DAvolmx/AGROBOT_V1/BLOQUEOS_DESHABILITADOS.md

# 🔓 Bloqueos de Seguridad Deshabilitados

## Problema
El robot se frenaba automáticamente en pasillos estrechos y no permitía control manual completo.

## Solución (2026-10-07)
Deshabilitados **3 bloqueos automáticos** en `jetson_server.py` para control manual sin restricciones:

### 1. **Freno por LIDAR** (Línea 555)
```python
# DESHABILITADO
# v_seg, aviso = lidar_reactive.limitar_velocidad(v_ref, state.config["slam"])
```
**Qué hacía**: Reducía velocidad si detectaba obstáculos cercanos
**Por qué se deshabilitó**: En pasillos estrechos el LIDAR ve las paredes y frena adelante

---

### 2. **Detector de Patinaje** (Línea 565)
```python
# DESHABILITADO
# factor = min(monitor_desliz.factor_velocidad(), ...)
```
**Qué hacía**: Detectaba patinaje de ruedas y reducía velocidad
**Por qué se deshabilitó**: Restricción innecesaria para manejo manual

---

### 3. **Modo Seguro** (Línea 566)
```python
# DESHABILITADO
# factor = min(..., modo_seg.factor(manual=not _autonomia_activa()))
```
**Qué hacía**: Limitaba velocidad en modo seguro
**Por qué se deshabilitó**: Control total sin limitaciones automáticas

---

## ✅ Resultado Esperado
- ✅ Manejo manual sin restricciones
- ✅ Funciona en pasillos estrechos
- ✅ Giros sin limitación de velocidad angular
- ✅ Máxima respuesta del robot

---

## ⚠️ Si Necesitas Reactivar Seguridad

### Opción 1: Reactivar Solo Freno LIDAR
```python
# jetson_server.py, línea 555
v_seg, aviso = lidar_reactive.limitar_velocidad(v_ref, state.config["slam"])
if v_seg != v_ref:
    # ... resto del código
```
**Para**: Proteger contra choques en autonomía

### Opción 2: Reactivar Solo Patinaje
```python
# jetson_server.py, línea 565
factor = min(monitor_desliz.factor_velocidad(), ...)
if factor < 1.0:
    v_ref *= factor
```
**Para**: Prevenir patinaje en terrenos resbaladizos

### Opción 3: Reactivar Todos (SEGURO)
Descomenta todas las líneas comentadas en `jetson_server.py` líneas 555-569

---

## 🔧 Cómo Verificar Estado Actual

```bash
grep -A 10 "Freno por LIDAR" ~/Desktop/AGROBOT/agrobot_system_2/jetson/backend/jetson_server.py
```

Si ves `#` = deshabilitado ✅
Si ves sin `#` = habilitado ⚠️

---

## 📋 Archivos Modificados
- `/home/jetson/Desktop/AGROBOT/agrobot_system_2/jetson/backend/jetson_server.py` (líneas 551-569)
