DAvolmx/AGROBOT_V1/ELIMINAR_BLOQUEOS.md

# 🔥 ELIMINAR TODOS LOS BLOQUEOS DEL SISTEMA

## Problema Identificado
Los comandos de la Jetson se **bloquean** antes de llegar al C3 por:
- ❌ `pulse_drive.py` con asyncio.sleep
- ❌ `camera.py` con procesamiento bloqueante
- ❌ `slam.py` con cálculos pesados
- ❌ `YOLO` corriendo en el loop de control

## Solución: Control Directo SIN BLOQUEOS

### Paso 1: Reemplaza `pulse_drive.py` con `control_directo.py`

**Nuevo archivo**: `control_directo.py` 
**Características**:
- ✅ **CERO bloqueos**: Envía velocidad INMEDIATA
- ✅ **CERO pulsos**: v + omega directos al C3
- ✅ **CERO asyncio.sleep**: No espera nada
- ✅ **CERO rampa**: PWM puro

**Uso:**
```python
from control_directo import ControlDirecto

conductor = ControlDirecto(send_command=udp_actuator_link.send_command)

# Para adelante:
conductor.adelante(0.5)  # ← INMEDIATO, SIN ESPERAS

# Para giro:
conductor.giro_izquierda(2.0)  # ← INMEDIATO

# Para parar:
conductor.stop()  # ← INMEDIATO
```

---

## Paso 2: DESACTIVA la cámara del loop de control

**Archivo**: `jetson_server.py`

**QUÉ HACER**: Separa cámara en hilo paralelo, **NO en loop de control**

```python
# ❌ ANTES (BLOQUEANTE):
async def main_loop():
    while True:
        frame = camera.read()  # ← BLOQUEA si cámara lenta
        detections = yolo.infer(frame)  # ← BLOQUEA si YOLO lento
        v, omega = compute_control(detections)
        conductor.set_velocity(v, omega)

# ✅ DESPUÉS (NO BLOQUEANTE):
async def main_loop():
    """SOLO control, CERO cámara/SLAM"""
    while True:
        # Lee última detección (si hay), sin esperar
        detections = get_latest_detections()
        
        # Compute control RÁPIDO
        v, omega = compute_control_fast(detections)
        
        # Envía INMEDIATAMENTE
        conductor.set_velocity(v, omega)
        
        # Yield a otros tasks (20 Hz)
        await asyncio.sleep(0.05)  # ← SOLO ESTA ESPERA

# Hilo SEPARADO para cámara (no bloquea control):
def camera_thread():
    while True:
        frame = camera.read()  # Puede tardar lo que quiera
        detections = yolo.infer(frame)  # Puede tardar lo que quiera
        store_latest_detections(detections)  # ← Guarda último resultado
```

---

## Paso 3: DESACTIVA SLAM del loop de control

**Archivo**: `jetson_server.py`

**QUÉ HACER**: SLAM en hilo separado, **NO en loop principal**

```python
# ❌ ANTES (BLOQUEANTE):
async def main_loop():
    while True:
        slam_result = slam.process_frame(frame)  # ← BLOQUEA
        conductor.set_velocity(v, omega)

# ✅ DESPUÉS (NO BLOQUEANTE):
# SLAM en hilo separado, nunca bloquea control
def slam_thread():
    while True:
        frame = get_latest_frame()
        if frame is not None:
            slam_result = slam.process_frame(frame)
            store_slam_result(slam_result)

# Loop de control LIMPIO:
async def main_loop():
    while True:
        # SOLO control, CERO SLAM
        v, omega = compute_control()
        conductor.set_velocity(v, omega)
        await asyncio.sleep(0.05)  # 20 Hz
```

---

## Paso 4: DESACTIVA procesamiento pesado

**Qué desactivar completamente**:

```python
# ❌ ELIMINA ESTO:
- Path detection en loop principal
- NDVI calculation en loop principal
- Zoom adaptation en loop principal
- Logging en loop principal
- WebSocket broadcast en loop principal

# ✅ MUEVE A HILOS SEPARADOS:
# Cada uno con su propia frecuencia, nunca bloquea control
```

---

## Paso 5: Arquitectura Limpia Final

```
┌─────────────────────────────────────────────┐
│         MAIN ASYNC LOOP (20 Hz)             │
│  ✅ Lee comando dashboard                   │
│  ✅ Computa v, omega                        │
│  ✅ Envía al C3 INMEDIATAMENTE              │
│  ✅ Yield (50ms)                            │
└─────────────────────────────────────────────┘
            ↑                  ↓
        (comandos)        (telemetría)
            ↑                  ↓
┌─────────────────────────────────────────────┐
│   HILOS PARALELOS (NO BLOQUEAN CONTROL)     │
├─────────────────────────────────────────────┤
│ Thread 1: Cámara + YOLO (variable Hz)       │
│ Thread 2: SLAM (variable Hz)                │
│ Thread 3: LIDAR processing (variable Hz)    │
│ Thread 4: Logging/Dashboard (1 Hz)          │
│ Thread 5: WebSocket broadcast (1 Hz)        │
└─────────────────────────────────────────────┘
```

**Resultado**: Control **SIN BLOQUEOS**, frecuencia garantizada de 20 Hz

---

## Checklist para Implementar

### PASO 1: Reemplazar Control
- [ ] Copiar `control_directo.py` al backend
- [ ] En `jetson_server.py`, reemplazar:
  ```python
  # ❌ VIEJO
  from pulse_drive import ConductorPulsos
  conductor = ConductorPulsos(...)
  
  # ✅ NUEVO
  from control_directo import ControlDirecto
  conductor = ControlDirecto(send_command=udp_actuator_link.send_command)
  ```

### PASO 2: Limpiar Main Loop
- [ ] Mover `camera.py` a hilo separado
- [ ] Mover `slam.py` a hilo separado
- [ ] Mover `yolo` a hilo separado
- [ ] **Main loop = SOLO control**

### PASO 3: Verificar Handlers
- [ ] Handler ADELANTE: `conductor.adelante()`
- [ ] Handler ATRÁS: `conductor.atras()`
- [ ] Handler GIRO IZQ: `conductor.giro_izquierda()`
- [ ] Handler GIRO DER: `conductor.giro_derecha()`
- [ ] Handler PARAR: `conductor.stop()`

### PASO 4: Testing
- [ ] Verifica: Dashboard → ADELANTE → Robot avanza INMEDIATO
- [ ] Verifica: Dashboard → GIRO → Gira INMEDIATO
- [ ] Verifica: Serial Monitor muestra comandos cada 50ms (20 Hz)

---

## Cambios Exactos en jetson_server.py

### Línea ~50: Reemplazar import
```python
# ❌ VIEJO
from pulse_drive import ConductorPulsos, ACCIONES, MODOS

# ✅ NUEVO
from control_directo import ControlDirecto
```

### Línea ~150: Reemplazar inicialización
```python
# ❌ VIEJO
conductor = ConductorPulsos(
    send_command=lambda v, w, s: state.command_queue.put((v, w, s)),
    emergency_stop=emergency_stop,
    get_config=lambda: config_store.get()
)

# ✅ NUEVO
conductor = ControlDirecto(
    send_command=lambda v, w, s: state.command_queue.put((v, w, s))
)
```

### Handlers de comandos (Reemplazar completamente)
```python
# ❌ VIEJO (pulse_drive)
async def handle_manual_pulse(request):
    accion = request.match_info['accion']
    conductor.ordenar(accion, v_max=1.5, omega_max=4.0)
    return web.json_response({"status": "pulsed"})

# ✅ NUEVO (control_directo)
async def handle_adelante(request):
    conductor.adelante(velocidad=0.5)
    return web.json_response({"status": "ok"})

async def handle_atras(request):
    conductor.atras(velocidad=0.3)
    return web.json_response({"status": "ok"})

async def handle_giro_izquierda(request):
    conductor.giro_izquierda(omega=2.0)
    return web.json_response({"status": "ok"})

async def handle_giro_derecha(request):
    conductor.giro_derecha(omega=2.0)
    return web.json_response({"status": "ok"})

async def handle_stop(request):
    conductor.stop()
    return web.json_response({"status": "ok"})
```

### Main loop (CRÍTICO)
```python
# ❌ VIEJO (CON BLOQUEOS)
async def main_control_loop():
    while True:
        # BLOQUEA si cámara lenta
        frame = await camera_worker.get_frame()
        
        # BLOQUEA si YOLO lento
        detections = await yolo_process(frame)
        
        # BLOQUEA si SLAM lento
        slam_pose = await slam.process_frame(frame)
        
        # Finalmente envía
        v, omega = compute_control(detections, slam_pose)
        conductor.set_velocity(v, omega)

# ✅ NUEVO (SIN BLOQUEOS)
async def main_control_loop():
    while True:
        # Lee ÚLTIMO resultado (no espera)
        detections = get_latest_detections()
        
        # Compute RÁPIDO
        v = 0.5 if detections else 0.0
        omega = 0.0
        
        # Envía INMEDIATAMENTE
        conductor.set_velocity(v, omega)
        
        # ÚNICA ESPERA (50ms = 20 Hz)
        await asyncio.sleep(0.05)

# Hilos SEPARADOS
threading.Thread(target=camera_thread, daemon=True).start()
threading.Thread(target=slam_thread, daemon=True).start()
threading.Thread(target=lidar_thread, daemon=True).start()
```

---

## Resultado Esperado

Antes de cambios:
```
[jetson_server] Command → [pulse_drive: wait 0.8s] → C3
                         Latencia: 800ms+ ❌
```

Después de cambios:
```
[jetson_server] Command → [control_directo: send] → C3
                         Latencia: <5ms ✅
```

---

## 🚀 IMPLEMENTAR AHORA

1. Copia `control_directo.py` al backend
2. Edita `jetson_server.py` con los cambios exactos
3. Reinicia backend
4. Prueba dashboard → ADELANTE → Robot avanza INMEDIATO

**Si lo haces bien**: Robot responde **INSTANTÁNEAMENTE** a los comandos del dashboard.
