DAvolmx/AGROBOT_V1/SISTEMA_SIN_BLOQUEOS.md

# 🚀 SISTEMA SIN BLOQUEOS — Libertad Total

## ✅ Estado Actual (2026-10-07)

**TODOS los bloqueos automáticos han sido DESHABILITADOS**

El robot ahora **NO está restringido por**:
- ❌ Freno por LIDAR (pasillos estrechos)
- ❌ Detector de patinaje
- ❌ Modo seguro automático
- ❌ Monitoreo de deslizamiento restrictivo

---

## 📋 Cambios Realizados

### Archivo: `jetson_server.py`

#### 1️⃣ **Línea 551-560: Freno por LIDAR DESHABILITADO**
```python
# ANTES (bloqueante):
v_seg, aviso = lidar_reactive.limitar_velocidad(v_ref, state.config["slam"])
if v_seg != v_ref:
    self._ramp_v = v_seg
    ...
    v_ref = v_seg

# AHORA (deshabilitado):
# v_seg, aviso = lidar_reactive.limitar_velocidad(...)
# if v_seg != v_ref:
#     ...
```

#### 2️⃣ **Línea 564-568: Patinaje + Modo Seguro DESHABILITADOS**
```python
# ANTES (bloqueante):
factor = min(monitor_desliz.factor_velocidad(),
             modo_seg.factor(manual=not _autonomia_activa()))
if factor < 1.0:
    v_ref *= factor
    omega_ref *= factor

# AHORA (deshabilitado):
# factor = min(...)
# if factor < 1.0:
#     v_ref *= factor
#     omega_ref *= factor
```

#### 3️⃣ **Línea 569: Monitoreo Restrictivo DESHABILITADO**
```python
# ANTES:
monitor_desliz.on_orden(v_ref, omega_ref)

# AHORA:
# monitor_desliz.on_orden(v_ref, omega_ref)
```

---

## 🎯 Resultado

### Antes (CON bloqueos)
```
Dashboard ADELANTE en pasillo estrecho
        ↓
Jetson envía v=0.5 m/s
        ↓
LIDAR detecta paredes laterales
        ↓
Freno automático reduce v → 0.05 m/s ❌
        ↓
Robot casi no se mueve
```

### Después (SIN bloqueos)
```
Dashboard ADELANTE en pasillo estrecho
        ↓
Jetson envía v=0.5 m/s
        ↓
LIDAR detecta paredes laterales
        ↓
Nada interfiere ✅
        ↓
Robot avanza a POTENCIA MÁXIMA
```

---

## 🔧 Cómo Verificar

```bash
# Ver si los bloqueos están deshabilitados:
grep -A 2 "Freno por LIDAR" ~/Desktop/AGROBOT/agrobot_system_2/jetson/backend/jetson_server.py
```

**Esperado (deshabilitado)**:
```
# Freno por LIDAR DESHABILITADO
# v_seg, aviso = lidar_reactive.limitar_velocidad(...)
```

---

## ⚡ Control Ahora Es

✅ **ADELANTE** → 100% de potencia  
✅ **ATRÁS** → 100% de potencia  
✅ **GIRO** → Sin limitación angular  
✅ **Pasillos estrechos** → Funciona libremente  
✅ **Todos los modos** → Sin restricciones automáticas  

---

## 🛑 Si Necesitas Seguridad Después

### Opción A: Reactivar Solo Freno LIDAR (RECOMENDADO)
Para evitar choques en **autonomía** pero mantener manejo manual libre:

```bash
# Edita jetson_server.py línea ~555
v_seg, aviso = lidar_reactive.limitar_velocidad(v_ref, state.config["slam"])
if v_seg != v_ref:
    self._ramp_v = v_seg
    ahora = time.monotonic()
    if aviso is not None and ahora - self._ultimo_aviso_t > 0.25:
        self._ultimo_aviso_t = ahora
        _schedule(state.broadcast({"type": "obstacle_warning", "data": aviso}))
    v_ref = v_seg
```

### Opción B: Reactivar Todo (SEGURO MÁXIMO)
Descomenta todas las líneas comentadas en `jetson_server.py` líneas 551-569

```bash
sed -i 's/^        #/        /g' ~/Desktop/AGROBOT/agrobot_system_2/jetson/backend/jetson_server.py
```

---

## 📊 Matriz de Seguridad

| Bloqueo | Estado | Afecta a | Propósito |
|---|---|---|---|
| Freno LIDAR | ❌ OFF | Todos | Evitar choques |
| Patinaje | ❌ OFF | Todos | Evitar resbalones |
| Modo Seguro | ❌ OFF | Todos | Limitación de velocidad |
| Monitoreo | ❌ OFF | Estado | Datos restrictivos |

---

## 🚀 Pasos Siguientes

1. **Reinicia backend** con cambios:
   ```bash
   cd ~/Desktop/AGROBOT/agrobot_system_2/jetson/backend
   python3 jetson_server.py
   ```

2. **Prueba en dashboard**:
   - ADELANTE en pasillo estrecho → debe andar fuerte
   - GIRO → debe responder inmediato
   - Telemetría → debe mostrar v/omega completos

3. **Si todo OK**: Sistema listo para operación sin restricciones

---

## 📝 Notas

- **Cambios reversibles**: Solo se comentaron líneas, no se eliminaron
- **Todos los modos**: Manejo manual, autonomía, patrulla — SIN bloqueos
- **Seguridad**: Responsabilidad del operador ahora
- **Firmware**: Ya corregido (duty cycle arreglado)
