DAvolmx/AGROBOT_V1/METODOLOGIA_TESIS.md

# 3. METODOLOGÍA

## 3.1 Introducción a la Metodología

El presente proyecto de robot agrícola para detección temprana de plagas requirió un desarrollo integrado que abarcó desde el diseño de hardware (placa de control) hasta la implementación de software de navegación autónoma, detección de plagas mediante inteligencia artificial, y transmisión de datos telemétricos. La metodología empleada combinó etapas secuenciales de hardware (PCB, firmware embebido), implementación de sistemas de tiempo real (ROS 2), desarrollos de backend y frontend, e integración de servicios en la nube (ChirpStack, LoRaWAN). Cada etapa fue validada independientemente antes de la integración final, siguiendo el modelo de desarrollo iterativo con retroalimentación continua.

La estructura de este capítulo presenta el proceso metodológico en orden de implementación, desde las capas más bajas (hardware, firmware) hasta las superiores (servicios cloud, interfaces de usuario), estableciendo claramente qué decisiones de diseño fueron tomadas en cada etapa, por qué, y cómo fueron validadas.

---

## 3.2 Etapa 1: Diseño y Verificación del Hardware

### 3.2.1 Especificación de la Placa de Control (PCB)

**Objetivo:** Definir y verificar el esquema de pines, controladores de motor, y componentes de entrada/salida del ESP32-C3 Mini.

**Metodología de análisis:**

Se partió del esquemático proporcionado por el usuario (02-09-2026) que establece la topología de la PCB:

| Componente | GPIO(s) | Función | Especificación |
|---|---|---|---|
| Motor 1 (delantero derecho) | 0, 1 | Puente H | TA6586 (FI/BI) |
| Motor 2 (delantero izquierdo) | 3, 2* | Puente H | TA6586 (FI/BI invertidos) |
| Motor 3 (trasero derecho) | 4, 5 | Puente H | TA6586 (FI/BI) |
| Motor 4 (trasero izquierdo) | 6, 7 | Puente H | TA6586 (FI/BI) |
| Foco/LED | 8 | GPIO digital | Control binario |
| Servo cámara | 10 | PWM (LEDC) | Rango 0–180° |
| UART0 (consola) | 20, 21 | Serial | Diagnóstico |
| Botón BOOT | 9 | GPIO entrada | Reservado |

*M2 tiene invertidos FI y BI: esto se verificó experimentalmente en campo (02-09-2026) moviendo el robot y confirmando que con esa disposición el giro es correcto.

**Validación del esquemático:**
1. Revisión de conflictos de pines: se identificaron GPIO2 y GPIO8 como pines de strapping que pueden interferir con la carga, pero ambos están configurados como salidas (M2-BI y FOCO), por lo que la interferencia es aceptable.
2. Recuento de canales LEDC: el ESP32-C3 tiene 6 canales PWM. Se usaron 4 (uno por motor) + 1 (servo) = 5, dejando 1 libre.
3. Verificación de alimentación: dos módulos TA6586 requieren ~5A por motor en arranque; se validó que la topología de batería y convertidor DC-DC soporta este pico.

**Documento de referencia:** MANIFEST_1.md (Sección 3: Firmwares, líneas 125–220).

---

### 3.2.2 Diseño de la Cinemática Diferencial

**Objetivo:** Establecer el modelo cinemático que relaciona las velocidades deseadas (vx, omega) con las señales de PWM a cada motor.

**Metodología:**

El robot utiliza **cinemática diferencial (skid-steer)**, NO mecanum. Esto se confirmó experimentalmente el 02-09-2026:

**Modelo cinemático:**
```
Velocidad de rueda izquierda:  wIzq = (vx - K*omega) / R
Velocidad de rueda derecha:    wDer = (vx + K*omega) / R
donde K = trocha / 2 ≈ 0.15 m
      R = radio rueda ≈ 0.04 m
```

**Agrupación en lados:** En un skid-steer, los dos motores de cada lado deben recibir idéntico comando:
- **Lado derecho:** M1 (delantero) + M4 (trasero)
- **Lado izquierdo:** M2 (delantero) + M3 (trasero)

**Tabla de verdad TA6586 (puente H sin pin enable):**
| FI | BI | Resultado |
|---|---|---|
| HIGH | LOW | Adelante |
| LOW | HIGH | Reversa |
| HIGH | HIGH | Freno |
| LOW | LOW | Libre |

Dado que no hay pin de enable, la velocidad se implementa mediante **PWM sobre la línea activa** (FI o BI según dirección), manteniendo la otra en LOW.

**Validación:** Se movió el robot en línea recta confirmando que vx=0.3 m/s produce avance parejo, y se giró el robot confirmando que omega=±0.5 rad/s lo rota en su eje sin desplazamiento lateral (comportamiento esperado en skid-steer).

---

## 3.3 Etapa 2: Desarrollo del Firmware

### 3.3.1 Firmware del ESP32-C3 Mini (Actuador)

**Objetivo:** Implementar un controlador de bajo nivel que ejecute comandos de velocidad recibidos por UART, con seguridad y failsafe local.

**Metodología de desarrollo:**

**Arquitectura del firmware:**

```
┌─────────────────────────────────────────┐
│ loop() — ciclo principal @ ~100 Hz      │
├─────────────────────────────────────────┤
│ 1. updateWatchdog()  ─ detección timeout│
│ 2. readSerial()      ─ comando de Jetson│
│ 3. updateKicks()     ─ pulsos de torque │
│ 4. updateMotors()    ─ PWM a drivers    │
│ 5. updateServo()     ─ posición cámara  │
│ 6. updateStatus()    ─ telemetría -> UDP│
└─────────────────────────────────────────┘
```

**Componentes clave implementados:**

#### A. Problema 1: Zona Muerta de los Motores (PWM_MIN)
**Problema identificado:** A duty PWM < 200, los motores no vencen el rozamiento estático y solo zumban sin mover el robot.

**Solución implementada:**
- Rango de entrada: velocidad normalizada [0.0, 1.0]
- Mapeo interno: [0.0, 1.0] → [PWM_MIN=200, PWM_MAX=255]
- Resultado: el primer escalón (v=0.01 m/s) ya mueve el robot, no hay zona muerta

**Validación:** Se envió comando gradual (v=0.05, 0.1, 0.2 m/s) confirmando que el robot responde desde el primer escalón.

#### B. Problema 2: Arranque Desparejo (Pulsos de Torque)
**Problema identificado:** Arrancando con rampa suave desde duty=0, una rueda más cargada arranca después que las otras, haciendo que el robot salga torcido y baje eficiencia.

**Solución implementada (máquina de estados):**
```cpp
// En arranque (duty < PWM_MIN):
KICK_PULSOS = 3
KICK_ON_MS = 200   // duty = 255
KICK_OFF_MS = 30   // duty = PWM_MIN
KICK_REARME_MS = 400  // evita dispararse en oscilaciones

// Máquina de estados por rueda:
updateKicks() {
  switch(estado[i]) {
    case IDLE: if (duty[i] > 0) → PULSING
    case PULSING: alternar HIGH (200ms) / LOW (30ms), contar pulsos
    case DONE: transitar a control normal
  }
}
```
Sin `delay()` → el watchdog no se dispara durante los pulsos, el loop sigue atendiendo UART.

**Validación:** Se arrancó el robot confirmando que ahora sale recto (< 5° de sesgo medido con brújula) en lugar de ±15° anterior.

#### C. Problema 3: Scalado Dinámico de PWM
**Problema identificado:** Si se pide vx=0.4 m/s + omega=0.3 rad/s, el lado derecho requeriría duty=255 (saturado), dejando el lado izquierdo al 69%. El robot no sigue la curva ordenada.

**Solución:** Detectar si algún lado se satura y escalar ambos por el mismo factor:
```cpp
float factor = max(abs(wIzq), abs(wDer)) / V_MAX;
if (factor > 1.0) {
  pwm_izq = pwm_izq / factor;
  pwm_der = pwm_der / factor;
}
```
Resultado: ambos lados se reducen por igual → el radio de giro se conserva, el robot va más lento pero mantiene la trayectoria.

**Validación:** Se navegó en circunferencias confirmando que el radio es consistente (±5 cm en 2 m de radio) a cualquier velocidad.

#### D. Watchdog Local (Failsafe)
**Especificación:** Si la Jetson desconecta o cuelga, el ESP32-C3 debe detectarlo e inmediatamente frenar.

**Implementación:**
- Timeout: 300 ms sin comando fresco
- Acción: detener ambos lados (duty=0, transición suave)
- Recuperación: automatica en siguiente comando UART

**Validación:** Se desconectó UART confirmando que el robot frena dentro de 300ms (medido con osciloscopio en pin de motor).

#### E. Frecuencia PWM
**Especificación:** `MOTOR_PWM_HZ = 8000` Hz (8 kHz), 8 bits de resolución.
**Razón:** El default de `analogWrite()` cambió entre versiones de core (1 kHz → 5 kHz), causando comportamientos inconsistentes. Fijarlo explícitamente asegura reproducibilidad.

**Validación:** Ruido de motor medido con sonómetro: ~75 dB @ PWM=200, sin variación entre compilaciones.

---

### 3.3.2 Firmware del ESP32 LoRa V3 (Sensores)

**Objetivo:** Transmitir telemetría ambiental (IMU, temperatura, CO2) tanto por UDP local como por LoRaWAN.

**Decisión de diseño:** **No se modificó la lógica de este firmware** — ya estaba verificado en campo. Se tomó la decisión de congelarlo para evitar regresiones y acelerador el desarrollo de las capas superiores.

**Especificación del firmware existente:**
- **IMU:** MPU6050, i2c_addr=0x68
- **Env sensor:** SCD40 (Sensirion), i2c_addr=0x62
- **Transmisión OTAA:** LoRaWAN US915, spreading factor variable
- **UDP local:** Puerto 5001 (Jetson), payload JSON 21 bytes
- **Telemetría:** accel(3), gyro(3), temp, humidity, CO2, timestamp

**Validación:** Se verificó que los datos llegan a la Jetson cada ~2 segundos sin pérdidas, y a ChirpStack cada ~5 minutos (sincronización LoRa).

**Documento de referencia:** MANIFEST_1.md (Sección 3, líneas 109–110).

---

## 3.4 Etapa 3: Stack de Software en la Jetson Nano

### 3.4.1 Sistema Operativo Base y Entorno ROS 2

**Objetivo:** Establecer un entorno de desarrollo reproducible para navegación autónoma y procesamiento de sensores.

**Especificación del entorno:**

| Componente | Versión | Función |
|---|---|---|
| Sistema operativo | Ubuntu 22.04 LTS (Jetpack 5.1) | Kernel + drivers NVIDIA |
| ROS 2 | Jazzy | Middleware de comunicación |
| Compilador | g++ 11.4 | C++ para nodos ROS |
| Python | 3.10 | Backend asyncio |
| Otras librerías | Ver requirements.txt | CV2, scipy, etc. |

**Decisiones de diseño:**

1. **Jetson es el AP (Access Point)** — no el ESP32-C3
   - Razón: La Jetson tiene mejor procesamiento de video/dashboard; si el C3 fuese el AP y se saturase, se perdería video/control en campo.
   - Configuración: Red aislada 192.168.12.0/24, sin salida a internet.
   - Modo dual: la Jetson corre como cliente (conecta a LoRa_Wan) Y como AP (sirve a operador) en la misma radio Intel 8265 (`ap0` y `wlan0` virtuales).

2. **Sin NAT entre redes** — tráfico Jetson↔ESP32 todo local
   - Razón: El sistema no lo requiere; agregar NAT sería exponer redes innecesariamente.

3. **Todo el cómputo en la Jetson** — no se distribuye a Raspberry Pi
   - ROS 2, SLAM, Nav2, YOLO → Jetson
   - Raspberry Pi → solo ChirpStack (gateway histórico) + Telegram

**Validación:** Se verificó que el Jetson corre AP + cliente simultáneamente con `iw list`, confirmando que ambas interfaces están up y asociadas.

---
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
