DAvolmx/AGROBOT_V1/agrobot_system_2/docs/analisis_20261026/fotos_planta_1.jpg

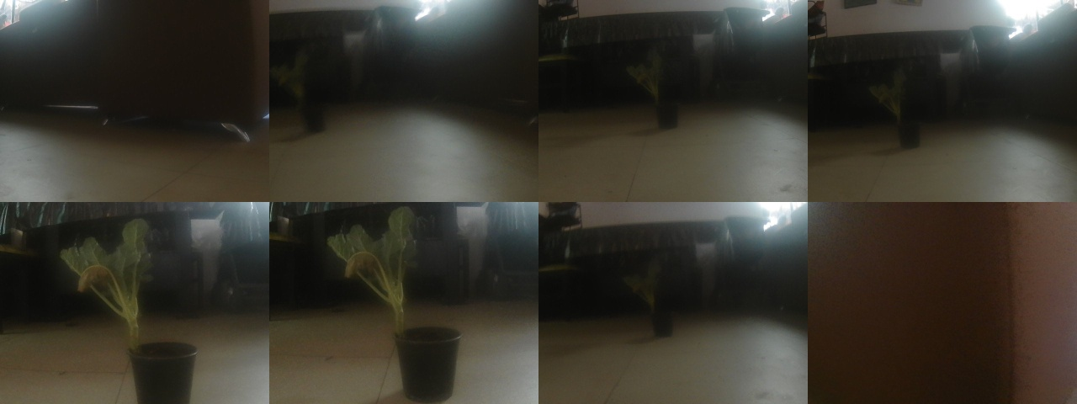
agrobot_system_2/docs/analisis_20261026/fotos_planta_1.jpg
