DAvolmx/AGROBOT_V1/agrobot_system_2/docs/ANEXOS_TESIS_20261108/figuras/anot_propias_automaticas.jpg

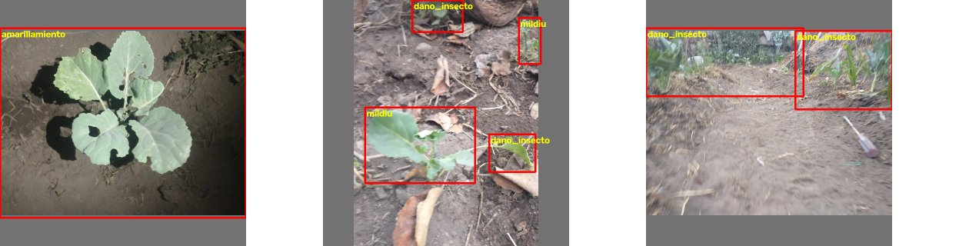
agrobot_system_2/docs/ANEXOS_TESIS_20261108/figuras/anot_propias_automaticas.jpg
