DAvolmx/AGROBOT_V1/agrobot_system_2/docs/ANEXOS_TESIS_20261108/figuras/chasis_cad_1.png

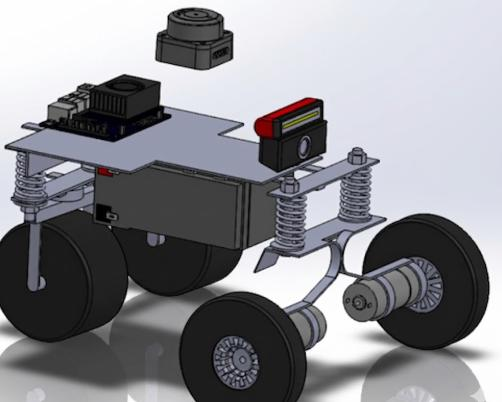
agrobot_system_2/docs/ANEXOS_TESIS_20261108/figuras/chasis_cad_1.png
