DAvolmx/AGROBOT_V1/agrobot_system_2/docs/ANEXOS_TESIS_20261112/fig/col_mosca.jpg

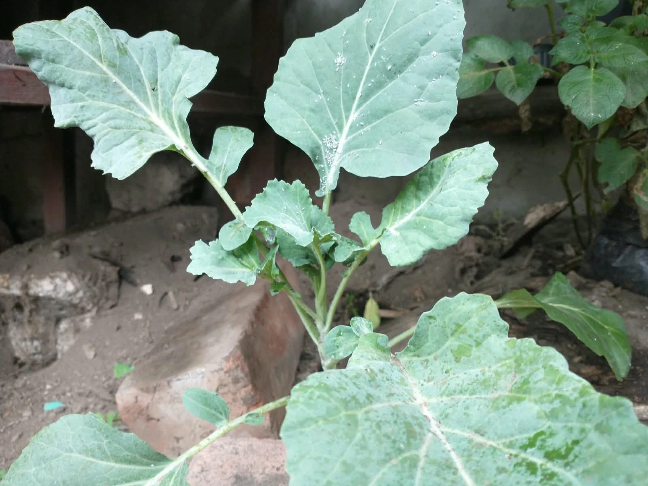
agrobot_system_2/docs/ANEXOS_TESIS_20261112/fig/col_mosca.jpg
