DAvolmx/AGROBOT_V1/agrobot_system_2/docs/calib_caja16.png

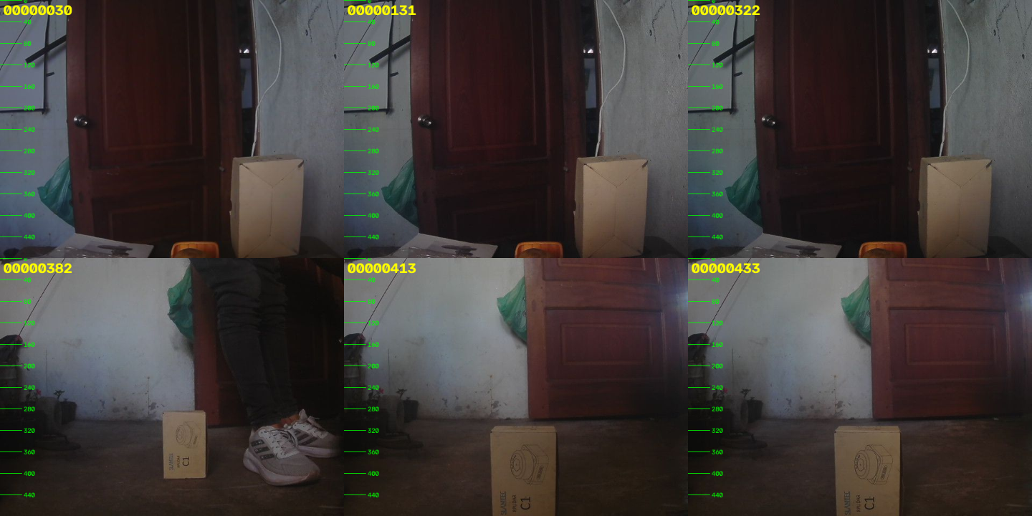
agrobot_system_2/docs/calib_caja16.png
