DAvolmx/AGROBOT_V1/agrobot_system_2/docs/calib_caja16_zoom.png

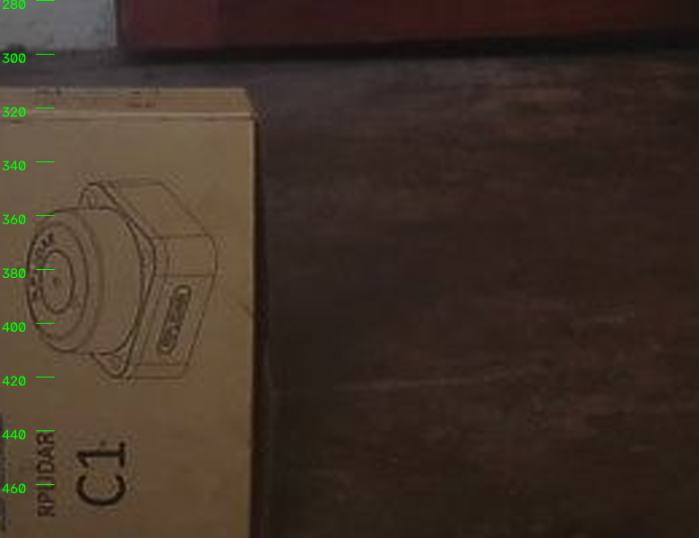
agrobot_system_2/docs/calib_caja16_zoom.png
