DAvolmx/AGROBOT_V1/agrobot_system_2/docs/calib_caja80_tope.png

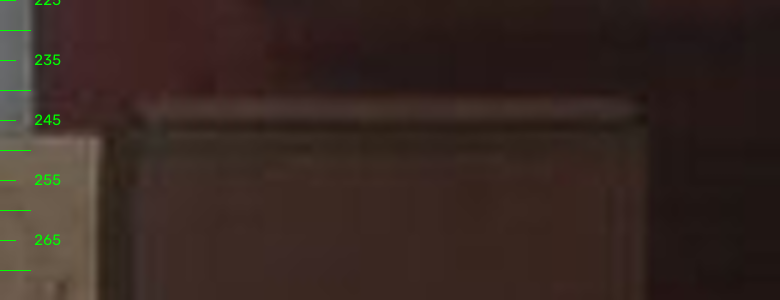
agrobot_system_2/docs/calib_caja80_tope.png
