DAvolmx/AGROBOT_V1/agrobot_system_2/docs/calib_sesion_1.png

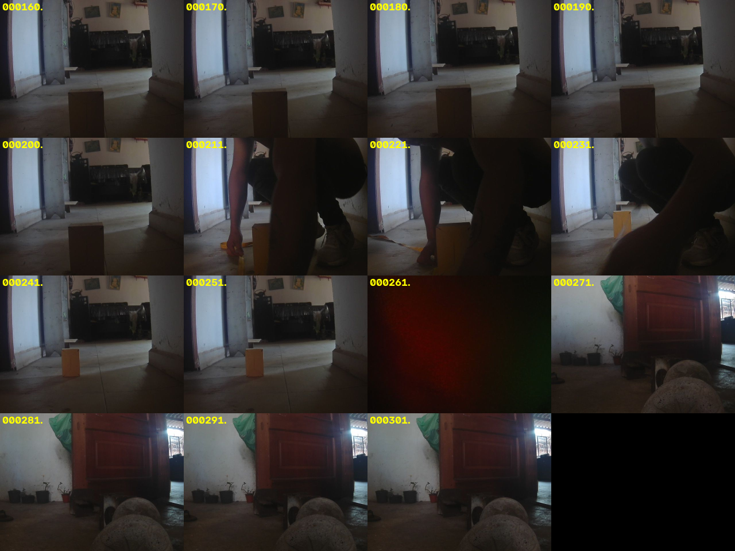
agrobot_system_2/docs/calib_sesion_1.png
