DAvolmx/AGROBOT_V1/agrobot_system_2/docs/capturas_interior_20261015/01_rampa_firmware.png

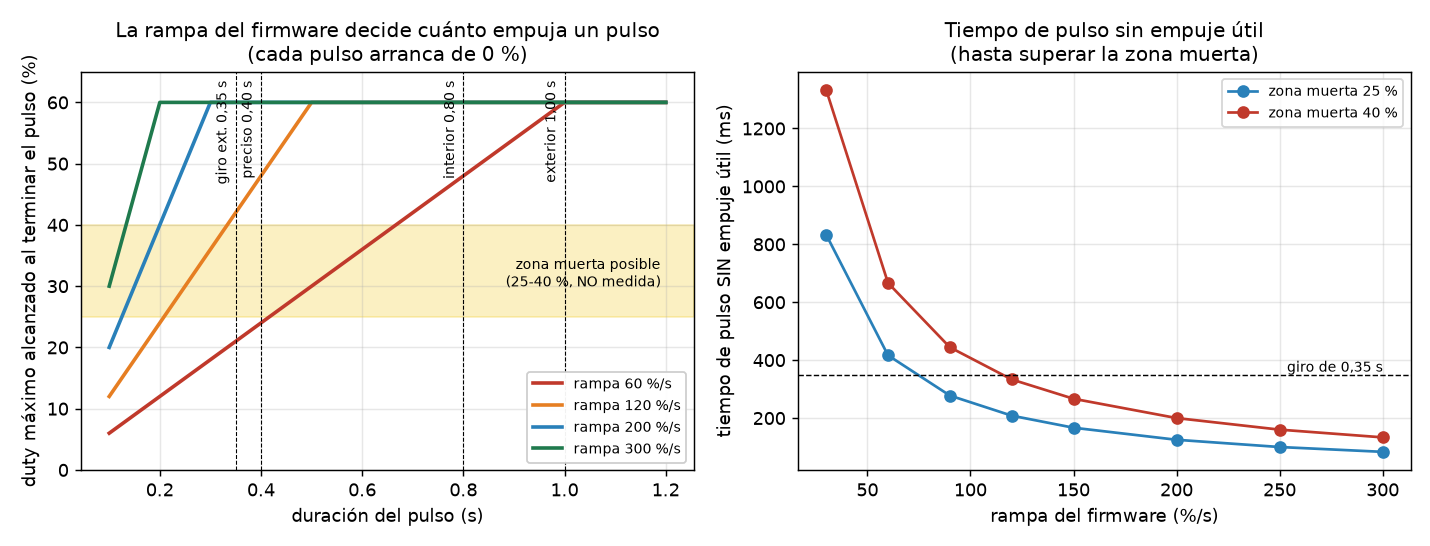
agrobot_system_2/docs/capturas_interior_20261015/01_rampa_firmware.png
