DAvolmx/AGROBOT_V1/agrobot_system_2/docs/capturas_percepcion_20261015/09_fotos_reales_pared.png

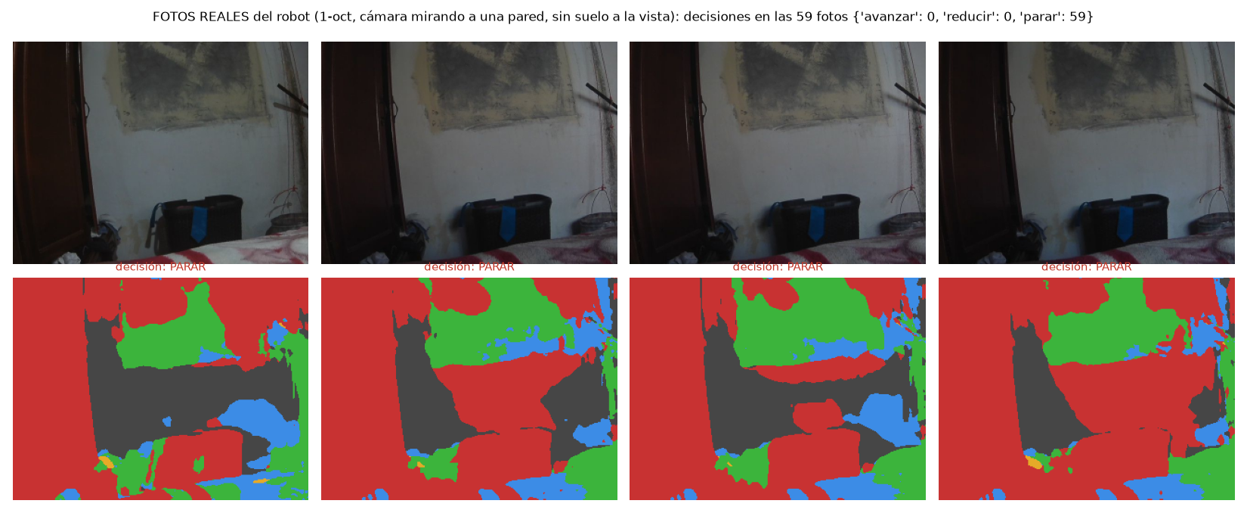
agrobot_system_2/docs/capturas_percepcion_20261015/09_fotos_reales_pared.png
