DAvolmx/AGROBOT_V1/agrobot_system_2/docs/capturas_plagas_20261015/col_2.jpg

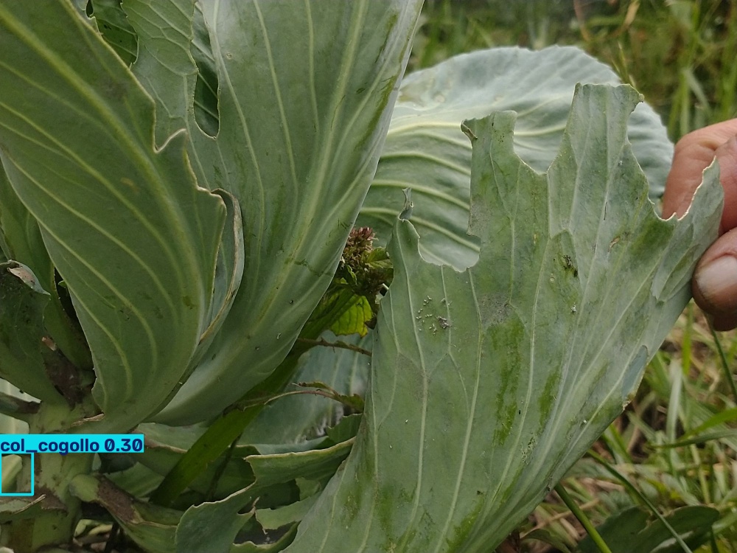
agrobot_system_2/docs/capturas_plagas_20261015/col_2.jpg
