DAvolmx/AGROBOT_V1/agrobot_system_2/docs/comparacion_real_sim/real_robot_2.jpg

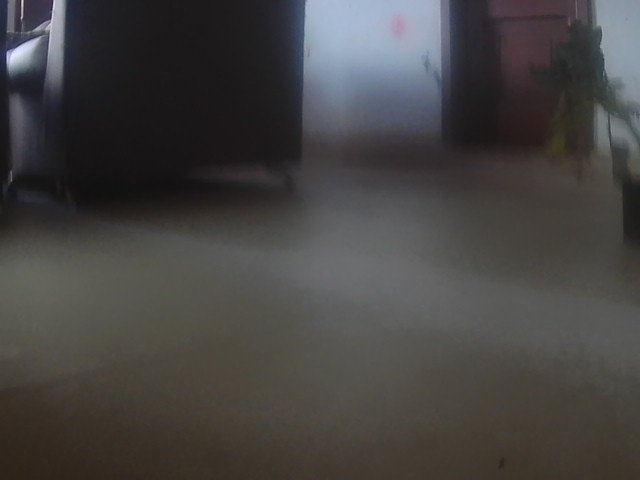
agrobot_system_2/docs/comparacion_real_sim/real_robot_2.jpg
