DAvolmx/AGROBOT_V1/agrobot_system_2/docs/comparacion_real_sim/real_video_0_45_Pro.jpg

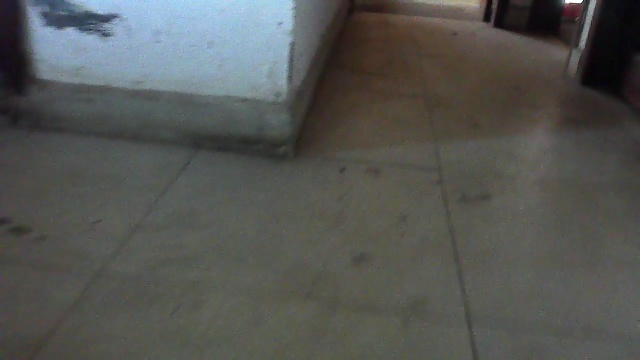
agrobot_system_2/docs/comparacion_real_sim/real_video_0_45_Pro.jpg
