DAvolmx/AGROBOT_V1/agrobot_system_2/docs/comparacion_real_sim/real_video_8_09_Pro.jpg

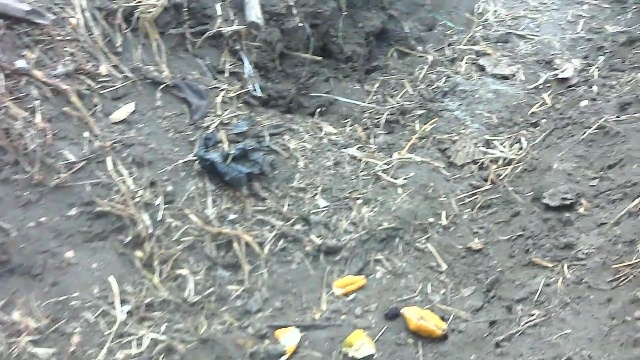
agrobot_system_2/docs/comparacion_real_sim/real_video_8_09_Pro.jpg
