DAvolmx/AGROBOT_V1/agrobot_system_2/docs/comparacion_real_sim/sim_interior_laberinto_serpiente.png

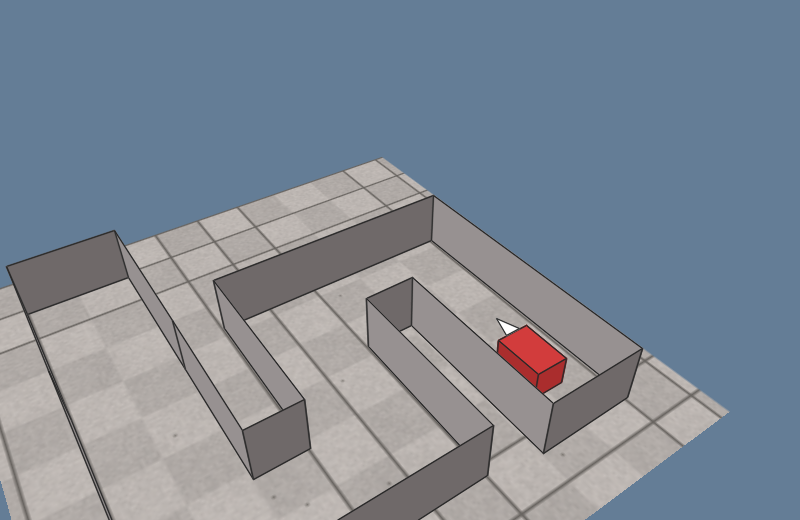
agrobot_system_2/docs/comparacion_real_sim/sim_interior_laberinto_serpiente.png
