DAvolmx/AGROBOT_V1/agrobot_system_2/docs/digitalizacion/deriva_1pct/pasillo_S_s0/plano.png

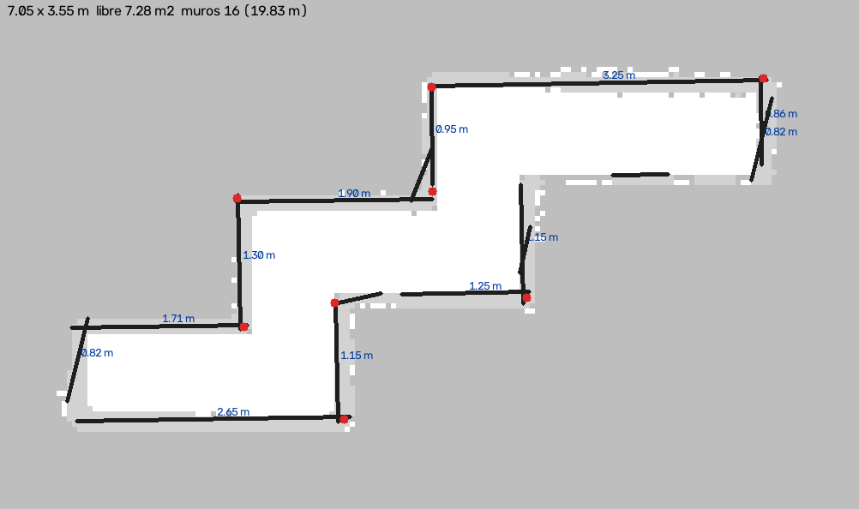
agrobot_system_2/docs/digitalizacion/deriva_1pct/pasillo_S_s0/plano.png
