DAvolmx/AGROBOT_V1/agrobot_system_2/docs/digitalizacion/deriva_1pct/sala_con_puerta_s0/limpio.png

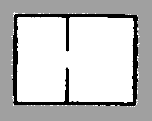
agrobot_system_2/docs/digitalizacion/deriva_1pct/sala_con_puerta_s0/limpio.png
