DAvolmx/AGROBOT_V1/agrobot_system_2/docs/digitalizacion/deriva_3pct/laberinto_serpiente_s0/plano.png

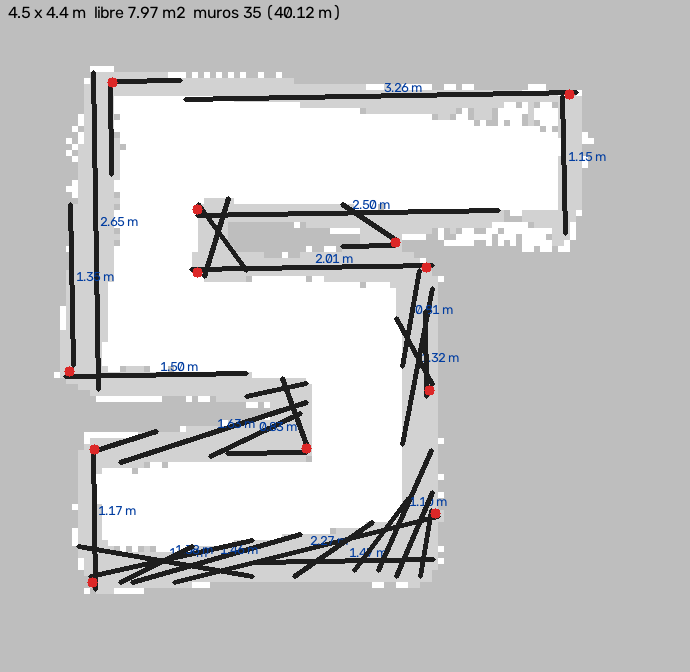
agrobot_system_2/docs/digitalizacion/deriva_3pct/laberinto_serpiente_s0/plano.png
