DAvolmx/AGROBOT_V1/agrobot_system_2/docs/digitalizacion/deriva_3pct/laboratorio_bancos_s0/limpio.png

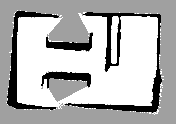
agrobot_system_2/docs/digitalizacion/deriva_3pct/laboratorio_bancos_s0/limpio.png
