DAvolmx/AGROBOT_V1/agrobot_system_2/docs/digitalizacion/deriva_3pct/laboratorio_mesas_sillas_s0/plano.png

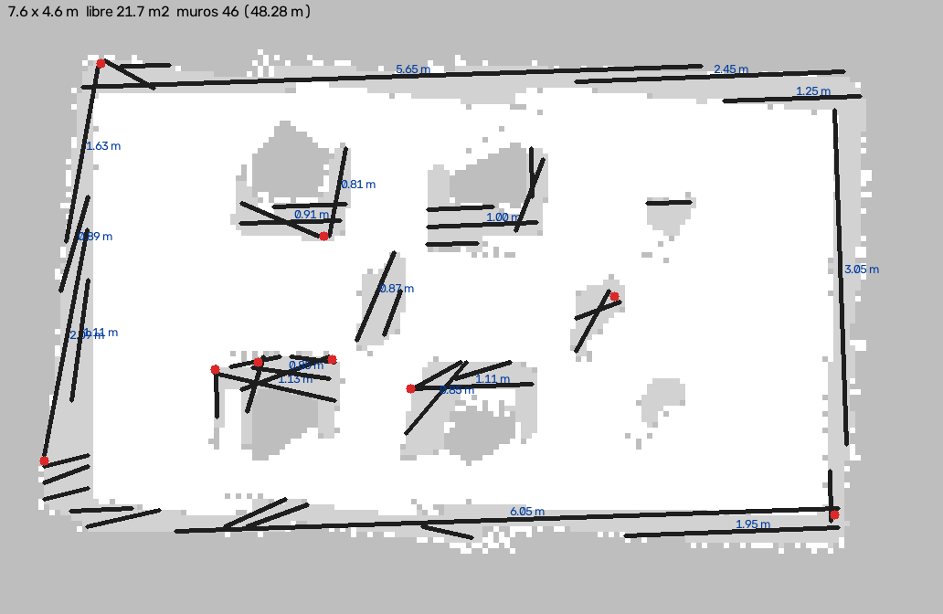
agrobot_system_2/docs/digitalizacion/deriva_3pct/laboratorio_mesas_sillas_s0/plano.png
