DAvolmx/AGROBOT_V1/agrobot_system_2/docs/digitalizacion/plano_sim_laboratorio.png

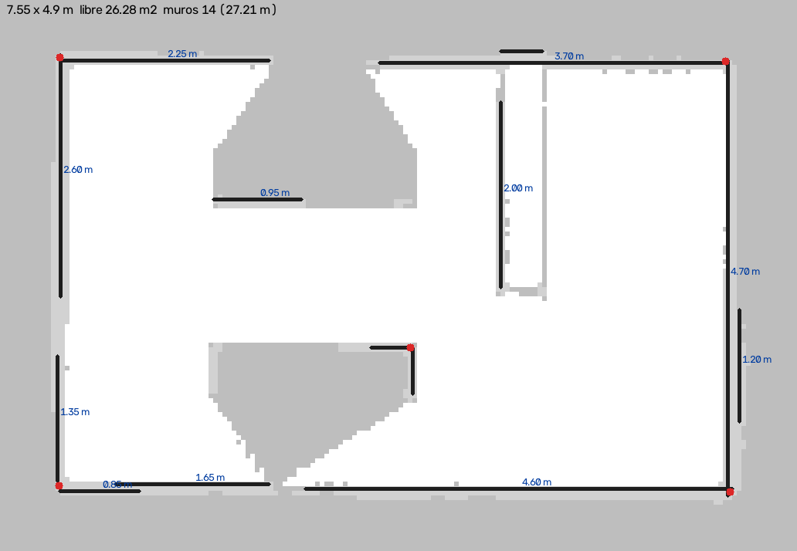
agrobot_system_2/docs/digitalizacion/plano_sim_laboratorio.png
