DAvolmx/AGROBOT_V1/agrobot_system_2/docs/digitalizacion/sin_deriva/laberinto_estrecho_s0/plano.png

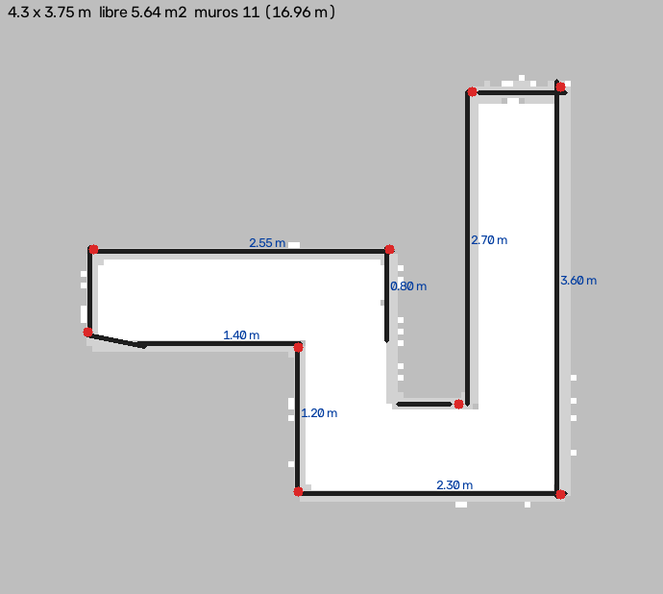
agrobot_system_2/docs/digitalizacion/sin_deriva/laberinto_estrecho_s0/plano.png
