DAvolmx/AGROBOT_V1/agrobot_system_2/docs/digitalizacion/sin_deriva/pasillo_L_s0/plano.png

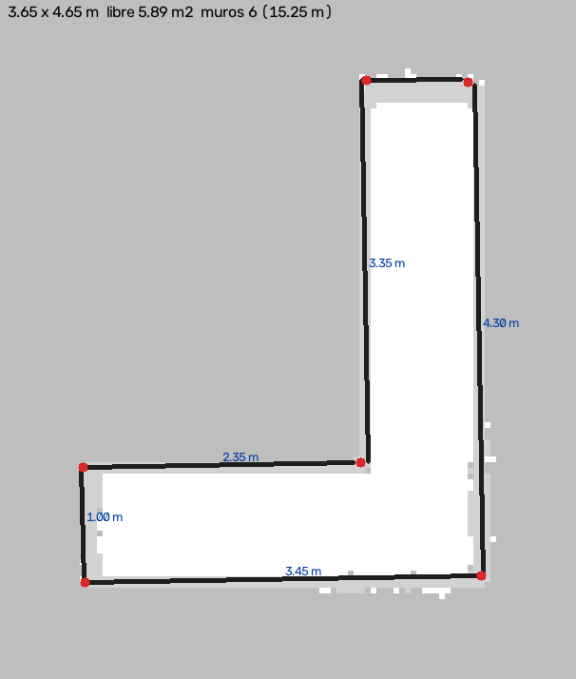
agrobot_system_2/docs/digitalizacion/sin_deriva/pasillo_L_s0/plano.png
