DAvolmx/AGROBOT_V1/agrobot_system_2/docs/digitalizacion/sin_deriva/puerta_descentrada_s0/limpio.png

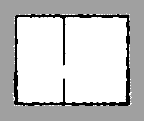
agrobot_system_2/docs/digitalizacion/sin_deriva/puerta_descentrada_s0/limpio.png
