DAvolmx/AGROBOT_V1/agrobot_system_2/docs/estrategias/camara_lidar2/estrategias.png

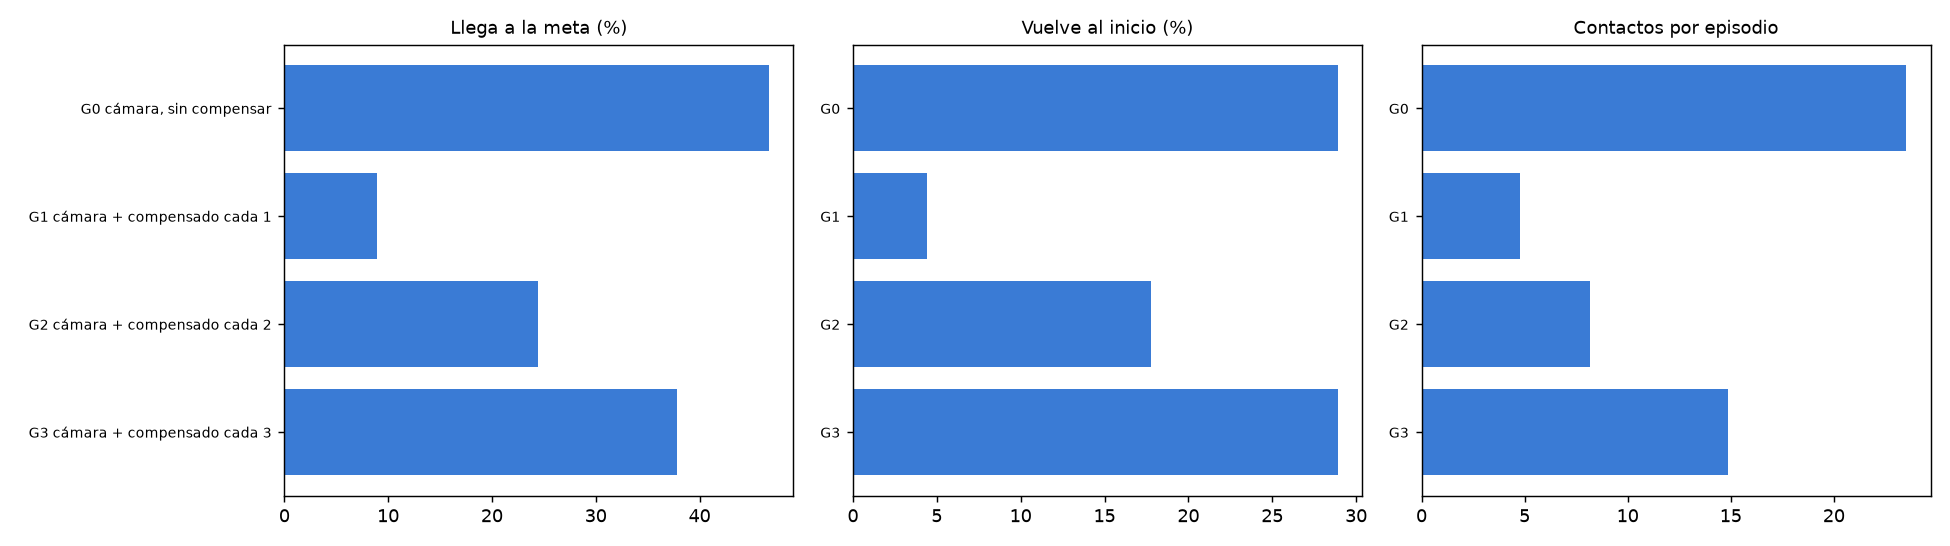
agrobot_system_2/docs/estrategias/camara_lidar2/estrategias.png
