DAvolmx/AGROBOT_V1/agrobot_system_2/docs/estrategias/camara_lidar3/estrategias.png

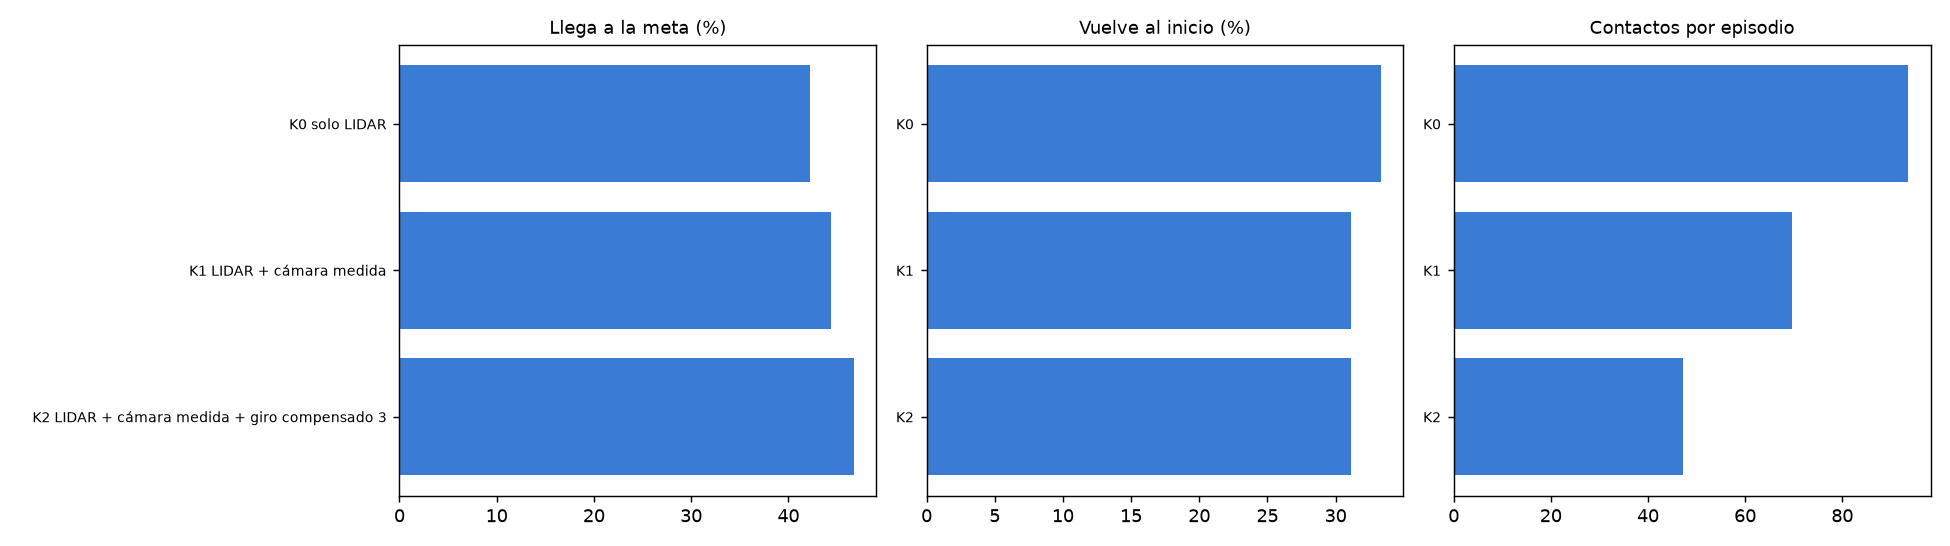
agrobot_system_2/docs/estrategias/camara_lidar3/estrategias.png
