DAvolmx/AGROBOT_V1/agrobot_system_2/docs/estrategias/media_vuelta/estrategias.png

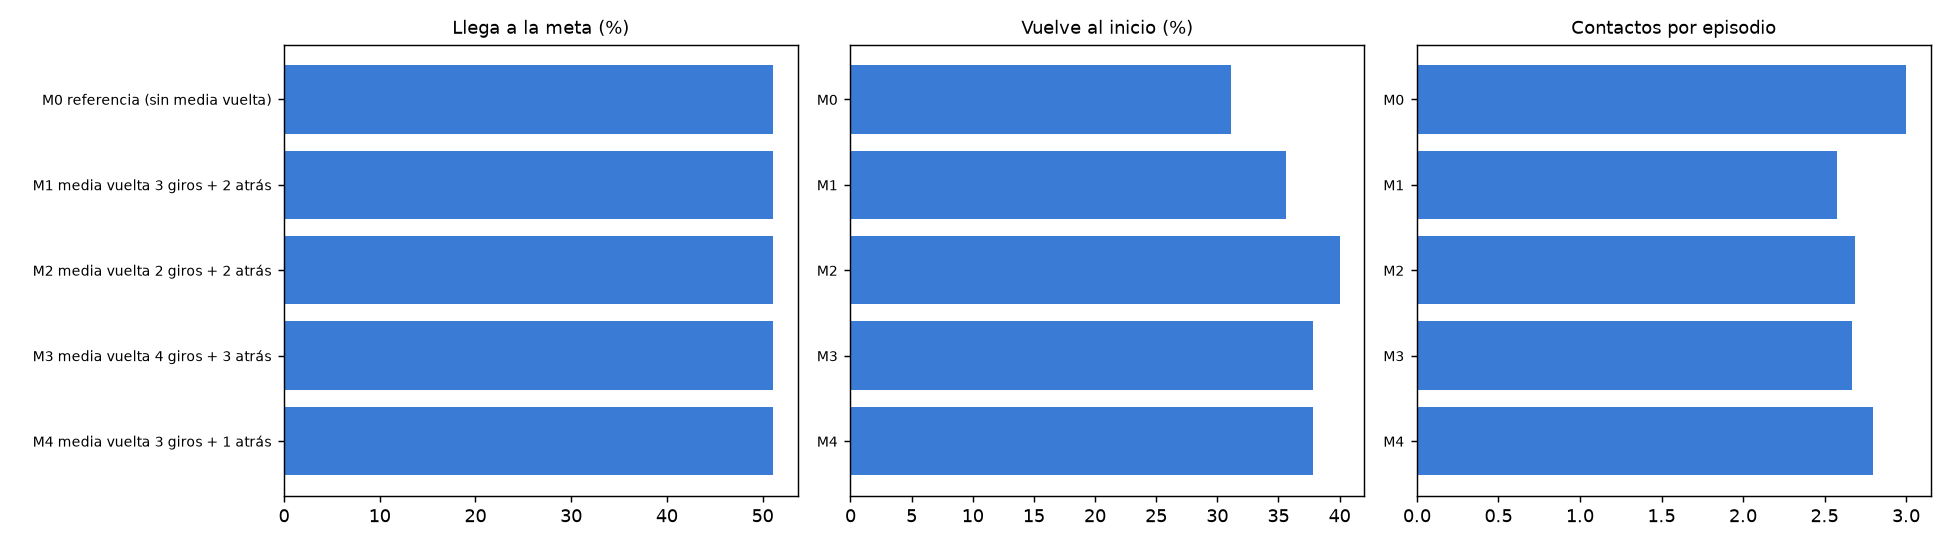
agrobot_system_2/docs/estrategias/media_vuelta/estrategias.png
