DAvolmx/AGROBOT_V1/agrobot_system_2/docs/FOTOS_PLAGAS_20261112/filtro/1_puntos.jpg

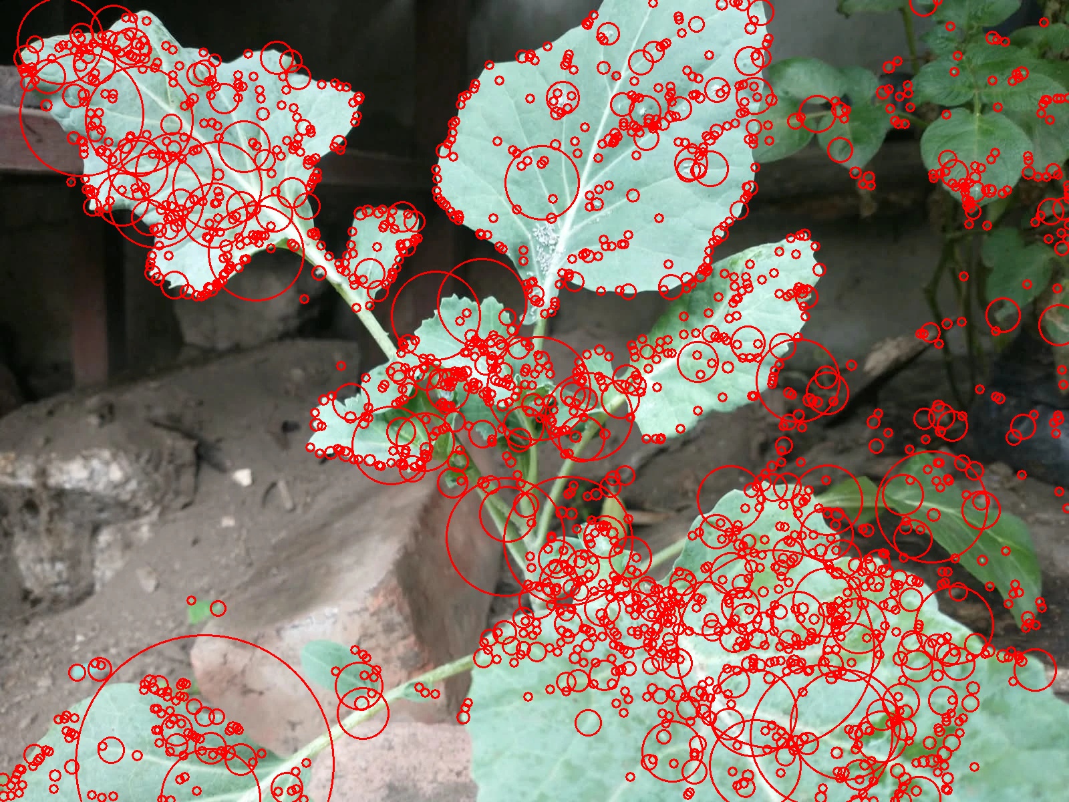
agrobot_system_2/docs/FOTOS_PLAGAS_20261112/filtro/1_puntos.jpg
