DAvolmx/AGROBOT_V1/agrobot_system_2/docs/FOTOS_PLAGAS_20261112/inferencias/3.jpg

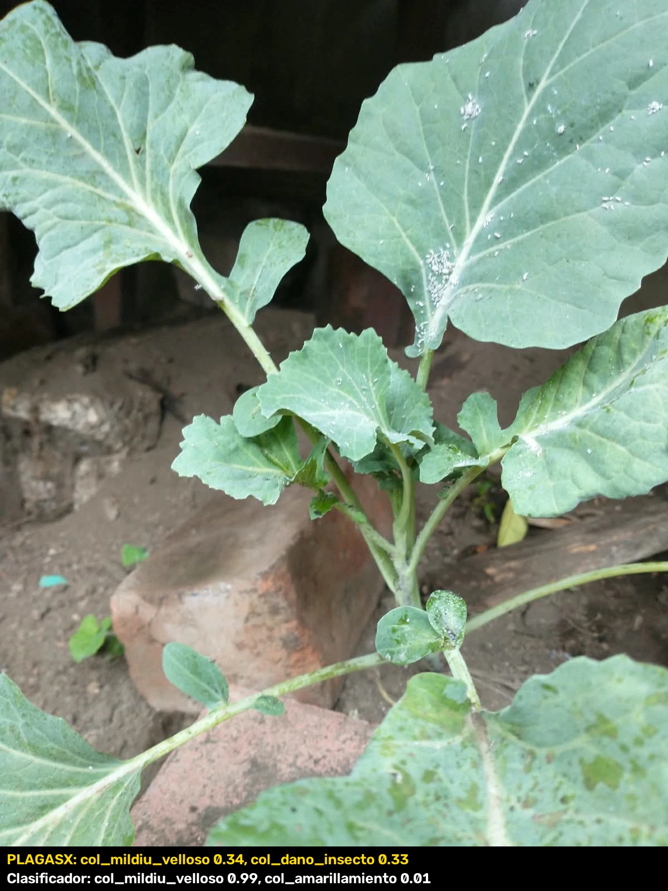
agrobot_system_2/docs/FOTOS_PLAGAS_20261112/inferencias/3.jpg
