DAvolmx/AGROBOT_V1/agrobot_system_2/docs/FOTOS_PLAGAS_20261112/orig/4.webp

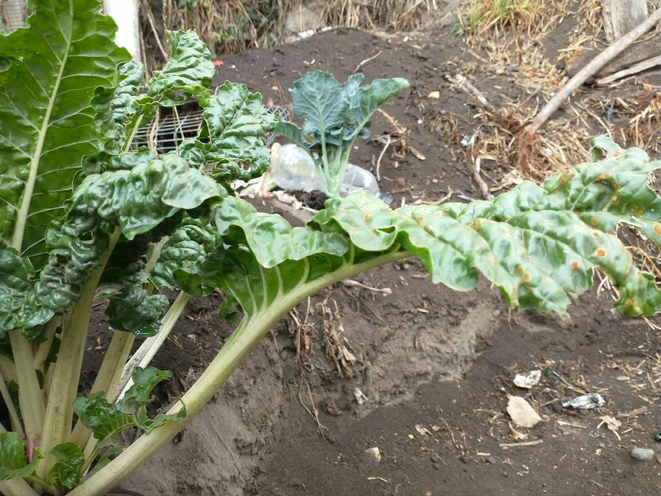
agrobot_system_2/docs/FOTOS_PLAGAS_20261112/orig/4.webp
