DAvolmx/AGROBOT_V1/agrobot_system_2/docs/graficas/04_rumbo.png

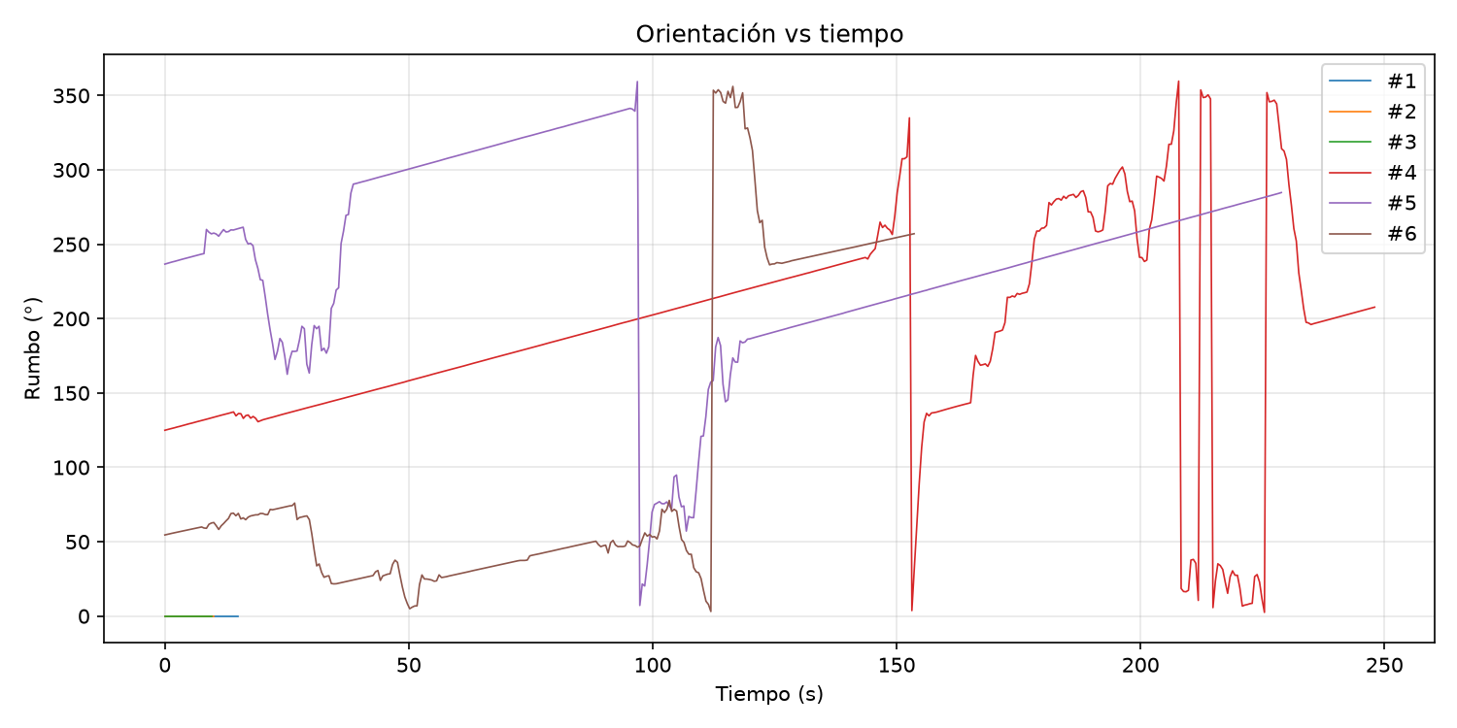
agrobot_system_2/docs/graficas/04_rumbo.png
