DAvolmx/AGROBOT_V1/agrobot_system_2/docs/graficas/05_lidar_frontal.png

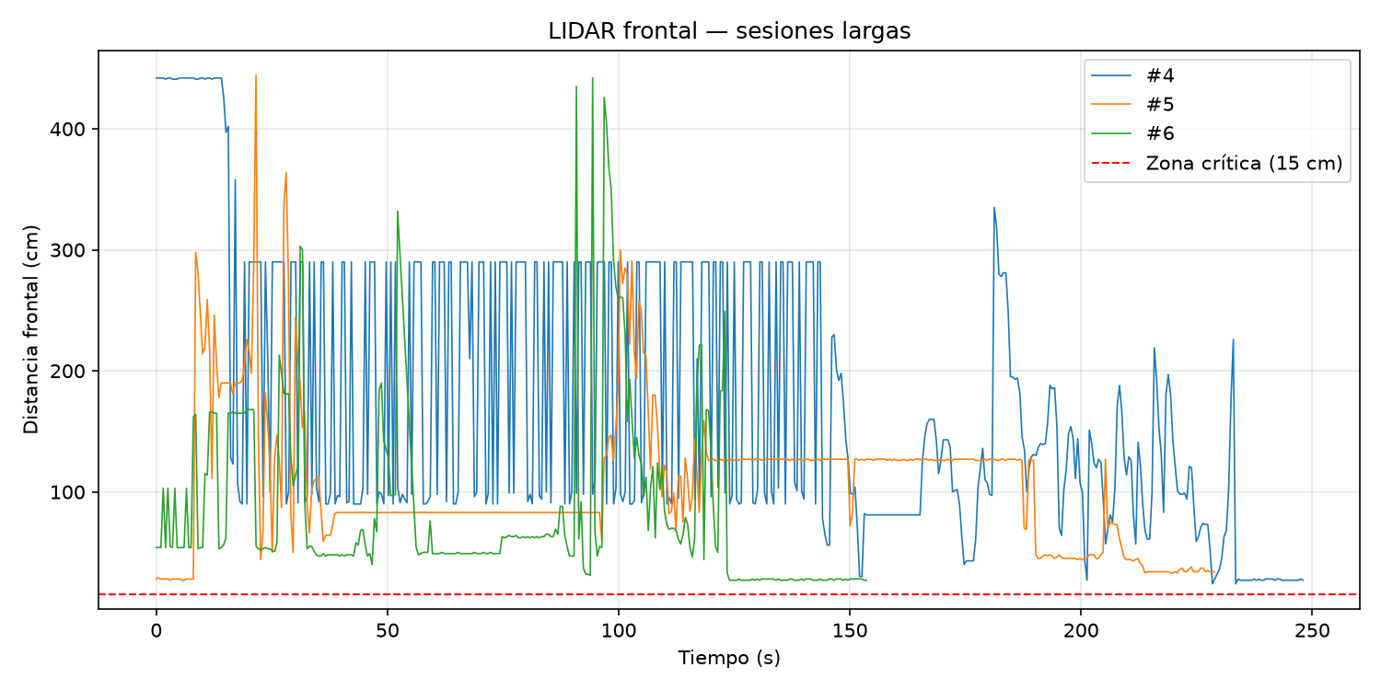
agrobot_system_2/docs/graficas/05_lidar_frontal.png
