DAvolmx/AGROBOT_V1/agrobot_system_2/docs/graficas/06_resumen.png

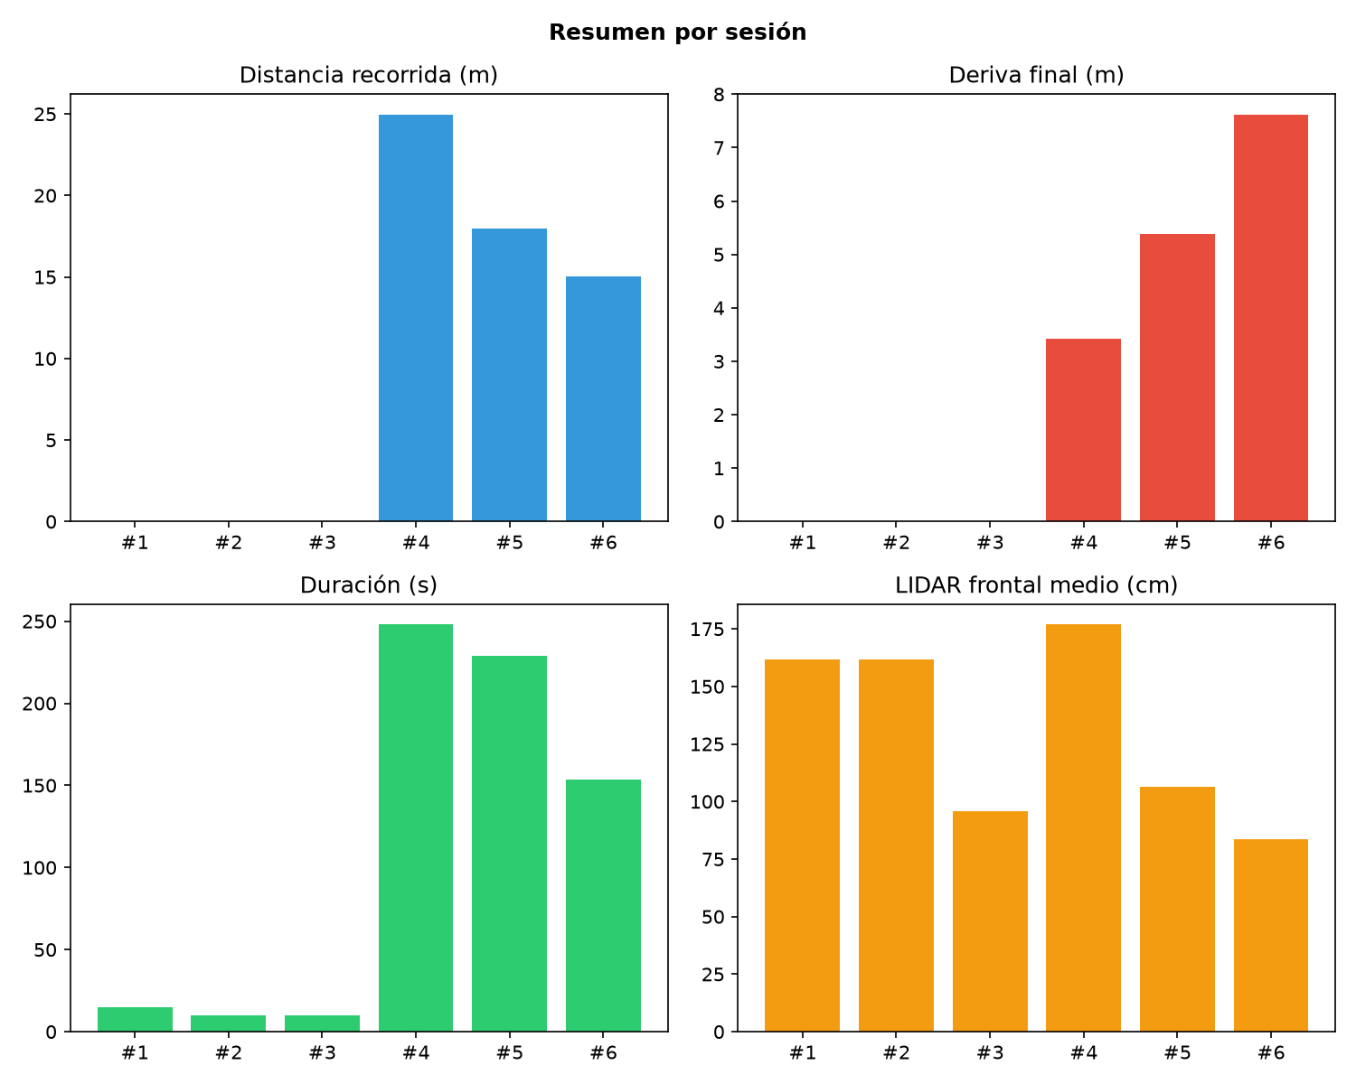
agrobot_system_2/docs/graficas/06_resumen.png
