DAvolmx/AGROBOT_V1/agrobot_system_2/docs/graficas/07_antes_despues.png

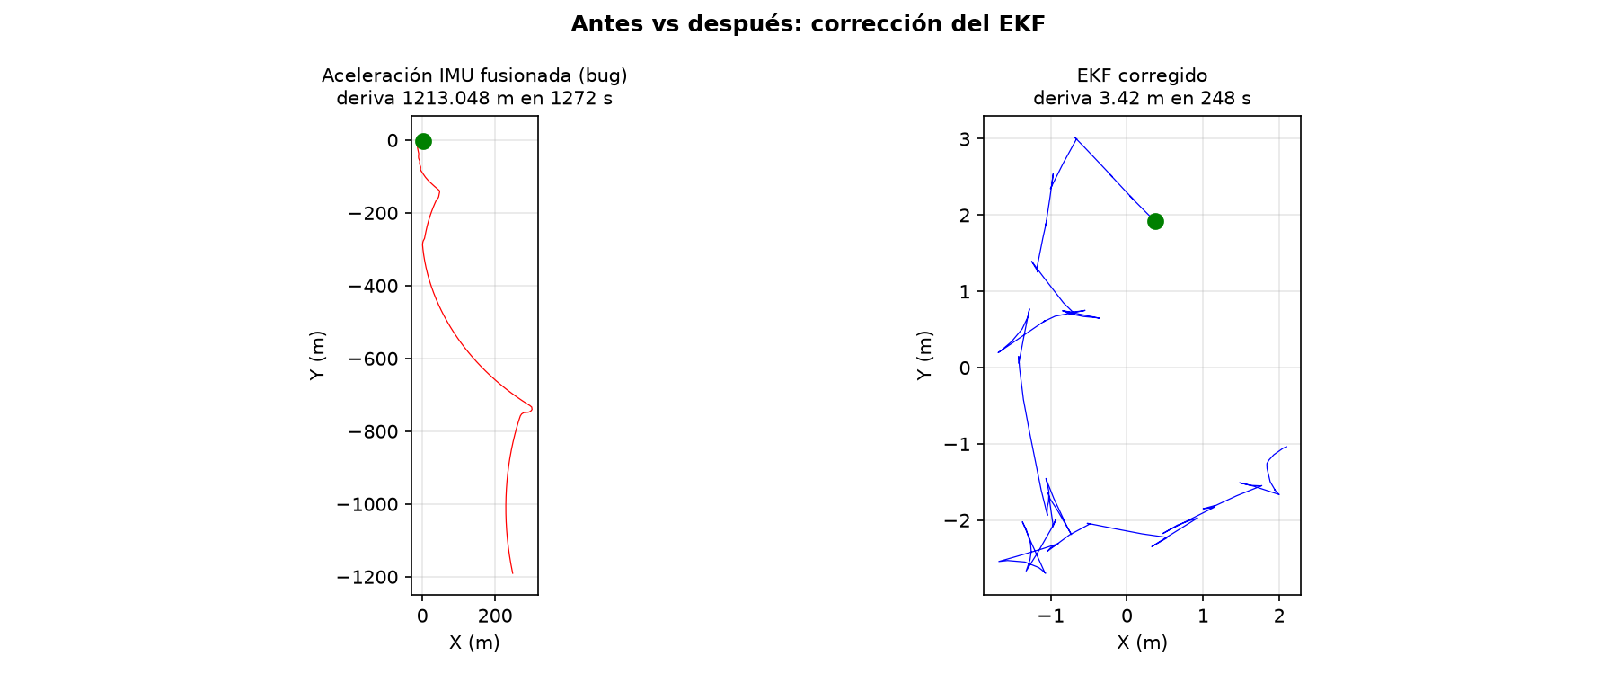
agrobot_system_2/docs/graficas/07_antes_despues.png
