DAvolmx/AGROBOT_V1/agrobot_system_2/docs/INFORME_DASHBOARD/anotadas/01_dashboard.png

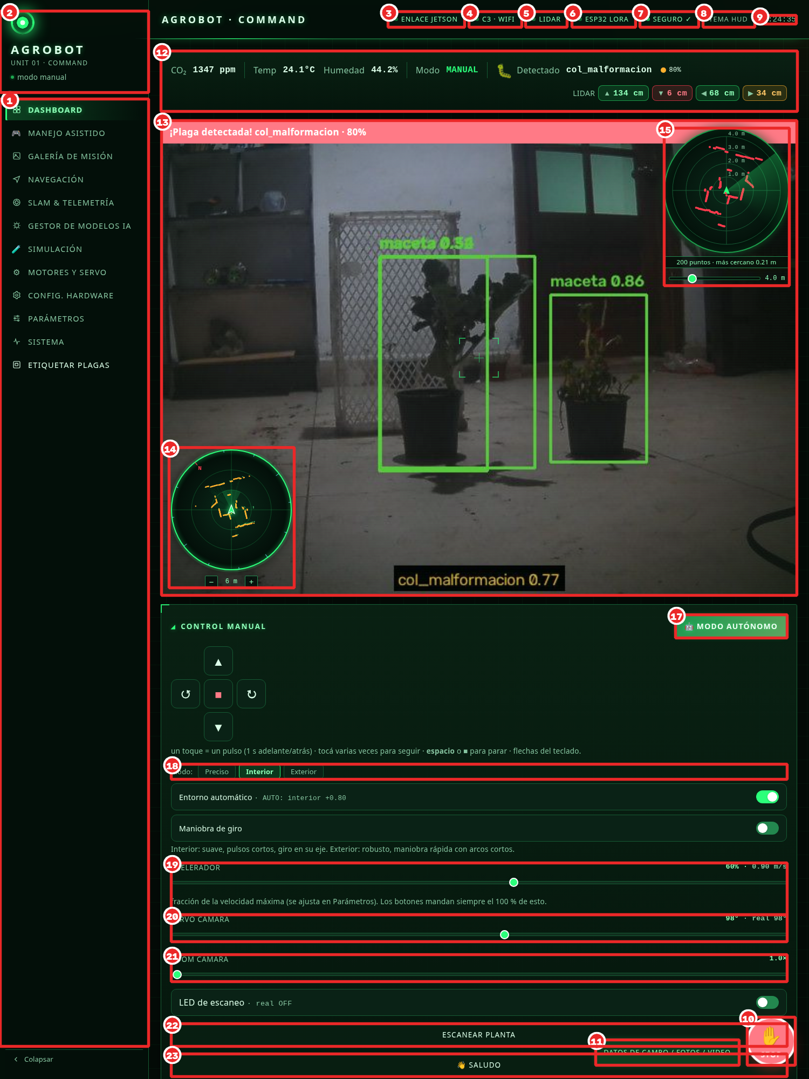
agrobot_system_2/docs/INFORME_DASHBOARD/anotadas/01_dashboard.png
