DAvolmx/AGROBOT_V1/agrobot_system_2/docs/INFORME_DASHBOARD/anotadas/02_manejo_asistido.png

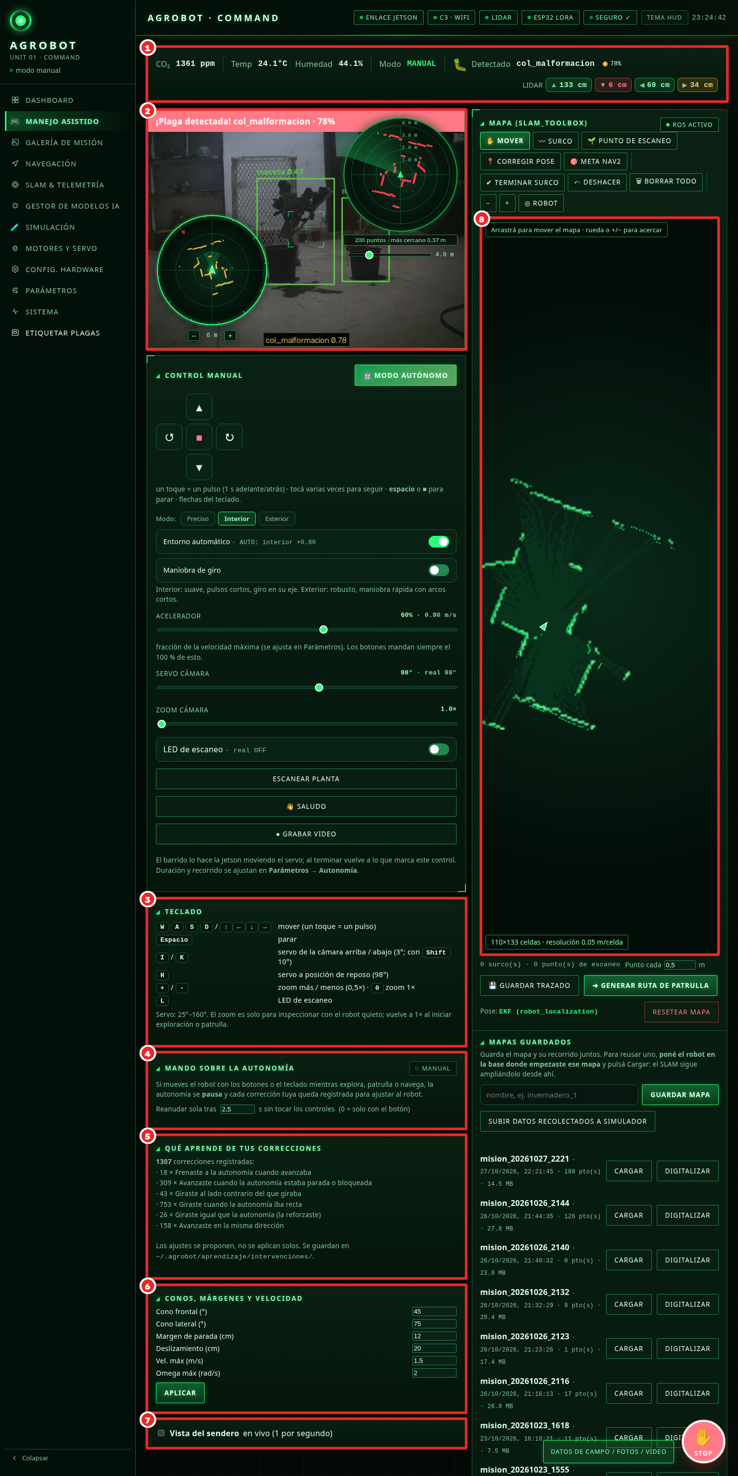
agrobot_system_2/docs/INFORME_DASHBOARD/anotadas/02_manejo_asistido.png
