DAvolmx/AGROBOT_V1/agrobot_system_2/docs/INFORME_DASHBOARD/anotadas/02_manejo_asistido_limpia.png

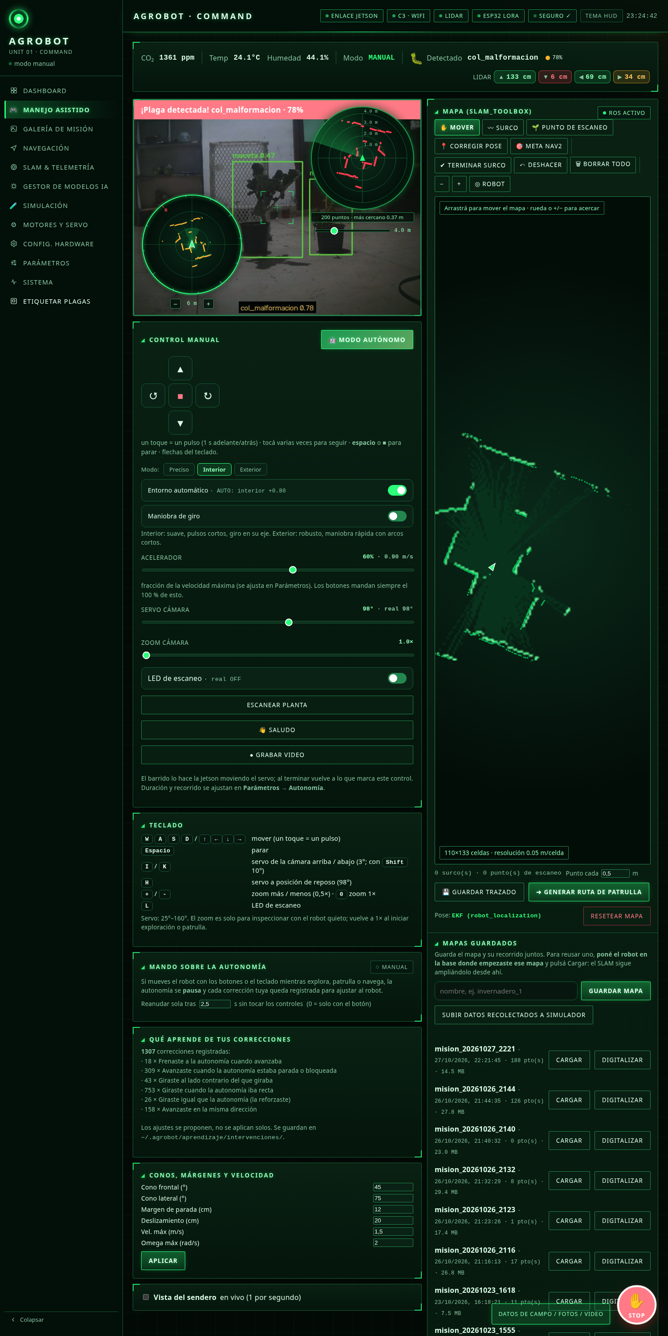
agrobot_system_2/docs/INFORME_DASHBOARD/anotadas/02_manejo_asistido_limpia.png
