DAvolmx/AGROBOT_V1/agrobot_system_2/docs/INFORME_DASHBOARD/anotadas/03_galeria.png

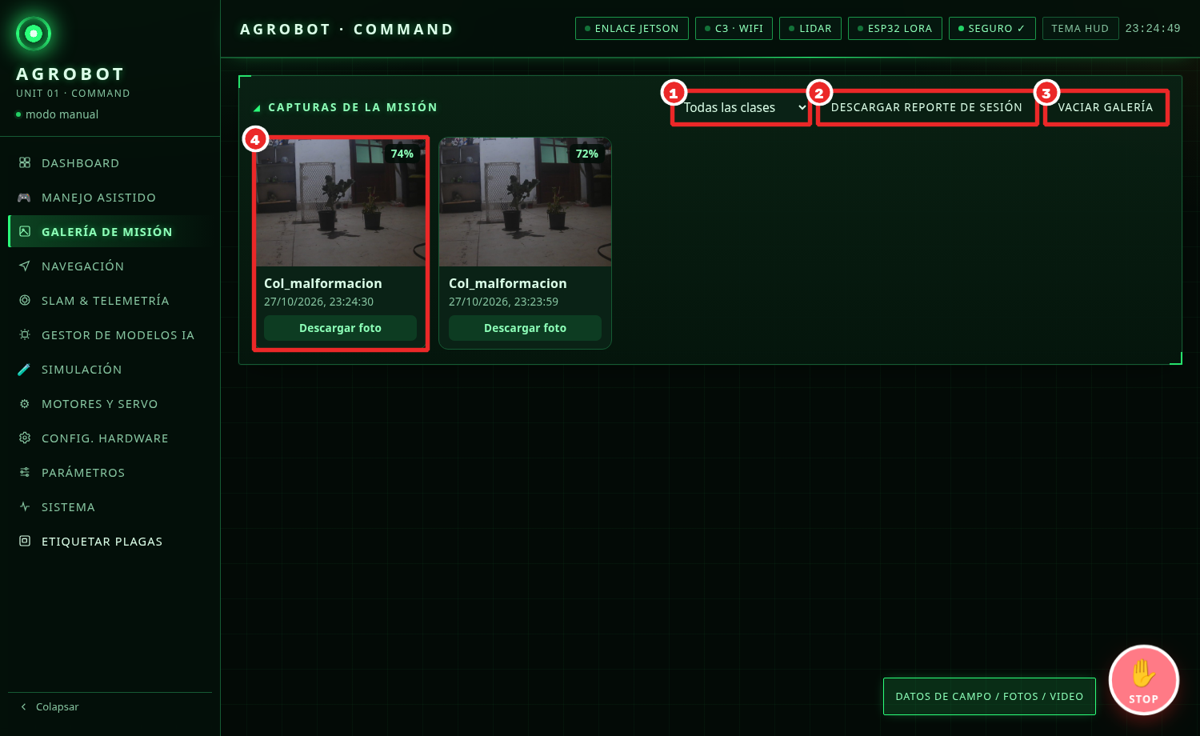
agrobot_system_2/docs/INFORME_DASHBOARD/anotadas/03_galeria.png
