DAvolmx/AGROBOT_V1/agrobot_system_2/docs/INFORME_DASHBOARD/anotadas/03_galeria_limpia.png

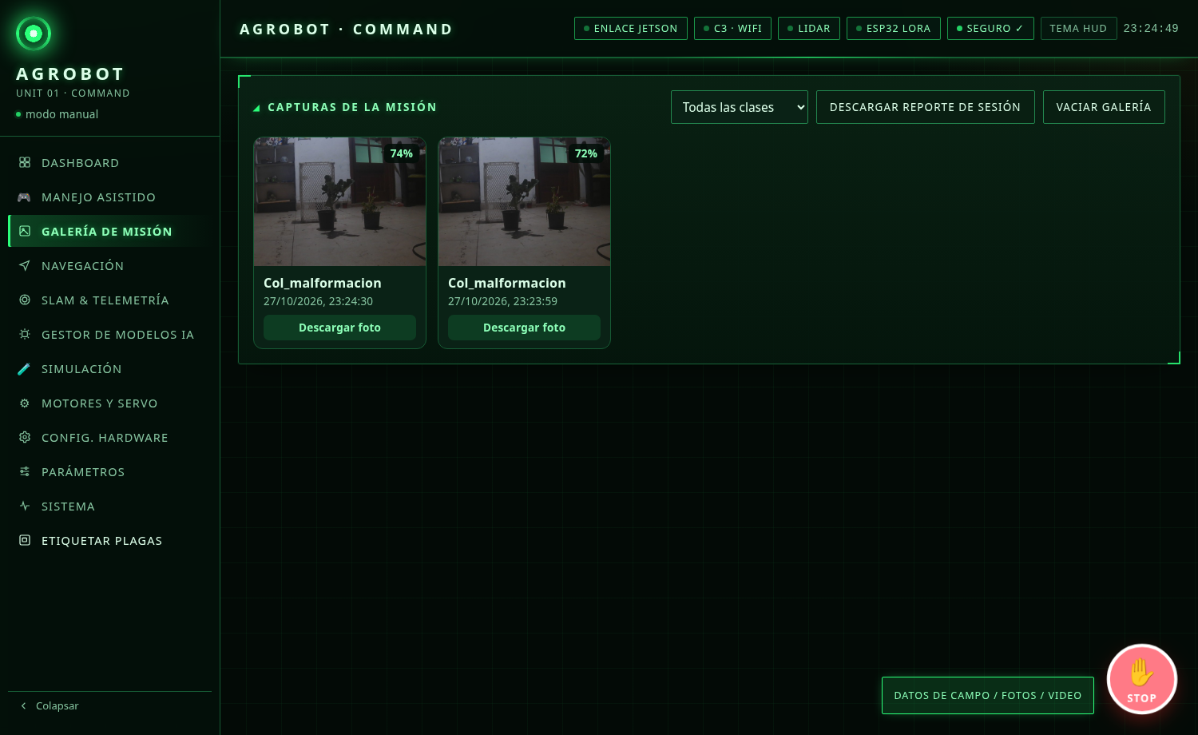
agrobot_system_2/docs/INFORME_DASHBOARD/anotadas/03_galeria_limpia.png
