DAvolmx/AGROBOT_V1/agrobot_system_2/docs/INFORME_DASHBOARD/anotadas/04b_navegacion_autonomo.png

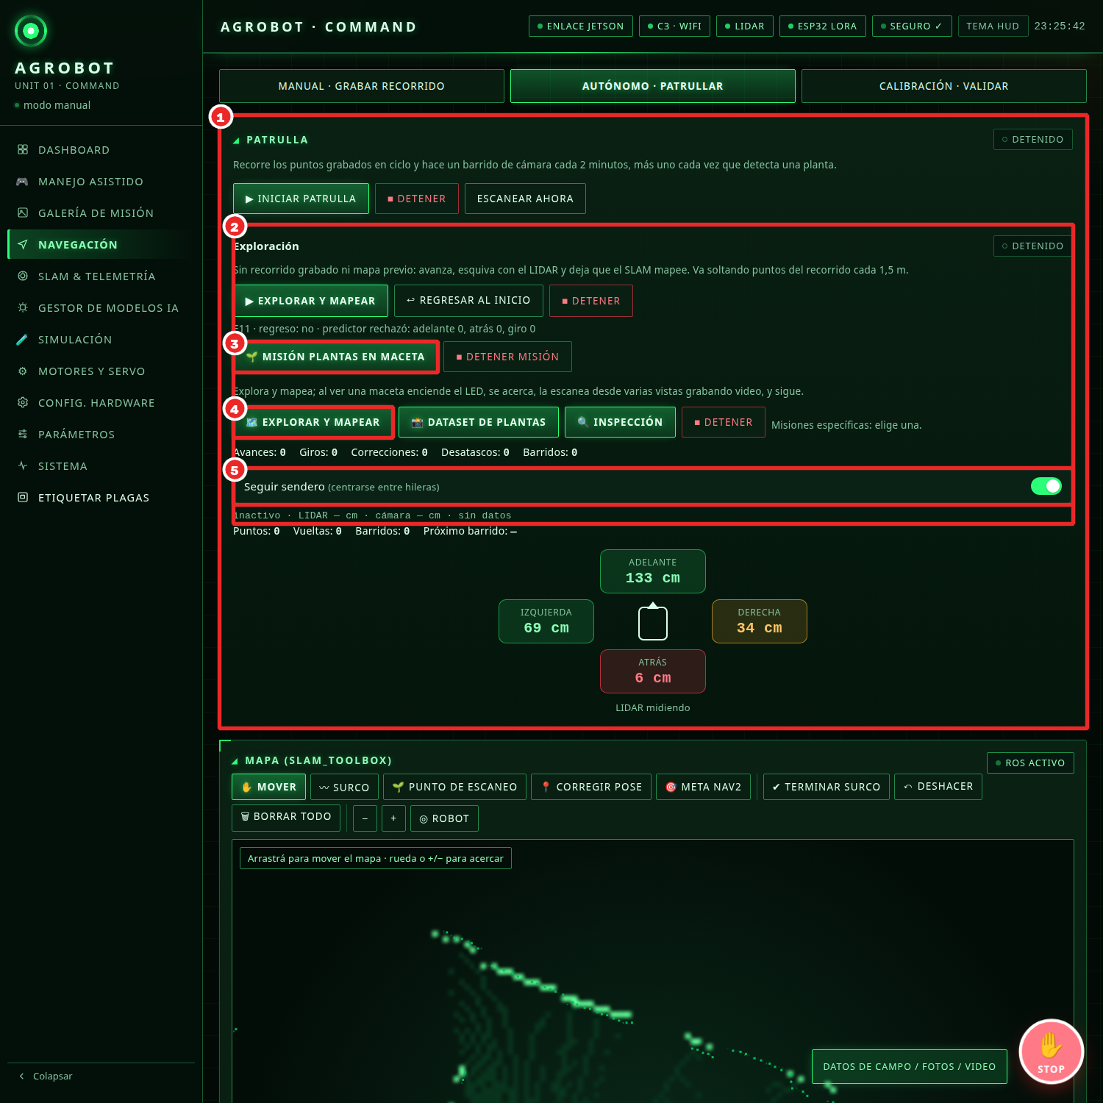
agrobot_system_2/docs/INFORME_DASHBOARD/anotadas/04b_navegacion_autonomo.png
