DAvolmx/AGROBOT_V1/agrobot_system_2/docs/INFORME_DASHBOARD/anotadas/05_slam_telemetria_limpia.png

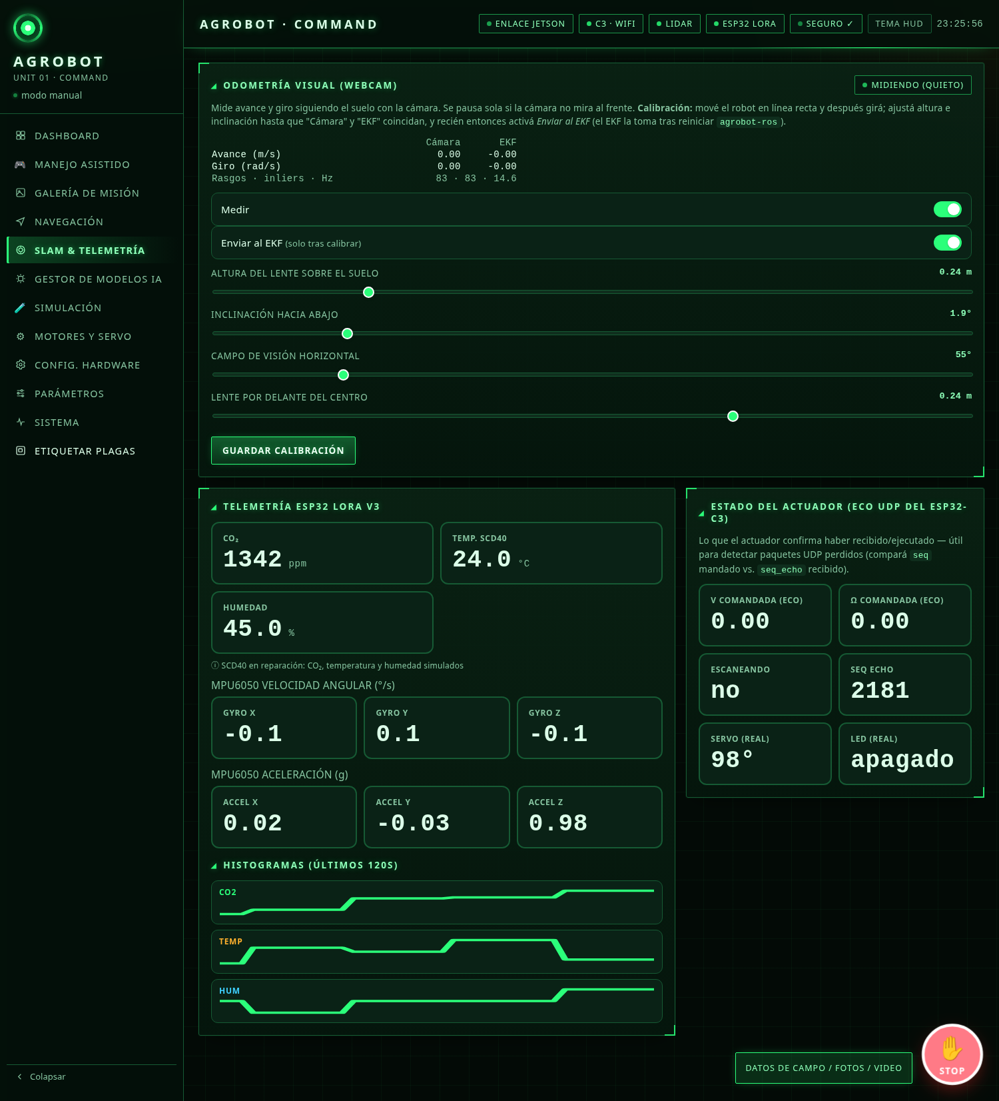
agrobot_system_2/docs/INFORME_DASHBOARD/anotadas/05_slam_telemetria_limpia.png
