DAvolmx/AGROBOT_V1/agrobot_system_2/docs/INFORME_DASHBOARD/anotadas/06_modelos_ia.png

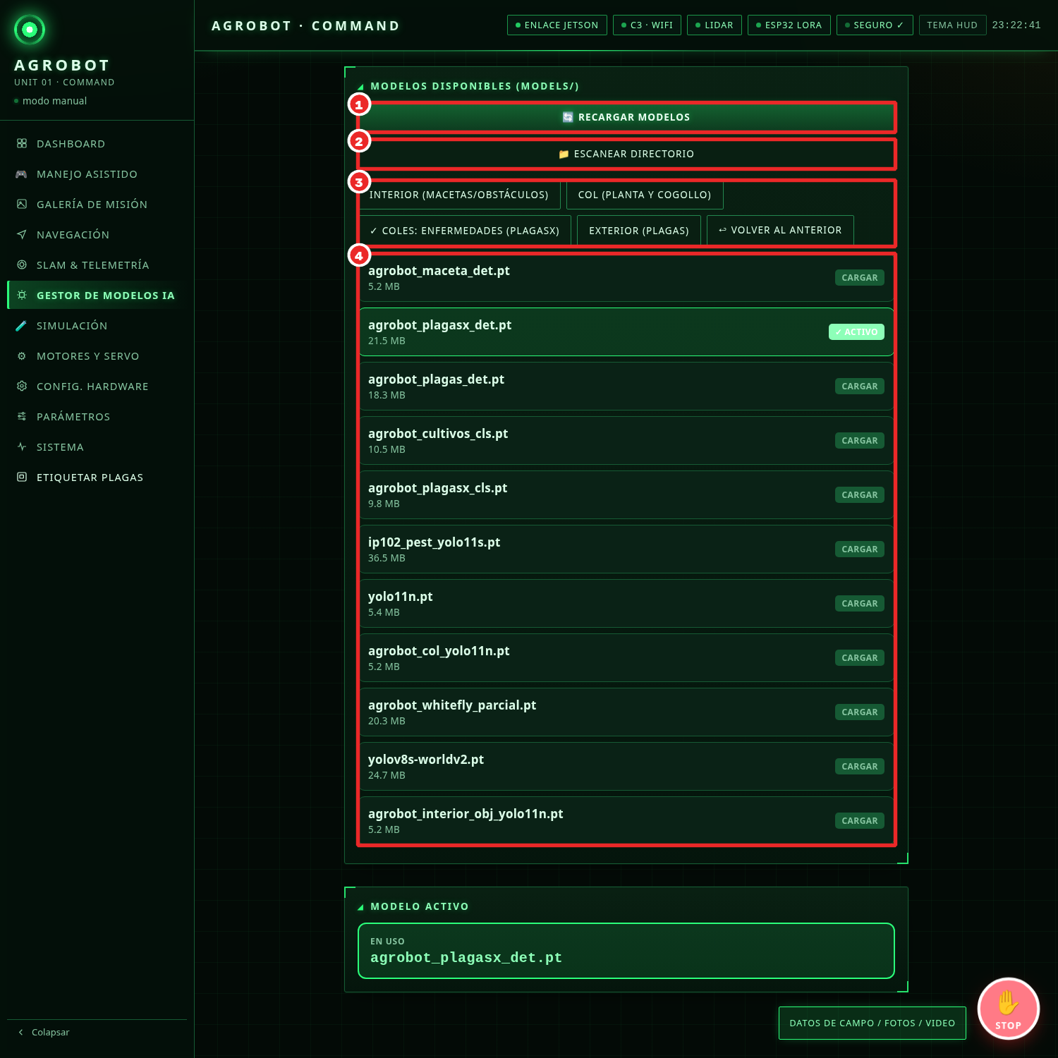
agrobot_system_2/docs/INFORME_DASHBOARD/anotadas/06_modelos_ia.png
