DAvolmx/AGROBOT_V1/agrobot_system_2/docs/INFORME_DASHBOARD/anotadas/07_simulacion_limpia.png

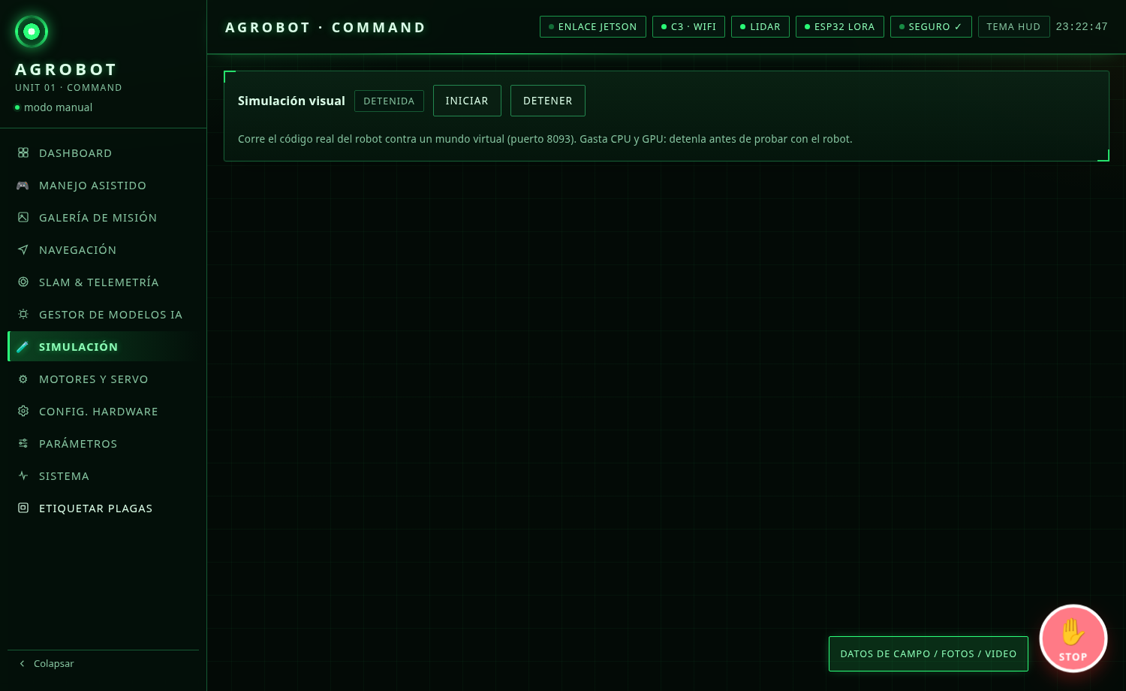
agrobot_system_2/docs/INFORME_DASHBOARD/anotadas/07_simulacion_limpia.png
