DAvolmx/AGROBOT_V1/agrobot_system_2/docs/INFORME_DASHBOARD/anotadas/08_motores_servo.png

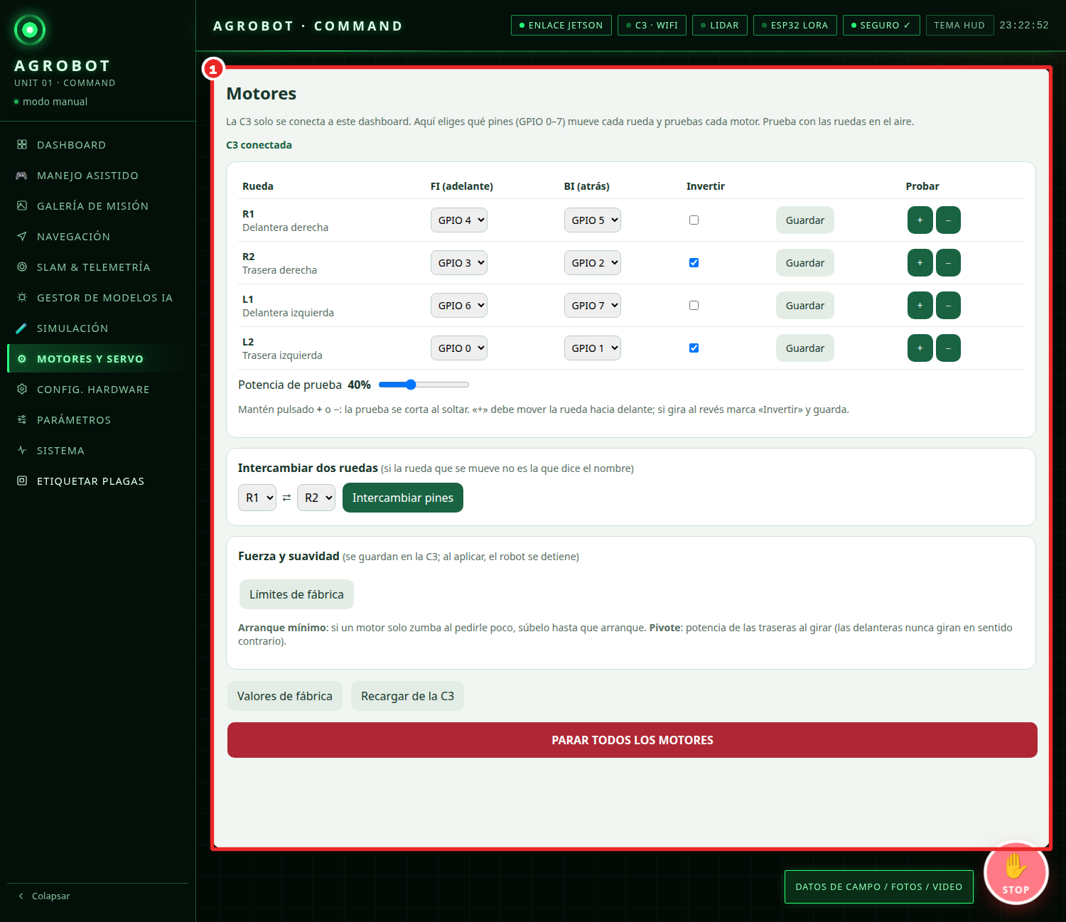
agrobot_system_2/docs/INFORME_DASHBOARD/anotadas/08_motores_servo.png
