DAvolmx/AGROBOT_V1/agrobot_system_2/docs/INFORME_DASHBOARD/anotadas/09_config_hardware.png

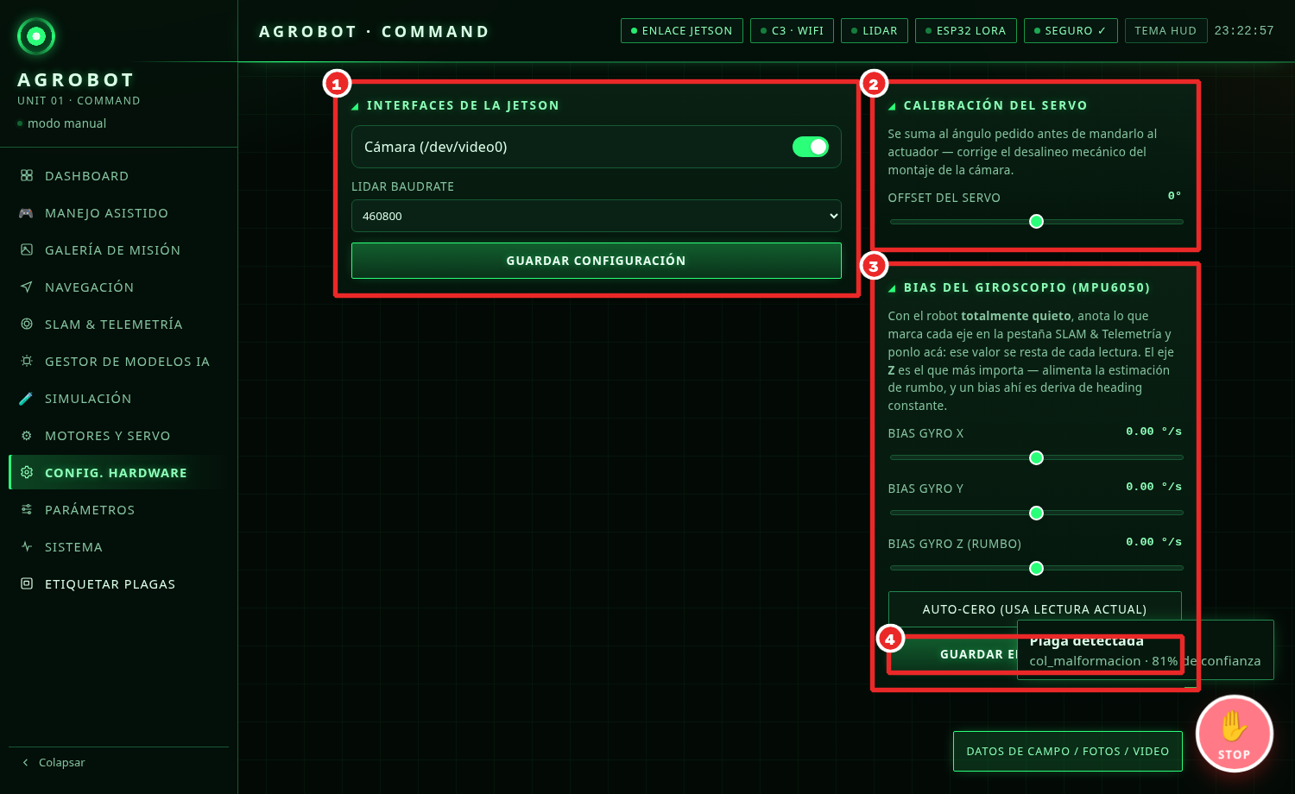
agrobot_system_2/docs/INFORME_DASHBOARD/anotadas/09_config_hardware.png
