DAvolmx/AGROBOT_V1/agrobot_system_2/docs/INFORME_DASHBOARD/anotadas/11_sistema.png

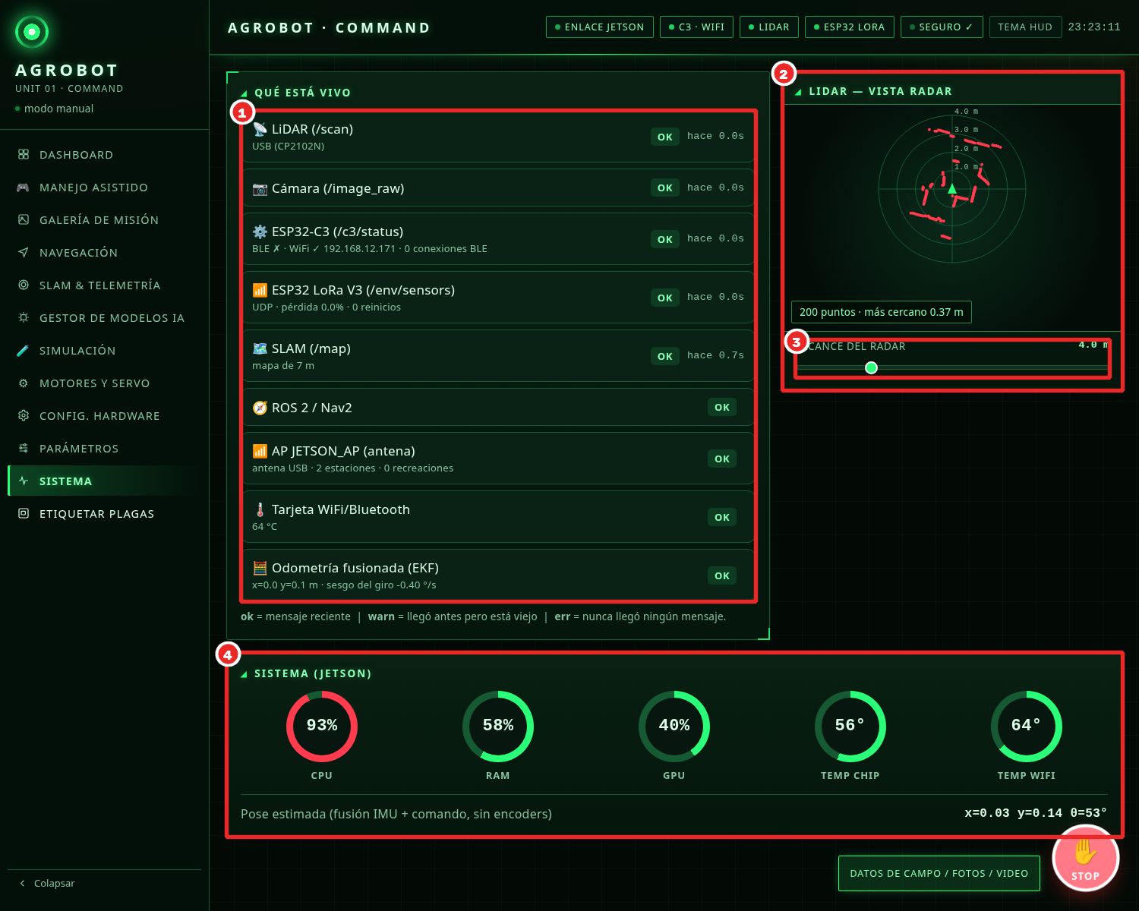
agrobot_system_2/docs/INFORME_DASHBOARD/anotadas/11_sistema.png
