DAvolmx/AGROBOT_V1/agrobot_system_2/docs/INFORME_DASHBOARD/anotadas/aux_etiquetar.png

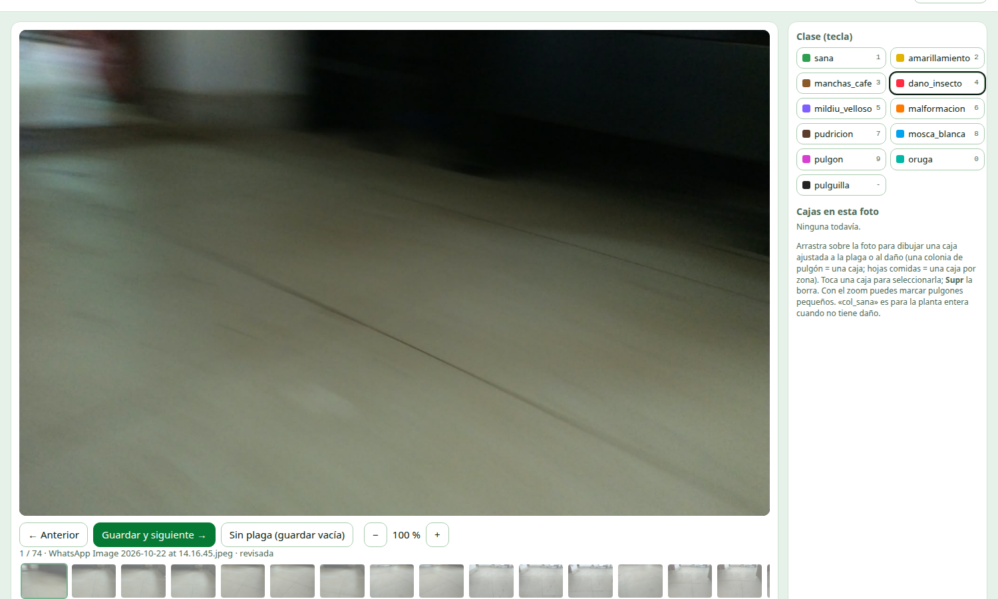
agrobot_system_2/docs/INFORME_DASHBOARD/anotadas/aux_etiquetar.png
