DAvolmx/AGROBOT_V1/agrobot_system_2/docs/INFORME_DASHBOARD/anotadas/aux_manejo_movil.png

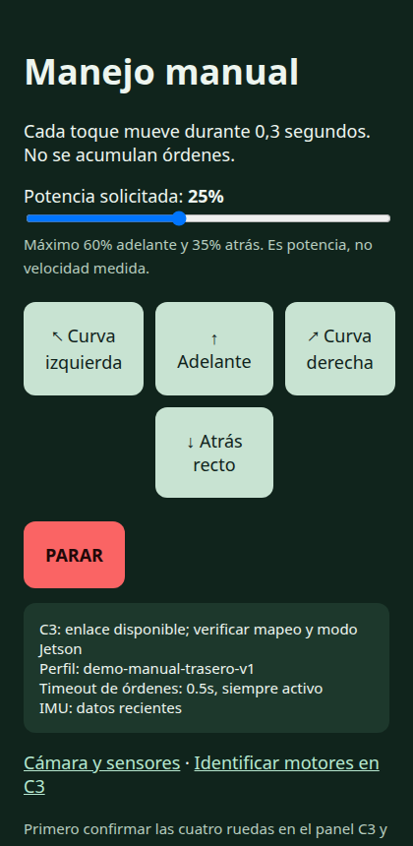
agrobot_system_2/docs/INFORME_DASHBOARD/anotadas/aux_manejo_movil.png
