DAvolmx/AGROBOT_V1/agrobot_system_2/docs/INFORME_DASHBOARD/anotadas/aux_motores.png

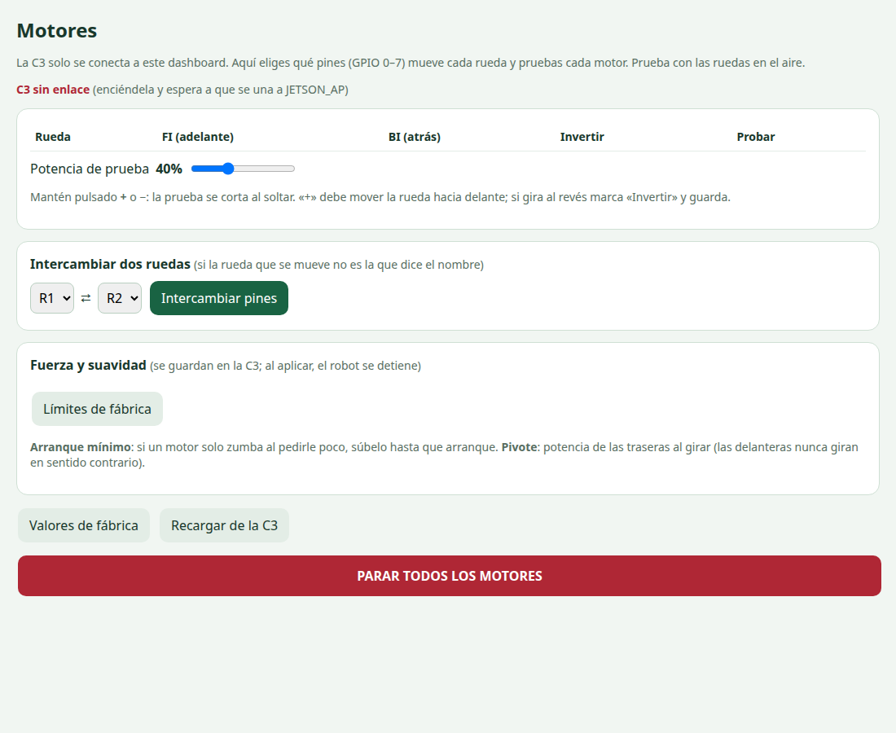
agrobot_system_2/docs/INFORME_DASHBOARD/anotadas/aux_motores.png
