DAvolmx/AGROBOT_V1/agrobot_system_2/docs/INFORME_DASHBOARD/figs/tema_sol.png

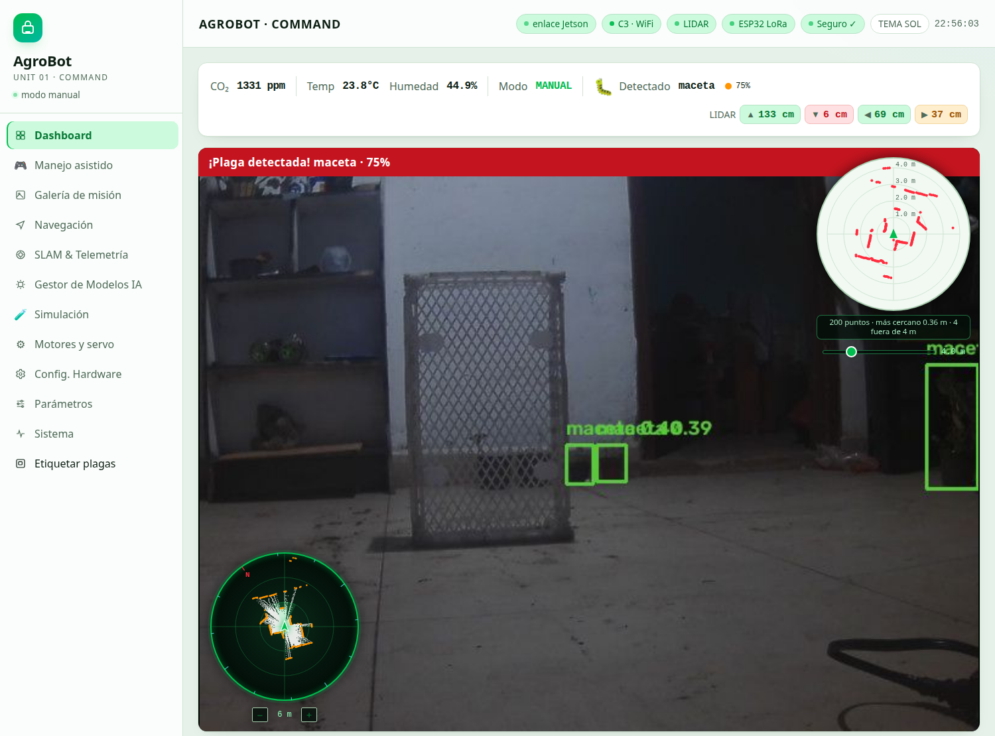
agrobot_system_2/docs/INFORME_DASHBOARD/figs/tema_sol.png
