DAvolmx/AGROBOT_V1/agrobot_system_2/docs/INFORME_DASHBOARD_PI/anotadas/02_variables_limpia.png

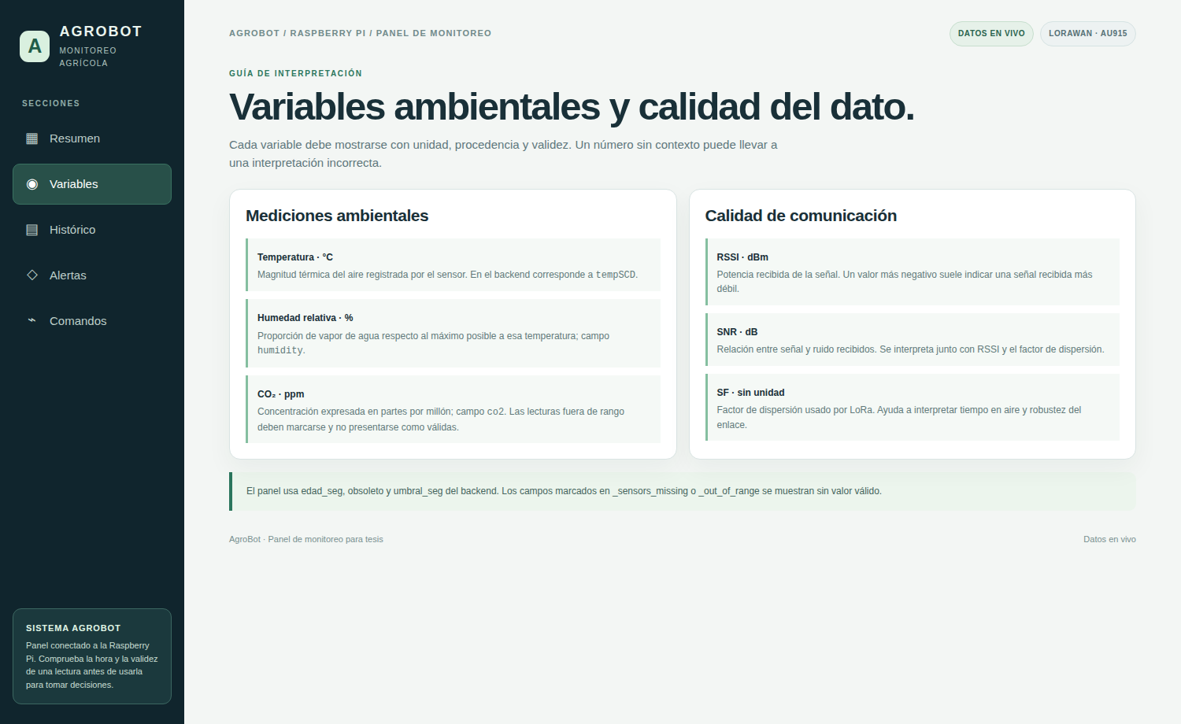
agrobot_system_2/docs/INFORME_DASHBOARD_PI/anotadas/02_variables_limpia.png
