DAvolmx/AGROBOT_V1/agrobot_system_2/docs/mapa_bonito/20261026_210806_5afbd3_comparacion.png

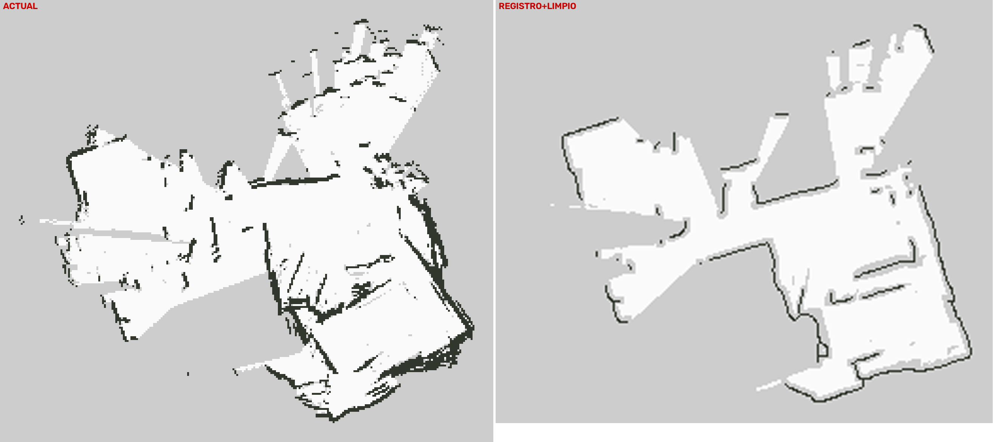
agrobot_system_2/docs/mapa_bonito/20261026_210806_5afbd3_comparacion.png
