DAvolmx/AGROBOT_V1/agrobot_system_2/docs/mapa_bonito/20261026_211854_a14049_actual.png

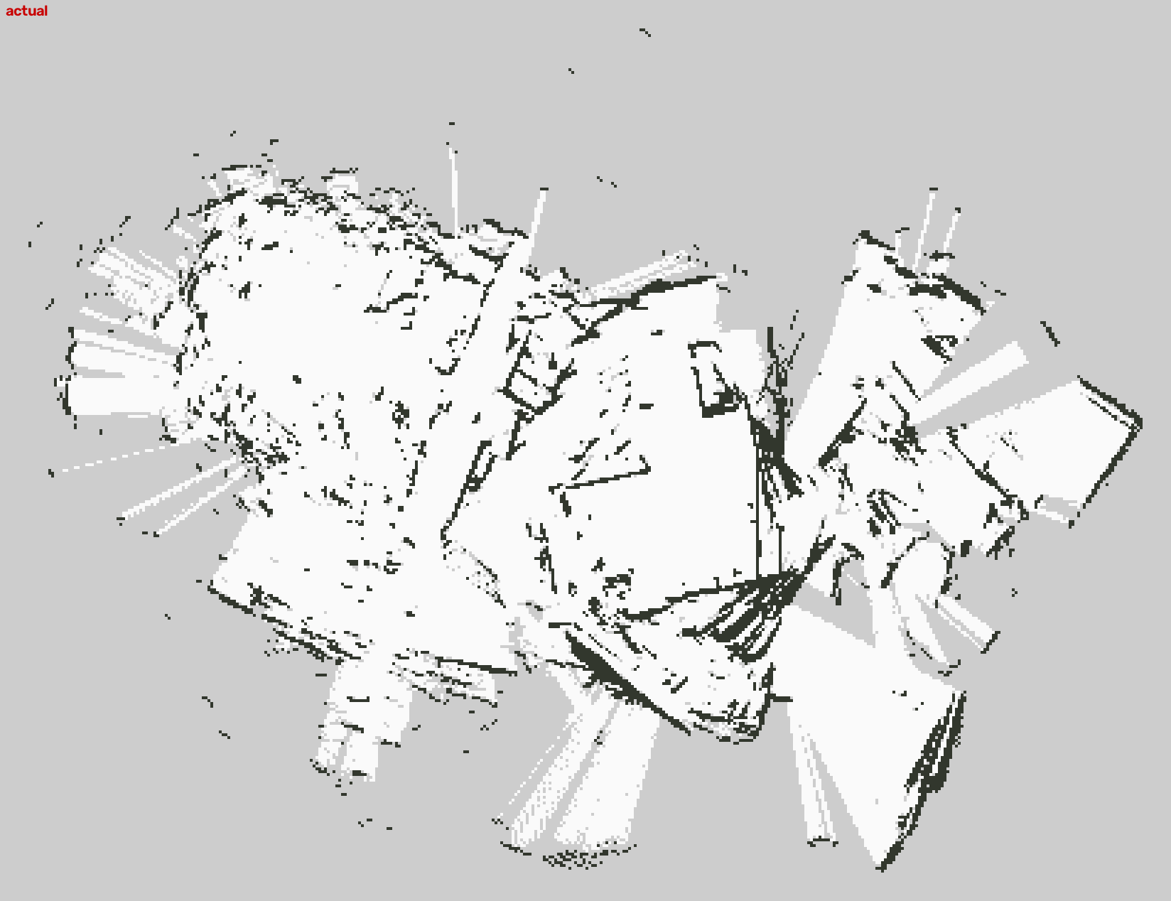
agrobot_system_2/docs/mapa_bonito/20261026_211854_a14049_actual.png
