DAvolmx/AGROBOT_V1/agrobot_system_2/docs/mapa_bonito/20261026_213624_41e2b1_comparacion.png

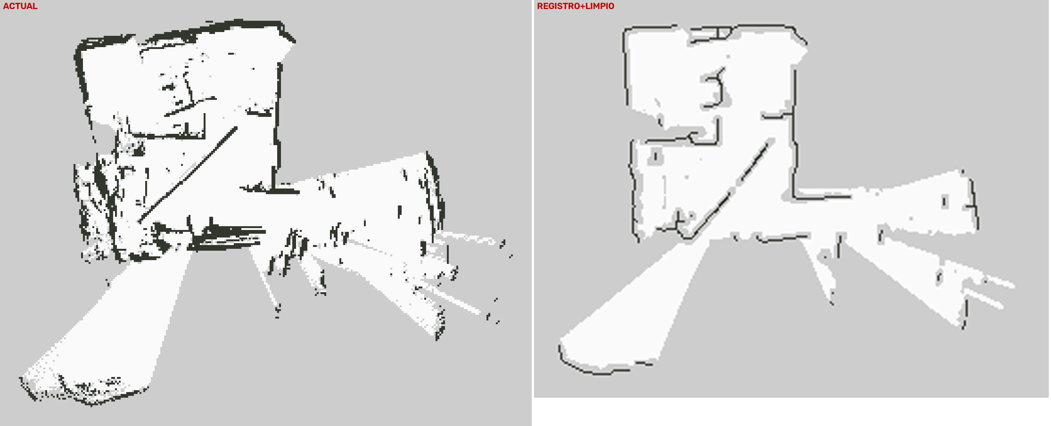
agrobot_system_2/docs/mapa_bonito/20261026_213624_41e2b1_comparacion.png
