DAvolmx/AGROBOT_V1/agrobot_system_2/docs/mapa_bonito/registro_limpio.png

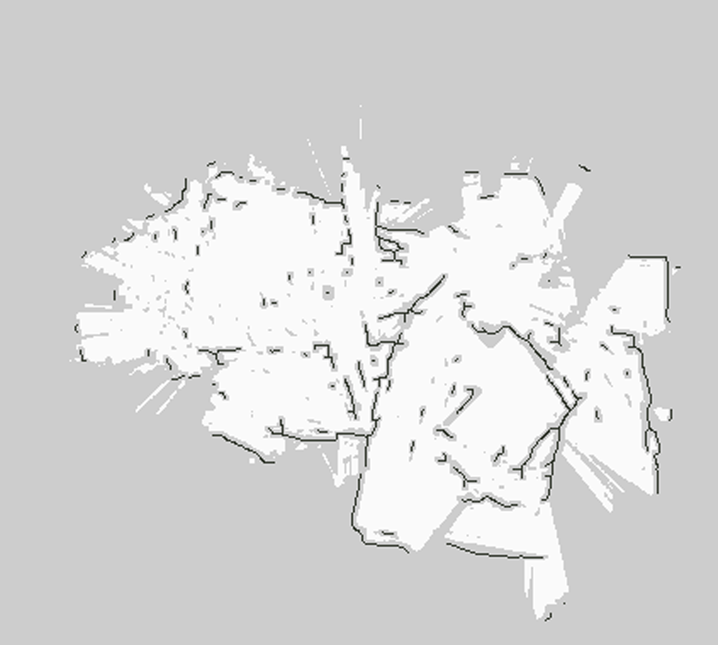
agrobot_system_2/docs/mapa_bonito/registro_limpio.png
