DAvolmx/AGROBOT_V1/agrobot_system_2/docs/mapas_interiores.png

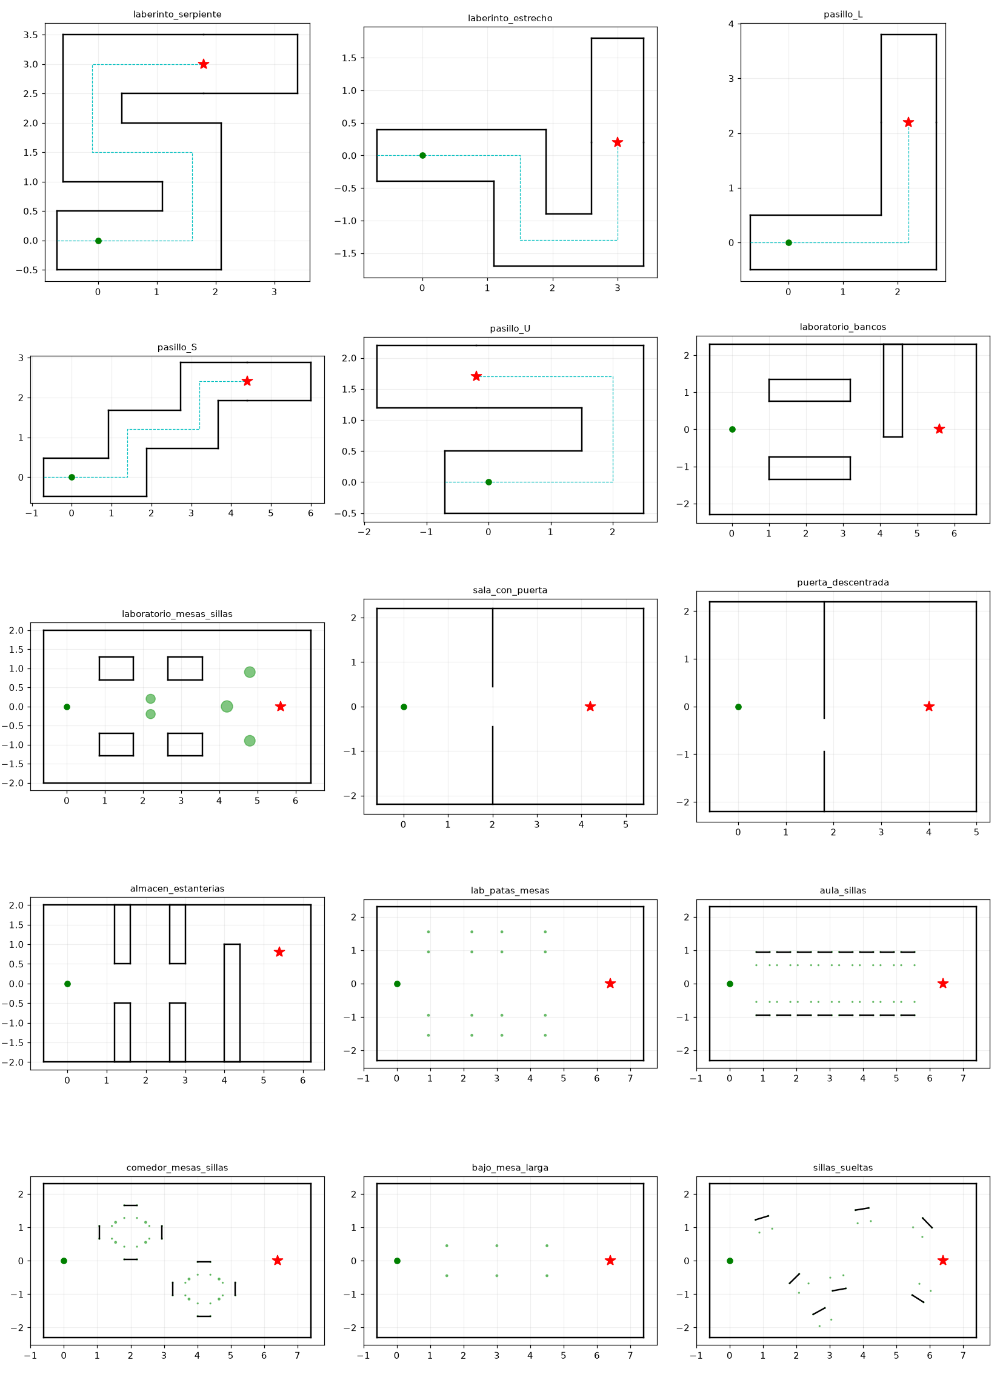
agrobot_system_2/docs/mapas_interiores.png
