DAvolmx/AGROBOT_V1/agrobot_system_2/docs/misiones_duras.png

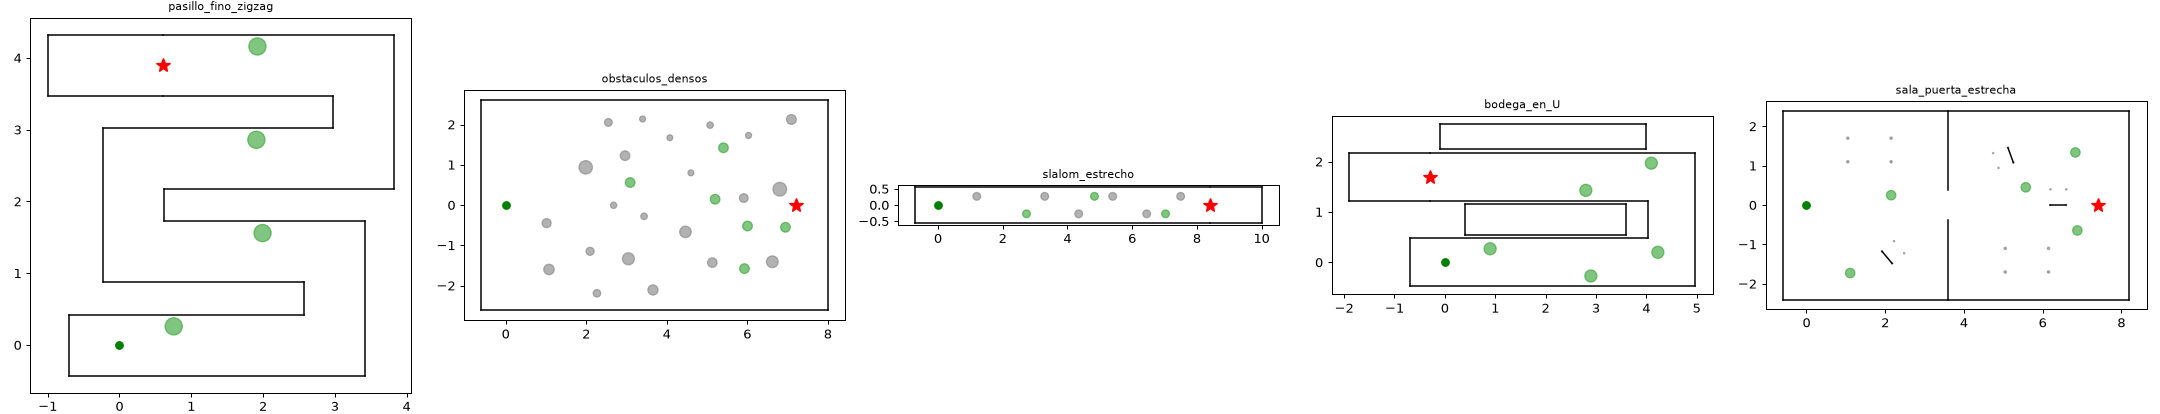
agrobot_system_2/docs/misiones_duras.png
