DAvolmx/AGROBOT_V1/agrobot_system_2/docs/REPORTE_MEJORAS_20261024/figs/guardian_rmse.png

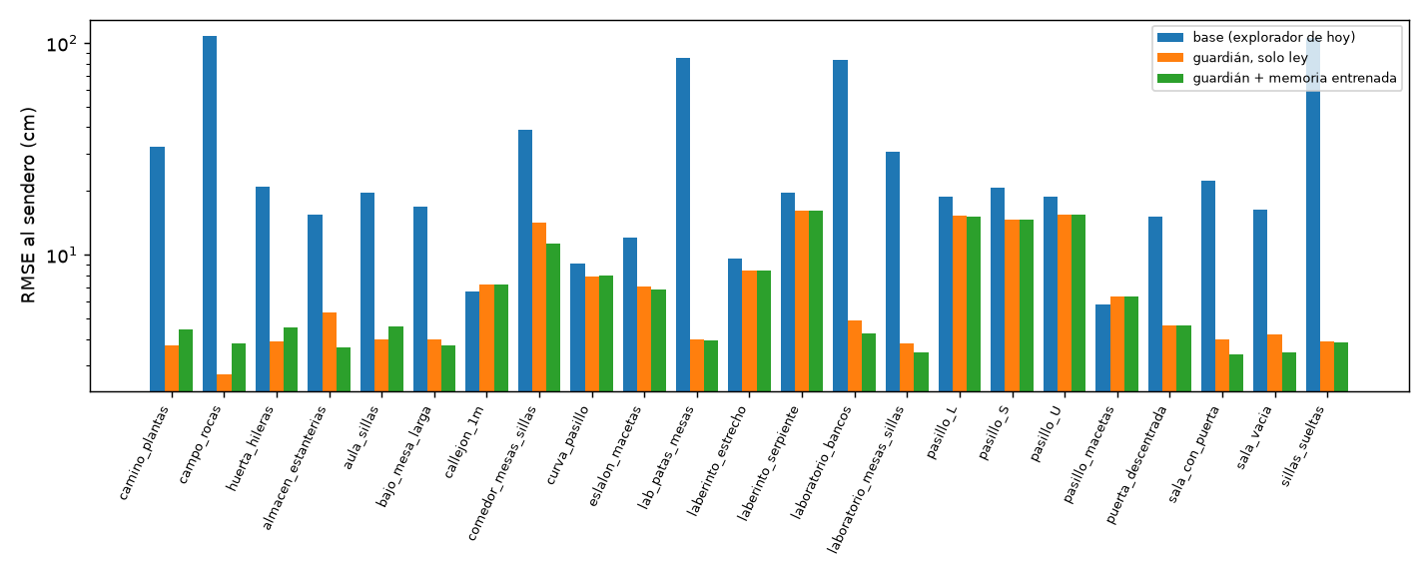
agrobot_system_2/docs/REPORTE_MEJORAS_20261024/figs/guardian_rmse.png
