DAvolmx/AGROBOT_V1/agrobot_system_2/docs/REPORTE_SIMULACION_20261023/figs/20261023_054140_db26bf_trayectoria.png

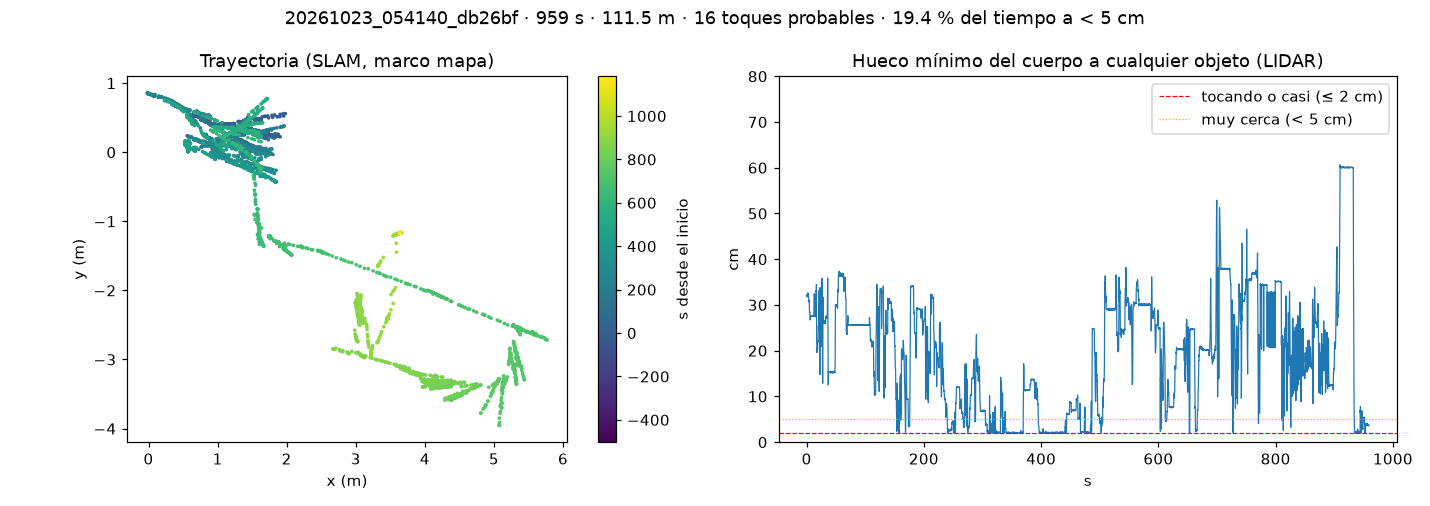
agrobot_system_2/docs/REPORTE_SIMULACION_20261023/figs/20261023_054140_db26bf_trayectoria.png
