DAvolmx/AGROBOT_V1/agrobot_system_2/docs/REPORTE_SIMULACION_20261023/figs/exactitud_vs_distancia.png

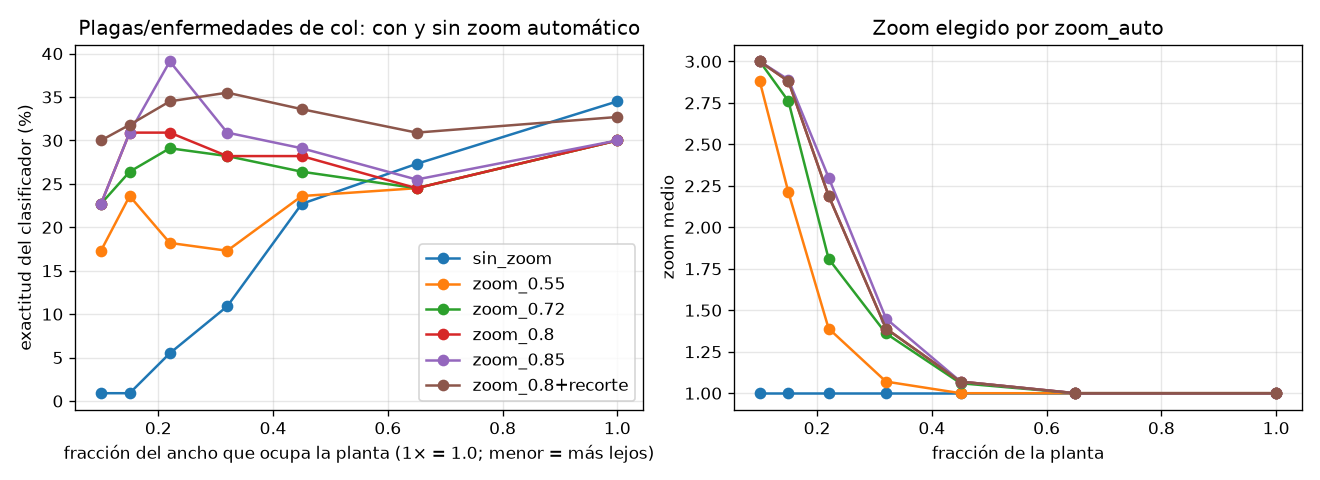
agrobot_system_2/docs/REPORTE_SIMULACION_20261023/figs/exactitud_vs_distancia.png
