DAvolmx/AGROBOT_V1/agrobot_system_2/docs/REPORTE_SIMULACION_20261023/figs/exterior_campo_rocas.png

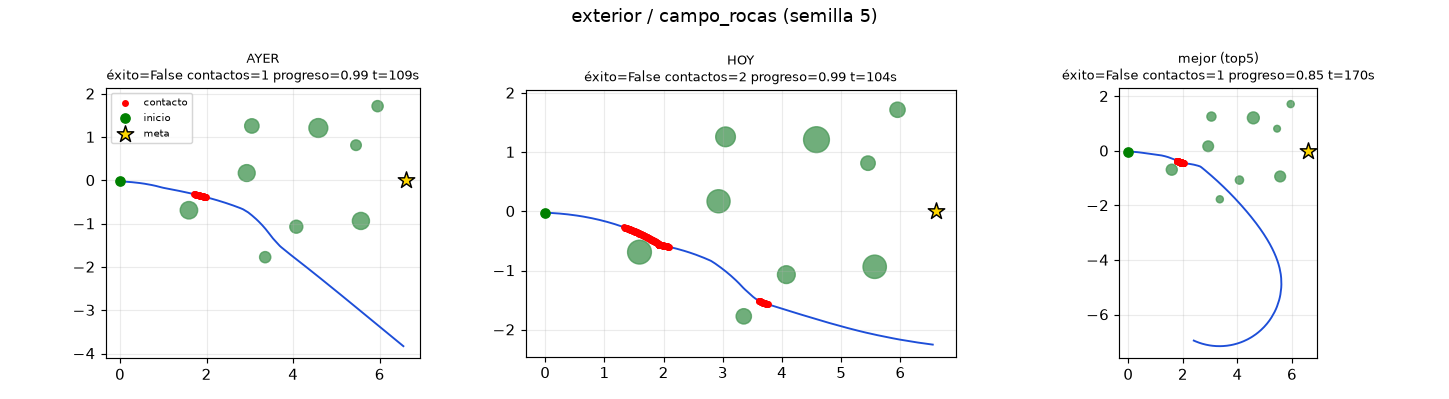
agrobot_system_2/docs/REPORTE_SIMULACION_20261023/figs/exterior_campo_rocas.png
