DAvolmx/AGROBOT_V1/agrobot_system_2/docs/REPORTE_SIMULACION_20261023/figs/interior_sala_vacia.png

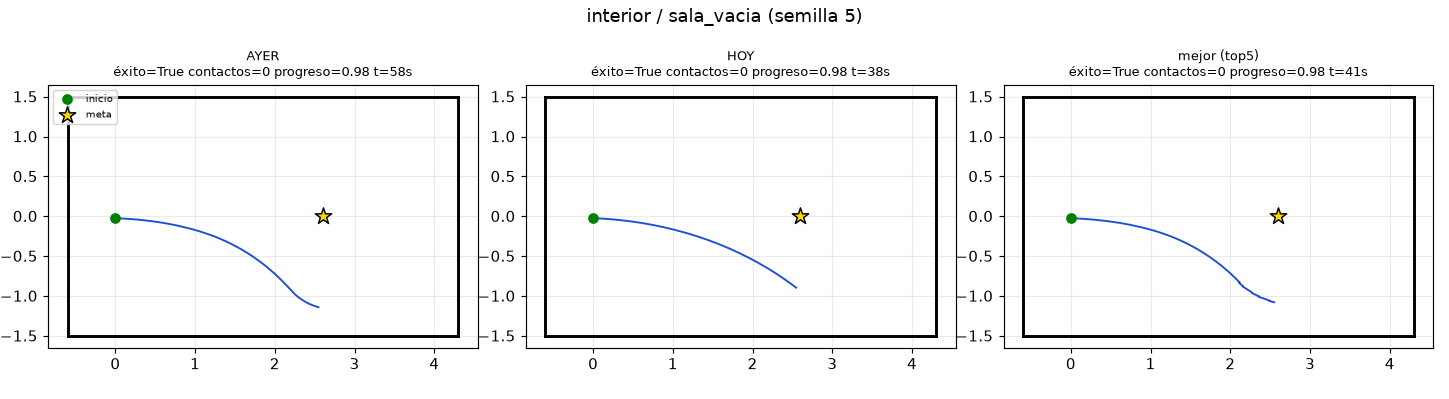
agrobot_system_2/docs/REPORTE_SIMULACION_20261023/figs/interior_sala_vacia.png
