DAvolmx/AGROBOT_V1/agrobot_system_2/docs/REPORTE_SIMULACION_20261023/figs/macetas_bajas.jpg

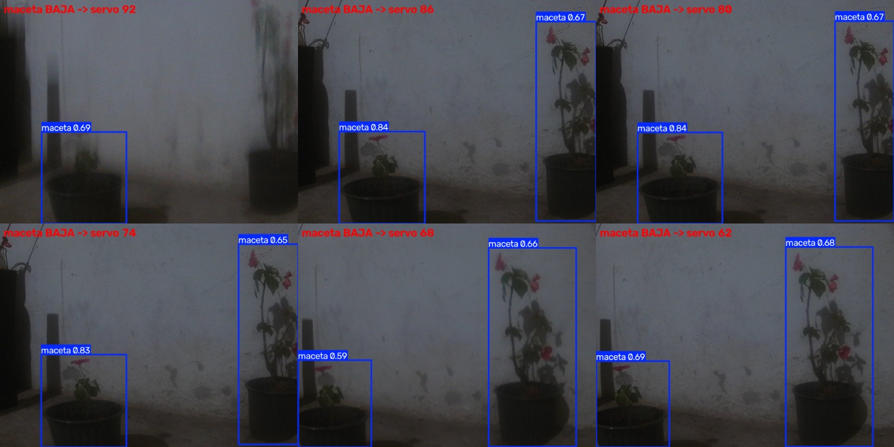
agrobot_system_2/docs/REPORTE_SIMULACION_20261023/figs/macetas_bajas.jpg
