DAvolmx/AGROBOT_V1/agrobot_system_2/docs/sendero/deteccion_hileras_verdes.jpg

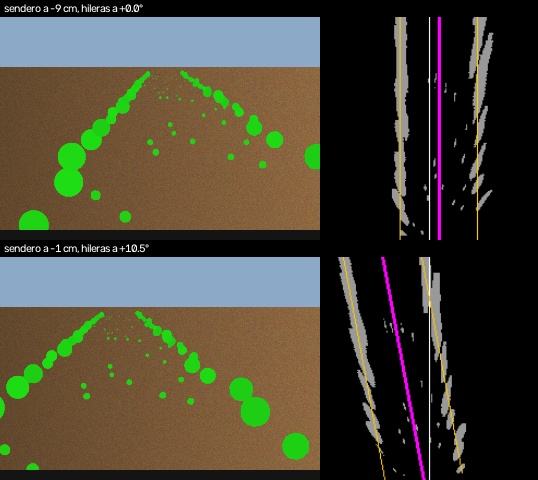
agrobot_system_2/docs/sendero/deteccion_hileras_verdes.jpg
