DAvolmx/AGROBOT_V1/agrobot_system_2/docs/sendero/deteccion_sintetica.jpg

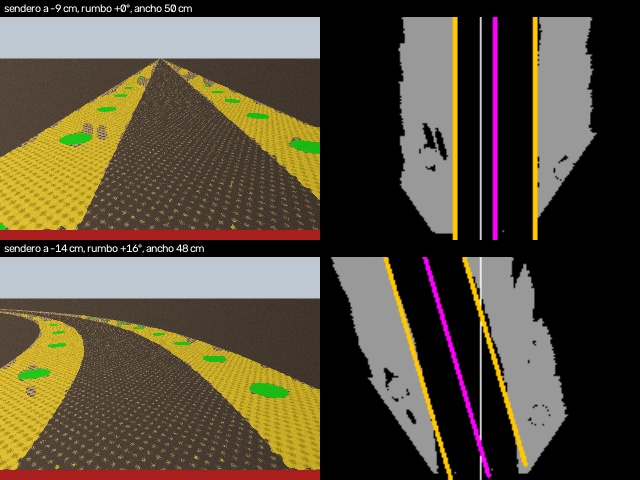
agrobot_system_2/docs/sendero/deteccion_sintetica.jpg
