DAvolmx/AGROBOT_V1/agrobot_system_2/docs/sendero/escena_y_mascara_paja.jpg

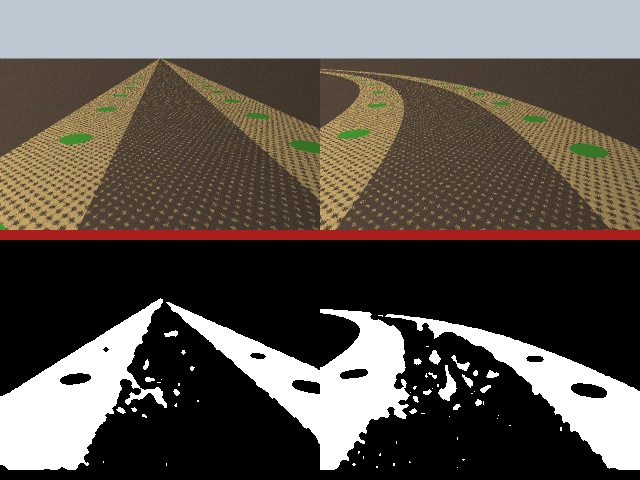
agrobot_system_2/docs/sendero/escena_y_mascara_paja.jpg
