DAvolmx/AGROBOT_V1/agrobot_system_2/docs/SESION_CAMPO_20261029/mosaico_video.jpg

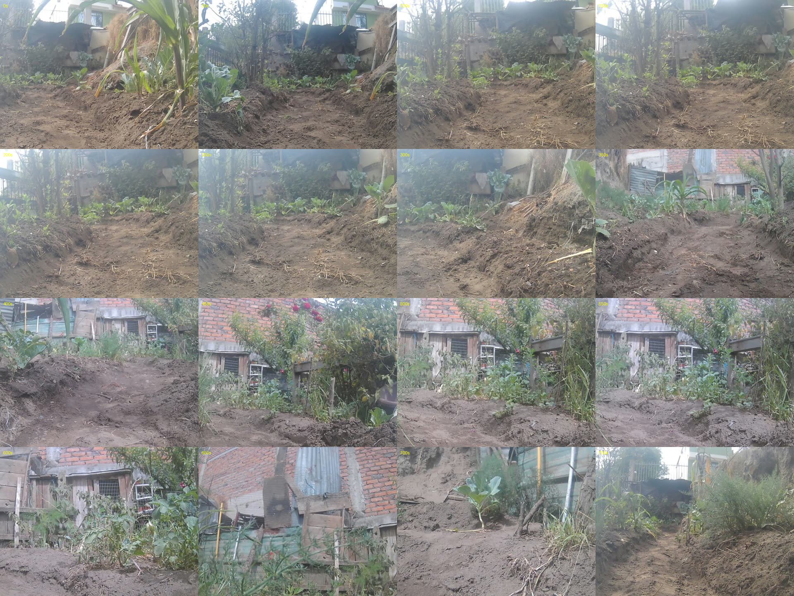
agrobot_system_2/docs/SESION_CAMPO_20261029/mosaico_video.jpg
