DAvolmx/AGROBOT_V1/agrobot_system_2/docs/suelo_foto_vs_real.png

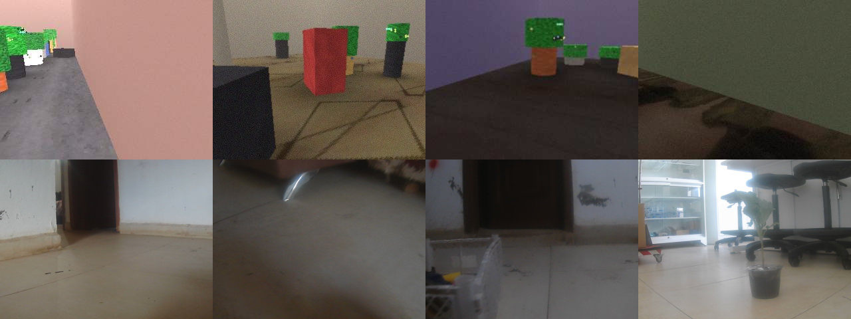
agrobot_system_2/docs/suelo_foto_vs_real.png
