DAvolmx/AGROBOT_V1/agrobot_system_2/docs/TESIS_COMPLEMENTO_20261102/figuras/evolucion.png

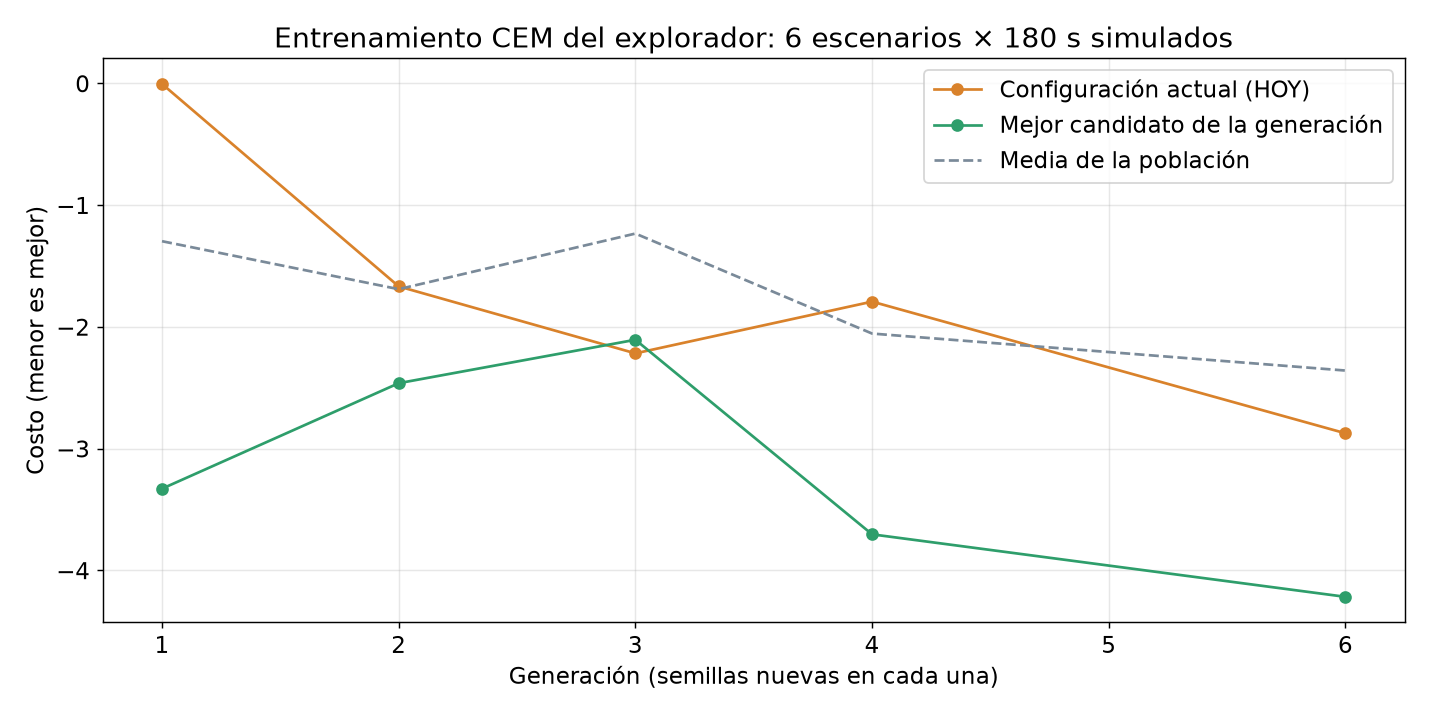
agrobot_system_2/docs/TESIS_COMPLEMENTO_20261102/figuras/evolucion.png
