DAvolmx/AGROBOT_V1/agrobot_system_2/docs/video_youtube/miniatura_parte3.png

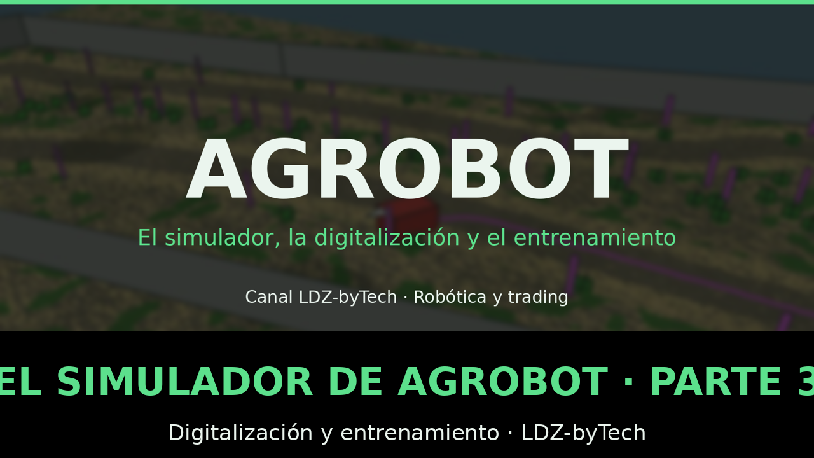
agrobot_system_2/docs/video_youtube/miniatura_parte3.png
