DAvolmx/AGROBOT_V1/agrobot_system_2/rpi/dashboard/vivo_20261102/assets/agrobot_invernadero.png

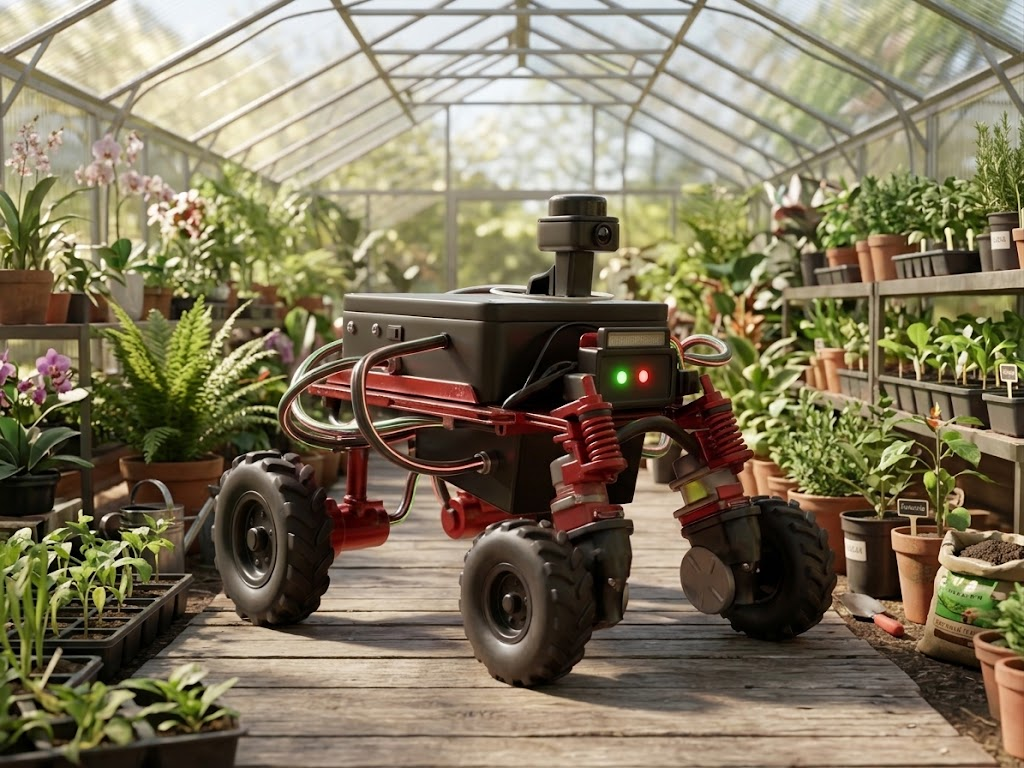
agrobot_system_2/rpi/dashboard/vivo_20261102/assets/agrobot_invernadero.png
