DAvolmx/AGROBOT_V1/agrobot_system_2/simulador_pasivo/gazebo/reportes/gazebo_camera_movimiento_3hz.png

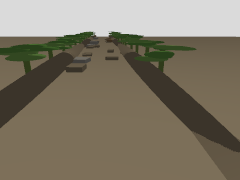
agrobot_system_2/simulador_pasivo/gazebo/reportes/gazebo_camera_movimiento_3hz.png
