DAvolmx/AGROBOT_V1/agrobot_system_2/tools/kaggle/campo_20261112/datos/arandano_negativos/images/vitro_2_11.jpg

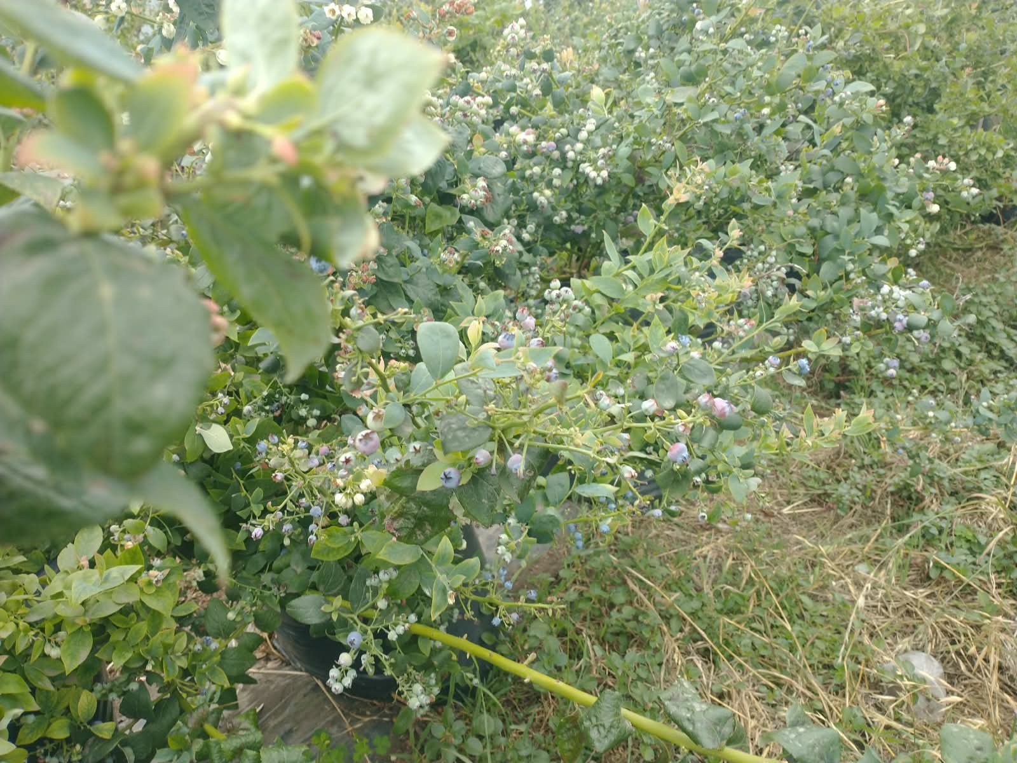
agrobot_system_2/tools/kaggle/campo_20261112/datos/arandano_negativos/images/vitro_2_11.jpg
