DAvolmx/AGROBOT_V1/agrobot_system_2/tools/kaggle/campo_20261112/datos/plagasx/images/train/campo20261112_1_aug01.jpg

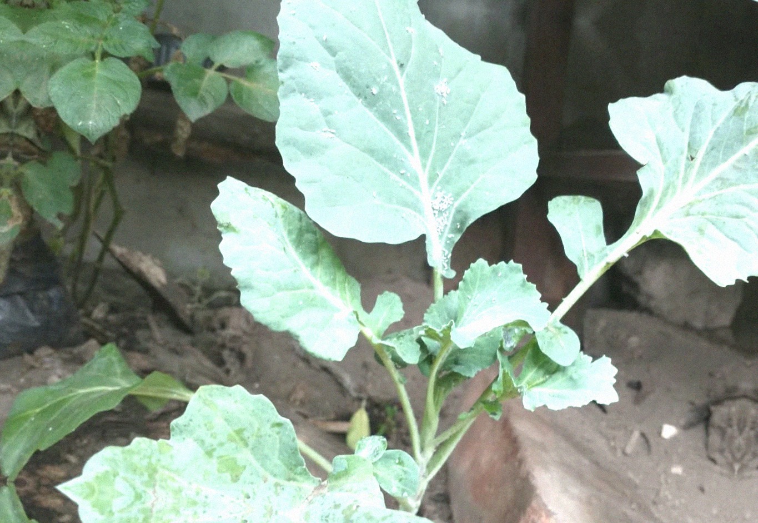
agrobot_system_2/tools/kaggle/campo_20261112/datos/plagasx/images/train/campo20261112_1_aug01.jpg
