DAvolmx/AGROBOT_V1/agrobot_system_2/tools/video_tesis/assets/fusion.png

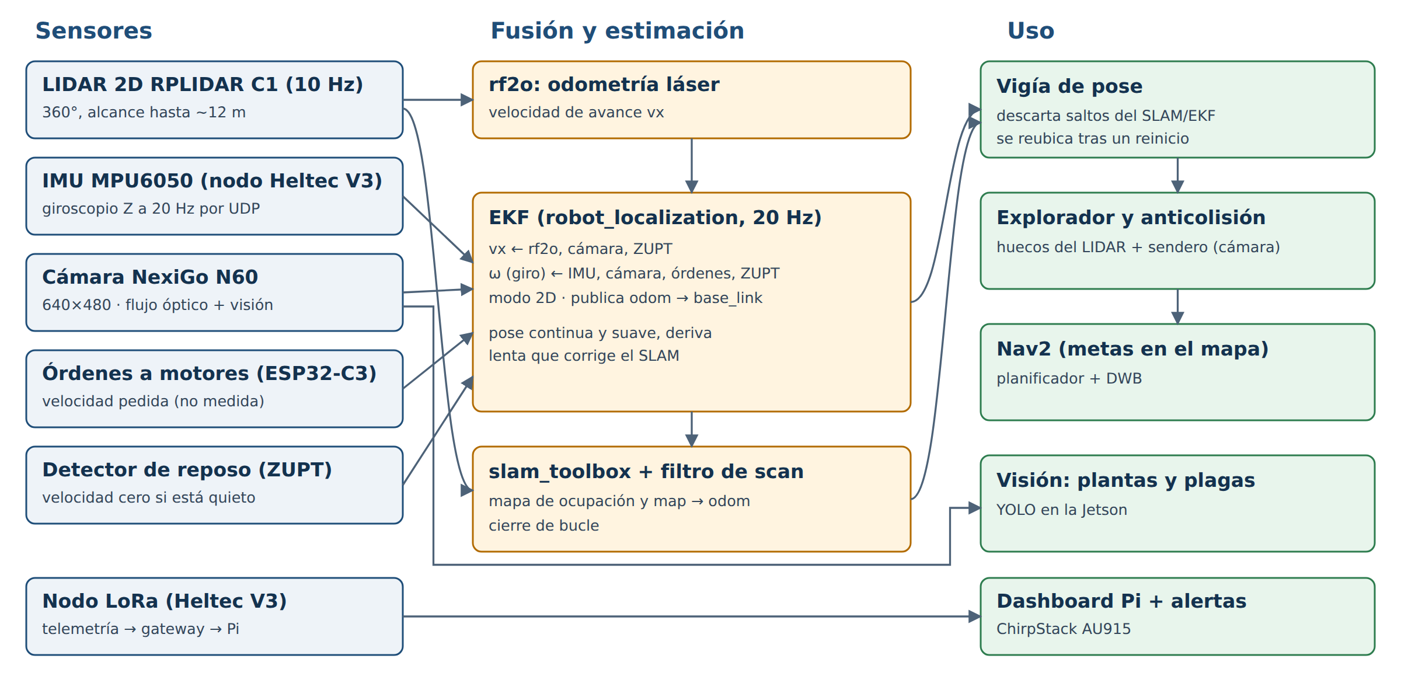
agrobot_system_2/tools/video_tesis/assets/fusion.png
