DAvolmx/AGROBOT_V1/agrobot_system_2/tools/video_tesis/assets/mapa_coles.png

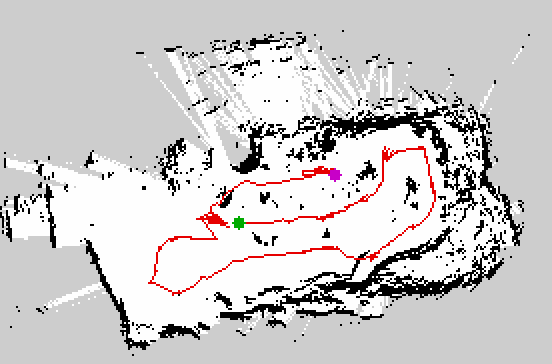
agrobot_system_2/tools/video_tesis/assets/mapa_coles.png
