DAvolmx/AGROBOT_V1/agrobot_system_2/tools/video_tesis/assets/precision_tam.png

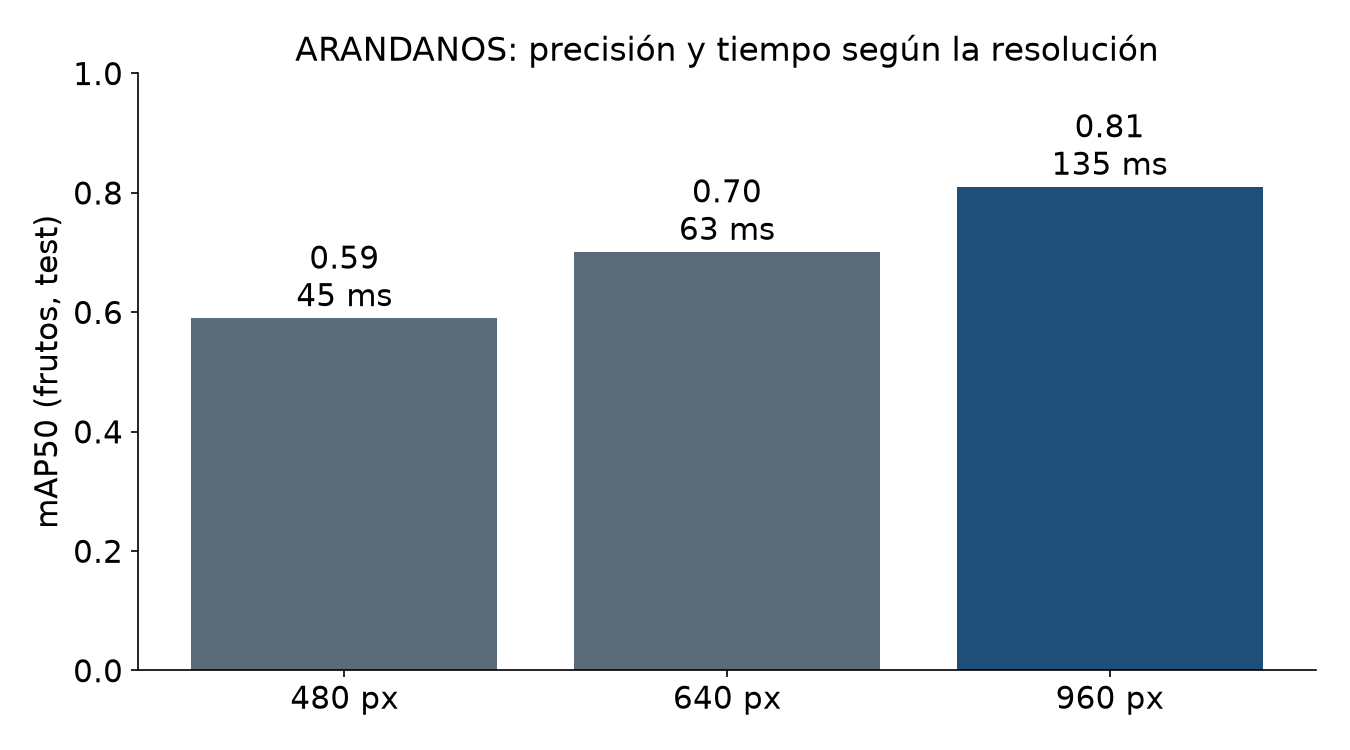
agrobot_system_2/tools/video_tesis/assets/precision_tam.png
