DAvolmx/AGROBOT_V1/agrobot_system_2/tools/video_tesis/assets/red_yolo11s.png

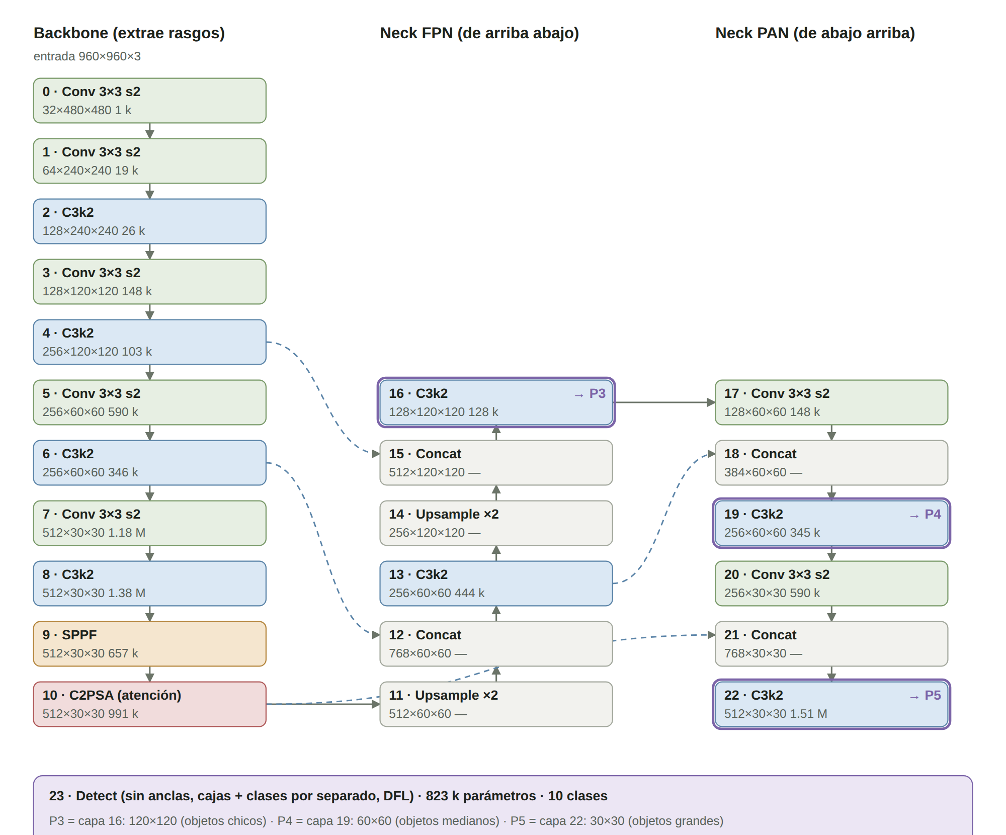
agrobot_system_2/tools/video_tesis/assets/red_yolo11s.png
