DAvolmx/AGROBOT_V1/agrobot_system_2/docs/digitalizacion/deriva_1pct/almacen_estanterias_s0/plano.dxf

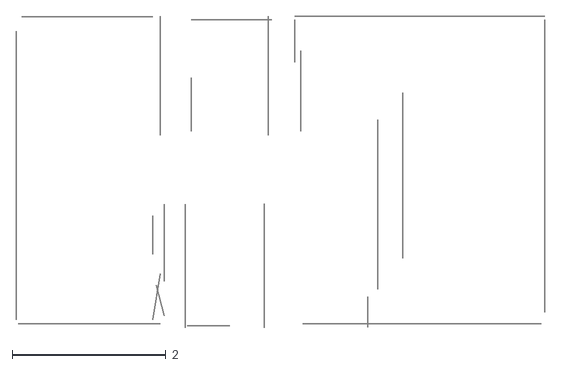
[picture p209: CAD file, 2026-10-24]
agrobot_system_2/docs/digitalizacion/deriva_1pct/almacen_estanterias_s0/plano.dxf
6.88 x 4.06
