DAvolmx/AGROBOT_V1/agrobot_system_2/docs/digitalizacion/deriva_1pct/laberinto_estrecho_s0/plano.dxf

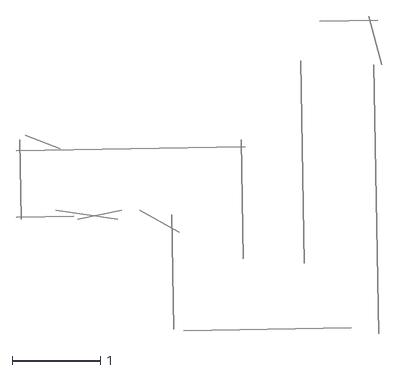
[picture p210: CAD file, 2026-10-24]
agrobot_system_2/docs/digitalizacion/deriva_1pct/laberinto_estrecho_s0/plano.dxf
4.15 x 3.60
