DAvolmx/AGROBOT_V1/agrobot_system_2/docs/digitalizacion/deriva_1pct/laberinto_serpiente_s0/plano.dxf

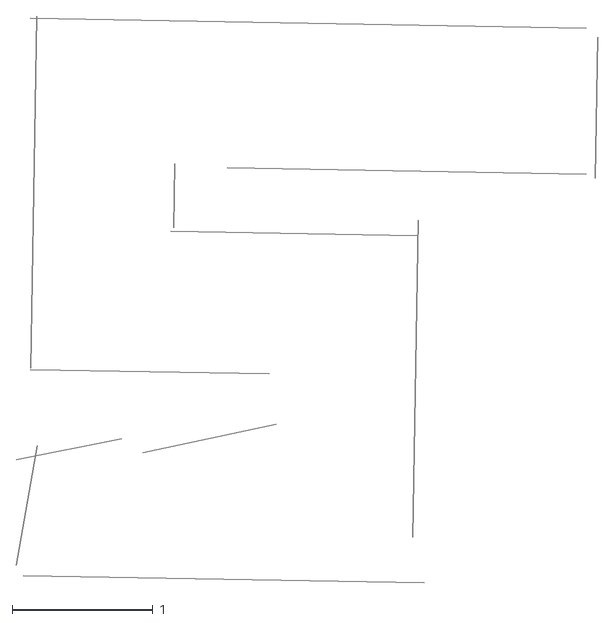
[picture p211: CAD file, 2026-10-24]
agrobot_system_2/docs/digitalizacion/deriva_1pct/laberinto_serpiente_s0/plano.dxf
4.13 x 4.03
