DAvolmx/AGROBOT_V1/agrobot_system_2/docs/digitalizacion/deriva_1pct/laboratorio_mesas_sillas_s0/plano.dxf

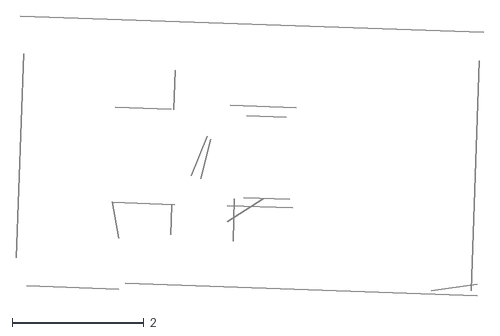
[picture p213: CAD file, 2026-10-24]
agrobot_system_2/docs/digitalizacion/deriva_1pct/laboratorio_mesas_sillas_s0/plano.dxf
7.10 x 4.25
