DAvolmx/AGROBOT_V1/agrobot_system_2/docs/digitalizacion/deriva_1pct/pasillo_L_s0/plano.dxf

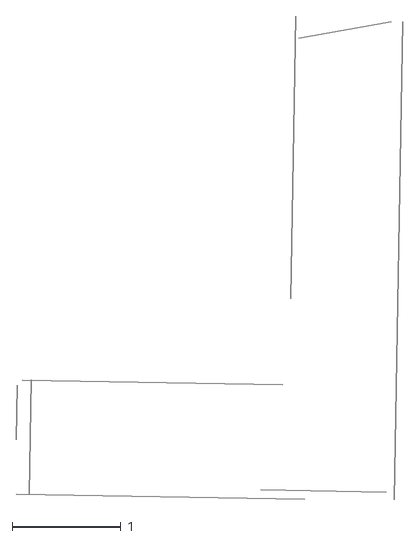
[picture p214: CAD file, 2026-10-24]
agrobot_system_2/docs/digitalizacion/deriva_1pct/pasillo_L_s0/plano.dxf
3.56 x 4.45
