DAvolmx/AGROBOT_V1/agrobot_system_2/docs/digitalizacion/deriva_1pct/pasillo_U_s0/plano.dxf

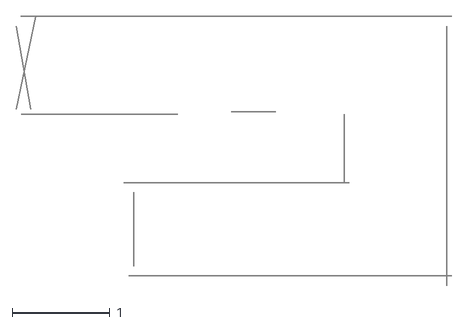
[picture p216: CAD file, 2026-10-24]
agrobot_system_2/docs/digitalizacion/deriva_1pct/pasillo_U_s0/plano.dxf
4.45 x 2.75
