DAvolmx/AGROBOT_V1/agrobot_system_2/docs/digitalizacion/deriva_3pct/almacen_estanterias_s0/plano.dxf

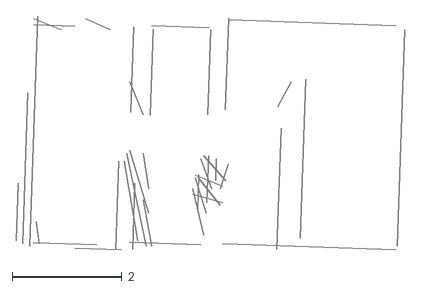
[picture p219: CAD file, 2026-10-24]
agrobot_system_2/docs/digitalizacion/deriva_3pct/almacen_estanterias_s0/plano.dxf
7.09 x 4.26
