DAvolmx/AGROBOT_V1/agrobot_system_2/docs/digitalizacion/deriva_3pct/laberinto_estrecho_s0/plano.dxf

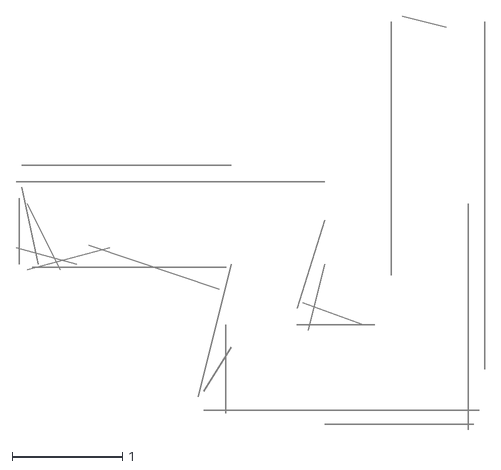
[picture p220: CAD file, 2026-10-24]
agrobot_system_2/docs/digitalizacion/deriva_3pct/laberinto_estrecho_s0/plano.dxf
4.25 x 3.75
