DAvolmx/AGROBOT_V1/agrobot_system_2/docs/digitalizacion/deriva_3pct/laberinto_serpiente_s0/plano.dxf

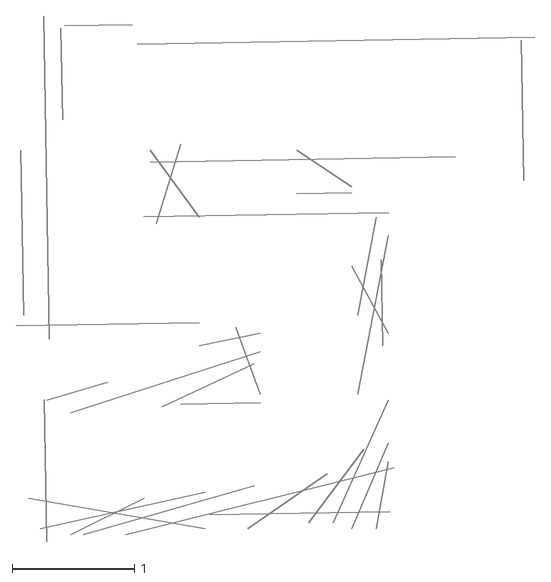
[picture p221: CAD file, 2026-10-24]
agrobot_system_2/docs/digitalizacion/deriva_3pct/laberinto_serpiente_s0/plano.dxf
4.25 x 4.31
