DAvolmx/AGROBOT_V1/agrobot_system_2/docs/digitalizacion/deriva_3pct/laboratorio_bancos_s0/plano.dxf

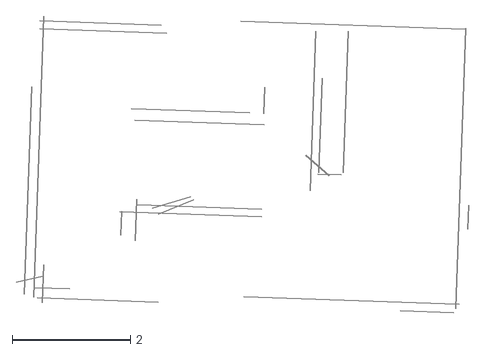
[picture p222: CAD file, 2026-10-24]
agrobot_system_2/docs/digitalizacion/deriva_3pct/laboratorio_bancos_s0/plano.dxf
7.66 x 5.02
