DAvolmx/AGROBOT_V1/agrobot_system_2/docs/digitalizacion/deriva_3pct/laboratorio_mesas_sillas_s0/plano.dxf

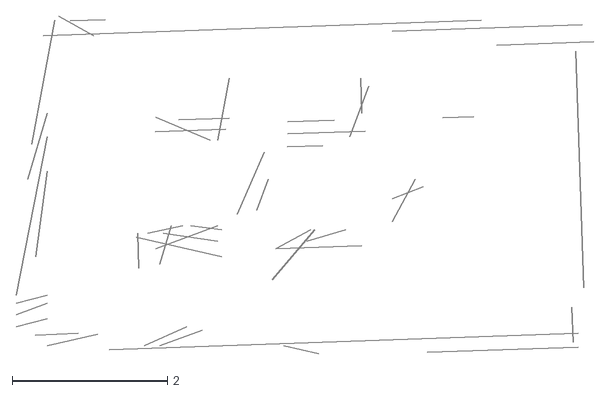
[picture p223: CAD file, 2026-10-24]
agrobot_system_2/docs/digitalizacion/deriva_3pct/laboratorio_mesas_sillas_s0/plano.dxf
7.45 x 4.35
