DAvolmx/AGROBOT_V1/agrobot_system_2/docs/digitalizacion/deriva_3pct/pasillo_L_s0/plano.dxf

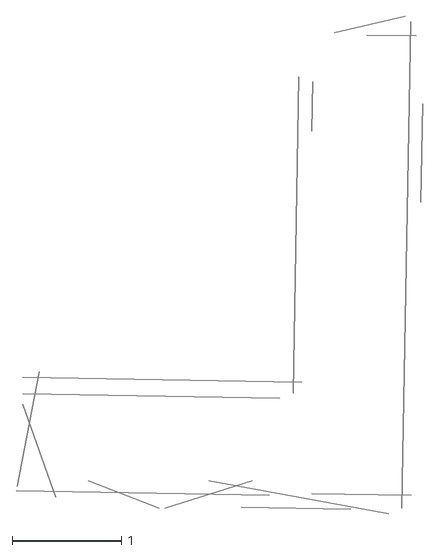
[picture p224: CAD file, 2026-10-24]
agrobot_system_2/docs/digitalizacion/deriva_3pct/pasillo_L_s0/plano.dxf
3.72 x 4.55
