DAvolmx/AGROBOT_V1/agrobot_system_2/docs/digitalizacion/deriva_3pct/pasillo_S_s0/plano.dxf

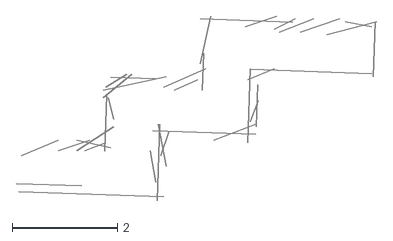
[picture p225: CAD file, 2026-10-24]
agrobot_system_2/docs/digitalizacion/deriva_3pct/pasillo_S_s0/plano.dxf
6.85 x 3.50
