DAvolmx/AGROBOT_V1/agrobot_system_2/docs/digitalizacion/deriva_3pct/pasillo_U_s0/plano.dxf

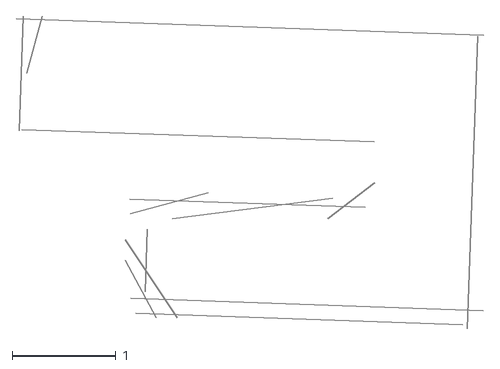
[picture p226: CAD file, 2026-10-24]
agrobot_system_2/docs/digitalizacion/deriva_3pct/pasillo_U_s0/plano.dxf
4.50 x 3.01
