DAvolmx/AGROBOT_V1/agrobot_system_2/docs/digitalizacion/deriva_3pct/puerta_descentrada_s0/plano.dxf

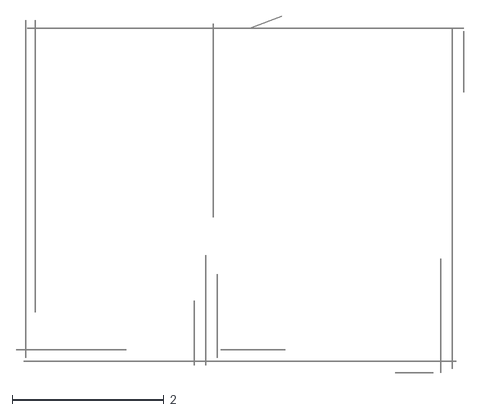
[picture p227: CAD file, 2026-10-24]
agrobot_system_2/docs/digitalizacion/deriva_3pct/puerta_descentrada_s0/plano.dxf
5.90 x 4.70
