DAvolmx/AGROBOT_V1/agrobot_system_2/docs/digitalizacion/deriva_3pct/sala_con_puerta_s0/plano.dxf

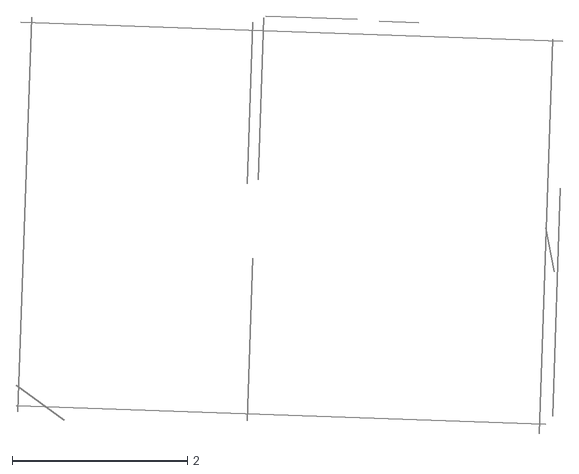
[picture p228: CAD file, 2026-10-24]
agrobot_system_2/docs/digitalizacion/deriva_3pct/sala_con_puerta_s0/plano.dxf
6.25 x 4.77
