DAvolmx/AGROBOT_V1/agrobot_system_2/docs/digitalizacion/sin_deriva/almacen_estanterias_s0/plano.dxf

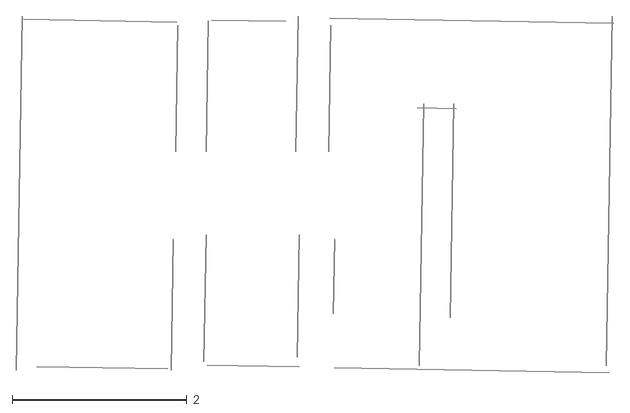
[picture p229: CAD file, 2026-10-24]
agrobot_system_2/docs/digitalizacion/sin_deriva/almacen_estanterias_s0/plano.dxf
6.83 x 4.08
