DAvolmx/AGROBOT_V1/agrobot_system_2/docs/digitalizacion/sin_deriva/laberinto_serpiente_s0/plano.dxf

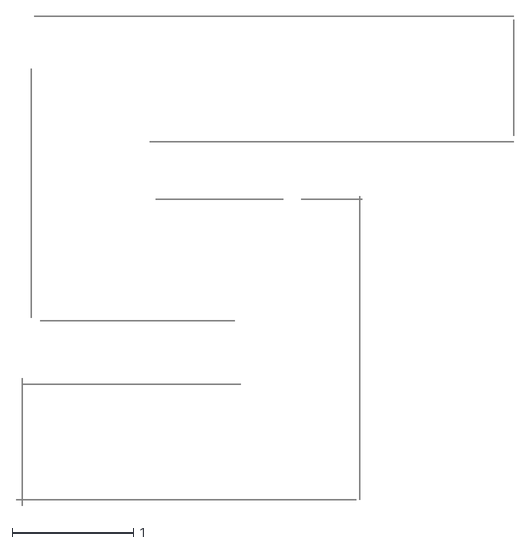
[picture p231: CAD file, 2026-10-24]
agrobot_system_2/docs/digitalizacion/sin_deriva/laberinto_serpiente_s0/plano.dxf
4.10 x 4.03
