DAvolmx/AGROBOT_V1/agrobot_system_2/docs/digitalizacion/sin_deriva/laboratorio_bancos_s0/plano.dxf

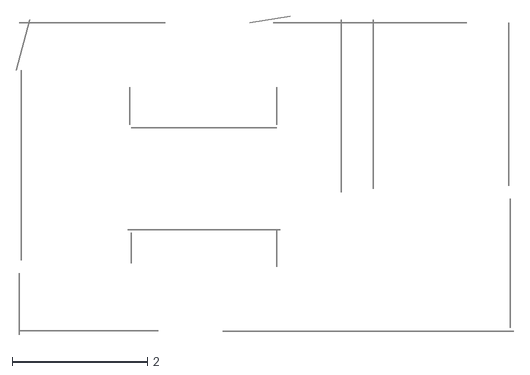
[picture p232: CAD file, 2026-10-24]
agrobot_system_2/docs/digitalizacion/sin_deriva/laboratorio_bancos_s0/plano.dxf
7.35 x 4.70
