DAvolmx/AGROBOT_V1/agrobot_system_2/docs/digitalizacion/sin_deriva/laboratorio_mesas_sillas_s0/plano.dxf

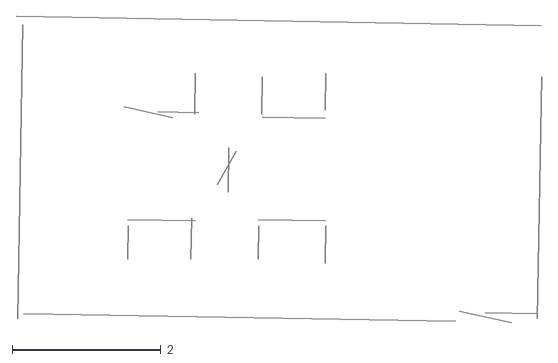
[picture p233: CAD file, 2026-10-24]
agrobot_system_2/docs/digitalizacion/sin_deriva/laboratorio_mesas_sillas_s0/plano.dxf
7.05 x 4.11
