DAvolmx/AGROBOT_V1/agrobot_system_2/docs/digitalizacion/sin_deriva/pasillo_L_s0/plano.dxf

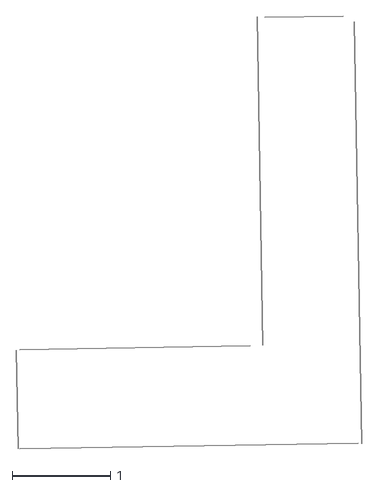
[picture p234: CAD file, 2026-10-24]
agrobot_system_2/docs/digitalizacion/sin_deriva/pasillo_L_s0/plano.dxf
3.52 x 4.41
