DAvolmx/AGROBOT_V1/agrobot_system_2/docs/digitalizacion/sin_deriva/pasillo_S_s0/plano.dxf

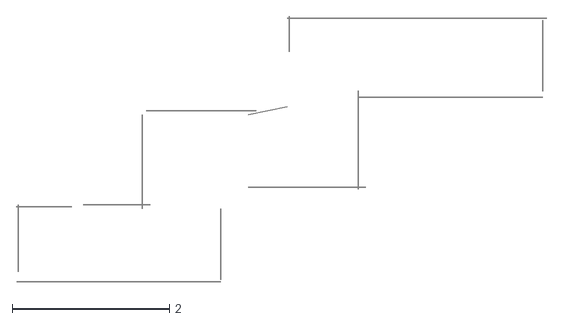
[picture p235: CAD file, 2026-10-24]
agrobot_system_2/docs/digitalizacion/sin_deriva/pasillo_S_s0/plano.dxf
6.75 x 3.38
