DAvolmx/AGROBOT_V1/agrobot_system_2/docs/digitalizacion/sin_deriva/pasillo_U_s0/plano.dxf

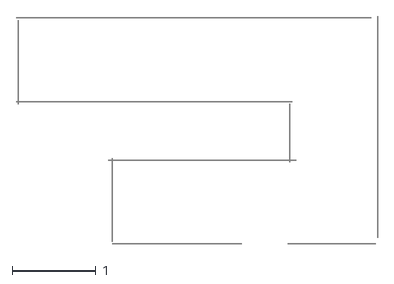
[picture p236: CAD file, 2026-10-24]
agrobot_system_2/docs/digitalizacion/sin_deriva/pasillo_U_s0/plano.dxf
4.33 x 2.73
