DAvolmx/AGROBOT_V1/agrobot_system_2/docs/digitalizacion/sin_deriva/puerta_descentrada_s0/plano.dxf

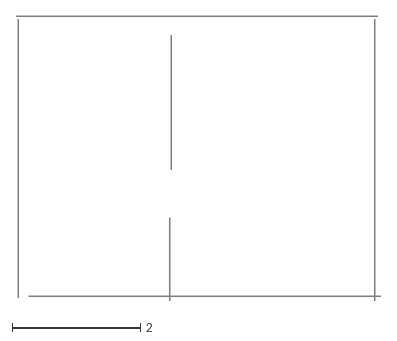
[picture p237: CAD file, 2026-10-24]
agrobot_system_2/docs/digitalizacion/sin_deriva/puerta_descentrada_s0/plano.dxf
5.70 x 4.45
