DAvolmx/AGROBOT_V1/agrobot_system_2/docs/digitalizacion/sin_deriva/sala_con_puerta_s0/plano.dxf

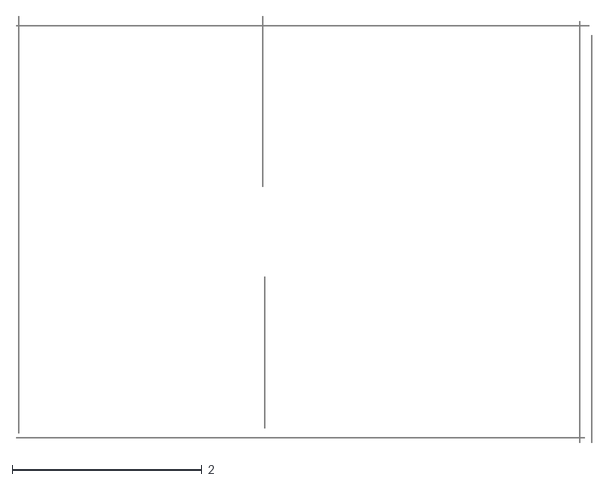
[picture p238: CAD file, 2026-10-24]
agrobot_system_2/docs/digitalizacion/sin_deriva/sala_con_puerta_s0/plano.dxf
6.08 x 4.50
