DAvolmx/AGROBOT_V1/agrobot_system_2/docs/INFORME_DASHBOARD/anotadas/04_navegacion_manual_limpia.png

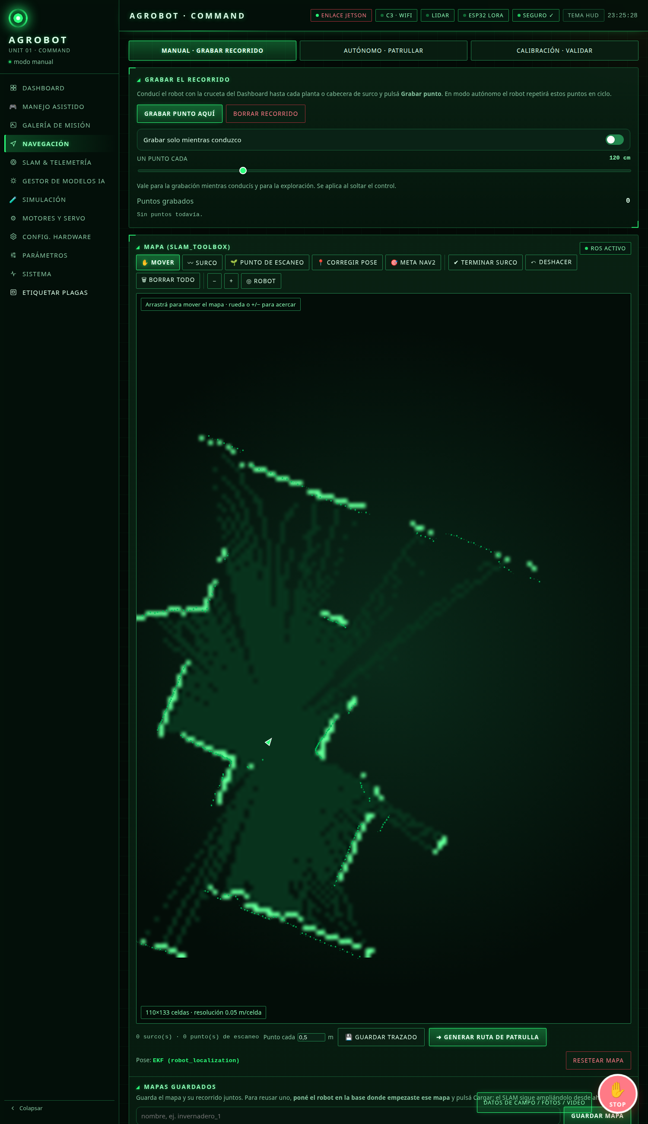
agrobot_system_2/docs/INFORME_DASHBOARD/anotadas/04_navegacion_manual_limpia.png
