DAvolmx/AGROBOT_V1/agrobot_system_2/simulador_pasivo/validacion_percepcion/salidas/montaje.png

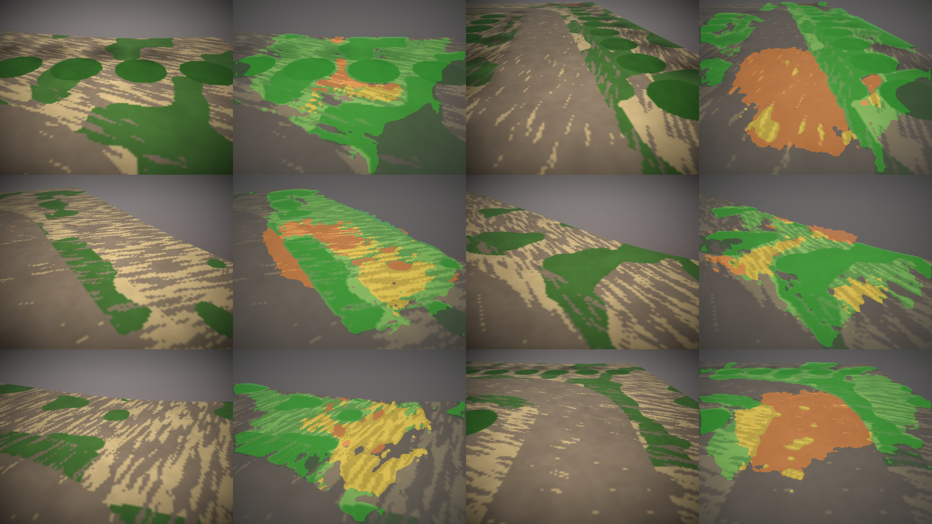
agrobot_system_2/simulador_pasivo/validacion_percepcion/salidas/montaje.png
