DAvolmx/AGROBOT_V1/agrobot_system_2/simulador_pasivo/resultados_pasivo_codex_20261011_rerun/baseline_seed1003.csv

time_s | x | y | yaw_rad | delta_rad | cross_track_m | slam_x | slam_y | slam_error_m | slip_mps | command_v | command_w
0.0 | -1.0454448200917392 | 1.2286284724315397 | 3.141592653589793 | 0.0 | 0.02137152756846028 | -1.0454448200917392 | 1.2286284724315397 | 0.0 | 0.0 | 0.0 | 0.0
0.05 | -1.0454448200917392 | 1.2286284724315397 | 3.141592653589793 | 0.0 | 0.02137152756846028 | -1.0454448200917392 | 1.2286284724315397 | 0.0 | 0.0 | 0.0 | 0.0
0.1 | -1.0466356754758501 | 1.228626118691968 | 3.141444296845051 | -0.0004148760990565271 | 0.021373881308031972 | -1.0465809189113677 | 1.2286285589075854 | 5.481091137879186e-05 | 0.0571814377009478 | 0.18044556395928923 | -0.07224500512934941
0.15000000000000002 | -1.0499566945315708 | 1.2286247731300877 | 3.141137450178448 | -0.0012760398327169064 | 0.021375226869912334 | -1.0497492345361241 | 1.228629540026011 | 0.00020751475371039198 | 0.04154551907079942 | 0.180445563959289 | -0.07224500512935024
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
