DAvolmx/AGROBOT_V1/agrobot_system_2/simulador_pasivo/resultados_pasivo_codex_20261011_rerun/trained_candidate_seed1003.csv

time_s | x | y | yaw_rad | delta_rad | cross_track_m | slam_x | slam_y | slam_error_m | slip_mps | command_v | command_w
0.0 | -1.0454448200917392 | 1.2286284724315397 | 3.141592653589793 | 0.0 | 0.02137152756846028 | -1.0454448200917392 | 1.2286284724315397 | 0.0 | 0.0 | 0.0 | 0.0
0.05 | -1.0454448200917392 | 1.2286284724315397 | 3.141592653589793 | 0.0 | 0.02137152756846028 | -1.0454448200917392 | 1.2286284724315397 | 0.0 | 0.0 | 0.0 | 0.0
0.1 | -1.0463615445875745 | 1.2286230812977437 | 3.1412547931664347 | -0.0011227291568414268 | 0.02137691870225633 | -1.046319391267193 | 1.2286286240335298 | 4.2516165621676385e-05 | 0.044067459151724636 | 0.1389072915204197 | -0.16871931270536678
0.15000000000000002 | -1.048918108322872 | 1.2286198466557758 | 3.1405719863371924 | -0.0038982680511295666 | 0.021380153344224162 | -1.0487583977187944 | 1.2286303240531218 | 0.00016005390626278677 | 0.03209158620640959 | 0.13890729152041964 | -0.16871931270536727
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
