DAvolmx/AGROBOT_V1/agrobot_system_2/simulador_pasivo/resultados_pasivo_prev_20261011/baseline_seed1003.csv

time_s | x | y | yaw_rad | delta_rad | cross_track_m | slam_x | slam_y | slam_error_m | slip_mps | command_v | command_w
0.0 | -1.0454448200917392 | 1.2286284724315397 | 3.141592653589793 | 0.0 | 0.02137152756846028 | -1.0454448200917392 | 1.2286284724315397 | 0.0 | 0.0 | 0.0 | 0.0
0.05 | -1.0454448200917392 | 1.2286284724315397 | 3.141592653589793 | 0.0 | 0.02137152756846028 | -1.0454448200917392 | 1.2286284724315397 | 0.0 | 0.0 | 0.0 | 0.0
0.1 | -1.0471334503434435 | 1.22862603903932 | 3.1414034170512872 | -0.0005222851899382226 | 0.021373960960680005 | -1.0470558056774044 | 1.2286286288431791 | 7.768784492024665e-05 | 0.04904948802849432 | 0.18044556395928923 | -0.07224500512934941
0.15000000000000002 | -1.0515729962990135 | 1.2286268586700073 | 3.1410631926063655 | -0.0015310413960119495 | 0.021373141329992684 | -1.0512912182886864 | 1.2286301906032289 | 0.0002817977091511767 | 0.030554080664293326 | 0.180445563959289 | -0.07224500512935024
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
