DAvolmx/AGROBOT_V1/agrobot_system_2/simulador_pasivo/resultados_pasivo_prev_20261011/trained_seed1001.csv

time_s | x | y | yaw_rad | delta_rad | cross_track_m | slam_x | slam_y | slam_error_m | slip_mps | command_v | command_w
0.0 | 2.0479773638723966 | -0.4164665666306729 | 1.5707963267948966 | 0.0 | 0.002022636127603228 | 2.0479773638723966 | -0.4164665666306729 | 0.0 | 0.0 | 0.0 | 0.0
0.05 | 2.0479773638723966 | -0.4164665666306729 | 1.5707963267948966 | 0.0 | 0.002022636127603228 | 2.0479773638723966 | -0.4164665666306729 | 0.0 | 0.0 | 0.0 | 0.0
0.1 | 2.0479773638723966 | -0.4164665666306729 | 1.5707963267948966 | 0.0 | 0.002022636127603228 | 2.0479773638723966 | -0.4164665666306729 | 0.0 | 0.0 | 0.0 | 0.0
0.15000000000000002 | 2.0479771372494135 | -0.41461335570947355 | 1.5707786839121805 | -4.234582010596424e-05 | 0.002022862750586274 | 2.0479773783975794 | -0.41456324425993507 | 5.0112029766171614e-05 | 0.053815738162608345 | 0.198032620102077 | -0.006623083600768798
0.2 | 2.0479772039839057 | -0.40974112551661246 | 1.5707464657430878 | -0.00010672079085150404 | 0.0020227960160941194 | 2.047977524508976 | -0.40955926730947084 | 0.00018185848960409811 | 0.0335022793196463 | 0.198032620102077 | -0.006623083600768798
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
