DAvolmx/AGROBOT_V1/agrobot_system_2/simulador_pasivo/resultados_pasivo_prev_20261011/trained_seed1002.csv

time_s | x | y | yaw_rad | delta_rad | cross_track_m | slam_x | slam_y | slam_error_m | slip_mps | command_v | command_w
0.0 | -0.9662937807141978 | -1.2301730605402454 | 0.0 | 0.0 | 0.019826939459754556 | -0.9662937807141978 | -1.2301730605402454 | 0.0 | 0.0 | 0.0 | 0.0
0.05 | -0.9645823882269065 | -1.2301709529781024 | -0.00016391015128321723 | -0.00044356866642504534 | 0.019829047021897583 | -0.9645679550175226 | -1.230173201260802 | 1.4607269019775245e-05 | 0.04970709415470283 | 0.1828779435329922 | -0.06241706403090243
0.1 | -0.9600830015095538 | -1.2301716442159352 | -0.0004595721785352827 | -0.0012695045773147872 | 0.019828355784064833 | -0.9600306216319702 | -1.2301746085378833 | 5.246369011317974e-05 | 0.030958629231624717 | 0.1828779435329922 | -0.06241706403090244
0.15000000000000002 | -0.9538440504283454 | -1.2301781833950471 | -0.0007858199584291992 | -0.0022095648098250163 | 0.019821816604952858 | -0.9537390502901502 | -1.2301785063424593 | 0.00010500063483643141 | 0.019287815676632694 | 0.18285600137235034 | -0.06250455184765594
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
