DAvolmx/AGROBOT_V1/agrobot_system_2/models/runs/cls_ccmt/results.csv

epoch | time | train/loss | metrics/accuracy_top1 | metrics/accuracy_top5 | val/loss | lr/pg0 | lr/pg1 | lr/pg2
1 | 39.3656 | 0.45042 | 0.98474 | 1 | 0.04367 | 0.000302305 | 0.000302305 | 0.000302305
2 | 75.4541 | 0.15438 | 0.98038 | 1 | 0.03779 | 0.000581335 | 0.000581335 | 0.000581335
3 | 111.477 | 0.17158 | 0.99273 | 1 | 0.03006 | 0.000836367 | 0.000836367 | 0.000836367
4 | 148.212 | 0.11644 | 0.98765 | 1 | 0.0311 | 0.000801011 | 0.000801011 | 0.000801011
5 | 183.389 | 0.08688 | 0.99564 | 1 | 0.01361 | 0.000765014 | 0.000765014 | 0.000765014
6 | 218.96 | 0.0831 | 0.98837 | 1 | 0.03478 | 0.000729018 | 0.000729018 | 0.000729018
7 | 254.887 | 0.07052 | 0.99055 | 1 | 0.02514 | 0.000693022 | 0.000693022 | 0.000693022
8 | 290.315 | 0.053 | 0.99637 | 1 | 0.01252 | 0.000657025 | 0.000657025 | 0.000657025
9 | 325.923 | 0.04022 | 0.99491 | 1 | 0.01669 | 0.000621029 | 0.000621029 | 0.000621029
10 | 361.821 | 0.04019 | 0.99419 | 1 | 0.01976 | 0.000585032 | 0.000585032 | 0.000585032
11 | 397.157 | 0.04674 | 0.99564 | 1 | 0.01144 | 0.000549036 | 0.000549036 | 0.000549036
12 | 432.087 | 0.04051 | 0.99419 | 1 | 0.01474 | 0.00051304 | 0.00051304 | 0.00051304
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
