DAvolmx/AGROBOT_V1/agrobot_system_2/models/runs/det_plagas/results.csv

epoch | time | train/box_loss | train/cls_loss | train/dfl_loss | metrics/precision(B) | metrics/recall(B) | metrics/mAP50(B) | metrics/mAP50-95(B) | val/box_loss | val/cls_loss | val/dfl_loss | lr/pg0 | lr/pg1 | lr/pg2
1 | 104.13 | 1.54852 | 2.47729 | 1.75114 | 0.41055 | 0.53048 | 0.45495 | 0.21046 | 1.75041 | 6.74666 | 2.24602 | 0.000331667 | 0.000331667 | 0.000331667
2 | 153.596 | 1.65525 | 1.85734 | 1.80073 | 0.44317 | 0.29096 | 0.25337 | 0.0875 | 2.1209 | 5.1205 | 2.50154 | 0.000648541 | 0.000648541 | 0.000648541
3 | 203.509 | 1.66105 | 1.84974 | 1.81196 | 0.38705 | 0.44747 | 0.3621 | 0.1556 | 1.8804 | 3.35899 | 2.2637 | 0.000948916 | 0.000948916 | 0.000948916
4 | 253.59 | 1.63662 | 1.85455 | 1.78362 | 0.36396 | 0.3533 | 0.29227 | 0.12928 | 1.76866 | 3.97305 | 2.20551 | 0.00092575 | 0.00092575 | 0.00092575
5 | 303.867 | 1.6072 | 1.75324 | 1.75701 | 0.60069 | 0.59297 | 0.63062 | 0.30564 | 1.59666 | 3.66153 | 1.97399 | 0.000901 | 0.000901 | 0.000901
6 | 354.235 | 1.55155 | 1.6245 | 1.71221 | 0.65971 | 0.49444 | 0.5801 | 0.27675 | 1.60369 | 2.82599 | 1.9706 | 0.00087625 | 0.00087625 | 0.00087625
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
