DAvolmx/AGROBOT_V1/agrobot_system_2/simulador_pasivo/percepcion_sintetica/modelos/yolo_respaldo_20261028/col/results.csv

epoch | time | train/box_loss | train/cls_loss | train/dfl_loss | metrics/precision(B) | metrics/recall(B) | metrics/mAP50(B) | metrics/mAP50-95(B) | val/box_loss | val/cls_loss | val/dfl_loss | lr/pg0 | lr/pg1 | lr/pg2
1 | 66.8137 | 2.30236 | 2.71611 | 1.80976 | 0.33734 | 0.31435 | 0.26725 | 0.08186 | 2.33943 | 2.19473 | 1.85349 | 0.000472805 | 0.000472805 | 0.000472805
2 | 118.999 | 2.14717 | 1.91577 | 1.66022 | 0.29033 | 0.39992 | 0.28141 | 0.09977 | 2.21783 | 2.03101 | 1.74943 | 0.000911552 | 0.000911552 | 0.000911552
3 | 171.235 | 2.09766 | 1.82106 | 1.65143 | 0.37695 | 0.39887 | 0.33888 | 0.11746 | 2.20536 | 1.89635 | 1.75106 | 0.00131257 | 0.00131257 | 0.00131257
4 | 222.73 | 2.07452 | 1.77912 | 1.62843 | 0.25905 | 0.37486 | 0.23452 | 0.07681 | 2.23391 | 2.09237 | 1.87402 | 0.00125923 | 0.00125923 | 0.00125923
5 | 274.647 | 2.04542 | 1.73544 | 1.60714 | 0.39783 | 0.40671 | 0.3612 | 0.12629 | 2.18476 | 1.85501 | 1.71973 | 0.00120265 | 0.00120265 | 0.00120265
6 | 326.153 | 2.04801 | 1.73077 | 1.60908 | 0.40946 | 0.41114 | 0.35301 | 0.12322 | 2.15767 | 1.82482 | 1.70955 | 0.00114606 | 0.00114606 | 0.00114606
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
