DAvolmx/AGROBOT_V1/agrobot_system_2/simulador_pasivo/percepcion_sintetica/modelos/yolo_respaldo_20261028/col_10h/results.csv

epoch | time | train/box_loss | train/cls_loss | train/dfl_loss | metrics/precision(B) | metrics/recall(B) | metrics/mAP50(B) | metrics/mAP50-95(B) | val/box_loss | val/cls_loss | val/dfl_loss | lr/pg0 | lr/pg1 | lr/pg2
1 | 86.5379 | 2.20524 | 2.15537 | 1.9362 | 0.38764 | 0.39179 | 0.34314 | 0.11348 | 2.21183 | 1.99523 | 1.88167 | 0.000472805 | 0.000472805 | 0.000472805
2 | 159.201 | 2.06895 | 1.83799 | 1.7563 | 0.41162 | 0.44011 | 0.36452 | 0.12486 | 2.14121 | 2.15238 | 1.81556 | 0.000925647 | 0.000925647 | 0.000925647
3 | 230.987 | 2.06695 | 1.78089 | 1.73891 | 0.56647 | 0.41553 | 0.34651 | 0.11779 | 2.16831 | 1.82319 | 1.81782 | 0.00135491 | 0.00135491 | 0.00135491
4 | 302.552 | 2.03569 | 1.7461 | 1.6934 | 0.66128 | 0.39221 | 0.3683 | 0.13283 | 2.15433 | 1.80304 | 1.80761 | 0.0013229 | 0.0013229 | 0.0013229
5 | 374.373 | 2.02582 | 1.70417 | 1.67819 | 0.72012 | 0.43298 | 0.4 | 0.13879 | 2.14722 | 1.83676 | 1.79078 | 0.00128753 | 0.00128753 | 0.00128753
6 | 446.121 | 2.03048 | 1.69457 | 1.68679 | 0.51071 | 0.42604 | 0.37154 | 0.13242 | 2.13885 | 1.78844 | 1.79069 | 0.00125216 | 0.00125216 | 0.00125216
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
