DAvolmx/AGROBOT_V1/agrobot_system_2/simulador_pasivo/percepcion_sintetica/modelos/yolo_respaldo_20261028/col_plagas_v2/results.csv

epoch | time | train/box_loss | train/cls_loss | train/dfl_loss | metrics/precision(B) | metrics/recall(B) | metrics/mAP50(B) | metrics/mAP50-95(B) | val/box_loss | val/cls_loss | val/dfl_loss | lr/pg0 | lr/pg1 | lr/pg2
1 | 122.378 | 2.32486 | 2.76626 | 1.77163 | 0.30087 | 0.40633 | 0.28031 | 0.09699 | 1.90455 | 25.0245 | 1.60592 | 0.000413411 | 0.000413411 | 0.000413411
2 | 216.655 | 2.18041 | 1.96172 | 1.65369 | 0.37266 | 0.33544 | 0.30446 | 0.10401 | 1.89693 | 21.6099 | 1.56349 | 0.000809534 | 0.000809534 | 0.000809534
3 | 309.843 | 2.16012 | 1.89985 | 1.65415 | 0.29201 | 0.30452 | 0.22602 | 0.07131 | 1.9657 | 18.1643 | 1.57133 | 0.00118503 | 0.00118503 | 0.00118503
4 | 397.648 | 2.14063 | 1.86785 | 1.64249 | 0.43392 | 0.39292 | 0.34454 | 0.12805 | 1.85702 | 11.3425 | 1.5549 | 0.00115719 | 0.00115719 | 0.00115719
5 | 484.021 | 2.1163 | 1.81503 | 1.61922 | 0.28915 | 0.32706 | 0.22839 | 0.07527 | 1.93506 | 13.1486 | 1.55069 | 0.00112625 | 0.00112625 | 0.00112625
6 | 570.294 | 2.11664 | 1.78571 | 1.62601 | 0.44589 | 0.37718 | 0.38183 | 0.14458 | 1.81336 | 7.95241 | 1.54461 | 0.00109531 | 0.00109531 | 0.00109531
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
