DAvolmx/AGROBOT_V1/agrobot_system_2/simulador_pasivo/percepcion_sintetica/modelos/yolo_respaldo_20261028/col_s/results.csv

epoch | time | train/box_loss | train/cls_loss | train/dfl_loss | metrics/precision(B) | metrics/recall(B) | metrics/mAP50(B) | metrics/mAP50-95(B) | val/box_loss | val/cls_loss | val/dfl_loss | lr/pg0 | lr/pg1 | lr/pg2
1 | 87.577 | 2.20524 | 2.15537 | 1.9362 | 0.38764 | 0.39179 | 0.34314 | 0.11348 | 2.21183 | 1.99523 | 1.88167 | 0.000472805 | 0.000472805 | 0.000472805
2 | 160.541 | 2.07181 | 1.84103 | 1.75947 | 0.31782 | 0.43912 | 0.34604 | 0.11677 | 2.17056 | 2.20741 | 1.84261 | 0.000933477 | 0.000933477 | 0.000933477
3 | 233.038 | 2.05889 | 1.77165 | 1.73151 | 0.45253 | 0.39692 | 0.34729 | 0.11996 | 2.1858 | 1.88341 | 1.83078 | 0.00137843 | 0.00137843 | 0.00137843
4 | 305.751 | 2.04183 | 1.7732 | 1.71028 | 0.50769 | 0.4071 | 0.3764 | 0.13216 | 2.15341 | 1.80439 | 1.821 | 0.00135826 | 0.00135826 | 0.00135826
5 | 378.015 | 2.02432 | 1.70639 | 1.68572 | 0.65815 | 0.39406 | 0.3225 | 0.10853 | 2.1743 | 1.96985 | 1.82099 | 0.00133469 | 0.00133469 | 0.00133469
6 | 450.647 | 2.03585 | 1.69937 | 1.68803 | 0.66052 | 0.39984 | 0.34671 | 0.11994 | 2.1746 | 1.80802 | 1.84404 | 0.00131111 | 0.00131111 | 0.00131111
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
