DAvolmx/AGROBOT_V1/agrobot_system_2/simulador_pasivo/percepcion_sintetica/modelos/yolo_respaldo_20261028/medicinales/results.csv

epoch | time | train/loss | metrics/accuracy_top1 | metrics/accuracy_top5 | val/loss | lr/pg0 | lr/pg1 | lr/pg2
1 | 56.8349 | 4.60597 | 0.079 | 0.275 | 4.16684 | 2.90074e-05 | 2.90074e-05 | 2.90074e-05
2 | 112.604 | 3.56795 | 0.501 | 0.734 | 2.73262 | 5.64155e-05 | 5.64155e-05 | 5.64155e-05
3 | 161.424 | 2.19482 | 0.728 | 0.842 | 1.42293 | 8.18876e-05 | 8.18876e-05 | 8.18876e-05
4 | 208.9 | 1.32295 | 0.788 | 0.869 | 1.03069 | 7.9288e-05 | 7.9288e-05 | 7.9288e-05
5 | 254.132 | 1.00304 | 0.819 | 0.89 | 0.87209 | 7.6384e-05 | 7.6384e-05 | 7.6384e-05
6 | 299.771 | 0.8145 | 0.836 | 0.908 | 0.74621 | 7.348e-05 | 7.348e-05 | 7.348e-05
7 | 347.295 | 0.71273 | 0.843 | 0.925 | 0.66302 | 7.0576e-05 | 7.0576e-05 | 7.0576e-05
8 | 394.175 | 0.61683 | 0.872 | 0.941 | 0.56858 | 6.7672e-05 | 6.7672e-05 | 6.7672e-05
9 | 441.056 | 0.52802 | 0.875 | 0.949 | 0.52345 | 6.4768e-05 | 6.4768e-05 | 6.4768e-05
10 | 489.892 | 0.46258 | 0.888 | 0.962 | 0.47027 | 6.1864e-05 | 6.1864e-05 | 6.1864e-05
11 | 537.694 | 0.41055 | 0.896 | 0.965 | 0.43369 | 5.896e-05 | 5.896e-05 | 5.896e-05
12 | 585.143 | 0.36074 | 0.901 | 0.968 | 0.40159 | 5.6056e-05 | 5.6056e-05 | 5.6056e-05
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
