DAvolmx/AGROBOT_V1/agrobot_system_2/simulador_pasivo/percepcion_sintetica/modelos/yolo_respaldo_20261028/obj/results.csv

epoch | time | train/box_loss | train/cls_loss | train/dfl_loss | metrics/precision(B) | metrics/recall(B) | metrics/mAP50(B) | metrics/mAP50-95(B) | val/box_loss | val/cls_loss | val/dfl_loss | lr/pg0 | lr/pg1 | lr/pg2
1 | 61.051 | 0.98294 | 1.77955 | 1.00723 | 0.71596 | 0.53962 | 0.60575 | 0.44948 | 0.84353 | 1.30667 | 0.90521 | 0.000472364 | 0.000472364 | 0.000472364
2 | 108.489 | 0.90083 | 0.94518 | 0.98956 | 0.76816 | 0.62297 | 0.71845 | 0.52819 | 0.77773 | 0.87293 | 0.89811 | 0.000933044 | 0.000933044 | 0.000933044
3 | 155.077 | 0.86544 | 0.85055 | 0.97949 | 0.63122 | 0.60023 | 0.61675 | 0.4468 | 0.81649 | 1.19141 | 0.91601 | 0.001378 | 0.001378 | 0.001378
4 | 201.762 | 0.87742 | 0.81711 | 0.98727 | 0.62814 | 0.51205 | 0.5669 | 0.3916 | 0.83575 | 1.28312 | 0.94074 | 0.00135826 | 0.00135826 | 0.00135826
5 | 247.159 | 0.84081 | 0.75942 | 0.97537 | 0.72183 | 0.60389 | 0.69189 | 0.51973 | 0.75141 | 0.78382 | 0.90026 | 0.00133469 | 0.00133469 | 0.00133469
6 | 292.625 | 0.82057 | 0.71556 | 0.96448 | 0.76341 | 0.69391 | 0.75238 | 0.58088 | 0.71086 | 0.69119 | 0.88964 | 0.00131111 | 0.00131111 | 0.00131111
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
