DAvolmx/AGROBOT_V1/agrobot_system_2/simulador_pasivo/percepcion_sintetica/modelos/yolo_respaldo_20261028/plagas/results.csv

epoch | time | train/box_loss | train/cls_loss | train/dfl_loss | metrics/precision(B) | metrics/recall(B) | metrics/mAP50(B) | metrics/mAP50-95(B) | val/box_loss | val/cls_loss | val/dfl_loss | lr/pg0 | lr/pg1 | lr/pg2
1 | 93.536 | 1.59277 | 2.44611 | 1.06413 | 0.85589 | 0.38057 | 0.73432 | 0.44448 | 1.28751 | 2.52085 | 1.00025 | 0.000472118 | 0.000472118 | 0.000472118
2 | 162.468 | 1.34331 | 1.36258 | 1.00552 | 0.85151 | 0.76783 | 0.8219 | 0.52033 | 1.11494 | 1.07204 | 0.98899 | 0.000927585 | 0.000927585 | 0.000927585
3 | 230.807 | 1.27185 | 1.13292 | 0.98517 | 0.86646 | 0.80449 | 0.84914 | 0.54833 | 1.05838 | 0.9226 | 0.97818 | 0.00136209 | 0.00136209 | 0.00136209
4 | 298.305 | 1.2473 | 0.98022 | 0.99287 | 0.88431 | 0.79899 | 0.84987 | 0.54446 | 1.0338 | 0.89012 | 0.96321 | 0.00133469 | 0.00133469 | 0.00133469
5 | 365.611 | 1.20784 | 0.89951 | 0.9947 | 0.84084 | 0.82327 | 0.83608 | 0.56582 | 0.98198 | 0.74116 | 0.95697 | 0.00130325 | 0.00130325 | 0.00130325
6 | 436.687 | 1.19211 | 0.82635 | 0.98383 | 0.86032 | 0.80997 | 0.86196 | 0.57305 | 0.97914 | 0.71264 | 0.94718 | 0.00127181 | 0.00127181 | 0.00127181
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
