DAvolmx/AGROBOT_V1/agrobot_system_2/simulador_pasivo/percepcion_sintetica/modelos/yolo_respaldo_20261028/whitefly/results.csv

epoch | time | train/box_loss | train/cls_loss | train/dfl_loss | metrics/precision(B) | metrics/recall(B) | metrics/mAP50(B) | metrics/mAP50-95(B) | val/box_loss | val/cls_loss | val/dfl_loss | lr/pg0 | lr/pg1 | lr/pg2
1 | 113.397 | 2.34395 | 4.85442 | 1.42509 | 0.47604 | 0.48305 | 0.40676 | 0.14415 | 2.2466 | 3.34681 | 1.46445 | 0.000663978 | 0.000663978 | 0.000663978
2 | 202.566 | 2.26759 | 3.03536 | 1.47441 | 0.36888 | 0.49492 | 0.33925 | 0.13002 | 2.15101 | 2.3553 | 1.56027 | 0.00127795 | 0.00127795 | 0.00127795
3 | 291.214 | 2.27294 | 2.3324 | 1.48309 | 0.46601 | 0.48136 | 0.4315 | 0.16418 | 2.16875 | 1.96523 | 1.47013 | 0.00183912 | 0.00183912 | 0.00183912
4 | 379.972 | 2.2259 | 2.01146 | 1.4596 | 0.45696 | 0.48305 | 0.37218 | 0.14556 | 2.11462 | 2.09158 | 1.47974 | 0.0017624 | 0.0017624 | 0.0017624
5 | 468.055 | 2.25438 | 2.00347 | 1.4603 | 0.44041 | 0.5149 | 0.38548 | 0.1551 | 2.05665 | 1.77509 | 1.46233 | 0.0016832 | 0.0016832 | 0.0016832
6 | 556.073 | 2.20489 | 1.95022 | 1.47608 | 0.54016 | 0.54915 | 0.4636 | 0.17283 | 2.12291 | 1.73933 | 1.476 | 0.001604 | 0.001604 | 0.001604
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
