DAvolmx/AGROBOT_V1/agrobot_system_2/simulador_pasivo/percepcion_sintetica/modelos/yolo_respaldo_20261028/whitefly_s/results.csv

epoch | time | train/box_loss | train/cls_loss | train/dfl_loss | metrics/precision(B) | metrics/recall(B) | metrics/mAP50(B) | metrics/mAP50-95(B) | val/box_loss | val/cls_loss | val/dfl_loss | lr/pg0 | lr/pg1 | lr/pg2
1 | 162.58 | 2.37218 | 5.23496 | 1.62091 | 0.446 | 0.45254 | 0.33821 | 0.11684 | 2.2837 | 2.14641 | 1.68245 | 0.000663978 | 0.000663978 | 0.000663978
2 | 310.217 | 2.36672 | 2.06545 | 1.64332 | 0.4039 | 0.44576 | 0.3704 | 0.12439 | 2.30407 | 1.88107 | 1.65709 | 0.00130869 | 0.00130869 | 0.00130869
3 | 448.505 | 2.35473 | 1.99443 | 1.60887 | 0.01987 | 0.54746 | 0.01419 | 0.00534 | 2.56074 | 101.507 | 2.42352 | 0.0019314 | 0.0019314 | 0.0019314
4 | 593.565 | 2.28878 | 1.94892 | 1.55414 | 0.38145 | 0.46826 | 0.30756 | 0.11056 | 2.2791 | 2.05769 | 1.62853 | 0.001901 | 0.001901 | 0.001901
5 | 730.454 | 2.35374 | 1.99367 | 1.60714 | 0.29044 | 0.46441 | 0.22379 | 0.08918 | 2.15077 | 2.36067 | 1.5919 | 0.001868 | 0.001868 | 0.001868
6 | 867.536 | 2.25267 | 1.93644 | 1.57177 | 0.16634 | 0.57253 | 0.14029 | 0.0516 | nan | nan | nan | 0.001835 | 0.001835 | 0.001835
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
