DAvolmx/AGROBOT_V1/agrobot_system_2/simulador_pasivo/resultados_pasivo/baseline_seed1001.csv

time_s | x | y | yaw_rad | delta_rad | cross_track_m | slam_x | slam_y | slam_error_m | slip_mps | command_v | command_w
0.0 | 2.0479773638723966 | -0.4164665666306729 | 1.5707963267948966 | 0.0 | 0.002022636127603228 | 2.0479773638723966 | -0.4164665666306729 | 0.0 | 0.0 | 0.0 | 0.0
0.05 | 2.0479773638723966 | -0.4164665666306729 | 1.5707963267948966 | 0.0 | 0.002022636127603228 | 2.0479773638723966 | -0.4164665666306729 | 0.0 | 0.0 | 0.0 | 0.0
0.1 | 2.0479773638723966 | -0.4164665666306729 | 1.5707963267948966 | 0.0 | 0.002022636127603228 | 2.0479773638723966 | -0.4164665666306729 | 0.0 | 0.0 | 0.0 | 0.0
0.15000000000000002 | 2.047977146258607 | -0.4151596454539471 | 1.570782584481258 | -3.5564782545200325e-05 | 0.0020228537413928827 | 2.047977371851176 | -0.4151243058637771 | 3.534031020511997e-05 | 0.06274583351177171 | 0.198032620102077 | -0.006623083600768798
0.2 | 2.047977017550036 | -0.4115149522609611 | 1.570753654997059 | -9.669304167045434e-05 | 0.002022982449963795 | 2.0479774631943153 | -0.4113810589366489 | 0.00013389406594091981 | 0.045575046244570955 | 0.198032620102077 | -0.006623083600768798
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
