DAvolmx/AGROBOT_V1/agrobot_system_2/simulador_pasivo/resultados_pasivo/baseline_seed1002.csv

time_s | x | y | yaw_rad | delta_rad | cross_track_m | slam_x | slam_y | slam_error_m | slip_mps | command_v | command_w
0.0 | -0.9662937807141978 | -1.2301730605402454 | 0.0 | 0.0 | 0.019826939459754556 | -0.9662937807141978 | -1.2301730605402454 | 0.0 | 0.0 | 0.0 | 0.0
0.05 | -0.9650868728882736 | -1.2301710247343323 | -0.00012835138033744998 | -0.0003554602943839429 | 0.019828975265667736 | -0.9650766943135296 | -1.2301731382502106 | 1.0395688201652382e-05 | 0.057950029779854445 | 0.1828779435329922 | -0.06241706403090243
0.1 | -0.9617210889061434 | -1.230169852152807 | -0.00039471114857747753 | -0.001072123135312838 | 0.019830147847192947 | -0.9616825247405564 | -1.2301740214153447 | 3.878888523185504e-05 | 0.04210068601873808 | 0.1828779435329922 | -0.06241706403090244
0.15000000000000002 | -0.9567838555469115 | -1.2301729300314175 | -0.0007039138304322793 | -0.0019372248995065259 | 0.019827069968582522 | -0.9567036514058542 | -1.2301767424580057 | 8.029469994477602e-05 | 0.030586156476000593 | 0.182866339109048 | -0.06246333059227757
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
