DAvolmx/AGROBOT_V1/agrobot_system_2/simulador_pasivo/resultados_pasivo/trained_candidate_seed1001.csv

time_s | x | y | yaw_rad | delta_rad | cross_track_m | slam_x | slam_y | slam_error_m | slip_mps | command_v | command_w
0.0 | 2.0479773638723966 | -0.4164665666306729 | 1.5707963267948966 | 0.0 | 0.002022636127603228 | 2.0479773638723966 | -0.4164665666306729 | 0.0 | 0.0 | 0.0 | 0.0
0.05 | 2.0479773638723966 | -0.4164665666306729 | 1.5707963267948966 | 0.0 | 0.002022636127603228 | 2.0479773638723966 | -0.4164665666306729 | 0.0 | 0.0 | 0.0 | 0.0
0.1 | 2.0479773638723966 | -0.4164665666306729 | 1.5707963267948966 | 0.0 | 0.002022636127603228 | 2.0479773638723966 | -0.4164665666306729 | 0.0 | 0.0 | 0.0 | 0.0
0.15000000000000002 | 2.047976860489498 | -0.41542487506216663 | 1.5707648621180685 | -8.182139486097904e-05 | 0.0020231395105017036 | 2.0479773784333437 | -0.41539670738454004 | 2.817243916849669e-05 | 0.050012417351849775 | 0.15784341947394942 | -0.01518087097001919
0.2 | 2.0479765043781235 | -0.41251984412904497 | 1.5706988216187971 | -0.0002237713451800892 | 0.0020234956218763145 | 2.0479775448765856 | -0.4124131234808297 | 0.00010672572038892799 | 0.036326803660284804 | 0.15784341947394942 | -0.01518087097001919
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
