DAvolmx/AGROBOT_V1/agrobot_system_2/simulador_pasivo/resultados_pasivo/trained_candidate_seed1002.csv

time_s | x | y | yaw_rad | delta_rad | cross_track_m | slam_x | slam_y | slam_error_m | slip_mps | command_v | command_w
0.0 | -0.9662937807141978 | -1.2301730605402454 | 0.0 | 0.0 | 0.019826939459754556 | -0.9662937807141978 | -1.2301730605402454 | 0.0 | 0.0 | 0.0 | 0.0
0.05 | -0.9653574201095209 | -1.230168510206518 | -0.0002851913975292655 | -0.0009243677699514011 | 0.019831489793481927 | -0.9653495243635546 | -1.230173194502084 | 9.180709630109866e-06 | 0.044993008011402116 | 0.14188278126819198 | -0.14187939407031597
0.1 | -0.9627461070606145 | -1.2301657871954388 | -0.000861845491833222 | -0.003195212217097725 | 0.019834212804561213 | -0.9627161917277225 | -1.2301746970831589 | 3.1213991113318844e-05 | 0.03273652276821549 | 0.14188278126819198 | -0.14187939407031602
0.15000000000000002 | -0.9589154127419374 | -1.2301721085991346 | -0.0015268604568497849 | -0.006253184743874019 | 0.019827891400865383 | -0.9588531874961217 | -1.2301792874018687 | 6.26379790982688e-05 | 0.023848300888244828 | 0.14189277918798743 | -0.14179110699434935
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
