DAvolmx/AGROBOT_V1/agrobot_system_2/docs/INFORME_DASHBOARD/anotadas/04c_navegacion_calibracion.png

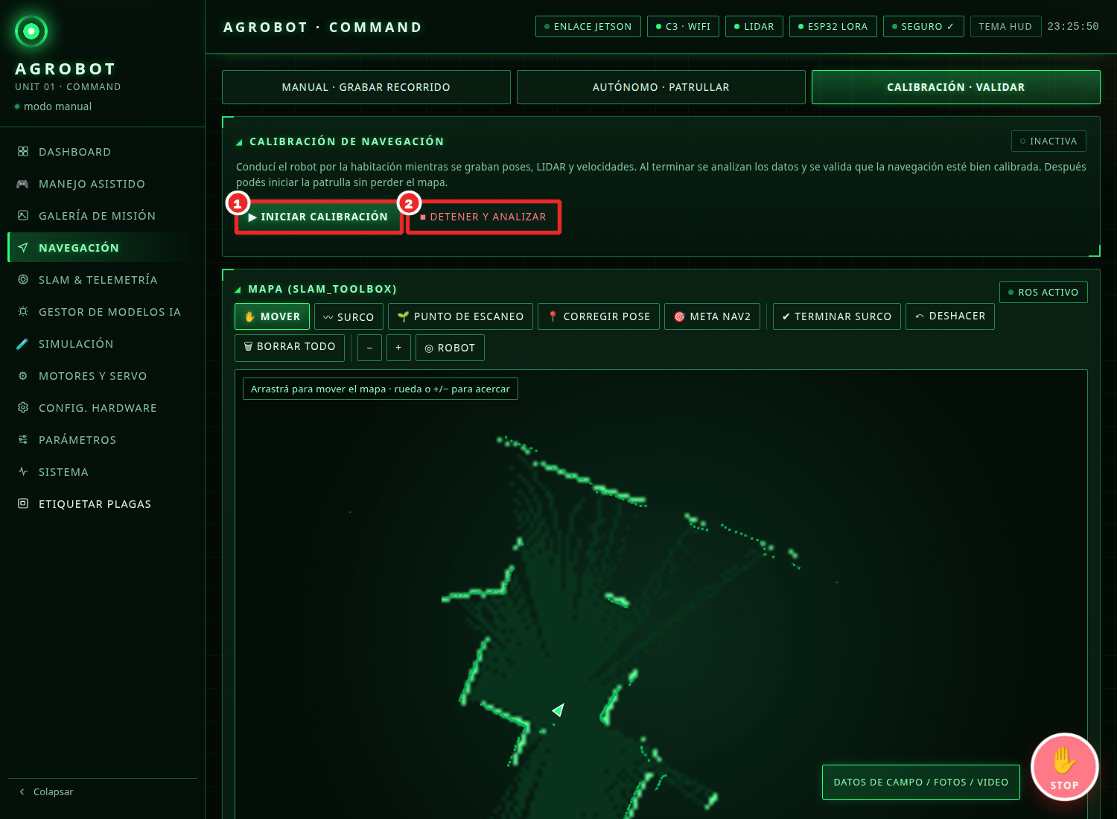
agrobot_system_2/docs/INFORME_DASHBOARD/anotadas/04c_navegacion_calibracion.png
