DAvolmx/AGROBOT_V1/agrobot_system_2/models/runs/cls_ccmt/results.png

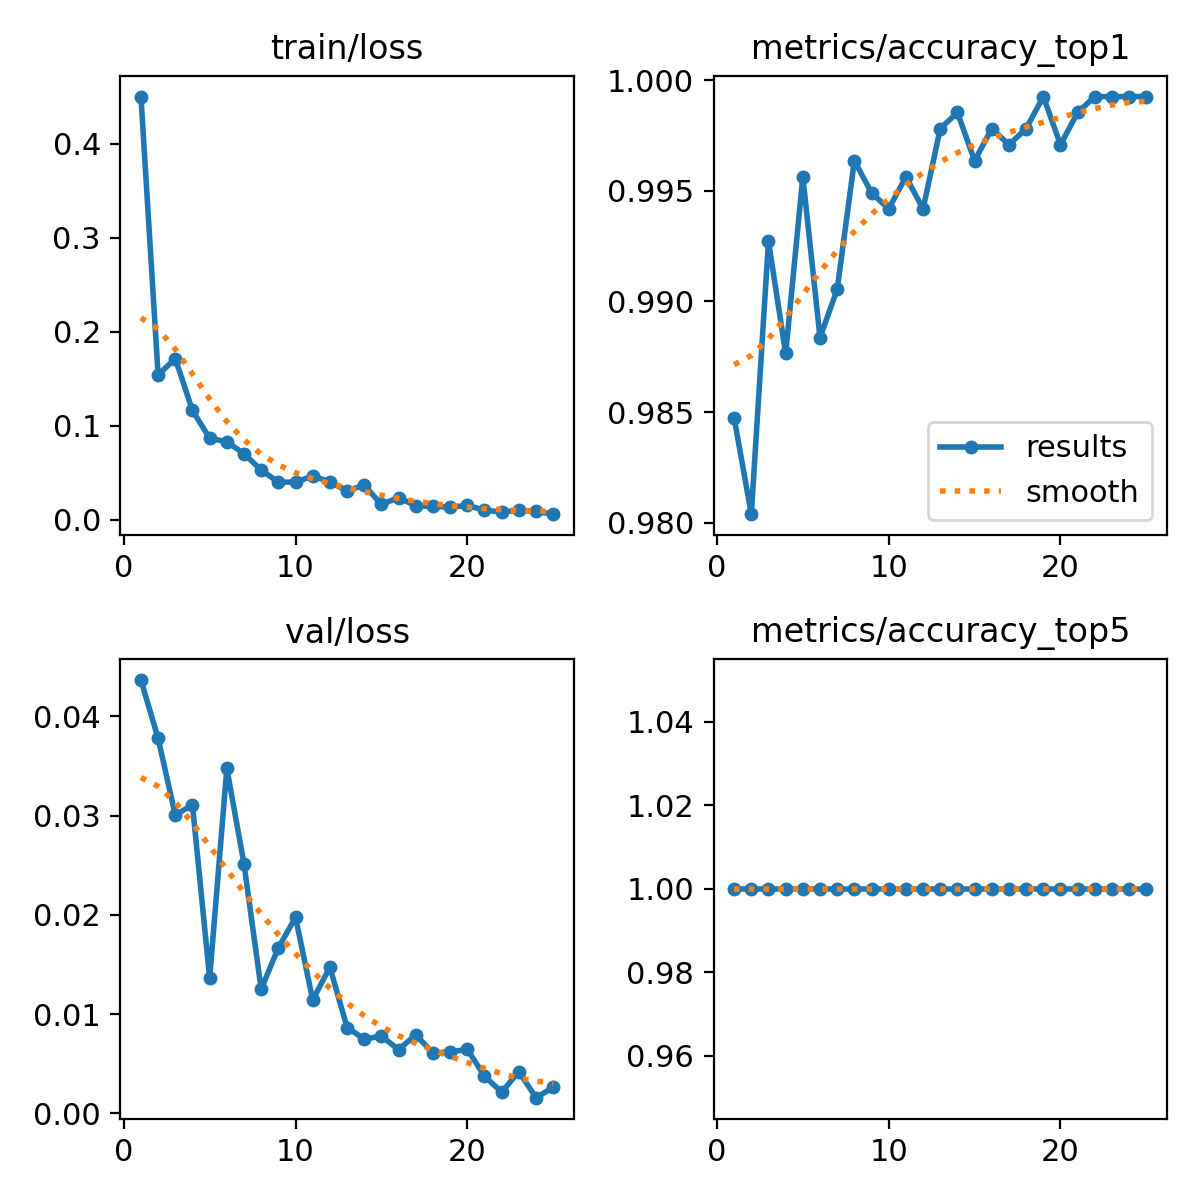
agrobot_system_2/models/runs/cls_ccmt/results.png
