DAvolmx/AGROBOT_V1/agrobot_system_2/models/runs/det_plagas/results.png

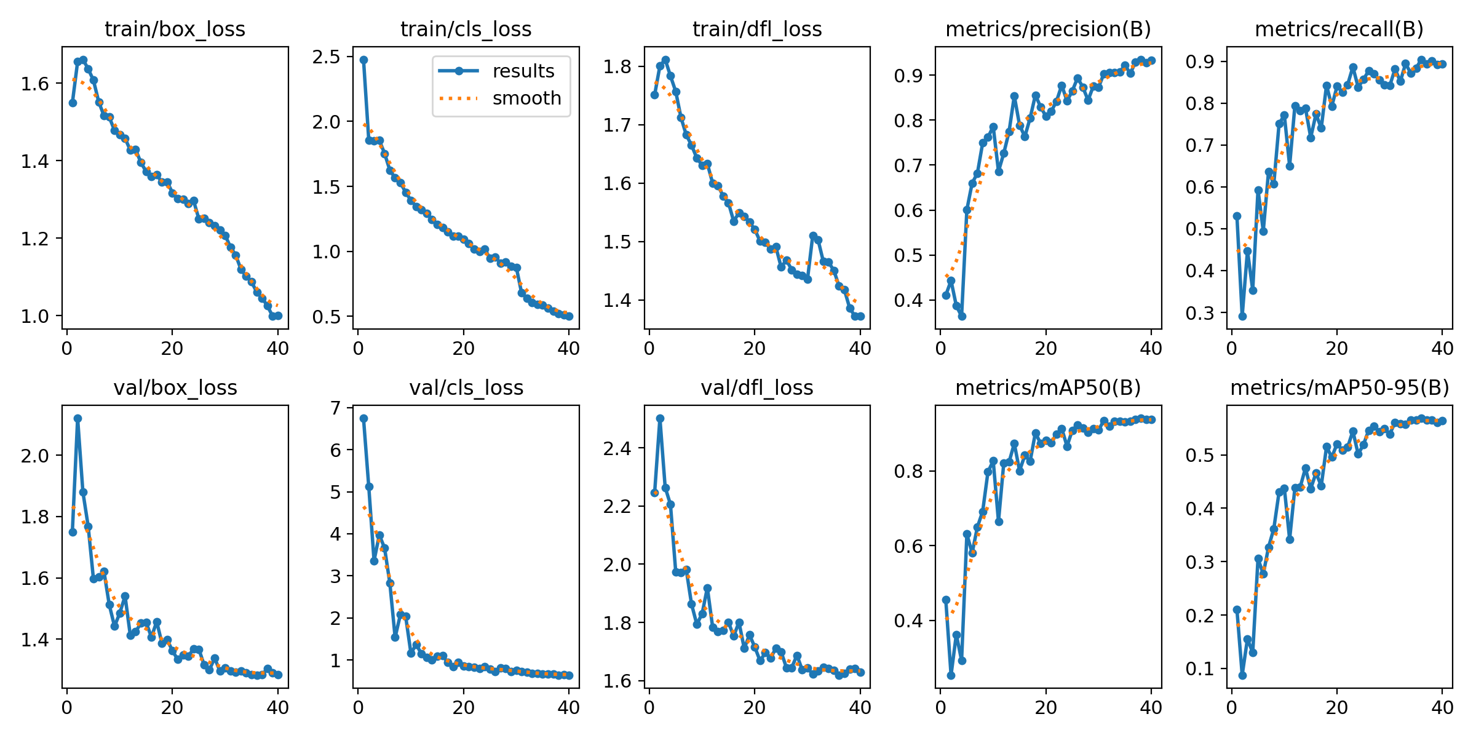
agrobot_system_2/models/runs/det_plagas/results.png
