DAvolmx/AGROBOT_V1/agrobot_system_2/simulador_pasivo/resultados_pasivo_prev_20261011/baseline_seed1003_slam.png

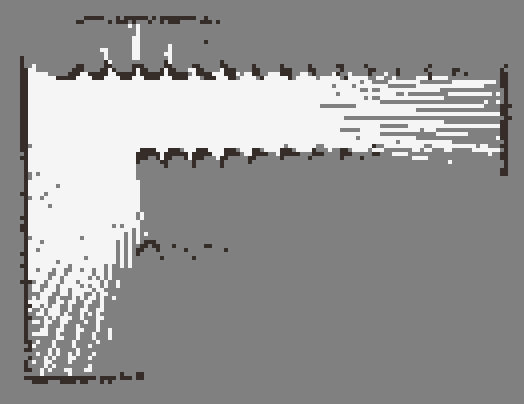
agrobot_system_2/simulador_pasivo/resultados_pasivo_prev_20261011/baseline_seed1003_slam.png
