DAvolmx/AGROBOT_V1/agrobot_system_2/simulador_pasivo/resultados_pasivo_prev_20261011/trained_seed1002_slam.png

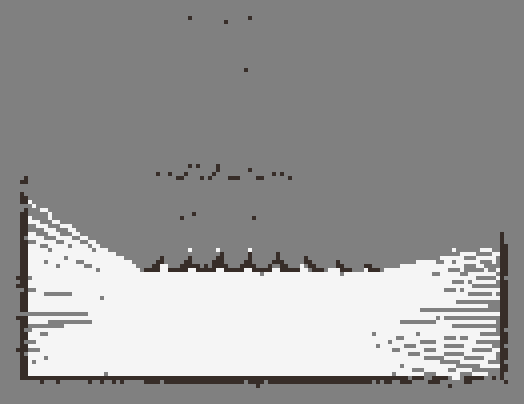
agrobot_system_2/simulador_pasivo/resultados_pasivo_prev_20261011/trained_seed1002_slam.png
