DAvolmx/AGROBOT_V1/agrobot_system_2/simulador_pasivo/gazebo/huerta_mixta.sdf

<?xml version='1.0' encoding='utf-8'?>
<sdf version="1.9">
  <world name="huerta_ruda">
    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
    <gravity>0 0 -9.81</gravity>
    <physics name="default" type="ignored">
      <max_step_size>0.001</max_step_size>
      <real_time_factor>0.65</real_time_factor>
      <real_time_update_rate>500</real_time_update_rate>
    </physics>
    <plugin filename="gz-sim-physics-system" name="gz::sim::systems::Physics" />
    <plugin filename="gz-sim-user-commands-system" name="gz::sim::systems::UserCommands" />
    <plugin filename="gz-sim-scene-broadcaster-system" name="gz::sim::systems::SceneBroadcaster" />
    <plugin filename="gz-sim-contact-system" name="gz::sim::systems::Contact" />
    <plugin filename="gz-sim-sensors-system" name="gz::sim::systems::Sensors">
      <render_engine>ogre2</render_engine>
    </plugin>
    <light name="sun" type="directional">
      <cast_shadows>true</cast_shadows>
      <pose>0 0 12 0.2 0.4 0</pose>
      <diffuse>0.65 0.624 0.559 1</diffuse>
      <direction>-0.35 0.1 -0.92</direction>
    </light>
    <model name="suelo">
      <pose>0 0 0 0 0 0</pose>
      <static>true</static>
      <link name="ground">
        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
      </link>
    </model>
    <model name="agrobot" canonical_link="base_link">
      <pose>-2 0 0.31 0 0 0</pose>
      <link name="base_link">
        <inertial>
          <mass>8.8</mass>
          <inertia>
            <ixx>0.30</ixx>
            <iyy>0.38</iyy>
            <izz>0.42</izz>
            <ixy>0</ixy>
            <ixz>0</ixz>
            <iyz>0</iyz>
          </inertia>
        </inertial>
        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
        <sensor name="lidar_2d" type="gpu_lidar">
          <pose>0.05 0 0.28 0 0 0</pose>
          <always_on>true</always_on>
          <update_rate>10</update_rate>
          <topic>/agrobot/scan</topic>
          <lidar>
            <scan>
              <horizontal>
                <samples>360</samples>
                <resolution>1</resolution>
                <min_angle>-3.14159</min_angle>
                <max_angle>3.14159</max_angle>
              </horizontal>
            </scan>
            <range>
              <min>0.08</min>
              <max>8</max>
              <resolution>0.01</resolution>
            </range>
          </lidar>
        </sensor>
        <sensor name="camara_rgb" type="camera">
          <pose>0.235 0 0.18 0 0.46 0</pose>
          <always_on>true</always_on>
          <update_rate>8</update_rate>
          <topic>/agrobot/camera/image_raw</topic>
          <camera>
            <horizontal_fov>1.22</horizontal_fov>
            <image>
              <width>320</width>
              <height>240</height>
              <format>R8G8B8</format>
            </image>
            <clip>
              <near>0.08</near>
              <far>8</far>
            </clip>
          </camera>
        </sensor>
        <sensor name="contacto_chasis" type="contact">
          <always_on>true</always_on>
          <update_rate>30</update_rate>
          <topic>/agrobot/contact</topic>
          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
        </sensor>
        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
      </link>
      <link name="front_axle">
        <inertial>
          <mass>0.6</mass>
          <inertia>
            <ixx>0.018</ixx>
            <iyy>0.018</iyy>
            <izz>0.012</izz>
            <ixy>0</ixy>
            <ixz>0</ixz>
            <iyz>0</iyz>
          </inertia>
        </inertial>
        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
      </link>
      <joint name="front_pivot" type="revolute">
        <parent>base_link</parent>
        <child>front_axle</child>
        <pose>0.185 0 -0.20 0 0 0</pose>
        <axis>
          <xyz>0 0 1</xyz>
          <limit>
            <lower>-0.349066</lower>
            <upper>0.349066</upper>
            <effort>20</effort>
            <velocity>1.2</velocity>
          </limit>
          <dynamics>
            <damping>0.35</damping>
            <friction>0.08</friction>
          </dynamics>
        </axis>
      </joint>
      <link name="front_left_wheel">
        <inertial>
          <mass>0.65</mass>
          <inertia>
            <ixx>0.003</ixx>
            <iyy>0.003</iyy>
            <izz>0.004</izz>
            <ixy>0</ixy>
            <ixz>0</ixz>
            <iyz>0</iyz>
          </inertia>
        </inertial>
        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
        <sensor name="contact_front_left" type="contact">
          <always_on>true</always_on>
          <update_rate>30</update_rate>
          <topic>/agrobot/contact/front_left</topic>
          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
        </sensor>
      </link>
      <joint name="front_left_wheel_joint" type="revolute">
        <parent>front_axle</parent>
        <child>front_left_wheel</child>
        <pose>0 0.067 -0.005 0 0 0</pose>
        <axis>
          <xyz>0 1 0</xyz>
          <limit>
            <effort>30</effort>
            <velocity>12</velocity>
          </limit>
          <dynamics>
            <damping>0.02</damping>
          </dynamics>
        </axis>
      </joint>
      <link name="front_right_wheel">
        <inertial>
          <mass>0.65</mass>
          <inertia>
            <ixx>0.003</ixx>
            <iyy>0.003</iyy>
            <izz>0.004</izz>
            <ixy>0</ixy>
            <ixz>0</ixz>
            <iyz>0</iyz>
          </inertia>
        </inertial>
        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
        <sensor name="contact_front_right" type="contact">
          <always_on>true</always_on>
          <update_rate>30</update_rate>
          <topic>/agrobot/contact/front_right</topic>
          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
        </sensor>
      </link>
      <joint name="front_right_wheel_joint" type="revolute">
        <parent>front_axle</parent>
        <child>front_right_wheel</child>
        <pose>0 -0.067 -0.005 0 0 0</pose>
        <axis>
          <xyz>0 1 0</xyz>
          <limit>
            <effort>30</effort>
            <velocity>12</velocity>
          </limit>
          <dynamics>
            <damping>0.02</damping>
          </dynamics>
        </axis>
      </joint>
      <link name="rear_left_wheel">
        <inertial>
          <mass>0.65</mass>
          <inertia>
            <ixx>0.003</ixx>
            <iyy>0.003</iyy>
            <izz>0.004</izz>
            <ixy>0</ixy>
            <ixz>0</ixz>
            <iyz>0</iyz>
          </inertia>
        </inertial>
        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
        <sensor name="contact_rear_left" type="contact">
          <always_on>true</always_on>
          <update_rate>30</update_rate>
          <topic>/agrobot/contact/rear_left</topic>
          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
        </sensor>
      </link>
      <joint name="rear_left_wheel_joint" type="revolute">
        <parent>base_link</parent>
        <child>rear_left_wheel</child>
        <pose>-0.185 0.157 -0.20 0 0 0</pose>
        <axis>
          <xyz>0 1 0</xyz>
          <limit>
            <effort>30</effort>
            <velocity>12</velocity>
          </limit>
          <dynamics>
            <damping>0.02</damping>
          </dynamics>
        </axis>
      </joint>
      <link name="rear_right_wheel">
        <inertial>
          <mass>0.65</mass>
          <inertia>
            <ixx>0.003</ixx>
            <iyy>0.003</iyy>
            <izz>0.004</izz>
            <ixy>0</ixy>
            <ixz>0</ixz>
            <iyz>0</iyz>
          </inertia>
        </inertial>
        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
        <sensor name="contact_rear_right" type="contact">
          <always_on>true</always_on>
          <update_rate>30</update_rate>
          <topic>/agrobot/contact/rear_right</topic>
          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
        </sensor>
      </link>
      <joint name="rear_right_wheel_joint" type="revolute">
        <parent>base_link</parent>
        <child>rear_right_wheel</child>
        <pose>-0.185 -0.157 -0.20 0 0 0</pose>
        <axis>
          <xyz>0 1 0</xyz>
          <limit>
            <effort>30</effort>
            <velocity>12</velocity>
          </limit>
          <dynamics>
            <damping>0.02</damping>
          </dynamics>
        </axis>
      </joint>
      <plugin filename="gz-sim-diff-drive-system" name="gz::sim::systems::DiffDrive">
        <left_joint>front_left_wheel_joint</left_joint>
        <left_joint>rear_left_wheel_joint</left_joint>
        <right_joint>front_right_wheel_joint</right_joint>
        <right_joint>rear_right_wheel_joint</right_joint>
        <wheel_separation>0.224</wheel_separation>
        <wheel_radius>0.11</wheel_radius>
        <topic>/agrobot/cmd_vel</topic>
        <odom_topic>/agrobot/odom</odom_topic>
        <tf_topic>/agrobot/tf</tf_topic>
        <frame_id>odom</frame_id>
        <child_frame_id>base_link</child_frame_id>
        <odom_publish_frequency>30</odom_publish_frequency>
        <max_linear_velocity>0.45</max_linear_velocity>
        <max_angular_velocity>1.4</max_angular_velocity>
      </plugin>
    </model>
    <model name="surco_izq_00">
      <static>true</static>
      <pose>-3.005 -0.363 0.036 0 0 -0.0302</pose>
      <link name="tierra">
        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
      </link>
    </model>
    <model name="surco_der_00">
      <static>true</static>
      <pose>-3.014 0.353 0.048 0 0 0.0033</pose>
      <link name="tierra">
        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
      </link>
    </model>
    <model name="surco_izq_01">
      <static>true</static>
      <pose>-2.692 -0.360 0.041 0 0 0.0066</pose>
      <link name="tierra">
        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
      </link>
    </model>
    <model name="surco_der_01">
      <static>true</static>
      <pose>-2.690 0.352 0.049 0 0 -0.0030</pose>
      <link name="tierra">
        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
      </link>
    </model>
    <model name="surco_izq_02">
      <static>true</static>
      <pose>-2.382 -0.353 0.033 0 0 -0.0125</pose>
      <link name="tierra">
        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
      </link>
    </model>
    <model name="surco_der_02">
      <static>true</static>
      <pose>-2.399 0.359 0.033 0 0 -0.0070</pose>
      <link name="tierra">
        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
      </link>
    </model>
    <model name="surco_izq_03">
      <static>true</static>
      <pose>-2.078 -0.362 0.037 0 0 -0.0096</pose>
      <link name="tierra">
        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
      </link>
    </model>
    <model name="surco_der_03">
      <static>true</static>
      <pose>-2.099 0.358 0.056 0 0 -0.0012</pose>
      <link name="tierra">
        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
      </link>
    </model>
    <model name="surco_izq_04">
      <static>true</static>
      <pose>-1.815 -0.348 0.049 0 0 0.0337</pose>
      <link name="tierra">
        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
      </link>
    </model>
    <model name="surco_der_04">
      <static>true</static>
      <pose>-1.818 0.353 0.059 0 0 -0.0328</pose>
      <link name="tierra">
        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
      </link>
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
      <pose>3.127 0.115 0.008 0 0 0.1014</pose>
      <link name="body">
        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
      </link>
    </model>
    <model name="bache_13">
      <static>true</static>
      <pose>0.250 0.158 0.013 0 0 0.1368</pose>
      <link name="body">
        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
      </link>
    </model>
  </world>
</sdf>
