DAvolmx/AGROBOT_V1/agrobot_system_2/simulador_pasivo/gazebo/huerta_ruda.sdf

<?xml version='1.0' encoding='utf-8'?>
<sdf version="1.9">
 <world name="huerta_ruda">
  <gravity>0 0 -9.81</gravity>
  <physics name="default" type="ignored">
   <max_step_size>0.001</max_step_size>
   <real_time_factor>0.65</real_time_factor>
   <real_time_update_rate>500</real_time_update_rate>
  </physics>
  <plugin filename="gz-sim-physics-system" name="gz::sim::systems::Physics" />
  <plugin filename="gz-sim-user-commands-system" name="gz::sim::systems::UserCommands" />
  <plugin filename="gz-sim-scene-broadcaster-system" name="gz::sim::systems::SceneBroadcaster" />
  <plugin filename="gz-sim-contact-system" name="gz::sim::systems::Contact" />
  <plugin filename="gz-sim-sensors-system" name="gz::sim::systems::Sensors">
   <render_engine>ogre2</render_engine>
  </plugin>
  <light name="sun" type="directional">
   <!-- Sombras dinámicas consumían el presupuesto de texturas EGL en la Jetson
        y dejaban el sensor RGB negro al avanzar. La forma de los surcos y las
        plantas conserva el contraste de navegación con luz difusa. -->
   <cast_shadows>false</cast_shadows>
   <pose>0 0 12 0.2 0.4 0</pose>
   <diffuse>0.86 0.81 0.70 1</diffuse>
   <direction>-0.35 0.1 -0.92</direction>
  </light>
  <model name="suelo">
   <static>true</static>
   <link name="ground">
    <collision name="ground_collision">
     <geometry>
      <plane>
       <normal>0 0 1</normal>
       <size>30 12</size>
      </plane>
     </geometry>
     <surface>
      <friction>
       <ode>
        <mu>0.85</mu>
        <mu2>0.65</mu2>
       </ode>
      </friction>
     </surface>
    </collision>
    <visual name="ground_visual">
     <geometry>
      <plane>
       <normal>0 0 1</normal>
       <size>30 12</size>
      </plane>
     </geometry>
     <material>
      <ambient>0.420 0.341 0.231 1</ambient>
      <diffuse>0.420 0.341 0.231 1</diffuse>
     </material>
    </visual>
   </link>
  </model>
  <model name="col_bajo_izquierda">
   <static>true</static>
   <pose>-0.95 0.38 0.06 0 0 0.15</pose>
   <link name="plant">
    <collision name="leaf">
     <geometry>
      <box>
       <size>0.34 0.20 0.08</size>
      </box>
     </geometry>
    </collision>
    <visual name="leaf_v">
     <geometry>
      <box>
       <size>0.34 0.20 0.08</size>
      </box>
     </geometry>
     <material>
      <ambient>0.200 0.459 0.102 1</ambient>
      <diffuse>0.200 0.459 0.102 1</diffuse>
     </material>
    </visual>
   </link>
  </model>
  <model name="lechuga_baja_derecha">
   <static>true</static>
   <pose>-0.80 -0.38 0.05 0 0 -0.2</pose>
   <link name="plant">
    <collision name="leaf">
     <geometry>
      <box>
       <size>0.30 0.23 0.07</size>
      </box>
     </geometry>
    </collision>
    <visual name="leaf_v">
     <geometry>
      <box>
       <size>0.30 0.23 0.07</size>
      </box>
     </geometry>
     <material>
      <ambient>0.239 0.522 0.122 1</ambient>
      <diffuse>0.239 0.522 0.122 1</diffuse>
     </material>
    </visual>
   </link>
  </model>
  <model name="roca_baja">
   <static>true</static>
   <pose>-0.45 0.16 0.035 0 0.1 0.35</pose>
   <link name="rock">
    <collision name="c">
     <geometry>
      <box>
       <size>0.18 0.16 0.07</size>
      </box>
     </geometry>
    </collision>
    <visual name="v">
     <geometry>
      <box>
       <size>0.18 0.16 0.07</size>
      </box>
     </geometry>
     <material>
      <ambient>0.431 0.400 0.341 1</ambient>
      <diffuse>0.431 0.400 0.341 1</diffuse>
     </material>
    </visual>
   </link>
  </model>
  <model name="rama_baja">
   <static>true</static>
   <pose>-0.15 -0.20 0.035 0.1 0 0.25</pose>
   <link name="branch">
    <collision name="c">
     <geometry>
      <box>
       <size>0.48 0.045 0.06</size>
      </box>
     </geometry>
    </collision>
    <visual name="v">
     <geometry>
      <box>
       <size>0.48 0.045 0.06</size>
      </box>
     </geometry>
     <material>
      <ambient>0.420 0.271 0.129 1</ambient>
      <diffuse>0.420 0.271 0.129 1</diffuse>
     </material>
    </visual>
   </link>
  </model>
  <model name="agrobot" canonical_link="base_link">
   <pose>-2 0 0.31 0 0 0</pose>
   <link name="base_link">
    <inertial>
     <mass>8.8</mass>
     <inertia>
      <ixx>0.30</ixx>
      <iyy>0.38</iyy>
      <izz>0.42</izz>
      <ixy>0</ixy>
      <ixz>0</ixz>
      <iyz>0</iyz>
     </inertia>
    </inertial>
    <collision name="chassis_collision">
     <geometry>
      <box>
       <size>0.50 0.33 0.16</size>
      </box>
     </geometry>
    </collision>
    <visual name="chassis_frame_visual">
     <pose>0 0 -0.075 0 0 0</pose>
     <geometry>
      <box>
       <size>0.50 0.33 0.035</size>
      </box>
     </geometry>
     <material>
      <ambient>0.800 0.043 0.024 1</ambient>
      <diffuse>0.800 0.043 0.024 1</diffuse>
     </material>
    </visual>
    <visual name="electronics_case_visual">
     <pose>-0.005 0 0.055 0 0 0</pose>
     <geometry>
      <box>
       <size>0.39 0.29 0.16</size>
      </box>
     </geometry>
     <material>
      <ambient>0.129 0.149 0.161 1</ambient>
      <diffuse>0.129 0.149 0.161 1</diffuse>
     </material>
    </visual>
    <visual name="electronics_lid_visual">
     <pose>-0.005 0 0.139 0 0 0</pose>
     <geometry>
      <box>
       <size>0.395 0.295 0.012</size>
      </box>
     </geometry>
     <material>
      <ambient>0.420 0.459 0.471 0.52</ambient>
      <diffuse>0.420 0.459 0.471 0.52</diffuse>
     </material>
    </visual>
    <visual name="front_red_sensor_bumper">
     <pose>0.255 0 0.005 0 0 0</pose>
     <geometry>
      <box>
       <size>0.045 0.35 0.075</size>
      </box>
     </geometry>
     <material>
      <ambient>0.780 0.035 0.024 1</ambient>
      <diffuse>0.780 0.035 0.024 1</diffuse>
     </material>
    </visual>
    <visual name="rear_red_mount">
     <pose>-0.255 0 0.005 0 0 0</pose>
     <geometry>
      <box>
       <size>0.04 0.37 0.055</size>
      </box>
     </geometry>
     <material>
      <ambient>0.722 0.031 0.020 1</ambient>
      <diffuse>0.722 0.031 0.020 1</diffuse>
     </material>
    </visual>
    <sensor name="lidar_2d" type="gpu_lidar">
     <pose>0.05 0 0.28 0 0 0</pose>
     <always_on>true</always_on>
     <update_rate>3</update_rate>
     <topic>/agrobot/scan</topic>
     <lidar>
      <scan>
       <horizontal>
         <samples>120</samples>
        <resolution>1</resolution>
        <min_angle>-3.14159</min_angle>
        <max_angle>3.14159</max_angle>
       </horizontal>
      </scan>
      <range>
       <min>0.08</min>
       <max>8</max>
       <resolution>0.01</resolution>
      </range>
     </lidar>
    </sensor>
    <sensor name="camara_rgb" type="camera">
     <pose>0.235 0 0.18 0 0.25 0</pose>
     <always_on>true</always_on>
     <!-- 3 Hz equilibra respuesta visual y carga del renderizador EGL en Jetson. -->
     <update_rate>3</update_rate>
     <topic>/agrobot/camera/image_raw</topic>
     <camera>
      <horizontal_fov>1.22</horizontal_fov>
      <image>
        <width>240</width>
        <height>180</height>
       <format>R8G8B8</format>
      </image>
      <clip>
       <near>0.08</near>
       <far>8</far>
      </clip>
     </camera>
    </sensor>
    <sensor name="contacto_chasis" type="contact">
     <always_on>true</always_on>
     <update_rate>30</update_rate>
     <topic>/agrobot/contact</topic>
     <contact>
      <collision>chassis_collision</collision>
     </contact>
    </sensor>
    <visual name="front_yoke_visual">
     <pose>0.185 0 -0.115 0 0 0</pose>
     <geometry>
      <box>
       <size>0.08 0.18 0.035</size>
      </box>
     </geometry>
     <material>
      <ambient>0.678 0.024 0.020 1</ambient>
      <diffuse>0.678 0.024 0.020 1</diffuse>
     </material>
    </visual>
    <visual name="left_spring_body_visual">
     <pose>0.17 0.038 -0.015 0 0 0</pose>
     <geometry>
      <box>
       <size>0.035 0.035 0.14</size>
      </box>
     </geometry>
     <material>
      <ambient>0.698 0.035 0.024 1</ambient>
      <diffuse>0.698 0.035 0.024 1</diffuse>
     </material>
    </visual>
    <visual name="right_spring_body_visual">
     <pose>0.17 -0.038 -0.015 0 0 0</pose>
     <geometry>
      <box>
       <size>0.035 0.035 0.14</size>
      </box>
     </geometry>
     <material>
      <ambient>0.698 0.035 0.024 1</ambient>
      <diffuse>0.698 0.035 0.024 1</diffuse>
     </material>
    </visual>
    <visual name="front_crossmember_visual">
     <pose>0.18 0 -0.105 0 0 0</pose>
     <geometry>
      <box>
       <size>0.055 0.20 0.035</size>
      </box>
     </geometry>
     <material>
      <ambient>0.620 0.024 0.020 1</ambient>
      <diffuse>0.620 0.024 0.020 1</diffuse>
     </material>
    </visual>
   </link>
   <link name="front_axle">
    <!-- Pose explícita: las poses de joint son relativas al enlace hijo en SDF. -->
    <pose>0.185 0 -0.20 0 0 0</pose>
    <inertial>
     <mass>0.6</mass>
     <inertia>
      <ixx>0.018</ixx>
      <iyy>0.018</iyy>
      <izz>0.012</izz>
      <ixy>0</ixy>
      <ixz>0</ixz>
      <iyz>0</iyz>
     </inertia>
    </inertial>
    <collision name="axle_collision">
     <geometry>
      <box>
       <size>0.08 0.134 0.045</size>
      </box>
     </geometry>
    </collision>
   </link>
   <joint name="front_pivot" type="revolute">
    <parent>base_link</parent>
    <child>front_axle</child>
    <pose>0 0 0 0 0 0</pose>
    <axis>
     <xyz>0 0 1</xyz>
     <limit>
      <lower>-0.349066</lower>
      <upper>0.349066</upper>
      <effort>20</effort>
      <velocity>1.2</velocity>
     </limit>
     <dynamics>
      <damping>0.35</damping>
      <friction>0.08</friction>
     </dynamics>
    </axis>
   </joint>
   <link name="front_left_wheel">
    <pose>0.185 0.067 -0.205 0 0 0</pose>
    <inertial>
     <mass>0.65</mass>
     <inertia>
      <ixx>0.003</ixx>
      <iyy>0.003</iyy>
      <izz>0.004</izz>
      <ixy>0</ixy>
      <ixz>0</ixz>
      <iyz>0</iyz>
     </inertia>
    </inertial>
    <collision name="tire_collision">
     <pose>0 0 0 1.5708 0 0</pose>
     <geometry>
      <cylinder>
       <radius>0.11</radius>
       <length>0.052</length>
      </cylinder>
     </geometry>
     <surface>
      <friction>
       <ode>
        <mu>0.85</mu>
        <mu2>0.65</mu2>
        <slip1>0.03</slip1>
        <slip2>0.03</slip2>
       </ode>
      </friction>
     </surface>
    </collision>
    <visual name="tire_visual">
     <pose>0 0 0 1.5708 0 0</pose>
     <geometry>
      <cylinder>
       <radius>0.11</radius>
       <length>0.052</length>
      </cylinder>
     </geometry>
    </visual>
    <sensor name="contact_front_left" type="contact">
     <always_on>true</always_on>
     <update_rate>30</update_rate>
     <topic>/agrobot/contact/front_left</topic>
     <contact>
      <collision>tire_collision</collision>
     </contact>
    </sensor>
   </link>
   <joint name="front_left_wheel_joint" type="revolute">
    <parent>front_axle</parent>
    <child>front_left_wheel</child>
    <pose>0 0 0 0 0 0</pose>
    <axis>
     <!-- El cilindro se orienta a -Y con la rotación visual/collider +90° X;
          alinear el eje de junta evita que cmd_vel positivo impulse hacia atrás. -->
     <xyz>0 1 0</xyz>
     <limit>
      <effort>30</effort>
      <velocity>12</velocity>
     </limit>
     <dynamics>
      <damping>0.02</damping>
     </dynamics>
    </axis>
   </joint>
   <link name="front_right_wheel">
    <pose>0.185 -0.067 -0.205 0 0 0</pose>
    <inertial>
     <mass>0.65</mass>
     <inertia>
      <ixx>0.003</ixx>
      <iyy>0.003</iyy>
      <izz>0.004</izz>
      <ixy>0</ixy>
      <ixz>0</ixz>
      <iyz>0</iyz>
     </inertia>
    </inertial>
    <collision name="tire_collision">
     <pose>0 0 0 1.5708 0 0</pose>
     <geometry>
      <cylinder>
       <radius>0.11</radius>
       <length>0.052</length>
      </cylinder>
     </geometry>
     <surface>
      <friction>
       <ode>
        <mu>0.85</mu>
        <mu2>0.65</mu2>
        <slip1>0.03</slip1>
        <slip2>0.03</slip2>
       </ode>
      </friction>
     </surface>
    </collision>
    <visual name="tire_visual">
     <pose>0 0 0 1.5708 0 0</pose>
     <geometry>
      <cylinder>
       <radius>0.11</radius>
       <length>0.052</length>
      </cylinder>
     </geometry>
    </visual>
    <sensor name="contact_front_right" type="contact">
     <always_on>true</always_on>
     <update_rate>30</update_rate>
     <topic>/agrobot/contact/front_right</topic>
     <contact>
      <collision>tire_collision</collision>
     </contact>
    </sensor>
   </link>
   <joint name="front_right_wheel_joint" type="revolute">
    <parent>front_axle</parent>
    <child>front_right_wheel</child>
    <pose>0 0 0 0 0 0</pose>
    <axis>
     <xyz>0 1 0</xyz>
     <limit>
      <effort>30</effort>
      <velocity>12</velocity>
     </limit>
     <dynamics>
      <damping>0.02</damping>
     </dynamics>
    </axis>
   </joint>
   <link name="rear_left_wheel">
    <pose>-0.185 0.157 -0.20 0 0 0</pose>
    <inertial>
     <mass>0.65</mass>
     <inertia>
      <ixx>0.003</ixx>
      <iyy>0.003</iyy>
      <izz>0.004</izz>
      <ixy>0</ixy>
      <ixz>0</ixz>
      <iyz>0</iyz>
     </inertia>
    </inertial>
    <collision name="tire_collision">
     <pose>0 0 0 1.5708 0 0</pose>
     <geometry>
      <cylinder>
       <radius>0.11</radius>
       <length>0.052</length>
      </cylinder>
     </geometry>
     <surface>
      <friction>
       <ode>
        <mu>0.85</mu>
        <mu2>0.65</mu2>
        <slip1>0.03</slip1>
        <slip2>0.03</slip2>
       </ode>
      </friction>
     </surface>
    </collision>
    <visual name="tire_visual">
     <pose>0 0 0 1.5708 0 0</pose>
     <geometry>
      <cylinder>
       <radius>0.11</radius>
       <length>0.052</length>
      </cylinder>
     </geometry>
    </visual>
    <sensor name="contact_rear_left" type="contact">
     <always_on>true</always_on>
     <update_rate>30</update_rate>
     <topic>/agrobot/contact/rear_left</topic>
     <contact>
      <collision>tire_collision</collision>
     </contact>
    </sensor>
   </link>
   <joint name="rear_left_wheel_joint" type="revolute">
    <parent>base_link</parent>
    <child>rear_left_wheel</child>
    <pose>0 0 0 0 0 0</pose>
    <axis>
     <xyz>0 1 0</xyz>
     <limit>
      <effort>30</effort>
      <velocity>12</velocity>
     </limit>
     <dynamics>
      <damping>0.02</damping>
     </dynamics>
    </axis>
   </joint>
   <link name="rear_right_wheel">
    <pose>-0.185 -0.157 -0.20 0 0 0</pose>
    <inertial>
     <mass>0.65</mass>
     <inertia>
      <ixx>0.003</ixx>
      <iyy>0.003</iyy>
      <izz>0.004</izz>
      <ixy>0</ixy>
      <ixz>0</ixz>
      <iyz>0</iyz>
     </inertia>
    </inertial>
    <collision name="tire_collision">
     <pose>0 0 0 1.5708 0 0</pose>
     <geometry>
      <cylinder>
       <radius>0.11</radius>
       <length>0.052</length>
      </cylinder>
     </geometry>
     <surface>
      <friction>
       <ode>
        <mu>0.85</mu>
        <mu2>0.65</mu2>
        <slip1>0.03</slip1>
        <slip2>0.03</slip2>
       </ode>
      </friction>
     </surface>
    </collision>
    <visual name="tire_visual">
     <pose>0 0 0 1.5708 0 0</pose>
     <geometry>
      <cylinder>
       <radius>0.11</radius>
       <length>0.052</length>
      </cylinder>
     </geometry>
    </visual>
    <sensor name="contact_rear_right" type="contact">
     <always_on>true</always_on>
     <update_rate>30</update_rate>
     <topic>/agrobot/contact/rear_right</topic>
     <contact>
      <collision>tire_collision</collision>
     </contact>
    </sensor>
   </link>
   <joint name="rear_right_wheel_joint" type="revolute">
    <parent>base_link</parent>
    <child>rear_right_wheel</child>
    <pose>0 0 0 0 0 0</pose>
    <axis>
     <xyz>0 1 0</xyz>
     <limit>
      <effort>30</effort>
      <velocity>12</velocity>
     </limit>
     <dynamics>
      <damping>0.02</damping>
     </dynamics>
    </axis>
   </joint>
   <plugin filename="gz-sim-diff-drive-system" name="gz::sim::systems::DiffDrive">
    <left_joint>front_left_wheel_joint</left_joint>
    <left_joint>rear_left_wheel_joint</left_joint>
    <right_joint>front_right_wheel_joint</right_joint>
    <right_joint>rear_right_wheel_joint</right_joint>
    <wheel_separation>0.224</wheel_separation>
    <wheel_radius>0.11</wheel_radius>
    <topic>/agrobot/cmd_vel</topic>
    <odom_topic>/agrobot/odom</odom_topic>
    <tf_topic>/agrobot/tf</tf_topic>
    <frame_id>odom</frame_id>
    <child_frame_id>base_link</child_frame_id>
    <odom_publish_frequency>30</odom_publish_frequency>
    <max_linear_velocity>0.45</max_linear_velocity>
    <max_angular_velocity>1.4</max_angular_velocity>
   </plugin>
  </model>
 </world>
</sdf>
