DAvolmx/AGROBOT_V1/agrobot_system_2/firmware/agrobot_c3_v7_estable/agrobot_c3_v7_estable.ino

/* AGROBOT v7: base de enlace original, solo JETSON_AP + BLE.
Sin autotest. PWM hardware 5kHz, parada 500ms, rearme por cero fresco.
Geometria nominal: L=.37m, pivote +-20 grados. Anchos exteriores NO son vias.
Sin sensores de corriente/encoders/pivote: no detecta atasco ni velocidad real.
Core ESP32 3.3.12. Requiere identificar drivers y comprobar banco antes de suelo.
*/
#include "contrato_robot.h"
#include <BLEDevice.h>
#include <BLEServer.h>
#include <BLEUtils.h>
#include <BLE2902.h>
#include "esp_system.h"
#include "esp_task_wdt.h"

void iniciarWatchdogLoop();
struct CmdFrame;

#define ENLACE_WIFI 1
#if ENLACE_WIFI
#include <WiFi.h>
#include <WiFiUdp.h>
#endif

// ===== PINES Y RUEDAS =====
#define R1_FI  0
#define R1_BI  1
#define L1_FI  3
#define L1_BI  2
#define L2_FI  4
#define L2_BI  5
#define R2_FI  6
#define R2_BI  7
#define LED_PIN    8
#define SERVO_PIN 10

const bool LED_ACTIVO_EN_BAJO = true;
const bool FOCO_APAGADO_FW = true;
#define LED_NIVEL(encendido) \
  ((LED_ACTIVO_EN_BAJO ? !(encendido) : (encendido)) ? HIGH : LOW)

// ===== INVERSIONES DE RUEDA =====
const bool INVERT_R1 = false;
const bool INVERT_R2 = false;
const bool INVERT_L1 = false;
const bool INVERT_L2 = false;
const bool CABLEADO_INVIERTE_AVANCE = false;
const bool CABLEADO_INVIERTE_GIRO   = false;

// ===== PARÁMETROS FÍSICOS =====
const float WHEEL_RADIUS = 0.06f;
const float TRACK_WIDTH  = 0.33f;
const float V_MAX        = ROBOT_V_SCALE_MPS;
const float OMEGA_MAX    = ROBOT_OMEGA_SCALE_RPS;
const int   PWM_MAX      = 100;

// ===== CONTROL PWM PURO (sin pulsos, sin rampa) =====
const int PWM_MIN = 0;
const bool FRENO_ACTIVO = true;
const unsigned long DEAD_TIME_MS = 20;
const unsigned long MOTOR_PERIODO_MS = 200;
static unsigned long cicloMotoraAt = 0;

// ===== ANTI-HUNDIMIENTO =====
// Detecta si el robot está patinando/hundido y compensa
const bool ANTI_HUNDIMIENTO_ACTIVO = false;
const int  HISTORIAL_DUTY = 10;           // historial de últimos 10 comandos
const float ESFUERZO_UMBRAL = 0.85f;      // duty promedio > 85% = esfuerzo
const float BOOST_TORQUE = 1.15f;         // multiplica duty si detecta hundimiento
const unsigned long MONITOR_PERIODO_MS = 100;

int dutyHistorial[HISTORIAL_DUTY] = {0};
int idxHistorial = 0;
float boostActualIzq = 1.0f, boostActualDer = 1.0f;

// ===== SEGURIDAD =====
const unsigned long CMD_TIMEOUT_MS = 500;
unsigned long lastCmdMillis = 0;

#define SECUENCIA_VALIDA(seq_nuevo, seq_anterior) \
  (((uint16_t)(seq_nuevo - seq_anterior)) != 0 && ((uint16_t)(seq_nuevo - seq_anterior)) < 0x8000)

// ===== SERVO + LED =====
const int SERVO_LEDC_CANAL   = 0;
const int SERVO_LEDC_BITS    = 14;
const int SERVO_LEDC_HZ      = 50;
const int SERVO_PULSO_MIN_US = 500;
const int SERVO_PULSO_MAX_US = 2400;
bool servoListo = false;
bool scanning = false;
unsigned long scanStartMillis = 0;
const unsigned long SCAN_SWEEP_MS = 10000;
const int SERVO_MIN_ANGLE  = 25, SERVO_MAX_ANGLE  = 110, SERVO_PARK_ANGLE = 98;
int  currentServoAngle = SERVO_PARK_ANGLE;
bool ledOn = false;

// ===== ESTRUCTURA DE RUEDA =====
enum RuedaCanal : uint8_t { CH_R1 = 2, CH_R2 = 3, CH_L1 = 4, CH_L2 = 5 };

struct Rueda {
  const uint8_t pinFI, pinBI, canal;
  const bool invertida;
  int8_t sentido;
  int dutyPedido;
  bool dcCompleto;
  unsigned long frenohasta;
  int8_t sentidoAnterior;
};

// ===== SERVO =====
static uint32_t servoDuty(int angulo) {
  int us = map(angulo, 0, 180, SERVO_PULSO_MIN_US, SERVO_PULSO_MAX_US);
  return (uint32_t)((float)us * ((float)(1UL << SERVO_LEDC_BITS) / 20000.0f));
}

static void servoEscribir(int angulo) {
  if (!servoListo) return;
#if defined(ESP_ARDUINO_VERSION_MAJOR) && ESP_ARDUINO_VERSION_MAJOR >= 3
  ledcWriteChannel(SERVO_LEDC_CANAL, servoDuty(angulo));
#else
  ledcWrite(SERVO_LEDC_CANAL, servoDuty(angulo));
#endif
}

const float SERVO_GRADOS_S = 90.0f;
int servoObjetivo = SERVO_PARK_ANGLE;
float servoPosicion = SERVO_PARK_ANGLE;

void setServo(int angle) {
  servoObjetivo = constrain(angle, SERVO_MIN_ANGLE, SERVO_MAX_ANGLE);
}

void updateServo() {
  static unsigned long ultimo = millis();
  unsigned long ahora = millis();
  float dt = (ahora - ultimo) / 1000.0f;
  if (dt < 0.02f) return;
  ultimo = ahora;
  float d = servoObjetivo - servoPosicion;
  float paso = SERVO_GRADOS_S * dt;
  servoPosicion += constrain(d, -paso, paso);
  int angulo = (int)lroundf(servoPosicion);
  if (angulo != currentServoAngle) {
    currentServoAngle = angulo;
    servoEscribir(angulo);
  }
}

void setLed(bool on) {
  if (on != ledOn) {
    ledOn = on;
    digitalWrite(LED_PIN, LED_NIVEL(on));
  }
}

// ===== PROTOCOLO BLE — SIN MODIFICAR =====
#pragma pack(push, 1)
struct CmdFrame {
  uint8_t  magic;
  int8_t   v_pct;
  int8_t   omega_pct;
  uint8_t  servo_angle;
  uint8_t  flags;
  uint16_t seq;
  uint8_t  crc;
};
struct StatusFrame {
  uint8_t  magic;
  int8_t   v_pct;
  int8_t   omega_pct;
  uint8_t  servo_angle;
  uint8_t  flags;
  uint16_t seq_echo;
  uint8_t  crc;
};
#pragma pack(pop)

const uint8_t CMD_MAGIC = 0xA5, STATUS_MAGIC = 0x5A;
#define FLAG_LED     0x01
#define FLAG_SCAN    0x02
#define ST_LED       0x01
#define ST_SCANNING  0x02
#define ST_FAILSAFE  0x04
#define ST_BROWNOUT  0x08
#define ST_RECIEN    0x10
#define ST_VIA_WIFI  0x20
#define ST_WIFI_OK   0x40
#define ST_BLE_OK    0x80
const unsigned long ARRANQUE_RECIENTE_MS = 15000;
const uint8_t VIA_BLE = 1, VIA_WIFI = 2;

static uint8_t crc8(const uint8_t *datos, size_t n) {
  uint8_t crc = 0x00;
  for (size_t i = 0; i < n; i++) {
    crc ^= datos[i];
    for (uint8_t b = 0; b < 8; b++) {
      crc = (crc & 0x80) ? (uint8_t)((crc << 1) ^ 0x07) : (uint8_t)(crc << 1);
    }
  }
  return crc;
}

// ===== BLE GATT — SIN MODIFICAR =====
#define BLE_SERVICE_UUID     "a0e1b000-7f3c-4a5e-9d21-6b8e2c4f1a00"
#define BLE_CMD_CHAR_UUID    "a0e1b001-7f3c-4a5e-9d21-6b8e2c4f1a00"
#define BLE_STATUS_CHAR_UUID "a0e1b002-7f3c-4a5e-9d21-6b8e2c4f1a00"

BLEServer *pServer = nullptr;
BLECharacteristic *pStatusChar = nullptr;
bool bleConnected = false, bleWasConnected = false;

portMUX_TYPE bleMux = portMUX_INITIALIZER_UNLOCKED;
volatile bool blePending = false;
CmdFrame bleInbox;

float lastV = 0, lastOmega = 0;
float vAplicada = 0.0f, omegaAplicada = 0.0f;
uint8_t lastServo = 0;
bool lastLed = false;
uint16_t lastSeq = 0;
unsigned long tramasMalas = 0, tramasBle = 0, tramasWifi = 0, tramasViejas = 0;
uint8_t viaUltima = 0;
bool inFailsafe = true;
bool haveSequence=false,motorFault=false;
int8_t pwmPin[6]={-1,-1,-1,-1,-1,-1};
float dutyActual[6]={};
unsigned long dutyAt[6]={};

// ===== WIFI UDP — SIN MODIFICAR =====
#if ENLACE_WIFI
#define WIFI_SSID     "JETSON_AP"
#define WIFI_PASSWORD "12345678"
const uint16_t C3_UDP_PUERTO     = 5002;
const uint16_t JETSON_UDP_PUERTO = 5002;
const unsigned long WIFI_REINTENTO_MS = 5000;
const wifi_power_t WIFI_POTENCIAS[] = {WIFI_POWER_8_5dBm, WIFI_POWER_13dBm,
                                       WIFI_POWER_17dBm, WIFI_POWER_19_5dBm};
const uint8_t WIFI_N_POTENCIAS = sizeof(WIFI_POTENCIAS) / sizeof(WIFI_POTENCIAS[0]);
const uint8_t WIFI_INTENTOS_POR_POTENCIA = 3;
uint8_t wifiPotenciaIdx = 0, wifiIntentos = 0;
WiFiUDP udpC3;
bool wifiListo = false, udpAbierto = false;
IPAddress ipJetson;
#endif

volatile bool reabrirAnuncio = false;
esp_reset_reason_t motivoReinicio = ESP_RST_UNKNOWN;

const uint16_t BLE_INTERVALO_MIN = 12;
const uint16_t BLE_INTERVALO_MAX = 24;
const uint16_t BLE_SUPERVISION   = 400;

class ServerCallbacks : public BLEServerCallbacks {
  void onConnect(BLEServer *s) override {
    bleConnected = true;
    Serial.println("[ble] cliente conectado");
  }
#if defined(CONFIG_NIMBLE_ENABLED)
  void onConnect(BLEServer *s, ble_gap_conn_desc *desc) override {
    s->requestConnParams(desc->conn_handle, BLE_INTERVALO_MIN, BLE_INTERVALO_MAX, 0, BLE_SUPERVISION);
  }
#elif defined(CONFIG_BLUEDROID_ENABLED)
  void onConnect(BLEServer *s, esp_ble_gatts_cb_param_t *param) override {
    s->updateConnParams(param->connect.remote_bda, BLE_INTERVALO_MIN, BLE_INTERVALO_MAX, 0, BLE_SUPERVISION);
  }
#endif
  void onDisconnect(BLEServer *s) override {
    bleConnected = false;
    reabrirAnuncio = true;
    Serial.println("[ble] cliente desconectado");
  }
};

class CmdWriteCallback : public BLECharacteristicCallbacks {
  void onWrite(BLECharacteristic *c) override {
    String val = c->getValue();
    if (val.length() != sizeof(CmdFrame)) { tramasMalas++; return; }
    CmdFrame frame;
    memcpy(&frame, val.c_str(), sizeof(frame));
    if (frame.magic != CMD_MAGIC) { tramasMalas++; return; }
    if (crc8((const uint8_t *)&frame, sizeof(frame) - 1) != frame.crc) { tramasMalas++; return; }
    portENTER_CRITICAL(&bleMux);
    memcpy(&bleInbox, &frame, sizeof(frame));
    blePending = true;
    portEXIT_CRITICAL(&bleMux);
  }
};

// ===== MOTORES =====
Rueda ruedaR1 = {R1_FI, R1_BI, CH_R1, INVERT_R1, 0, 0, false, 0, 0};
Rueda ruedaR2 = {R2_FI, R2_BI, CH_R2, INVERT_R2, 0, 0, false, 0, 0};
Rueda ruedaL1 = {L1_FI, L1_BI, CH_L1, INVERT_L1, 0, 0, false, 0, 0};
Rueda ruedaL2 = {L2_FI, L2_BI, CH_L2, INVERT_L2, 0, 0, false, 0, 0};
Rueda *RUEDAS[4]   = {&ruedaR1, &ruedaR2, &ruedaL1, &ruedaL2};
Rueda *LADO_DER[2] = {&ruedaL2, &ruedaL1};  // DER = L2/L1 (invertido)
Rueda *LADO_IZQ[2] = {&ruedaR2, &ruedaR1};  // IZQ = R2/R1 (invertido)

static void motorSetup(uint8_t pinFI, uint8_t pinBI) {
  pinMode(pinFI, OUTPUT);
  pinMode(pinBI, OUTPUT);
  digitalWrite(pinFI, LOW);
  digitalWrite(pinBI, LOW);
}

static void motorON(uint8_t pinActivo)  { digitalWrite(pinActivo, HIGH); }
static void motorOFF(uint8_t pinActivo) { digitalWrite(pinActivo, LOW);  }
static void motorFreno(uint8_t pinFI, uint8_t pinBI) {
  digitalWrite(pinFI, LOW);
  digitalWrite(pinBI, LOW);
}

static void desactivar(Rueda &r){
 if(pwmPin[r.canal]>=0){ledcWriteChannel(r.canal,0);ledcDetach(pwmPin[r.canal]);pwmPin[r.canal]=-1;}
 digitalWrite(r.pinFI,LOW);digitalWrite(r.pinBI,LOW);dutyActual[r.canal]=0;
}
static void aplicarDuty(Rueda &r){
 unsigned long now=millis();
 if(motorFault||r.sentido==0||r.dutyPedido==0||(long)(now-r.frenohasta)<0){desactivar(r);dutyAt[r.canal]=now;return;}
 uint8_t pin=r.sentido>0?r.pinFI:r.pinBI;
 if(pwmPin[r.canal]!=pin){
  desactivar(r);
  if(!ledcAttachChannel(pin,5000,8,r.canal)){motorFault=true;return;}
  pwmPin[r.canal]=pin;dutyAt[r.canal]=now;
 }
 float dt=fminf((now-dutyAt[r.canal])/1000.f,.05f);dutyAt[r.canal]=now;
 // Ramp up only. Reductions and stops are immediate; no minimum kick.
 float goal=r.dutyPedido;
 dutyActual[r.canal]=goal<dutyActual[r.canal]?goal:fminf(goal,dutyActual[r.canal]+100.f*dt);
 ledcWriteChannel(r.canal,lroundf(dutyActual[r.canal]*255.f/100.f));
}
void setRueda(Rueda &r, int duty, int sentido) {
  duty = constrain(duty, 0, PWM_MAX);
  if (r.invertida) sentido = -sentido;
  if (duty == 0) sentido = 0;

  unsigned long ahora = millis();

  if (sentido != r.sentido) {
    desactivar(r);
    r.frenohasta = ahora + DEAD_TIME_MS;
    r.sentidoAnterior = r.sentido;
    r.sentido = sentido;
  }

  r.dutyPedido = duty;
  aplicarDuty(r);
}

// ===== ANTI-HUNDIMIENTO: Detecta esfuerzo y boostea =====
void updateAntiHundimiento() {
  if (!ANTI_HUNDIMIENTO_ACTIVO) {
    boostActualIzq = 1.0f;
    boostActualDer = 1.0f;
    return;
  }

  static unsigned long ultimoMonitor = 0;
  unsigned long ahora = millis();
  if (ahora - ultimoMonitor < MONITOR_PERIODO_MS) return;
  ultimoMonitor = ahora;

  // Registra duty promedio
  int dutyPromedio = (ruedaL1.dutyPedido + ruedaL2.dutyPedido +
                     ruedaR1.dutyPedido + ruedaR2.dutyPedido) / 4;
  dutyHistorial[idxHistorial] = dutyPromedio;
  idxHistorial = (idxHistorial + 1) % HISTORIAL_DUTY;

  // Calcula promedio histórico
  int sumaHistorial = 0;
  for (int i = 0; i < HISTORIAL_DUTY; i++) sumaHistorial += dutyHistorial[i];
  float promedioHistorial = sumaHistorial / (float)HISTORIAL_DUTY;

  // Si está a máximo esfuerzo, detecta hundimiento y aplica boost
  if (promedioHistorial > ESFUERZO_UMBRAL * PWM_MAX) {
    boostActualIzq = BOOST_TORQUE;
    boostActualDer = BOOST_TORQUE;
  } else {
    boostActualIzq = 1.0f;
    boostActualDer = 1.0f;
  }
}

// ===== CONTROL SKID-STEER: Lado IZQ y DER independientes =====
void applyMotors(float vx,float omega){
 if(CABLEADO_INVIERTE_AVANCE)vx=-vx;
 if(CABLEADO_INVIERTE_GIRO)omega=-omega;
 vx=constrain(vx,-V_MAX,V_MAX);
 // Conservative nominal limit: 17 degrees leaves 3 degrees to mechanical stop.
 const float kmax=tanf(ROBOT_STEER_LIMIT_DEG*PI/180.f)/ROBOT_WHEELBASE_M;
 omega=constrain(omega,-fabsf(vx)*kmax,fabsf(vx)*kmax);
 const float tireWidth=ROBOT_TIRE_WIDTH_M; // ESTIMATE, measure before physical calibration
 const float bf=ROBOT_FRONT_OUTER_M-tireWidth,br=ROBOT_REAR_OUTER_M-tireWidth;
 float delta=fabsf(vx)>.001f?atanf(ROBOT_WHEELBASE_M*omega/vx):0;
 float f=vx/cosf(delta);
 float vel[4]={vx-omega*br/2,vx+omega*br/2,f-omega*bf/2,f+omega*bf/2};
 float scale=V_MAX;for(float v:vel)scale=fmaxf(scale,fabsf(v));
 // Preserve original verified side mapping (R labels were physically swapped).
 Rueda *ordered[4]={LADO_IZQ[0],LADO_DER[0],LADO_IZQ[1],LADO_DER[1]};
 for(int i=0;i<4;i++)setRueda(*ordered[i],lroundf(fabsf(vel[i])/scale*100),vel[i]>=0?1:-1);
 vAplicada=vx*V_MAX/scale;omegaAplicada=omega*V_MAX/scale;
}

void stopMotors() {
  vAplicada     = 0.0f;
  omegaAplicada = 0.0f;
  for (int i = 0; i < 4; i++) setRueda(*RUEDAS[i], 0, 0);
}

void enterFailsafe(const char *motivo) {
  inFailsafe = true;
  lastV     = 0;
  lastOmega = 0;
  stopMotors();
  scanning = false;
  setLed(FOCO_APAGADO_FW);
  lastLed = FOCO_APAGADO_FW;
  Serial.print("FAILSAFE: ");
  Serial.println(motivo);
}

// ===== APLICA COMANDO — VELOCIDAD DIRECTA, PWM PURO =====
bool aplicarComando(const CmdFrame &c, uint8_t via) {
  unsigned long ahora = millis();
  if(c.v_pct<-100||c.v_pct>100||c.omega_pct<-100||c.omega_pct>100||c.servo_angle<SERVO_MIN_ANGLE||c.servo_angle>SERVO_MAX_ANGLE||(c.flags&~3)||motorFault){tramasMalas++;return false;}
  bool zero=c.v_pct==0&&c.omega_pct==0;
  bool expired=(unsigned long)(ahora-lastCmdMillis)>CMD_TIMEOUT_MS;
  if(expired&&!inFailsafe)enterFailsafe("sin comando");
  if(inFailsafe&&!zero){tramasViejas++;return false;}
  if (haveSequence && !SECUENCIA_VALIDA(c.seq, lastSeq) && !(inFailsafe&&expired&&zero)) {
    tramasViejas++;
    return false;
  }

  lastCmdMillis = ahora;
  lastSeq   = c.seq;haveSequence=true;
  viaUltima = via;
  if (via == VIA_WIFI) tramasWifi++; else tramasBle++;

  lastV     = (constrain((int)c.v_pct,     -100, 100) / 100.0f) * V_MAX;
  lastOmega = (constrain((int)c.omega_pct, -100, 100) / 100.0f) * OMEGA_MAX;
  lastServo = c.servo_angle;
  lastLed   = (c.flags & FLAG_LED) != 0;

  inFailsafe = false;

  // PWM PURO: asignación directa, sin rampa
  vAplicada     = lastV;
  omegaAplicada = lastOmega;
  applyMotors(vAplicada, omegaAplicada);

  if ((c.flags & FLAG_SCAN) && !scanning) {
    scanning = true;
    scanStartMillis = millis();
  }
  setLed(lastLed);
  if (!scanning) setServo(lastServo);
  return true;
}

void procesarBLE() {
  if (!blePending) return;
  CmdFrame c;
  portENTER_CRITICAL(&bleMux);
  memcpy(&c, &bleInbox, sizeof(c));
  blePending = false;
  portEXIT_CRITICAL(&bleMux);
  aplicarComando(c, VIA_BLE);
}

#if ENLACE_WIFI
void procesarWifi() {
  if (!udpAbierto) return;
  for (int n = 0; n < 8; n++) {
    int tam = udpC3.parsePacket();
    if (tam <= 0) return;
    if (!(udpC3.remoteIP() == ipJetson) || udpC3.remotePort()!=JETSON_UDP_PUERTO || tam != (int)sizeof(CmdFrame)) {
      tramasMalas++;
      continue;
    }
    CmdFrame c;
    if (udpC3.read((uint8_t *)&c, sizeof(c)) != (int)sizeof(c)
        || c.magic != CMD_MAGIC
        || crc8((const uint8_t *)&c, sizeof(c) - 1) != c.crc) {
      tramasMalas++;
      continue;
    }
    aplicarComando(c, VIA_WIFI);
  }
}

void gestionarWifi() {
  static unsigned long ultimoIntento = 0;
  bool asociada = (WiFi.status() == WL_CONNECTED);
  if (asociada && !wifiListo) {
    wifiListo = true;
    ipJetson  = WiFi.gatewayIP();
    udpAbierto = udpC3.begin(C3_UDP_PUERTO);
    wifiIntentos = 0;
    Serial.printf("[wifi] OK IP=%s Jetson=%s\n",
                  WiFi.localIP().toString().c_str(),
                  ipJetson.toString().c_str());
  } else if (!asociada && wifiListo) {
    wifiListo  = false;
    if (udpAbierto) udpC3.stop();
    udpAbierto = false;
    ultimoIntento = millis();
    Serial.println("[wifi] perdida");
  }
  if (!asociada && millis() - ultimoIntento > WIFI_REINTENTO_MS) {
    ultimoIntento = millis();
    if (++wifiIntentos > WIFI_INTENTOS_POR_POTENCIA) {
      wifiIntentos = 1;
      wifiPotenciaIdx = (wifiPotenciaIdx + 1) % WIFI_N_POTENCIAS;
    }
    WiFi.disconnect();
    WiFi.begin(WIFI_SSID, WIFI_PASSWORD);
    WiFi.setTxPower(WIFI_POTENCIAS[wifiPotenciaIdx]);
  }
}
#endif

void enviarEstado() {
  bool porBle  = bleConnected && pStatusChar != nullptr;
#if ENLACE_WIFI
  bool porWifi = wifiListo && udpAbierto;
#else
  bool porWifi = false;
#endif

  StatusFrame st;
  st.magic     = STATUS_MAGIC;
  st.v_pct     = (int8_t)constrain((int)lroundf(lastV     / V_MAX     * 100.0f), -100, 100);
  st.omega_pct = (int8_t)constrain((int)lroundf(lastOmega / OMEGA_MAX * 100.0f), -100, 100);
  st.servo_angle = (uint8_t)currentServoAngle;
  st.flags = 0;
  if (ledOn)      st.flags |= ST_LED;
  if (scanning)   st.flags |= ST_SCANNING;
  if (inFailsafe) st.flags |= ST_FAILSAFE;
  if (motivoReinicio == ESP_RST_BROWNOUT)  st.flags |= ST_BROWNOUT;
  if (millis() < ARRANQUE_RECIENTE_MS)     st.flags |= ST_RECIEN;
  if (viaUltima == VIA_WIFI)               st.flags |= ST_VIA_WIFI;
  if (porWifi)                             st.flags |= ST_WIFI_OK;
  if (bleConnected)                        st.flags |= ST_BLE_OK;
  st.seq_echo = lastSeq;
  st.crc = crc8((uint8_t *)&st, sizeof(st) - 1);

  if (porBle) {
    pStatusChar->setValue((uint8_t *)&st, sizeof(st));
    pStatusChar->notify();
  }
#if ENLACE_WIFI
  if (porWifi) {
    udpC3.beginPacket(ipJetson, JETSON_UDP_PUERTO);
    udpC3.write((const uint8_t *)&st, sizeof(st));
    udpC3.endPacket();
  }
#endif
}

#define TEST_MOTORES 0

#if TEST_MOTORES
void testArranque() {
  Serial.println("[TEST] R1 adelante...");
  digitalWrite(R1_FI, HIGH); delay(300); digitalWrite(R1_FI, LOW); delay(100);

  Serial.println("[TEST] R2 adelante...");
  digitalWrite(R2_FI, HIGH); delay(300); digitalWrite(R2_FI, LOW); delay(100);

  Serial.println("[TEST] L1 adelante...");
  digitalWrite(L1_FI, HIGH); delay(300); digitalWrite(L1_FI, LOW); delay(100);

  Serial.println("[TEST] L2 adelante...");
  digitalWrite(L2_FI, HIGH); delay(300); digitalWrite(L2_FI, LOW); delay(100);

  Serial.println("[TEST] Todas adelante 500ms...");
  digitalWrite(R1_FI, HIGH);
  digitalWrite(R2_FI, HIGH);
  digitalWrite(L1_FI, HIGH);
  digitalWrite(L2_FI, HIGH);
  delay(500);
  digitalWrite(R1_FI, LOW);
  digitalWrite(R2_FI, LOW);
  digitalWrite(L1_FI, LOW);
  digitalWrite(L2_FI, LOW);
  Serial.println("[TEST] OK");
}
#endif

void setup() {
  const int pinesMotor[] = {R1_FI, R1_BI, R2_FI, R2_BI, L1_FI, L1_BI, L2_FI, L2_BI};
  for (int p : pinesMotor) {
    pinMode(p, OUTPUT);
    digitalWrite(p, LOW);
  }
  stopMotors();

  pinMode(LED_PIN, OUTPUT);
  ledOn = !FOCO_APAGADO_FW;
  setLed(FOCO_APAGADO_FW);
  motivoReinicio = esp_reset_reason();

  Serial.begin(115200);
  unsigned long t0Serial = millis();
  while (!Serial && millis() - t0Serial < 1500) delay(10);
  delay(200);

  Serial.println();
  Serial.println("=== AGROBOT C3 v3 — SKID-STEER + PWM PURO ===");

#if TEST_MOTORES
  testArranque();
#endif

#if defined(ESP_ARDUINO_VERSION_MAJOR) && ESP_ARDUINO_VERSION_MAJOR >= 3
  servoListo = ledcAttachChannel(SERVO_PIN, SERVO_LEDC_HZ, SERVO_LEDC_BITS, SERVO_LEDC_CANAL);
#else
  servoListo = (ledcSetup(SERVO_LEDC_CANAL, SERVO_LEDC_HZ, SERVO_LEDC_BITS) != 0);
  if (servoListo) ledcAttachPin(SERVO_PIN, SERVO_LEDC_CANAL);
#endif
  servoEscribir(SERVO_PARK_ANGLE);
  currentServoAngle = SERVO_PARK_ANGLE;

  BLEDevice::init("AGROBOT-C3");
  BLEDevice::setPower(ESP_PWR_LVL_P9);
  pServer = BLEDevice::createServer();
  pServer->setCallbacks(new ServerCallbacks());
  BLEService *pService = pServer->createService(BLE_SERVICE_UUID);
  BLECharacteristic *pCmdChar = pService->createCharacteristic(
    BLE_CMD_CHAR_UUID,
    BLECharacteristic::PROPERTY_WRITE | BLECharacteristic::PROPERTY_WRITE_NR
  );
  pCmdChar->setCallbacks(new CmdWriteCallback());
  pStatusChar = pService->createCharacteristic(
    BLE_STATUS_CHAR_UUID,
    BLECharacteristic::PROPERTY_READ | BLECharacteristic::PROPERTY_NOTIFY
  );
#if !defined(CONFIG_NIMBLE_ENABLED)
  pStatusChar->addDescriptor(new BLE2902());
#endif
  pService->start();
  BLEAdvertising *pAdv = BLEDevice::getAdvertising();
  pAdv->addServiceUUID(BLE_SERVICE_UUID);
  pAdv->setScanResponse(true);
  pAdv->setMinPreferred(0x06);
  pAdv->setMaxPreferred(0x12);
  BLEDevice::startAdvertising();
  Serial.println("BLE activo");

#if ENLACE_WIFI
  WiFi.setHostname("agrobot-c3");
  WiFi.mode(WIFI_STA);
  WiFi.setAutoReconnect(true);
  WiFi.begin(WIFI_SSID, WIFI_PASSWORD);
  WiFi.setTxPower(WIFI_POTENCIAS[0]);
  Serial.println("WiFi asociando...");
#endif

  lastCmdMillis = millis();
  iniciarWatchdogLoop();
}

const uint32_t WDT_LOOP_MS = 4000;

void iniciarWatchdogLoop() {
#if defined(ESP_ARDUINO_VERSION_MAJOR) && ESP_ARDUINO_VERSION_MAJOR >= 3
  esp_task_wdt_config_t cfg = {WDT_LOOP_MS, 0, true};
  if (esp_task_wdt_reconfigure(&cfg) != ESP_OK) esp_task_wdt_init(&cfg);
#else
  esp_task_wdt_init((WDT_LOOP_MS + 999) / 1000, true);
#endif
  enableLoopWDT();
}

unsigned long ultimoEstadoBle = 0;
const unsigned long ESTADO_PERIODO_BLE_MS = 100;

void loop() {
  procesarBLE();
#if ENLACE_WIFI
  procesarWifi();
  gestionarWifi();
#endif

  static unsigned long ultimoRearme = 0;
  if (!bleConnected && (reabrirAnuncio || millis() - ultimoRearme > 5000)) {
    reabrirAnuncio = false;
    ultimoRearme   = millis();
    delay(20);
    pServer->startAdvertising();
  }
  bleWasConnected = bleConnected;

  if (!inFailsafe && millis() - lastCmdMillis > CMD_TIMEOUT_MS) {
    enterFailsafe("sin comando");
  }

  // Actualización de sistemas
  // No inferred boost: no current or motion feedback exists.
  for(Rueda *r:RUEDAS)aplicarDuty(*r);
  updateServo();

  if(motorFault&&!inFailsafe)enterFailsafe("PWM hardware");
  static unsigned long diag=0;
  if(millis()-diag>=5000){diag=millis();Serial.printf("[diag] uptime=%lu reset=%d heap=%u minheap=%u BLE=%d WiFi=%d bad=%lu old=%lu\n",millis(),(int)motivoReinicio,ESP.getFreeHeap(),ESP.getMinFreeHeap(),(int)bleConnected,(int)WiFi.status(),tramasMalas,tramasViejas);}
  delay(2);
  // Log cada 500ms
  static unsigned long ultimaTraza = 0;
  if (millis() - ultimaTraza >= 500) {
    ultimaTraza = millis();
    Serial.printf("[skid-steer] v=%.2f w=%.2f fs=%d boost=%.2f/%.2f | "
                  "L:%+d/%3d D:%+d/%3d\n",
                  lastV, lastOmega, (int)inFailsafe,
                  boostActualIzq, boostActualDer,
                  ruedaL1.sentido, ruedaL1.dutyPedido,
                  ruedaR1.sentido, ruedaR1.dutyPedido);
  }

  if (millis() - ultimoEstadoBle >= ESTADO_PERIODO_BLE_MS) {
    ultimoEstadoBle = millis();
    enviarEstado();
  }
}
