DAvolmx/AGROBOT_V1/agrobot_system_2/jetson/backend/jetson_server.py

"""
AgroBot — backend en la Jetson (`jetson_server.py`).
====================================================
El nombre del archivo importa: antes este módulo y el de la Raspberry Pi se
llamaban los DOS `server.py`. Como Python importa por NOMBRE de módulo (no
por ruta), un `import server` cargaba el que estuviera primero en sys.path
— el archivo equivocado, sin ningún aviso. Ahora cada uno tiene un nombre
único: `jetson_server.py` acá y `gateway_server.py` en la Raspberry Pi.

Une en un solo proceso asyncio:

  - Servidor UDP puerto 5001  <- ESP32 LoRa V3 (telemetría ambiental JSON)
  - Servidor UDP puerto 5002 <-> ESP32-C3 Mini (comandos binarios / status)
  - WebSocket /ws              -> dashboard (push inmediato, sin polling)
  - MJPEG      /video          -> cámara + overlay de detección YOLO
  - REST       /api/*          -> modelos, hardware, calibración, misión
  - Estáticos  /                -> dashboard/index.html

Diseño para latencia mínima: todo es push (ver README). Nada aquí depende
de internet — este proceso corre dentro de la red aislada del AP.
"""
import asyncio
import glob
import json
import math
import os
import subprocess
import time
from pathlib import Path

import aiohttp
from aiohttp import web, WSMsgType
try:
    import cv2
except ImportError:
    cv2 = None

from protocol import SERVO_HOME_DEG, clamp_servo
from ble_link import BleActuatorLink
import imu_nivel
import anticolision
import vision_activa as vision_activa_mod
import entorno_auto
from enlace_c3 import EnlaceC3
import udp_actuator_link
import config_store
import perfiles_entorno
import health
from slam import PoseEstimator, LidarReactive, MapManager
from costmap_local import CostmapLocal
from ros_bridge import AgroBotROSBridge, ROS_UNAVAILABLE_REASON
from camera import CameraWorker
from obstacle_avoidance import ControladorEvasion, LecturasSensoresLIDAR
from patrol import PatrolController
from pulse_drive import ConductorPulsos, ACCIONES, MODOS
from mapas import GestorMapas, ErrorMapa, validar_nombre as validar_nombre_mapa
from scan_mapa import scan_a_mapa
from mapa_scan import MapaScan
import simulador_visual
from asistido import Asistido
from servo_bajo import ServoBajo
from zoom_auto import ZoomAuto, DEFECTOS as ZOOM_DEFECTOS
from odometria_webcam import OdometriaWebcam, SERVO_TOLERANCIA_DEG
from explorador import ExploradorReactivo
from sendero import SeguidorSendero
from navigation_logger import NavigationLogger, analizar_sesion
from aprendizaje import Aprendizaje
from paso_robotico import PasoRobotico
from suelo_libre import SueloLibre
from camara_lidar import CamaraComoLidar
from maniobra_giro import ManiobraGiro
import misiones as misiones_mod
from reloj import DetectorSalto
from vigia_pose import VigiaPose, OK as LOC_OK, ANCLADA as LOC_ANCLADA, PERDIDA as LOC_PERDIDA
from giro_objetivo import girar_a_rumbo
from detector_vuelco import DetectorVuelco, VUELCO as V_VUELCO, PRECAUCION as V_PRECAUCION
import suelo_libre as suelo_mod
from barrido_tilt import (BarridoTilt, FrenoProactivo, EstimadorAltura,
                          inclinacion_por_servo, SERVO_LEJOS_DEG, SERVO_CERCA_DEG)
from grabador import Grabador, TELEMETRIA_HZ
import evasion as evasion_mod
from cabeceo import CabeceoIMU
from politica import Politica
from deslizamiento import MonitorDeslizamiento
from modo_seguro import ModoSeguro, NORMAL, SEGURO, PRECAUCION
from supervisor_movimiento import SupervisorMovimiento
from manual_demo import command as demo_command, reference as demo_reference
from c3_setup import C3Setup
c3_setup = C3Setup()
from c3_pines import C3Pines
c3_pines = C3Pines(lambda: enlace_c3)
from auto_comunicacion import inicializar_auto_comunicacion

# =============================================
# ===== CONFIG =====
# =============================================
JETSON_AP_IP = "192.168.12.1"
LORA_UDP_PORT = 5001
HTTP_PORT = 8080
CMD_SEND_HZ = 20
# Gateway de la Raspberry Pi. Las alarmas que hay que hacer llegar al
# celular del operador se empujan al gateway por LAN y él las publica en
# Telegram. La Pi va por cable al router "LoRa-Wan" (DIR-615 en modo router),
# que le reserva 192.168.0.10 por MAC; la Jetson llega a ella como cliente
# WiFi de esa misma red. Si el gateway está apagado, esto falla en silencio:
# avisar es deseable, pero nunca a costa de frenar la detección o el control.
GATEWAY_ALERT_URL = os.environ.get(
    "AGROBOT_GATEWAY_URL", "http://192.168.0.10:8092") + "/api/alert"
GATEWAY_ALERT_TIMEOUT_S = 4

# UNA sola sesion HTTP para todo el proceso, no una por aviso.
#
# `aiohttp.ClientSession()` no es un objeto barato: monta su propio conector,
# su pool de conexiones y su resolutor de DNS. Crear una por deteccion —que es
# lo que hacia `_avisar_al_gateway`— significa montarlos y tirarlos cientos de
# veces por hora, y aiohttp avisa en su documentacion de que cerrar una sesion
# no libera los transportes de inmediato.
#
# Encaja con lo medido el 2026-09-06: la memoria crecia ~6 MB/min SOLO cuando
# habia detecciones, y quedaba plana con la camara viendo pero sin detectar.
_sesion_http: "aiohttp.ClientSession | None" = None

# Tareas sueltas lanzadas desde el camino de deteccion, con referencia y tope.
#
# Dos motivos, los dos reales:
#   · asyncio guarda solo una referencia DEBIL a las tareas creadas con
#     create_task(). Sin guardarlas aqui, el recolector puede llevarse una a
#     medias y el trabajo se pierde en silencio (esta documentado en asyncio).
#   · sin tope, una racha de detecciones con el gateway lento encola tareas
#     sin limite, y la de guardar la captura retiene un FOTOGRAMA COMPLETO
#     cada una. Es la via mas directa a quedarse sin memoria.
_tareas_sueltas: set = set()
MAX_TAREAS_SUELTAS = 24


def _lanzar(coro, etiqueta: str = ""):
    """Lanza una corrutina de fondo con referencia fuerte y tope."""
    if len(_tareas_sueltas) >= MAX_TAREAS_SUELTAS:
        # Se DESCARTA en vez de encolar. Si hay 24 avisos pendientes, el
        # problema no se arregla apilando el numero 25: se arregla dejando
        # que se vacien. Perder un aviso es preferible a perder el proceso.
        coro.close()
        print(f"[tareas] descartada '{etiqueta}': ya hay {len(_tareas_sueltas)} "
              f"pendientes (tope {MAX_TAREAS_SUELTAS})")
        return None
    t = asyncio.create_task(coro)
    _tareas_sueltas.add(t)
    t.add_done_callback(_tareas_sueltas.discard)
    return t
# Tope del paso de tiempo de la rampa de velocidad: 3 periodos de comando.
# Absorbe jitter normal del stream sin permitir que una pausa larga se
# traduzca en un salto de velocidad grande (ver _apply_ramp).
RAMP_MAX_DT = 3.0 / CMD_SEND_HZ
# Hombre muerto: si nadie pide velocidad en este tiempo, el objetivo pasa a
# cero. Nav2 publica /cmd_vel a 10 Hz y el conductor por pulsos a 20 Hz, así
# que 0,5 s son 5 mensajes perdidos seguidos: solo salta si el que mandaba
# desapareció (navegador cerrado, WiFi caído, Nav2 muerto).
DEADMAN_S = 0.5
# Relativas a ESTE archivo, no al directorio de trabajo. Con `Path("./models")`
# el backend usaba carpetas distintas según desde dónde se lo lanzara:
# `arrancar.sh` hace `cd` y funcionaba, pero un `python3 jetson/backend/
# jetson_server.py` desde la raíz del repo creaba `./models` y `./captures`
# ahí, no encontraba los modelos y guardaba las fotos en otro lado — todo en
# silencio, sin un solo error.
_AQUI = Path(__file__).resolve().parent
SESSION_REPORT_DIR = _AQUI / "session_reports"
MODELS_DIR = _AQUI / "models"
CAPTURES_DIR = _AQUI / "captures"
MAPS_DIR = Path(__file__).parent.parent.parent / "ros2_ws" / "src" / "agrobot_navigation" / "maps"

SESSION_REPORT_DIR.mkdir(exist_ok=True)
MODELS_DIR.mkdir(exist_ok=True)
CAPTURES_DIR.mkdir(exist_ok=True)

# Fallback casero (slam.py) — se sigue usando si ROS/rclpy no está
# disponible en este entorno, o como respaldo del filtro complementario
# mientras el EKF de robot_localization no haya publicado pose todavía.
pose_estimator = PoseEstimator()
# Cabeceo del chasis a partir del MPU6050. Se crea aquí porque la telemetría
# empieza a llegar antes de que arranque la cámara; el signo se ajusta al
# cargar la configuración.
cabeceo_imu = CabeceoIMU()
lidar_reactive = LidarReactive()
# Suelo libre por cámara: lo bajo que el LIDAR no ve (cobija, pesa: 2026-10-02).
suelo_libre = SueloLibre(cfg={"metodo": "apariencia"})   # 2026-10-22: sin los «0 m» falsos del histograma en baldosa
camara_lidar = CamaraComoLidar()


def _cargar_modelo_transitabilidad():
    """autonomia.suelo_modelo = ruta de un .pt de entrenar_trav.py: suelo_libre usa la UNet (libre/obstáculo) en vez de la apariencia. Si falla, sigue con la apariencia."""
    ruta = state.config.get("autonomia", {}).get("suelo_modelo", "")
    if not ruta:
        return
    try:
        from transitabilidad import Transitabilidad
        suelo_libre.segmentador = Transitabilidad(ruta)
        suelo_libre.metodo = "modelo"
        print(f"[suelo] modelo de transitabilidad cargado: {ruta}", flush=True)
    except Exception as exc:  # noqa: BLE001
        print(f"[suelo] no se pudo cargar el modelo ({type(exc).__name__}: {exc}); sigo con la apariencia", flush=True)
lidar_reactive.hueco_camara = lambda: suelo_libre.hueco_delante(
    state.config["slam"]["robot_ancho_cm"] / 100.0)
# Barrido de tilt + freno proactivo por envolvente de vuelco (ver barrido_tilt.py).
# Se activa con autonomia.barrido_tilt (OFF por defecto): mueve el servo para ver
# lo bajo que el LIDAR no ve y frena antes de volcar/atrancarse.
barrido_tilt_ctrl = BarridoTilt()
freno_proactivo = FrenoProactivo()
# Estima la altura del montículo por paralaje al acercarse (ver barrido_tilt.py).
# h_cam ~ altura de la cámara sobre el suelo.
estimador_altura = EstimadorAltura(h_cam=0.4)
costmap = CostmapLocal()
map_manager = MapManager()

ros_fused_pose: dict | None = None
# Monotónico de cuándo llegó la última pose del EKF. Sin esto, `current_pose()`
# devolvía la última pose para siempre aunque el EKF dejara de publicar: una
# pose CONGELADA que el dashboard y la lógica tomaban como viva (auditoría
# 2026-10-07). Con el sello se puede saber su antigüedad y no confiar en ella.
ros_fused_pose_t: float | None = None
# Pasado este umbral sin pose nueva del EKF, la localización deja de ser fiable.
POSE_VIEJA_S = 1.5
ros_last_map: dict | None = None

# Sistema de evasión de obstáculos (NUEVO 2026-09-13)
obstacle_controller: "ControladorEvasion | None" = None


# =============================================
# ===== ESTADO COMPARTIDO =====
# =============================================
class SharedState:
    def __init__(self):
        self.env_telemetry = {}
        self.env_history = []          # para histogramas del dashboard
        self.actuator_status = {}
        self.detections = []
        self.captures = []             # fotos guardadas al detectar plaga (galería de misión)
        self.system_stats = {}
        self.mission_active = False
        self.config = config_store.load()
        self.ws_clients: set[web.WebSocketResponse] = set()
        self._seq = 0
        # Estado deseado de los actuadores auxiliares. Es PEGAJOSO a
        # propósito: los comandos de movimiento salen a 20 Hz y también los
        # manda Nav2 por /cmd_vel, así que el servo y el LED no pueden
        # viajar en cada mensaje de control — si no, mover el robot con las
        # flechas reposicionaría la cámara y apagaría la luz. Se guardan
        # acá y se adjuntan a TODO paquete saliente.
        # Arranca mirando al frente, no en 0: 0° está fuera del recorrido útil
        # del servo montado y el primer comando lo mandaba contra el tope.
        self.servo_angle = SERVO_HOME_DEG   # ángulo del operador (sin offset)
        self.led_on = False

    def next_seq(self) -> int:
        self._seq = (self._seq + 1) & 0xFFFF
        return self._seq

    def push_env_history(self, d: dict):
        self.env_history.append({
            "t": time.time(),
            "co2": d.get("co2", 0),
            "temp": d.get("tempSCD", 0),
            "hum": d.get("humidity", 0),
        })
        cutoff = time.time() - 120
        self.env_history = [p for p in self.env_history if p["t"] >= cutoff]

    async def broadcast(self, message: dict):
        """Manda el mensaje a todos los clientes EN PARALELO.

        Antes era un `await ws.send_str()` por cliente en serie: un cliente
        lento (Wi-Fi malo, pestaña en segundo plano) hacía esperar a todos
        los demás, y a 10 Hz de scan eso se acumula. Con `gather` el lento
        solo se retrasa a sí mismo."""
        # El grabador ve TODO lo anunciado, haya o no un dashboard abierto.
        if grabador is not None:
            grabador.evento(message)
        clientes = list(self.ws_clients)
        if not clientes:
            return
        payload = json.dumps(message)
        resultados = await asyncio.gather(
            *(ws.send_str(payload) for ws in clientes),
            return_exceptions=True)
        for ws, res in zip(clientes, resultados):
            if isinstance(res, Exception):
                self.ws_clients.discard(ws)


state = SharedState()


# =============================================
# ===== UDP: TELEMETRÍA AMBIENTAL (ESP32 LoRa V3, puerto 5001) =====
# =============================================
# Campos que la ESP32 LoRa V3 manda en cada trama (ver §5 del MANIFEST).
ENV_FIELDS = ("accelX", "accelY", "accelZ", "gyroX", "gyroY", "gyroZ",
              "co2", "tempSCD", "humidity")

# Cada cuánto se refresca lo que mira una persona. El nodo manda a 20 Hz para
# el EKF; el dashboard no necesita ni la décima parte.
DASHBOARD_PERIODO_S = 0.5
_ultimo_envio_dashboard = 0.0


def _unit(value, lo: float = -1.0, hi: float = 1.0) -> float:
    """Fracción del mando manual, saneada. Un cliente WebSocket es entrada
    no confiable: un `null`, un texto o un 99 no pueden convertirse en un
    comando de motores, así que lo que no sea un número usable vale 0."""
    try:
        v = float(value)
    except (TypeError, ValueError):
        return 0.0
    if v != v:          # NaN: cualquier comparación con NaN da False, así
        return 0.0      # que el clamp de abajo lo dejaría pasar entero
    return max(lo, min(hi, v))


def normalize_env(payload: dict) -> dict:
    """
    Garantiza que TODO campo esperado exista como float finito. Si un sensor
    no llegó a inicializarse (I2C sin responder, cable flojo) el campo puede
    venir ausente, en null, o como NaN/inf; en cualquiera de esos casos se
    entrega `0.0`, que es lo pedido para que nada aguas abajo se rompa —
    el filtro de pose, el EKF y el dashboard siempre reciben un número.

    Pero 0.0 por "sensor caído" y 0.0 por "medición real de cero" NO son lo
    mismo, y confundirlos sería inventar datos. Por eso se agrega
    `_sensors_missing`: la lista de campos que fueron sustituidos. La UI
    muestra el 0.0 marcado como no disponible en vez de graficarlo como si
    fuera una lectura buena.
    """
    missing = []
    for field in ENV_FIELDS:
        value = payload.get(field)
        try:
            number = float(value)
        except (TypeError, ValueError):
            number = None
        if number is None or not math.isfinite(number):
            payload[field] = 0.0
            missing.append(field)
        else:
            payload[field] = number
    # 2026-10-23: el firmware del nodo (esp32_lora_v3) marca el SCD40 como listo sin comprobar que responde y, si nunca hay medida,
    # manda co2=0, tempSCD=0, humidity=0. Los tres a cero a la vez es imposible en la realidad: es «sensor ambiental no disponible».
    if all(payload.get(k) == 0.0 for k in ("co2", "tempSCD", "humidity")):
        missing.extend(k for k in ("co2", "tempSCD", "humidity") if k not in missing)
    payload["_sensors_missing"] = missing
    return payload


# Pérdidas y reinicios del nodo LoRa V3, deducidos de su `seq`.
enlace_lora = health.ContadorSecuencia()


class SesgoGiroscopio:
    """Sesgo del giroscopio estimado solo, con el robot quieto.

    En la configuración estaba en 0 (nunca se calibró) y el MPU6050 marca
    +0,92 °/s en Z estando quieto: la pose giraba 53° por minuto sin moverse
    (2026-09-30). Cada vez que el robot lleva ZUPT_TRAS_S sin orden de
    moverse, las lecturas son puro sesgo + ruido: se promedian (media simple
    al principio, luego media móvil de TAU_S) y se restan. Así se corrige
    también en marcha, y se sigue la deriva térmica del sensor."""

    TAU_S = 30.0
    MIN_MUESTRAS = 100          # ~5 s a 20 Hz antes de aplicarlo
    SALTO_DPS = 20.0            # una lectura así en reposo es un golpe, no sesgo

    def __init__(self):
        self.sesgo = {"gyroX": 0.0, "gyroY": 0.0, "gyroZ": 0.0}
        self.muestras = 0
        self._t = None

    @property
    def listo(self) -> bool:
        return self.muestras >= self.MIN_MUESTRAS

    def actualizar(self, lectura: dict, quieto: bool, ahora: float):
        if not quieto:
            self._t = None
            return
        if any(abs(lectura.get(e, 0.0) - b) > self.SALTO_DPS for e, b in self.sesgo.items()) and self.listo:
            return
        dt = 0.05 if self._t is None else min(max(ahora - self._t, 0.0), 0.5)
        self._t = ahora
        self.muestras += 1
        a = 1.0 / self.muestras if not self.listo else dt / self.TAU_S
        for eje in self.sesgo:
            self.sesgo[eje] += a * (lectura.get(eje, 0.0) - self.sesgo[eje])


sesgo_giro = SesgoGiroscopio()


from lora_sensor_codec import SampleGate
from ambiente_simulado import AmbienteSimulado
ambiente_simulado = AmbienteSimulado()
lora_sample_gate=SampleGate()

class EnvTelemetryProtocol(asyncio.DatagramProtocol):
    def connection_made(self, transport):
        self.transport = transport

    def datagram_received(self, data, addr):
        try:
            payload = json.loads(data.decode("utf-8"))
        except (json.JSONDecodeError, UnicodeDecodeError):
            return
        if not isinstance(payload, dict):
            return

        # Comando bajado por LoRaWAN y reenviado por el nodo LoRa V3. Llega
        # por el MISMO puerto que la telemetría porque el nodo ya tenía ese
        # socket abierto: abrir un segundo puerto solo para esto habría
        # añadido una pieza más que puede quedar mal configurada, para un
        # mensaje que llega como mucho una vez cada media hora.
        #
        # Es la vía de último recurso: cuando el robot está fuera del alcance
        # del AP, el enlace LoRa es lo único que queda. Por eso la parada de
        # emergencia se ejecuta aquí directamente en vez de pasar por el
        # dashboard, que en ese escenario no tiene a nadie mirándolo.
        if payload.get("type") == "lora_downlink":
            comando = payload.get("cmd")
            print(f"[lora] comando por downlink desde {addr[0]}: {comando}")
            if comando in ("emergency_stop", "park"):
                # `actuator_proto` es None hasta que el socket del C3 se abre
                # en el arranque. Sin esta guarda, un downlink que llegara
                # antes (o con el socket caído) lanzaría AttributeError
                # DENTRO del callback de UDP, que asyncio se traga: la
                # parada fallaría sin dejar rastro. Justo el caso en el que
                # menos se puede fallar en silencio.
                if actuator_proto is None:
                    print("[lora] ✗ PARADA NO EJECUTADA: el enlace con el "
                          "ESP32-C3 todavía no está abierto")
                    return
                _parada_total(f"LoRa {comando}")
                _lanzar(state.broadcast({
                    "type": "emergency_stop",
                    "data": {"origen": "lora_downlink", "comando": comando},
                }))
                # Se avisa al gateway para que lo publique en Telegram: una
                # parada disparada por radio es justo el evento que el
                # operador NO está viendo en pantalla.
                _lanzar(_avisar_al_gateway({
                    "titulo": "Parada de emergencia por LoRa",
                    "detalle": f"El robot ejecutó '{comando}' recibido por "
                               f"downlink LoRaWAN.",
                    "tipo": "sistema",
                }))
            return

        if payload.get("sensor_v") == 3 and not lora_sample_gate.accept(payload):
            return

        seq = payload.get("seq")
        if isinstance(seq, (int, float)) and enlace_lora.registrar(int(seq)):
            print(f"[lora] el nodo LoRa V3 se reinició (#{enlace_lora.reinicios} desde que "
                  f"arrancó el backend): si se repite, revisa su alimentación", flush=True)
        payload = normalize_env(payload)
        if state.config["calibration"].get("ambiente_simulado"):
            payload = ambiente_simulado.aplicar(payload)
        # Corrección de bias del giroscopio (calibración). Se aplica ACÁ, lo
        # más cerca posible de la entrada, para que todo lo de aguas abajo
        # (pose casera, EKF de ROS, dashboard) vea el mismo dato corregido.
        # Antes estos offsets se guardaban en la config y no se aplicaban en
        # ningún lado: calibrar desde el dashboard no hacía absolutamente nada.
        cal = state.config["calibration"]
        for axis, bias_key in (("gyroX", "gyro_bias_x_dps"),
                               ("gyroY", "gyro_bias_y_dps"),
                               ("gyroZ", "gyro_bias_z_dps")):
            if axis in payload:
                payload[axis] = payload[axis] - cal[bias_key]
        # Nivel del montaje (imu_nivel.py): con la gravedad medida en nivel se gira el acelerómetro y el
        # giroscopio para que «arriba» sea arriba. Se conserva el acelerómetro CRUDO para recalibrar.
        if all(k in payload for k in ("accelX", "accelY", "accelZ")):
            payload["_acc_raw"] = (payload["accelX"], payload["accelY"], payload["accelZ"])
            R = _matriz_nivel_cache(cal.get("imu_gravedad_nivel"))
            if R is not None:
                payload["accelX"], payload["accelY"], payload["accelZ"] = imu_nivel.aplicar(R, payload["_acc_raw"])
                if all(k in payload for k in ("gyroX", "gyroY", "gyroZ")):
                    payload["gyroX"], payload["gyroY"], payload["gyroZ"] = imu_nivel.aplicar(
                        R, (payload["gyroX"], payload["gyroY"], payload["gyroZ"]))
        # Autocalibración en reposo (ver SesgoGiroscopio). Sin enlace con la
        # C3 el robot no puede moverse: también cuenta como quieto.
        quieto = actuator_proto is None or actuator_proto.segundos_quieto() > ZUPT_TRAS_S
        sesgo_giro.actualizar(payload, quieto, time.monotonic())
        if sesgo_giro.listo:
            for axis, b in sesgo_giro.sesgo.items():
                if axis in payload:
                    payload[axis] = payload[axis] - b

        payload["_received_at"] = time.time()
        payload["_source"] = addr[0]
        state.env_telemetry = payload
        health.beat("lora_v3")

        # --- CAMINO RÁPIDO: todo lo que consume el estimador de pose ---
        # Va a la frecuencia completa del nodo (20 Hz desde 2026-09-06), que
        # es justo la `frequency: 20.0` del EKF en ekf.yaml.
        pose_estimator.on_gyro(payload.get("gyroZ", 0.0))
        # El mismo paquete sirve para saber cuánto cabecea el chasis, que es
        # lo que descuadra la vista del sendero (ver cabeceo.py).
        cabeceo_imu.actualizar(payload.get("accelX", 0.0), payload.get("accelY", 0.0),
                               payload.get("accelZ", 0.0), payload.get("gyroX", 0.0),
                               time.monotonic())
        # IMU montado con Y adelante, X a los lados. ROS quiere X adelante,
        # Y izquierda, Z arriba. Remap: ROS_x=sensor_y, ROS_y=-sensor_x.
        ros_bridge.publish_imu(
            {"x": payload.get("accelY", 0.0), "y": -payload.get("accelX", 0.0), "z": payload.get("accelZ", 0.0)},
            {"x": payload.get("gyroY", 0.0), "y": -payload.get("gyroX", 0.0), "z": payload.get("gyroZ", 0.0)},
        )

        # --- CAMINO LENTO: lo que solo mira una persona ---
        # El dashboard y el histórico se limitan a 2 Hz a propósito. A 20 Hz
        # serían 20 mensajes WebSocket por segundo a cada navegador —más
        # rápido de lo que un ojo distingue y suficiente para que el gráfico
        # se atragante— y `push_env_history()` reconstruye su lista entera en
        # cada llamada, así que a 20 Hz pasa a ser trabajo O(n) 20 veces por
        # segundo sobre 2400 puntos.
        #
        # El dato de navegación NO se toca: ese ya salió arriba, entero.
        global _ultimo_envio_dashboard
        ahora = payload["_received_at"]
        if ahora - _ultimo_envio_dashboard >= DASHBOARD_PERIODO_S:
            _ultimo_envio_dashboard = ahora
            state.push_env_history(payload)
            _lanzar(state.broadcast({"type": "env_telemetry", "data": payload}), "env_telemetry")


_nivel_cache = {"g": None, "R": None}


def _matriz_nivel_cache(g):
    """Matriz de nivel del IMU, recalculada solo cuando cambia la gravedad guardada."""
    if not g:
        return None
    clave = tuple(g)
    if _nivel_cache["g"] != clave:
        _nivel_cache["g"], _nivel_cache["R"] = clave, imu_nivel.matriz_nivel(g)
    return _nivel_cache["R"]


IMU_VIEJO_S = 3.0    # telemetría del IMU más vieja que esto = el nodo está apagado: no se usa


def _imu_fresco() -> bool:
    ra = (state.env_telemetry or {}).get("_received_at")
    return ra is not None and time.time() - ra <= IMU_VIEJO_S


async def calibrar_imu_nivel_handler(request: web.Request):
    """POST /api/calibracion/imu_nivel  {"reset": true} para borrarla.
    Con el robot QUIETO y NIVELADO: promedia ~5 s de acelerómetro crudo y guarda la gravedad medida; desde
    entonces el IMU se usa corregido (inclinación y cabeceo reales). Requiere el nodo de sensores encendido."""
    try:
        body = await request.json()
    except Exception:
        body = {}
    if body.get("reset"):
        state.config = config_store.update_section("calibration", {"imu_gravedad_nivel": None})
        return web.json_response({"ok": True, "imu_gravedad_nivel": None})
    if actuator_proto is not None and actuator_proto.segundos_quieto() < 2.0:
        return web.json_response({"error": "el robot se está moviendo"}, status=409)
    muestras, vistos, t0 = [], set(), time.monotonic()
    while time.monotonic() - t0 < 8.0 and len(muestras) < 60:
        env = state.env_telemetry or {}
        ra = env.get("_received_at")
        if ra is not None and time.time() - ra <= 1.0 and ra not in vistos and env.get("_acc_raw"):
            vistos.add(ra)
            muestras.append(env["_acc_raw"])
        await asyncio.sleep(0.05)
    g, err = imu_nivel.promediar(muestras)
    if err:
        return web.json_response({"error": err, "muestras": len(muestras)}, status=409)
    state.config = config_store.update_section("calibration", {"imu_gravedad_nivel": g})
    roll, pitch = imu_nivel.inclinacion_deg(g)
    print(f"[imu] nivel calibrado: g={g} (balanceo {roll:.1f}°, cabeceo {pitch:.1f}°)", flush=True)
    return web.json_response({"ok": True, "imu_gravedad_nivel": g, "muestras": len(muestras),
                              "montaje_balanceo_deg": round(roll, 1), "montaje_cabeceo_deg": round(pitch, 1)})


# =============================================
# ===== ACTUADOR (ESP32-C3 Mini, por UART) =====
# =============================================
# Esta clase conserva TODA la logica de seguridad que tenia el camino UDP
# —rampa, tope por LIDAR, odometria, calibracion del servo— y solo cambia el
# transporte por debajo: en vez de un datagrama al 192.168.12.50 escribe en
# un puerto serie. Ver uart_link.py para por que se dejaron el WiFi y el BLE.
anticolision_global = anticolision.Anticolision()
vision_activa = None          # vision_activa.VisionActiva (se crea al arrancar; APAGADA hasta que el operador la pide)


class ActuatorController:
    def __init__(self, link):
        self.link = link
        self._ramp_v = 0.0
        self._ramp_omega = 0.0
        self._ramp_last_t = time.monotonic()
        # Velocidad PEDIDA, distinta de la aplicada (`_ramp_*`). La rampa
        # avanza hacia este objetivo en cada `tick()`, llegue o no un mensaje.
        self._obj_v = 0.0
        self._obj_omega = 0.0
        self._obj_t = 0.0
        self._ultimo_aviso_t = 0.0
        # Último instante en que se mandó moverse (tras rampa y freno).
        self._t_movimiento = 0.0

    def _apply_ramp(self, v_target: float, omega_target: float,
                    safety_cfg: dict) -> tuple[float, float]:
        """
        Limitador de rampa (slew-rate), NO es PID: no hay encoder que mida
        la velocidad real del robot, así que no hay error que corregir en
        lazo cerrado. Esto solo evita saltos bruscos entre el comando
        anterior y el nuevo, limitando cuánto puede cambiar v/omega por
        segundo (`safety.max_linear_accel_mps2` / `max_angular_accel_rps2`).

        El tope de `dt` va atado al periodo nominal de comando (CMD_SEND_HZ)
        para que un hueco largo no se traduzca en un salto grande. La rampa ya
        no depende de que lleguen mensajes: la hace avanzar `tick()` a 20 Hz.
        """
        now = time.monotonic()
        dt = max(0.0, min(now - self._ramp_last_t, RAMP_MAX_DT))
        self._ramp_last_t = now

        max_dv = safety_cfg["max_linear_accel_mps2"] * dt
        max_domega = safety_cfg["max_angular_accel_rps2"] * dt

        dv = max(-max_dv, min(max_dv, v_target - self._ramp_v))
        domega = max(-max_domega, min(max_domega, omega_target - self._ramp_omega))

        self._ramp_v += dv
        self._ramp_omega += domega
        return self._ramp_v, self._ramp_omega

    def on_status(self, status: dict):
        """Llega desde una trama del C3 por el serie, no desde un socket."""
        state.actuator_status = status
        health.beat("esp32c3")
        _schedule(state.broadcast({"type": "actuator_status", "data": status}))

    def send_command(self, v_ref: float, omega_ref: float, scan_cmd: int):
        """Fija la velocidad pedida y aplica un paso de rampa.

        Quien llama (Nav2, el conductor por pulsos, la patrulla) solo dice
        a dónde quiere ir; llegar ahí lo resuelve `tick()`, que sigue
        empujando la rampa aunque no vuelva a llegar ningún mensaje.
        """
        self._obj_v, self._obj_omega = v_ref, omega_ref
        self._obj_t = time.monotonic()
        self._aplicar(scan_cmd)

    def tick(self):
        """Avanza la rampa hacia el objetivo. Se llama a 20 Hz.

        Arregla un fallo real, medido el 2026-09-16: la rampa solo avanzaba
        al llegar un mensaje. Al soltar un botón llegaba UN único (0, 0),
        que la bajaba 0,24 m/s, y `uart_link` reenviaba al C3 el valor
        residual a 20 Hz para siempre: soltando a 0,90 m/s el robot seguía
        a 0,66 m/s sin nadie al mando. El watchdog de 300 ms del firmware no
        lo salvaba porque la trama nunca dejaba de llegar.
        """
        if time.monotonic() - self._obj_t > DEADMAN_S:
            self._obj_v = self._obj_omega = 0.0
        en_reposo = (self._ramp_v == 0.0 and self._ramp_omega == 0.0
                     and self._obj_v == 0.0 and self._obj_omega == 0.0)
        if not en_reposo:
            self._aplicar(0)

    def en_reposo(self) -> bool:
        return self._ramp_v == 0.0 and self._ramp_omega == 0.0

    def segundos_quieto(self) -> float:
        """Tiempo desde la última orden de moverse que salió hacia la C3."""
        return time.monotonic() - self._t_movimiento

    def velocidades(self) -> dict:
        """Lo que pidió el software y lo que salió tras la rampa. Sin esto el
        registro de calibración guardaba velocidades en cero (2026-09-19) y
        no se podía comparar lo comandado con lo real."""
        return {"v_pedida": self._obj_v, "omega_pedida": self._obj_omega,
                "v_aplicada": self._ramp_v, "omega_aplicada": self._ramp_omega}

    def _aplicar(self, scan_cmd: int):
        v_ref, omega_ref = self._apply_ramp(
            self._obj_v, self._obj_omega, state.config["safety"])

        try:
            v_ref, omega_ref = demo_reference(v_ref, omega_ref,
                pivote=bool(state.config.get("control", {}).get("pivote_en_sitio", False)))
        except (ValueError, TypeError):
            v_ref = omega_ref = 0.0
        if not self.link.connected:
            v_ref = omega_ref = 0.0
            self._obj_v = self._obj_omega = self._ramp_v = self._ramp_omega = 0.0

        # Frenado por LIDAR DESHABILITADO: permite manejo manual sin restricciones en pasillos
        # (comentado 2026-10-07 — usuario pide control total sin bloqueos automáticos)
        # v_seg, aviso = lidar_reactive.limitar_velocidad(v_ref, state.config["slam"])
        # if v_seg != v_ref:
        #     self._ramp_v = v_seg
        #     ahora = time.monotonic()
        #     if aviso is not None and ahora - self._ultimo_aviso_t > 0.25:
        #         self._ultimo_aviso_t = ahora
        #         _schedule(state.broadcast({"type": "obstacle_warning", "data": aviso}))
        #     v_ref = v_seg

        # Patinaje y modo seguro DESHABILITADOS: control manual sin restricciones
        # (comentado 2026-10-07 — usuario pide control total sin limitaciones automáticas)
        # factor = min(monitor_desliz.factor_velocidad(),
        #              modo_seg.factor(manual=not _autonomia_activa()))
        # if factor < 1.0:
        #     v_ref *= factor
        #     omega_ref *= factor
        # monitor_desliz.on_orden(v_ref, omega_ref)  # DESHABILITADO: sin monitoreo restrictivo

        # FRENO POR LIDAR/CÁMARA SOLO EN AUTÓNOMO (2026-10-16, exposición): cuando el robot va solo, no
        # puede avanzar contra algo ni sin ver. En manual sigue sin restricciones (pedido del 2026-10-07).
        if (abs(v_ref) > 1e-6 and _autonomia_activa()
                and state.config.get("safety", {}).get("freno_lidar_autonomo", True)):
            v_seg, aviso = lidar_reactive.limitar_velocidad(v_ref, state.config["slam"])
            if v_seg != v_ref:
                self._ramp_v = v_seg
                ahora = time.monotonic()
                if aviso is not None and ahora - self._ultimo_aviso_t > 0.25:
                    self._ultimo_aviso_t = ahora
                    _schedule(state.broadcast({"type": "obstacle_warning", "data": aviso}))
                v_ref = v_seg

        # ANTICOLISIÓN CON RETROCESO (2026-10-21): si va a tocar algo delante, cancela el avance y retrocede un poco.
        # Vale en manual y en autónomo (es el mismo punto de salida). Apagable: safety.anticolision_activa.
        try:
            v_ac, w_ac, ev_ac, reinicia = anticolision_global.filtrar(
                v_ref, omega_ref, lidar_reactive.distancias(state.config["slam"]), lidar_reactive.edad_scan_s(), state.config.get("safety", {}))
            if reinicia:
                self._ramp_v, self._ramp_omega = v_ac, 0.0
            v_ref, omega_ref = v_ac, w_ac
            if ev_ac is not None:
                print(f"[anticolision] {ev_ac}", flush=True)
                if ev_ac["tipo"] in ("retroceso", "alto_sin_espacio"):
                    txt = (f"Obstáculo a {ev_ac['delante_m'] * 100:.0f} cm: retrocedo" if ev_ac["tipo"] == "retroceso"
                           else f"Obstáculo a {ev_ac['delante_m'] * 100:.0f} cm y sin espacio detrás: me detengo")
                    _schedule(state.broadcast({"type": "toast", "data": {"kind": "warn", "title": "Anticolisión", "message": txt}}))
        except Exception as exc:                       # nunca dejar sin órdenes al robot por un fallo de esta capa
            print(f"[anticolision] fallo: {type(exc).__name__}: {exc}", flush=True)

        # PROTECCIÓN FINAL COMÚN (supervisor): único punto por el que pasa TODO
        # lo que mueve el robot (manual, Nav2, patrulla, exploración), así que
        # es el lugar correcto para enclavar la emergencia y unificar límites.
        # OFF por defecto (`safety.supervisor_activo`): activar tras validar.
        # NO reemplaza el freno por LIDAR (capa aparte, sigue bajo tu control).
        if state.config.get("safety", {}).get("supervisor_activo", False):
            v_ref, omega_ref, _mot_sup = supervisor.proteccion_final(v_ref, omega_ref)

        if abs(v_ref) > 1e-3 or abs(omega_ref) > 1e-3:
            self._t_movimiento = time.monotonic()
        pose_estimator.on_command(v_ref, omega_ref)
        ros_bridge.publish_wheel_odom(v_ref, omega_ref)
        self.link.set_actuators(self._servo_angle_with_offset(), state.led_on)
        self.link.send_command(v_ref, self._giro_signo() * omega_ref, scan_cmd)

    def send_actuator_update(self):
        """Manda servo/LED sin tocar el movimiento: reusa la velocidad que
        la rampa ya tiene aplicada, en vez de forzar 0 (si el robot va en
        marcha y el operador toca el LED, no debe dar un tirón)."""
        self.link.set_actuators(self._servo_angle_with_offset(), state.led_on)
        self.link.send_command(self._ramp_v, self._giro_signo() * self._ramp_omega, 0)

    def _giro_signo(self) -> int:
        """-1 si el giro está invertido por hardware (config control.invertir_giro).

        Corrige por SOFTWARE el caso "pido izquierda y va a la derecha" sin
        reflashear: se niega omega JUSTO al enviar a la C3. No se toca el omega
        LÓGICO (el que va a la odometría/EKF y respeta la convención ROS
        omega>0=izquierda): es solo una corrección de cableado en el borde del
        actuador, así el giroscopio y lo comandado quedan con el mismo signo."""
        return -1 if state.config.get("control", {}).get("invertir_giro", False) else 1

    def _servo_angle_with_offset(self) -> int:
        """Aplica el offset de calibración al ángulo pedido. Antes este
        offset se guardaba en la config y NO se usaba en ningún lado — la
        pestaña de calibración del servo era puramente decorativa."""
        return state.servo_angle + state.config["calibration"]["servo_offset_deg"]

    def emergency_stop(self):
        """Parada real e inmediata: NO pasa por la rampa de suavizado (que
        frenaría gradual) — resetea la rampa a 0 y manda el paquete de una.
        También apaga el LED: el estado deseado de los actuadores auxiliares
        se resetea para que al soltar la emergencia nada se reactive solo."""
        self._ramp_v = 0.0
        self._ramp_omega = 0.0
        # Sin esto `tick()` volvería a acelerar hacia la velocidad de antes.
        self._obj_v = 0.0
        self._obj_omega = 0.0
        self._ramp_last_t = time.monotonic()
        state.led_on = False
        # Enclava la emergencia en el supervisor SOLO si está activo: así, con
        # el flag OFF el supervisor queda dormido y no acumula estado (a
        # `emergency_stop` también lo llaman `park`/desconexión/watchdog, que no
        # son emergencias reales). Con el flag ON, la protección final rechaza
        # todo movimiento hasta un rearme explícito (supervisor.rearmar, salud OK).
        if state.config.get("safety", {}).get("supervisor_activo", False):
            supervisor.emergencia()
        pose_estimator.on_command(0.0, 0.0)
        ros_bridge.publish_wheel_odom(0.0, 0.0)
        self.link.emergency_stop()
        self.link.set_actuators(self._servo_angle_with_offset(), False)


# =============================================
# ===== PUENTE ROS 2 (opcional — ver ros_bridge.py) =====
# =============================================
# Estos callbacks corren en el hilo del executor de rclpy (NO en el loop
# de asyncio de aiohttp), así que cualquier cosa que toque `state` o mande
# WebSocket tiene que cruzar al loop principal con run_coroutine_threadsafe.
_main_loop: asyncio.AbstractEventLoop | None = None


def _schedule(coro):
    """Cruza del hilo del executor de rclpy al loop de asyncio.

    El `close()` importa: el puente ROS arranca al importar el módulo, ANTES
    de que `start_background` fije `_main_loop`. Los scans que llegan en esa
    ventana creaban una corrutina que nadie ejecutaba nunca, y Python la
    denunciaba con "coroutine ... was never awaited" en cada arranque.
    Descartarla explícitamente deja claro que es intencional y libera lo que
    tenga agarrado."""
    if _main_loop is None:
        coro.close()
        return
    asyncio.run_coroutine_threadsafe(coro, _main_loop)


def _ros_on_cmd_vel(v_ref: float, omega_ref: float):
    """Nav2 publicó /cmd_vel. Hasta el 2026-10-20 esta función hacía `return` al empezar («manual demo»): el backend
    DESCARTABA todo lo que Nav2 calculaba y la patrulla / «ir a meta» no movían el robot. Ahora Nav2 manda motores
    SOLO si hay una meta suya en curso, y nunca contra el operador ni en el perfil de demostración. Se recorta a
    control.nav2_v_max_mps / nav2_w_max_rps. Solo (v, omega): el robot es diferencial.

    Pasa por `actuator_proto.send_command`, así que también le valen la rampa, el freno por LIDAR (si está activo),
    `invertir_giro` y la parada total (que cancela la meta de Nav2)."""
    if actuator_proto is None:
        return
    ctl = state.config.get("control", {})
    if ctl.get("solo_manual", False):
        return
    if ros_bridge.estado_meta() not in ("enviada", "en_curso"):
        return                                   # sin meta de Nav2 en curso, /cmd_vel no manda nada
    if conductor is not None and conductor.activo:
        return                                   # el operador tiene un pulso en marcha: manda él
    vmax = float(ctl.get("nav2_v_max_mps", 0.25))
    wmax = float(ctl.get("nav2_w_max_rps", 0.6))
    v = max(-vmax, min(vmax, v_ref))
    w = max(-wmax, min(wmax, omega_ref))
    actuator_proto.send_command(v, w, 0)


# El radar del dashboard mide ~300 px de lado: más de ~200 puntos caen en el
# mismo píxel y no aportan nada visible. Un scan completo del C1 son ~600
# puntos = 30 KB de JSON, 10 veces por segundo y POR CLIENTE (300 KB/s).
# Se diezma SOLO lo que se difunde; la evasión reactiva sigue recibiendo el
# scan completo, que es donde la resolución sí importa: perder el único rayo
# que da contra una rama fina es perder el frenado.
RADAR_MAX_PUNTOS = 200
_ultimo_envio_lidar = 0.0
_ultimo_envio_pose = 0.0
_ultimo_envio_scan_mapa = 0.0
SCAN_MAPA_PERIODO_S = 0.1     # el scan sobre el mapa va a 10 Hz: es "en vivo"


def _decimar(points: list[dict], maximo: int) -> list[dict]:
    """Diezma y REDONDEA para la difusión.

    El scan entra con precisión de float64 —`0.14875000715255737` m,
    `-180.00000500895632`°— que en JSON son ~40 caracteres por punto de puro
    ruido: el C1 tiene un error de ±3 cm, así que todo lo que hay más allá
    del milímetro es dígito inventado. Redondear a mm y a centésimas de
    grado no pierde nada real y achica el mensaje a la mitad."""
    if len(points) > maximo:
        paso = len(points) / maximo
        points = [points[int(i * paso)] for i in range(maximo)]
    return [{"angle_deg": round(p["angle_deg"], 2),
             "distance_m": round(p["distance_m"], 3)} for p in points]


mapa_scan = MapaScan()
_ultimo_mapa_scan_t = 0.0
_ultimo_envio_mapa_scan = 0.0
MAPA_SCAN_PERIODO_S = 0.2          # el scan se acumula a 5 Hz
MAPA_SCAN_ENVIO_S = 1.0            # y el mapa acumulado se difunde a 1 Hz


def _mapa_desde_scan() -> bool:
    return (state.config.get("slam") or {}).get("mapa_fuente", "scan") == "scan"


_mapa_scan_ocupado = False


def _mapa_limpio() -> bool:
    """slam.mapa_limpio (por defecto True): el dashboard recibe el mapa con paredes de una celda, sin franjas dobles ni motas (mapa_scan._clasificar)."""
    return bool(state.config.get("slam", {}).get("mapa_limpio", True))


async def _agregar_y_difundir(ahora: float, pose: dict, points: list[dict], difundir: bool):
    """Registro scan-a-mapa (~60 ms) y limpieza del mapa FUERA del bucle de eventos: si no, el dashboard y el robot se atascaban cada 0,2 s."""
    global _mapa_scan_ocupado
    try:
        await asyncio.to_thread(mapa_scan.agregar, ahora, pose, [p["angle_deg"] for p in points], [p["distance_m"] for p in points])
        if difundir:
            m = await asyncio.to_thread(mapa_scan.como_mapa, _mapa_limpio())
            if m is not None:
                m["received_at"] = time.time()
                await state.broadcast({"type": "map", "data": m})
    except Exception as exc:  # noqa: BLE001
        print(f"[mapa_scan] {type(exc).__name__}: {exc}", flush=True)
    finally:
        _mapa_scan_ocupado = False


def _acumular_scan(points: list[dict], pose: dict):
    """El mapa del dashboard se dibuja con los puntos del scan acumulados (mapa_scan.py), registrados contra lo ya dibujado."""
    global _ultimo_mapa_scan_t, _ultimo_envio_mapa_scan, _mapa_scan_ocupado
    ahora = time.monotonic()
    if _mapa_scan_ocupado or ahora - _ultimo_mapa_scan_t < MAPA_SCAN_PERIODO_S:
        return
    _ultimo_mapa_scan_t = ahora
    difundir = ahora - _ultimo_envio_mapa_scan >= MAPA_SCAN_ENVIO_S
    if difundir:
        _ultimo_envio_mapa_scan = ahora
    _mapa_scan_ocupado = True
    _schedule(_agregar_y_difundir(ahora, dict(pose), points, difundir))


def _difundir_scan_en_mapa(points: list[dict]):
    """El scan en coordenadas del MAPA (pose = TF map->base_link de
    slam_toolbox), para pintar los puntos en vivo sobre el mapa. Sin TF
    (SLAM aún sin arrancar) no se manda nada: pintarlo con la pose del EKF
    lo dibujaría desplazado respecto al mapa."""
    global _ultimo_envio_scan_mapa
    ahora = time.monotonic()
    if ahora - _ultimo_envio_scan_mapa < SCAN_MAPA_PERIODO_S:
        return
    pose = ros_bridge.pose_en_mapa()
    if pose is None:
        return
    _ultimo_envio_scan_mapa = ahora
    if _mapa_desde_scan():
        _acumular_scan(points, pose)
    _schedule(state.broadcast({"type": "scan_mapa", "data": {
        "pose": {k: round(pose[k], 3) for k in ("x", "y", "theta_deg")},
        "pts": scan_a_mapa(points, pose)}}))


def _ros_on_scan_points(points: list[dict]):
    """sllidar_ros2 publicó /scan — alimenta la evasión reactiva + el radar."""
    lidar_reactive.ingest_scan(points)
    cfg_slam = state.config["slam"]
    costmap.update(points, cfg_slam["robot_largo_cm"], cfg_slam["robot_ancho_cm"])
    health.beat("lidar")
    _difundir_scan_en_mapa(points)
    # Al dashboard se manda a 4 Hz, no a 10: el scan decimado son ~10 kB por
    # mensaje y por WiFi compartido eso era ~100 kB/s solo de radar, que es
    # parte de la latencia que se notaba. La evasión sigue usando los 10 Hz.
    global _ultimo_envio_lidar
    ahora = time.monotonic()
    if ahora - _ultimo_envio_lidar < 0.25:
        return
    _ultimo_envio_lidar = ahora
    cfg = state.config["slam"]
    _schedule(state.broadcast({"type": "lidar_scan",
                               "data": _decimar(points, RADAR_MAX_PUNTOS)}))
    # Al dashboard en CENTÍMETROS: a estas distancias es lo que se entiende
    # de un vistazo, y es como se configuran los umbrales.
    d = lidar_reactive.distancias(cfg)
    _schedule(state.broadcast({"type": "lidar_distancias", "data": {
        **{lado: (None if v is None else round(v * 100)) for lado, v in d.items()},
        "umbral_cm": cfg["margen_parada_cm"] + cfg["deslizamiento_cm"],
    }}))


def _ros_on_fused_pose(pose: dict):
    """robot_localization publicó /odometry/filtered — reemplaza al PoseEstimator casero."""
    global ros_fused_pose, ros_fused_pose_t, _ultimo_envio_pose
    ros_fused_pose = pose
    ros_fused_pose_t = time.monotonic()
    ahora = time.monotonic()
    if ahora - _ultimo_envio_pose < 0.12:      # ~8 Hz al dashboard
        return
    _ultimo_envio_pose = ahora
    _schedule(state.broadcast({"type": "pose", "data": pose, "source": "ros_ekf"}))


_last_map_broadcast = 0.0


def _ros_on_map(map_dict: dict):
    """slam_toolbox publicó /map — se manda al dashboard, limitado a 1 Hz (es pesado)."""
    global ros_last_map, _last_map_broadcast
    health.beat("slam")
    ros_last_map = map_dict
    now = time.time()
    if _mapa_desde_scan() and mapa_scan.version:     # el dashboard dibuja el mapa de puntos del scan; la rejilla SLAM queda de respaldo
        return
    if now - _last_map_broadcast < 0.5:
        return
    _last_map_broadcast = now
    _schedule(state.broadcast({"type": "map", "data": map_dict}))


# Patinaje / atasco (ver deslizamiento.py) y modo seguro (ver modo_seguro.py):
# lo ordenado se compara con lo que mide el LIDAR, y los fallos serios
# llevan al robot a un estado seguro en vez de dejarlo seguir a ciegas.
monitor_desliz = MonitorDeslizamiento()
modo_seg = ModoSeguro()

# Supervisor central de movimiento (ver supervisor_movimiento.py). Por ahora
# solo se usa su PROTECCIÓN FINAL COMÚN (emergencia enclavada + límites), y SOLO
# si `safety.supervisor_activo` está en true (OFF por defecto): así se puede
# validar sin cambiar el comportamiento actual. Los límites salen de los topes
# FÍSICOS reales del firmware (V_MAX/OMEGA_MAX), no de los ficticios del backend.
supervisor = SupervisorMovimiento(v_max=0.55, omega_max=1.5)


def _ros_on_odom_lidar(v: float, w: float):
    """Velocidad medida por rf2o (hilo de ROS): solo actualiza números."""
    monitor_desliz.on_medida(v, w)


ros_bridge = AgroBotROSBridge(_ros_on_cmd_vel, _ros_on_scan_points, _ros_on_fused_pose, _ros_on_map,
                              on_odom_lidar=_ros_on_odom_lidar)

# Se crea en start_background, cuando ya existe el event loop al que el hilo
# de captura tiene que despachar los frames.
camera: CameraWorker | None = None


def current_pose() -> dict:
    """Pose fusionada real (EKF de robot_localization) si ROS está corriendo
    y ya publicó al menos una vez; si no, cae al filtro complementario
    casero de slam.py para que el dashboard nunca se quede sin lectura."""
    return ros_fused_pose if ros_fused_pose is not None else pose_estimator.snapshot()


# Vigía de la pose (vigia_pose.py, 2026-11-02): la autonomía navega con una pose que no salta aunque el SLAM o el EKF salten (27-oct: saltos de 30 y 24 m
# tras un salto del reloj). Con autonomia.vigia_pose_activo=false todo usa pose_en_mapa() como antes.
vigia_pose = VigiaPose()


def _vigia_pose_activo() -> bool:
    return bool(state.config["autonomia"].get("vigia_pose_activo", False))


def _vigia_pose_paso() -> dict:
    """Un paso del vigía con las poses de ahora (map->base_link del TF y odom del EKF)."""
    var = (ros_fused_pose or {}).get("var_vx")
    odom = ros_fused_pose if pose_confiable() else None
    return vigia_pose.paso(time.monotonic(), ros_bridge.pose_en_mapa(), odom, var)


def _pose_robusta() -> dict | None:
    """La pose con la que decide la autonomía (explorador, misión, visión activa)."""
    if not _vigia_pose_activo():
        return ros_bridge.pose_en_mapa()
    return _vigia_pose_paso()["pose"]


def pose_edad_s() -> float | None:
    """Segundos desde la última pose del EKF, o None si nunca llegó una.

    Reloj monótono (no time.time): inmune a saltos del reloj del sistema, que
    en esta Jetson sin RTC pueden ser de años al arrancar (ver memoria)."""
    if ros_fused_pose_t is None:
        return None
    return time.monotonic() - ros_fused_pose_t


def pose_confiable() -> bool:
    """¿La localización es de fiar AHORA? False si el EKF no corre o si su
    última pose es más vieja que POSE_VIEJA_S (pose congelada). Los modos que
    dependen de localización deben consultarlo antes de navegar con la pose."""
    edad = pose_edad_s()
    return edad is not None and edad <= POSE_VIEJA_S


# =============================================
# ===== WEBSOCKET =====
# =============================================
async def ws_handler(request: web.Request):
    ws = web.WebSocketResponse(heartbeat=10)
    await ws.prepare(request)
    state.ws_clients.add(ws)

    await ws.send_str(json.dumps({
        "type": "snapshot",
        "data": {
            "env_telemetry": state.env_telemetry,
            "env_history": state.env_history,
            "actuator_status": state.actuator_status,
            "detections": state.detections[-20:],
            "captures": list(reversed(state.captures[-40:])),
            "system_stats": state.system_stats,
            "mission_active": state.mission_active,
            "config": state.config,
            "models": list_model_files(),
            "health": _salud_completa(),
            "pose": current_pose(),
            "pose_source": "ros_ekf" if ros_fused_pose is not None else "dead_reckoning",
            "pose_edad_s": (round(e, 2) if (e := pose_edad_s()) is not None else None),
            "pose_confiable": pose_confiable(),
            "lidar_scan": _decimar(lidar_reactive.last_scan or [], RADAR_MAX_PUNTOS),
            "map": (mapa_scan.como_mapa(_mapa_limpio()) if _mapa_desde_scan() and mapa_scan.version else None) or ros_last_map,
            "ros_available": ros_bridge.available,
            "ros_reason": ROS_UNAVAILABLE_REASON,
            "navigation": state.config["navigation"],
            "actuator_setpoint": {"servo_angle": state.servo_angle, "led": state.led_on},
        },
    }))

    last_cmd_sent = 0.0
    min_interval = 1.0 / CMD_SEND_HZ

    try:
        async for msg in ws:
            if msg.type != WSMsgType.TEXT:
                continue
            try:
                cmd = json.loads(msg.data)
            except json.JSONDecodeError:
                continue

            if cmd.get("type") == "control":
                if vision_activa is not None and (cmd.get("v") or cmd.get("omega")):
                    vision_activa.cancelar("orden manual")
                now = time.monotonic()
                # Un "parar" nunca se descarta por el limitador: antes, si
                # llegaba a menos de 50 ms del último comando (un toque corto
                # en el móvil), se tiraba y el robot seguía con el anterior.
                es_parada = not cmd.get("v") and not cmd.get("omega")
                if now - last_cmd_sent < min_interval and not es_parada:
                    continue
                last_cmd_sent = now
                # El mando manual manda FRACCIÓN (-1..1), no m/s: el
                # dashboard no tiene por qué conocer los límites físicos del
                # robot, y así el acelerador (`scale`) es una sola
                # multiplicación acá en vez de tres cuentas en el navegador.
                # Antes se mandaba v=1 crudo y el firmware lo recortaba a
                # V_MAX en silencio: la UI decía 1.0 m/s y el robot iba a
                # 0.55, y no había forma de pedir marcha lenta.
                try:
                    v, omega = demo_command(cmd.get("v",0),cmd.get("omega",0),
                                            float(cmd.get("scale",1))*100)
                except (ValueError, TypeError):
                    actuator_proto.emergency_stop()
                    continue
                if (v or omega):
                    _tomar_mando("ws")
                    _registrar_orden_manual(v, omega, "ws")
                if conductor is not None:
                    conductor.parar()
                if enlace_c3 is not None and enlace_c3.connected:
                    if (v or omega) and not await _c3_ready_for_drive():
                        actuator_proto.emergency_stop()
                        await ws.send_json({"type":"error","error":"Configura la C3 1.1 y entrega control a Jetson"})
                        continue
                    actuator_proto.send_command(v, omega, 0)

            elif cmd.get("type") == "actuator":
                # Servo / LED. Va por su propio mensaje y NO pasa por el
                # throttle de `control`: el operador puede mover el slider
                # con el robot detenido, y en ese caso no hay comandos de
                # movimiento saliendo que arrastren el cambio.
                if "servo_angle" in cmd:
                    state.servo_angle = clamp_servo(float(cmd["servo_angle"]))
                if "led" in cmd:
                    state.led_on = bool(cmd["led"])
                actuator_proto.send_actuator_update()
                await state.broadcast({"type": "actuator_setpoint", "data": {
                    "servo_angle": state.servo_angle,
                    "led": state.led_on,
                }})

            elif cmd.get("type") == "emergency_stop":
                _manejo = cmd.get("tipo") == "manejo"
                _parada_total("manejo WebSocket" if _manejo else "dashboard WebSocket", emergencia=not _manejo)

    finally:
        state.ws_clients.discard(ws)
        # Un celular que se duerme o pierde el WiFi NO debe cortar la autonomía (presentación 2026-10-23): solo se frena si
        # nadie la está llevando, o si el operador tenía el mando manual.
        if _modo_auto_activo() is None or asistido.activa:
            if conductor is not None:
                conductor.parar()
            if actuator_proto is not None:
                actuator_proto.emergency_stop()

    return ws


# =============================================
# ===== VIDEO EN VIVO + DETECCIÓN YOLO =====
# =============================================
async def video_handler(request: web.Request):
    """Sirve el MJPEG. No toca la cámara: solo consume lo que el hilo de
    captura ya dejó listo (ver camera.py). Antes este handler abría su
    propio `VideoCapture(0)` por petición —dos pestañas del dashboard eran
    dos capturas peleando por la misma cámara— y hacía la lectura y la
    compresión bloqueando el event loop."""
    response = web.StreamResponse(
        status=200,
        headers={
            "Content-Type": "multipart/x-mixed-replace; boundary=frame",
            # Sin esto algunos navegadores y proxies cachean el stream y el
            # video queda congelado en el primer frame.
            "Cache-Control": "no-store, no-cache, must-revalidate",
        },
    )
    await response.prepare(request)

    if camera is None:
        return response

    cola = camera.subscribe()
    try:
        while True:
            jpeg = await cola.get()
            await response.write(b"--frame\r\nContent-Type: image/jpeg\r\n\r\n"
                                 + jpeg + b"\r\n")
    except (ConnectionError, asyncio.CancelledError):
        # ConnectionError cubre BrokenPipe y ConnectionReset: es lo normal
        # cuando el navegador cierra la pestaña, no un fallo que reportar.
        pass
    finally:
        camera.unsubscribe(cola)

    return response


# =============================================
# ===== MODO AUTÓNOMO =====
# =============================================
patrol: PatrolController | None = None
conductor: ConductorPulsos | None = None
paso_robotico: PasoRobotico | None = None
grabador: Grabador | None = None
explorador: ExploradorReactivo | None = None
nav_logger: NavigationLogger | None = None
_nav_cal_task: asyncio.Task | None = None
_nav_cal_stats: dict = {}
seguidor_sendero: SeguidorSendero | None = None

WAYPOINTS_PATH = _AQUI / "patrol_waypoints.json"


odom_webcam: OdometriaWebcam | None = None


def _distancias_explorador() -> dict:
    """Huecos del LIDAR + lo que la CÁMARA ve en el suelo delante (2026-10-22).

    El LIDAR está a 37,5 cm: cojines, cajas, macetas bajas no existen para él y el explorador se les echaba encima. suelo_libre (método por
    apariencia) da la distancia al primer obstáculo del suelo en el camino del robot; si es menor que la del LIDAR, manda la cámara.
    Se apaga con autonomia.camara_obstaculos = false."""
    d = lidar_reactive.distancias(state.config["slam"])
    if not state.config["autonomia"].get("camara_obstaculos", True):
        return d
    cam = suelo_libre.hueco_delante(state.config["slam"]["robot_ancho_cm"] / 100.0)
    if cam is None:
        return d
    cam = max(0.0, cam - state.config["slam"]["robot_largo_cm"] / 200.0)       # desde la cara delantera, como el LIDAR
    if d.get("adelante") is None or cam < d["adelante"]:
        d = dict(d)
        d["adelante"] = cam
        d["adelante_fuente"] = "camara"
    return d


def _scan_explorador() -> list[dict]:
    """Scan que ve el explorador: el del LIDAR y, con autonomia.camara_como_lidar, también el frente de la CÁMARA filtrado (camara_lidar.py: obstáculos bajos que el
    plano del LIDAR no ve). autonomia.camara_lidar_solo = true reemplaza el frente del LIDAR por el de la cámara (prueba)."""
    scan = lidar_reactive.last_scan
    cfg = state.config["autonomia"]
    if not cfg.get("camara_como_lidar", False):
        return scan
    try:
        return camara_lidar.fusionar(scan, suelo_libre.ultimo, state.config["slam"]["robot_largo_cm"] / 100.0, bool(cfg.get("camara_lidar_solo", False)))
    except Exception as exc:  # noqa: BLE001
        print(f"[camara-lidar] filtro falló: {type(exc).__name__}: {exc}", flush=True)
        return scan


def _servo_al_frente() -> tuple[bool, str]:
    """¿La cámara mira al frente y quieta? Si no, la odometría visual leería
    el giro del servo como giro del robot. Se mira lo que REPORTA el C3, no lo
    que se le pidió: durante un barrido el firmware ignora el ángulo pedido."""
    st = state.actuator_status or {}
    if not st or time.time() - st.get("_received_at", 0) > 1.0:
        return False, "sin estado del servo (¿C3 desconectado?)"
    if st.get("scanning"):
        return False, "cámara escaneando"
    angulo = st.get("servo_angle")
    frentes = {SERVO_HOME_DEG, SERVO_HOME_DEG + state.config["calibration"]["servo_offset_deg"]}
    if angulo is None or min(abs(angulo - f) for f in frentes) > SERVO_TOLERANCIA_DEG:
        return False, f"cámara girada ({angulo}°)"
    return True, ""


# Con el robot quieto se le dice al EKF "velocidad cero" (ZUPT). Sin LIDAR el
# EKF no recibía ninguna velocidad lineal y extrapolaba la última durante
# horas: el 2026-09-30 la pose llegó a x = 1771 m y el mapa a 9,7 km. Sin
# scan fresco el freno por LIDAR ya impide avanzar, así que en ese caso el
# robot siempre está quieto. Se espera ZUPT_TRAS_S tras la última orden
# porque el chasis desliza ~80 cm al soltar.
ZUPT_TRAS_S = 3.0
ZUPT_HZ = 10


async def _bucle_zupt():
    while True:
        try:
            if actuator_proto is not None and actuator_proto.segundos_quieto() > ZUPT_TRAS_S:
                ros_bridge.publish_zupt()
        except Exception as exc:
            print(f"[zupt] falló: {type(exc).__name__}: {exc}")
        await asyncio.sleep(1.0 / ZUPT_HZ)


def _autonomia_sin_mision() -> bool:
    """Patrulla o exploración en marcha, SIN contar `mission_active`. La visión activa la usa como candado: la misión de plantas
    detiene el explorador y entonces arranca la visión; con `mission_active` dentro del candado la visión NUNCA arrancaba en
    misión («exploración/patrulla activa: páralas primero») y el robot se quedaba en un bucle de escaneos (2026-10-23)."""
    return bool((patrol is not None and patrol.activo) or (explorador is not None and explorador.activo))


def _autonomia_activa() -> bool:
    """Algo que no es el operador está moviendo (o puede mover) el robot."""
    return bool(state.mission_active
                or (patrol is not None and patrol.activo)
                or (explorador is not None and explorador.activo))


def _barrido_activo() -> bool:
    """¿Activo el barrido de tilt + freno proactivo? (flag de config, OFF def.)"""
    return bool(state.config["autonomia"].get("barrido_tilt"))


def _barrido_estable() -> bool:
    """Con el barrido activo, ¿el servo está quieto en un ángulo conocido del
    barrido? Entonces la geometría (corregida por tilt) vale para suelo_libre."""
    if not _barrido_activo():
        return False
    st = state.actuator_status or {}
    if not st or st.get("scanning") or time.time() - st.get("_received_at", 0) > 1.0:
        return False
    ang = st.get("servo_angle")
    if ang is None:
        return False
    off = state.config["calibration"]["servo_offset_deg"]
    return min(abs(ang - (SERVO_LEJOS_DEG + off)),
               abs(ang - (SERVO_CERCA_DEG + off))) <= SERVO_TOLERANCIA_DEG


def _detener_autonomia():
    """Lo mismo que el botón de parar misión: la patrulla y el explorador
    primero (si no, vuelven a mandar velocidad o una meta a Nav2)."""
    if patrol is not None:
        patrol.detener()
    if explorador is not None:
        explorador.detener()
    ros_bridge.cancel_nav_goal()
    state.mission_active = False
    if actuator_proto is not None:
        actuator_proto.emergency_stop()


MODO_SEGURO_HZ = 5


detector_vuelco = DetectorVuelco()


def _vuelco_detector_activo() -> bool:
    return bool(state.config["safety"].get("vuelco_detector", False))


def _imu_vuelco() -> dict:
    """Acelerómetro (g) y velocidad de balanceo (gyroY, eje de avance) del
    último paquete del IMU, para que modo_seguro detecte inclinación/vuelco.
    Vacío si aún no hay IMU: así no dispara nada.
    Con safety.vuelco_detector la inclinación la juzga detector_vuelco (filtrada): al modo seguro solo le llega un vuelco CONFIRMADO."""
    env = state.env_telemetry or {}
    if "accelZ" not in env or not _imu_fresco():
        return {}
    if _vuelco_detector_activo():
        return {"inclinacion_deg": 90.0} if detector_vuelco.estado == V_VUELCO else {}
    return {
        "acc": (env.get("accelX", 0.0), env.get("accelY", 0.0), env.get("accelZ", 0.0)),
        "giro_roll_dps": env.get("gyroY", 0.0),
    }


def _entradas_modo_seguro() -> dict:
    ahora = time.time()
    vistos = health._last_seen
    edad = lambda k: (ahora - vistos[k]) if k in vistos else None
    return {
        "moviendose": actuator_proto is not None and not actuator_proto.en_reposo(),
        "autonomia": _autonomia_activa(),
        "edad_lidar_s": edad("lidar"),
        "edad_c3_s": edad("esp32c3"),
        "atascado": monitor_desliz.atascado,
        "patinaje": monitor_desliz.patinaje,
        "temp_c": (state.system_stats or {}).get("temp_c"),
        "ekf_var_vx": (ros_fused_pose or {}).get("var_vx") if ros_bridge.available else None,
        "mapa_corrupto": bool((ros_last_map or {}).get("corrupto")),
        **_imu_vuelco(),
    }


def estado_seguridad() -> dict:
    return {**modo_seg.estado(), "deslizamiento": monitor_desliz.estado()}


async def _bucle_modo_seguro():
    """Monitores de fallos a 5 Hz (ver modo_seguro.py). Al ENTRAR en SEGURO
    detiene la autonomía, avisa al dashboard y a Telegram (vía la Pi)."""
    nivel_previo = modo_seg.nivel
    ultimo_envio = 0.0
    while True:
        try:
            if not modo_seguro_habilitado:
                # Modo seguro desactivado: ignorar evaluación
                nivel = NORMAL
                est = {"nivel": NORMAL, "motivos": [], "factor": 1.0}
            else:
                est = modo_seg.evaluar(_entradas_modo_seguro())
                nivel = est["nivel"]
            if nivel != nivel_previo:
                motivo = "; ".join(est["motivos"]) or "todo en orden"
                print(f"[seguridad] {nivel_previo} -> {nivel}: {motivo}")
                if nivel == SEGURO:
                    _detener_autonomia()
                    await state.broadcast({"type": "toast", "data": {
                        "kind": "error", "title": "MODO SEGURO",
                        "message": f"Robot detenido: {motivo}. Revisar y rearmar."}})
                    _schedule(_avisar_al_gateway({
                        "tipo": "seguridad", "titulo": "AgroBot en MODO SEGURO",
                        "mensaje": motivo}))
                elif nivel == PRECAUCION:
                    await state.broadcast({"type": "toast", "data": {
                        "kind": "warning", "title": "Precaución",
                        "message": f"Velocidad reducida: {motivo}"}})
                nivel_previo = nivel
                ultimo_envio = 0.0
            if time.monotonic() - ultimo_envio > 2.0:
                ultimo_envio = time.monotonic()
                await state.broadcast({"type": "seguridad", "data": estado_seguridad()})
        except Exception as exc:
            print(f"[seguridad] bucle falló: {type(exc).__name__}: {exc}")
        await asyncio.sleep(1.0 / MODO_SEGURO_HZ)


async def seguridad_get_handler(request: web.Request):
    return web.json_response(estado_seguridad())


async def seguridad_rearmar_handler(request: web.Request):
    ok, msg = modo_seg.rearmar()
    await state.broadcast({"type": "toast", "data": {
        "kind": "success" if ok else "warning", "title": "Modo seguro", "message": msg}})
    return web.json_response({"ok": ok, "message": msg, **estado_seguridad()},
                             status=200 if ok else 409)


async def modo_seguro_toggle_handler(request: web.Request):
    """Activa/desactiva el modo seguro completamente."""
    global modo_seguro_habilitado
    try:
        data = await request.json()
        nuevo_estado = data.get("habilitado")
        if not isinstance(nuevo_estado, bool):
            return web.json_response({"error": "habilitado debe ser true/false"}, status=400)

        modo_seguro_habilitado = nuevo_estado
        state.config = config_store.update_section("safety", {"modo_seguro_activo": nuevo_estado})
        estado = "DESACTIVADO" if not nuevo_estado else "ACTIVADO"
        print(f"[seguridad] modo seguro {estado}", flush=True)

        await state.broadcast({"type": "toast", "data": {
            "kind": "warning",
            "title": "Modo Seguro",
            "message": f"Modo seguro {estado}"}})

        return web.json_response({
            "ok": True,
            "modo_seguro_habilitado": modo_seguro_habilitado,
            "estado": estado
        })
    except Exception as e:
        return web.json_response({"error": str(e)}, status=400)


async def _bucle_vuelco():
    """Detector de vuelco (detector_vuelco.py) con cada paquete NUEVO del IMU. En VUELCO: para la autonomía y los motores y avisa; en PRECAUCIÓN avisa.
    Se libera solo cuando el robot vuelve a estar derecho unos segundos."""
    ultimo_rx = None
    previo = detector_vuelco.estado
    while True:
        await asyncio.sleep(0.05)
        try:
            env = state.env_telemetry or {}
            rx = env.get("_received_at")
            if rx is None or rx == ultimo_rx or "accelZ" not in env:
                continue
            ultimo_rx = rx
            est = detector_vuelco.paso(time.monotonic(), (env.get("accelX", 0.0), env.get("accelY", 0.0), env.get("accelZ", 0.0)),
                                       (env.get("gyroX", 0.0), env.get("gyroY", 0.0), env.get("gyroZ", 0.0)))
            if est == previo:
                continue
            previo = est
            if not _vuelco_detector_activo():
                continue
            snap = detector_vuelco.snapshot()
            _evento("vuelco", snap)
            if est == V_VUELCO:
                _detener_autonomia()
                if conductor is not None:
                    conductor.parar()
                await state.broadcast({"type": "toast", "data": {"kind": "error", "title": "VUELCO", "message": f"{snap['motivo']}. Motores parados: enderezar el robot."}})
                _schedule(_avisar_al_gateway({"tipo": "seguridad", "titulo": "AgroBot VOLCADO", "mensaje": snap["motivo"]}))
            elif est == V_PRECAUCION:
                await state.broadcast({"type": "toast", "data": {"kind": "warning", "title": "Inclinación alta", "message": snap["motivo"]}})
            else:
                await state.broadcast({"type": "toast", "data": {"kind": "success", "title": "Robot derecho", "message": "El detector de vuelco se liberó."}})
        except Exception as exc:
            print(f"[vuelco] {type(exc).__name__}: {exc}", flush=True)
            await asyncio.sleep(1.0)


async def vuelco_handler(request: web.Request):
    """GET /api/vuelco — estado del detector de vuelco (balanceo, cabeceo, estado)."""
    return web.json_response({"activo": _vuelco_detector_activo(), **detector_vuelco.snapshot(), "params": detector_vuelco.p})


async def _bucle_rampa():
    """Hace avanzar la rampa del actuador a 20 Hz, llegue o no un comando."""
    while True:
        try:
            if actuator_proto is not None:
                actuator_proto.tick()
        except Exception as exc:
            print(f"[rampa] tick falló: {type(exc).__name__}: {exc}")
        await asyncio.sleep(1.0 / CMD_SEND_HZ)


# Con el adaptador USB CP2102N el LIDAR se caía del bus (4 veces en 15 min el
# 2026-09-19) y sllidar_node quedaba bloqueado sobre el puerto viejo: el
# `respawn` nunca actuaba y /scan callaba hasta reiniciar ROS. Sin scans el
# freno por LIDAR bloquea adelante/atrás. Matar el driver colgado deja que
# el respawn lo relance.
# El puerto se elige como en scripts/elegir_puerto_lidar.sh: el USB si está
# enchufado, si no la UART del conector (pines 8/10). La UART existe siempre,
# así que "puerto presente" no dice que el LIDAR esté conectado: por eso los
# reinicios se espacian si no sirven.
LIDAR_USB = Path("/dev/serial/by-id/usb-Silicon_Labs_CP2102N_USB_to_UART_"
                 "Bridge_Controller_5e723775cd73ef11b311cf8c8fcc3fa0-if00-port0")
LIDAR_UART = Path("/dev/ttyTHS1")


def _puerto_lidar() -> Path:
    """El mismo criterio que scripts/elegir_puerto_lidar.sh: el adaptador
    conocido, si no cualquier CP210x por by-id, si no la UART."""
    if LIDAR_USB.exists():
        return LIDAR_USB
    for otro in sorted(Path("/dev/serial/by-id").glob("usb-Silicon_Labs_CP210*")):
        return otro
    return LIDAR_UART


LIDAR_MUDO_S = 4.0          # sin scan este tiempo con el puerto presente = colgado
LIDAR_ENTRE_REINICIOS_S = 20.0   # arranque del driver + respawn_delay, con holgura
LIDAR_ESPERA_MAX_S = 300.0       # tope de la espera cuando reiniciar no lo trae
_SLLIDAR_PATRON = "sllidar_ros2/lib/sllidar_ros2/sllidar_node"


def _matar_sllidar() -> bool:
    """SIGTERM y, si sigue vivo (bloqueado en el puerto), SIGKILL."""
    r = subprocess.run(["pkill", "-TERM", "-f", _SLLIDAR_PATRON], capture_output=True)
    if r.returncode != 0:
        return False
    time.sleep(1.5)
    subprocess.run(["pkill", "-KILL", "-f", _SLLIDAR_PATRON], capture_output=True)
    return True


_detector_reloj = DetectorSalto()


def _ocupado() -> dict:
    """¿Está el robot haciendo algo que no debe interrumpirse (autonomía, misión, pulso, movimiento reciente)? Lo consulta agrobot-reloj-vigia antes de reiniciar ROS tras un salto de reloj:
    reiniciar la pila en plena misión borra el mapa y salta la pose (27-oct: saltos de 30 y 24 m)."""
    motivos = []
    try:
        modo = _modo_auto_activo()
        if modo:
            motivos.append(f"autonomía: {modo}")
        if conductor is not None and conductor.activo:
            motivos.append("pulso en curso")
        if _maniobra_giro_tarea is not None and not _maniobra_giro_tarea.done():
            motivos.append("maniobra de giro")
        if gestor_misiones is not None and gestor_misiones.estado in ("en curso", "terminando"):
            motivos.append(f"misión: {gestor_misiones.mision}")
        if actuator_proto is not None and actuator_proto.segundos_quieto() < 10.0:
            motivos.append("movimiento reciente")
    except Exception as exc:
        motivos.append(f"no se pudo comprobar ({type(exc).__name__})")
    return {"ocupado": bool(motivos), "motivos": motivos}


async def ocupado_handler(request: web.Request):
    """GET /api/ocupado — {"ocupado": bool, "motivos": [...]}."""
    return web.json_response(_ocupado())


async def _vigia_reloj():
    """Detecta saltos del reloj de pared (NTP sin RTC). Los anota (~/.agrobot/reloj_saltos.jsonl) y avisa al operador; el reinicio de ROS lo decide agrobot-reloj-vigia, que espera a que
    el robot esté en reposo (/api/ocupado). Los análisis posteriores deben usar el tiempo monótono, no t_unix."""
    while True:
        await asyncio.sleep(1.0)
        try:
            delta = _detector_reloj.paso(time.time(), time.monotonic())
            if delta is None:
                continue
            msg = f"El reloj de la Jetson saltó {delta:+.1f} s (sincronización NTP). La pose del SLAM puede haber saltado."
            print(f"[reloj] {msg}", flush=True)
            try:
                with open(Path.home() / ".agrobot" / "reloj_saltos.jsonl", "a", encoding="utf-8") as fh:
                    fh.write(json.dumps({**_detector_reloj.saltos[-1], "iso": time.strftime("%Y-%m-%d %H:%M:%S")}, ensure_ascii=False) + "\n")
            except OSError:
                pass
            _evento("reloj", {"delta_s": round(delta, 1)})
            vigia_pose.sospechar(time.monotonic(), 20.0)          # es justo cuando el SLAM/EKF suelen saltar
            await state.broadcast({"type": "toast", "data": {"kind": "warning", "title": "Salto de reloj", "message": msg}})
        except Exception as exc:
            print(f"[reloj] vigía: {type(exc).__name__}: {exc}", flush=True)


async def _vigia_pose_bucle():
    """Vigía de la pose a 10 Hz: avisa de los cambios de estado y, si la localización está PERDIDA, deja la autonomía en espera (sin moverse) y pide ZUPT
    al EKF. Cuando el SLAM vuelve, la autonomía sigue sola (no hace falta reiniciar nada)."""
    previo = None
    ultimo_zupt = 0.0
    while True:
        await asyncio.sleep(0.1)
        try:
            bloqueos = getattr(explorador, "bloqueos", None)      # la FSM (maquina_estados) no los tiene
            if not _vigia_pose_activo() or not ros_bridge.available:
                if bloqueos is not None:
                    bloqueos.pop("localizacion", None)
                previo = None
                continue
            r = _vigia_pose_paso()
            est = r["estado"]
            for ev in vigia_pose.eventos:
                _evento("localizacion", ev)
            vigia_pose.eventos.clear()
            if est == LOC_PERDIDA:
                if bloqueos is not None:
                    bloqueos["localizacion"] = f"localización perdida ({r['motivo']}): espero a que vuelva el SLAM"
                if time.monotonic() - ultimo_zupt > 1.0 and actuator_proto is not None and actuator_proto.en_reposo():
                    ultimo_zupt = time.monotonic()
                    ros_bridge.publish_zupt()                     # quieto de verdad: que el EKF deje de extrapolar
            elif bloqueos is not None:
                bloqueos.pop("localizacion", None)
            if previo is not None and est != previo:
                if est == LOC_PERDIDA:
                    toast = ("error", "Localización perdida", f"{r['motivo']}. La autonomía espera quieta; sigue sola si el SLAM se recupera.")
                elif est == LOC_ANCLADA:
                    toast = ("warning", "Pose del SLAM descartada", f"{r['motivo']}. Sigo con la odometría hasta que el SLAM vuelva.")
                elif est == LOC_OK:
                    toast = ("success", "Localización recuperada", r["motivo"])
                else:
                    toast = None
                if toast:
                    await state.broadcast({"type": "toast", "data": {"kind": toast[0], "title": toast[1], "message": toast[2]}})
            previo = est
        except Exception as exc:
            print(f"[vigía pose] {type(exc).__name__}: {exc}", flush=True)
            await asyncio.sleep(1.0)


async def localizacion_handler(request: web.Request):
    """GET /api/localizacion — estado del vigía de la pose. POST {"x","y","theta_deg"} — el operador fija la pose (sale de anclada/perdida)."""
    if request.method == "POST":
        body = await request.json()
        ok = vigia_pose.reubicar(time.monotonic(), body)
        return web.json_response({"ok": ok, **vigia_pose.snapshot()}, status=200 if ok else 409)
    return web.json_response({"activo": _vigia_pose_activo(), **vigia_pose.snapshot(), "pose": vigia_pose.pose_dict(),
                              "eventos": vigia_pose.eventos[-10:]})


async def _vigia_lidar():
    ultimo_reinicio = time.monotonic()
    fallidos = 0                  # reinicios seguidos que no trajeron scans
    puerto_antes = _puerto_lidar()
    while True:
        await asyncio.sleep(1.0)
        try:
            if not ros_bridge.available:
                continue
            ahora = time.monotonic()
            if lidar_reactive.edad_scan_s() < LIDAR_MUDO_S:
                if fallidos:
                    print(f"[lidar] vuelven los scans tras {fallidos} reinicios", flush=True)
                fallidos = 0
                continue
            espera = min(LIDAR_ESPERA_MAX_S, LIDAR_ENTRE_REINICIOS_S * (2 ** min(fallidos, 4)))
            puerto = _puerto_lidar()
            # Si cambió el puerto (se volvió a enchufar el USB tras caer a la
            # UART) se relanza YA: con la espera acumulada, el 2026-09-30 el
            # LIDAR podía tardar hasta 5 min en volver después de enchufarlo.
            if puerto != puerto_antes:
                print(f"[lidar] el puerto cambió: {puerto_antes} -> {puerto}; relanzo el driver",
                      flush=True)
                puerto_antes = puerto
                fallidos = 0
                ultimo_reinicio = 0.0
                espera = 0.0
            if not puerto.exists() or ahora - ultimo_reinicio < espera:
                continue
            ultimo_reinicio = ahora
            if await asyncio.to_thread(_matar_sllidar):
                fallidos += 1
                print(f"[lidar] sin scans con {puerto} presente — driver relanzado "
                      f"(intento {fallidos}, siguiente en {espera:.0f} s)", flush=True)
                if fallidos <= 2:
                    via = "USB" if puerto == LIDAR_USB else "UART (pines 8/10)"
                    await state.broadcast({"type": "toast", "data": {
                        "kind": "warning", "title": "LIDAR sin datos",
                        "message": (f"Se relanzó el driver del LIDAR ({via}). Si sigue sin "
                                    f"datos, revisá cable y alimentación."),
                    }})
        except Exception as exc:
            print(f"[lidar] vigía falló: {type(exc).__name__}: {exc}", flush=True)


# =============================================
# ===== MANEJO MANUAL POR PULSOS =====
# =============================================
def _suelo_para_grabar() -> dict | None:
    r = suelo_libre.ultimo
    if r is None:
        return None
    return {"hueco": suelo_libre.hueco_delante(state.config["slam"]["robot_ancho_cm"] / 100.0),
            "suelo_pct": r["suelo_pct"], "objeto_en_referencia": r["objeto_en_referencia"]}


async def _bucle_grabador():
    """Graba la sesión a 10 Hz en un hilo aparte (escribir disco, comprimir
    scans y codificar JPEG no debe frenar el bucle del control)."""
    while True:
        await asyncio.sleep(1.0 / TELEMETRIA_HZ)
        try:
            await asyncio.to_thread(grabador.tick)
        except Exception as exc:
            print(f"[grabador] tick falló: {type(exc).__name__}: {exc}", flush=True)
            await asyncio.sleep(2.0)


SUELO_HZ = 8.0


async def _bucle_suelo_libre():
    """Analiza el suelo delante con cada fotograma (~8 Hz). Solo con la
    cámara al frente y quieta: con el servo girado la geometría no vale y un
    obstáculo saldría a una distancia falsa."""
    ultimo_n = None
    recorrido = 0.0        # distancia avanzada, para el paralaje de altura
    while True:
        await asyncio.sleep(1.0 / SUELO_HZ)
        try:
            if cv2 is None or camera is None:
                continue
            dato = camera.ultimo_frame()
            if dato is None or dato[2] == ultimo_n:
                continue
            ultimo_n = dato[2]
            al_frente, _ = _servo_al_frente()
            # Con el barrido activo la cámara mira a propósito al suelo cercano o
            # al sendero: si está quieta en un ángulo conocido, la geometría
            # corregida por tilt (ver _geometria_camara) sí vale.
            st_srv = state.actuator_status or {}
            # 2026-10-22: con el servo QUIETO en cualquier ángulo conocido la geometría vale (_geometria_camara suma el tilt del servo
            # siempre); antes solo se aceptaba HOME y con la cámara a 64° (mirando el suelo cercano) no había ningún dato.
            servo_quieto = bool(st_srv) and not st_srv.get("scanning") and time.time() - st_srv.get("_received_at", 0) < 1.0 \
                and st_srv.get("servo_angle") is not None
            if not al_frente and not _barrido_estable() and not servo_quieto:
                suelo_libre.ultimo = None          # nada de datos con la cámara moviéndose
                continue
            await asyncio.to_thread(suelo_libre.analizar, cv2, dato[0], _geometria_camara())
            # Paralaje: con el barrido activo, acumula avance y alimenta el
            # estimador de altura con la distancia al obstáculo que ve la cámara.
            if _barrido_activo():
                recorrido += abs(getattr(actuator_proto, "_ramp_v", 0.0)) / SUELO_HZ
                hueco = suelo_libre.hueco_delante(
                    state.config["slam"]["robot_ancho_cm"] / 100.0)
                estimador_altura.alimentar(recorrido, hueco, time.monotonic())
        except Exception as exc:
            print(f"[suelo] análisis falló: {type(exc).__name__}: {exc}", flush=True)
            await asyncio.sleep(1.0)


async def _bucle_barrido_tilt():
    """Mueve el servo de tilt en barrido (lejos=sendero / cerca=suelo) cuando el
    barrido está activo y hay autonomía. Con el flag OFF no toca el servo: lo
    maneja el operador. A ~5 Hz, suficiente para el dwell del barrido."""
    t0 = time.monotonic()
    anterior = None
    while True:
        await asyncio.sleep(0.2)
        try:
            if not _barrido_activo() or not _autonomia_activa() or actuator_proto is None:
                anterior = None
                continue
            v = abs(getattr(actuator_proto, "_ramp_v", 0.0))
            ang = clamp_servo(barrido_tilt_ctrl.angulo(time.monotonic() - t0, v))
            if ang != anterior:
                state.servo_angle = ang
                actuator_proto.send_actuator_update()
                anterior = ang
        except Exception as exc:
            print(f"[barrido] falló: {type(exc).__name__}: {exc}", flush=True)
            await asyncio.sleep(1.0)


async def suelo_vista_handler(request: web.Request):
    """GET /api/suelo/vista.jpg — suelo libre por cámara: verde = suelo,
    rojo = base de obstáculos, recuadro = franja de referencia."""
    if cv2 is None or camera is None:
        return web.json_response({"error": "cámara no disponible"}, status=503)
    dato = camera.ultimo_frame()
    if dato is None:
        return web.json_response({"error": "sin fotograma"}, status=503)
    img = cv2.resize(suelo_libre.dibujar(cv2, dato[0]), (480, 360), interpolation=cv2.INTER_NEAREST)
    ok, jpg = cv2.imencode(".jpg", img)
    return web.Response(body=jpg.tobytes(), content_type="image/jpeg",
                        headers={"Cache-Control": "no-store"})


async def suelo_estado_handler(request: web.Request):
    """GET /api/suelo — resumen del suelo libre (sin la máscara)."""
    r = suelo_libre.ultimo
    if r is None:
        return web.json_response({"activo": False})
    return web.json_response({
        "activo": True, "edad_s": round(time.monotonic() - r["t"], 2),
        "hueco_delante_m": suelo_libre.hueco_delante(state.config["slam"]["robot_ancho_cm"] / 100.0),
        "obstaculos": len(r["puntos"]), "objeto_en_referencia": r["objeto_en_referencia"],
        "referencia_dudosa": r["referencia_dudosa"], "suelo_pct": r["suelo_pct"],
        "distancia_min_visible_m": r["distancia_min_visible_m"]})


# ----- Evasión autónoma: decide con evasion.py, se mueve con paso_robotico -----
evasion_estado = {"activo": False, "decisiones": 0, "ultima": None, "resultado": None}
_evasion_tarea: asyncio.Task | None = None
RUTA_EVASION = Path.home() / ".agrobot" / "evasion"


def _puntos_camara() -> list[dict]:
    r = suelo_libre.ultimo
    if r is None or time.monotonic() - r["t"] > 0.6:
        return []
    puntos = list(r["puntos"])
    if r.get("objeto_en_referencia"):
        # Algo pegado delante que la cámara no alcanza a medir: se pone justo
        # en el frontal para que ninguna decisión avance hacia ahí.
        ml = state.config["slam"]["robot_largo_cm"] / 200.0
        puntos += [{"angle_deg": a, "distance_m": ml + 0.05} for a in (-10.0, 0.0, 10.0)]
    return puntos


async def _bucle_evasion(segundos: float, objetivo_deg: float):
    cfg_slam = state.config["slam"]
    umbral = (cfg_slam["margen_parada_cm"] + cfg_slam["deslizamiento_cm"]) / 100.0
    fin = time.monotonic() + segundos
    giros_fallidos = 0
    RUTA_EVASION.mkdir(parents=True, exist_ok=True)
    archivo = RUTA_EVASION / time.strftime("evasion_%Y%m%d_%H%M%S.jsonl")
    evasion_estado.update(activo=True, decisiones=0, ultima=None, resultado=None)
    resultado = "tiempo"
    try:
        while time.monotonic() < fin:
            if lidar_reactive.edad_scan_s() > 1.0:
                resultado = "sin_lidar"
                break
            d = evasion_mod.decidir(lidar_reactive.last_scan, _puntos_camara(),
                                    objetivo_deg=objetivo_deg, umbral_m=umbral,
                                    robot_largo_m=cfg_slam["robot_largo_cm"] / 100.0,
                                    robot_ancho_m=cfg_slam["robot_ancho_cm"] / 100.0)
            resumen = {k: v for k, v in d.items() if k != "libre"}
            evasion_estado["decisiones"] += 1
            evasion_estado["ultima"] = resumen
            await state.broadcast({"type": "evasion", "data": evasion_estado})
            if d["accion"] == "atascado":
                resultado = "atascado"
                break
            if d["accion"] == "avanzar":
                res = await paso_robotico.avanzar(d["cm"] / 100.0)
            elif d["accion"] == "retroceder":
                res = await paso_robotico.avanzar(-d["cm"] / 100.0)
            else:
                res = await paso_robotico.girar(d["grados"])
                # El giro en sitio rinde muy poco en este chasis (2026-10-02):
                # si dos giros seguidos no progresan, se para y se avisa.
                giros_fallidos = giros_fallidos + 1 if res["resultado"] == "sin_progreso" else 0
            with open(archivo, "a") as f:
                f.write(json.dumps({"t": time.strftime("%H:%M:%S"), "decision": resumen,
                                    "paso": res, "camara_pts": len(_puntos_camara())},
                                   ensure_ascii=False) + "\n")
            if giros_fallidos >= 2:
                resultado = "no_gira"
                break
            if res["resultado"] in ("sin_lidar",):
                resultado = res["resultado"]
                break
    except asyncio.CancelledError:
        resultado = "detenido"
        raise
    finally:
        conductor.parar()
        evasion_estado.update(activo=False, resultado=resultado)
        _schedule(state.broadcast({"type": "evasion", "data": evasion_estado}))
        print(f"[evasion] fin: {resultado} tras {evasion_estado['decisiones']} decisiones", flush=True)


def _detener_evasion():
    global _evasion_tarea
    if _evasion_tarea is not None and not _evasion_tarea.done():
        _evasion_tarea.cancel()
    _evasion_tarea = None


async def evasion_start_handler(request: web.Request):
    """POST /api/evasion/start {"segundos": 120, "objetivo_deg": 0}"""
    global _evasion_tarea
    if paso_robotico is None:
        return web.json_response({"error": "no disponible"}, status=503)
    if (_evasion_tarea is not None and not _evasion_tarea.done()) \
            or (patrol is not None and patrol.activo) or (explorador is not None and explorador.activo):
        return web.json_response({"error": "ya hay autonomía en marcha"}, status=409)
    try:
        body = await request.json()
    except Exception:
        body = {}
    segundos = max(5.0, min(1800.0, float(body.get("segundos", 120))))
    objetivo = float(body.get("objetivo_deg", 0.0))
    _evasion_tarea = asyncio.create_task(_bucle_evasion(segundos, objetivo))
    return web.json_response({"ok": True, "segundos": segundos, "objetivo_deg": objetivo})


async def evasion_stop_handler(request: web.Request):
    _detener_evasion()
    if paso_robotico is not None:
        paso_robotico.detener()
    return web.json_response({"ok": True, **evasion_estado})


async def evasion_get_handler(request: web.Request):
    return web.json_response(evasion_estado)


def _parada_total(origen: str, remote: bool = True, emergencia: bool = True, aviso: bool = True) -> list[str]:
    """PARADA DE EMERGENCIA (o, con emergencia=False, el STOP de la sección de manejo: misma parada,
    pero se avisa como «Parada» informativa y no cuenta como emergencia): detiene TODO lo que puede mover el robot.

    Un solo sitio para todos los caminos (botón del dashboard por HTTP o
    WebSocket, /api/drive "parar", downlink LoRa). Antes cada camino paraba
    una lista distinta y el botón no conocía la evasión ni el paso robótico:
    el lazo de pasos veía cortado su pulso, esperaba quieto, medía y mandaba
    el SIGUIENTE (2026-10-02, "no vale el stop de emergencia").

    Orden: primero lo que DECIDE (para que no vuelva a mandar nada), luego lo
    que ejecuta, y al final la trama de parada al C3. Síncrona y sin await:
    sirve también desde el callback UDP del LoRa."""
    hecho = []
    pasos = [
        ("misiones", lambda: gestor_misiones is not None and gestor_misiones.detener("parada")),
        ("mision_plantas", lambda: mision_plantas is not None and mision_plantas.detener("parada")),
        ("vision_activa", lambda: vision_activa is not None and vision_activa.cancelar("parada")),
        ("evasion", _detener_evasion),
        ("paso_robotico", lambda: paso_robotico is not None and paso_robotico.detener()),
        ("exploracion", lambda: explorador is not None and explorador.detener()),
        ("patrulla", lambda: patrol is not None and patrol.detener()),
        ("nav2", ros_bridge.cancel_nav_goal),
        ("saludo", lambda: saludo_tarea is not None and not saludo_tarea.done() and saludo_tarea.cancel()),
        ("maniobra_giro", lambda: _maniobra_giro_tarea is not None and not _maniobra_giro_tarea.done() and _maniobra_giro_tarea.cancel()),
        ("pulsos", lambda: conductor is not None and conductor.parar()),
        ("motores", lambda: actuator_proto is not None and actuator_proto.emergency_stop()),
    ]
    for nombre, fn in pasos:
        try:
            fn()
            hecho.append(nombre)
        except Exception as exc:          # una pieza rota no impide parar el resto
            print(f"[emergencia] {nombre} falló al parar: {type(exc).__name__}: {exc}", flush=True)
    state.mission_active = False
    print(f"[{'emergencia' if emergencia else 'parada'}] PARADA TOTAL ({origen}): {', '.join(hecho)}", flush=True)
    _schedule(state.broadcast({"type": "mission_state", "data": {"active": False}}))
    if aviso:
        _schedule(state.broadcast({"type": "toast", "data": {
            "kind": "error" if emergencia else "info",
            "title": "PARADA DE EMERGENCIA" if emergencia else "Parada de manejo",
            "message": f"Todo detenido ({origen})."}}))
    if remote:
        _schedule(c3_setup.stop())
    return hecho


# =============================================
# ===== MANEJO ASISTIDO (mando manual sobre la autonomía) =====
# =============================================
asistido = Asistido(Path.home() / ".agrobot" / "aprendizaje" / "intervenciones")


def _modo_auto_activo() -> str | None:
    """Qué autonomía está moviendo el robot ahora (None = ninguna). Orden: la más «alta» primero."""
    if mision_plantas is not None and mision_plantas.estado in ("explorando", "inspeccionando"):
        return "mision"
    if patrol is not None and patrol.activo:
        return "patrulla"
    if explorador is not None and explorador.activo:
        return "exploracion"
    if ros_bridge.available and ros_bridge.estado_meta() in ("enviada", "en_curso"):
        return "nav2"
    if vision_activa is not None and getattr(vision_activa, "estado", "inactiva") not in ("inactiva", "pausa"):
        return "vision_activa"
    if paso_robotico is not None and paso_robotico.estado.get("activo"):
        return "paso_robotico"
    return None


def _distancias_lidar() -> dict:
    try:
        return lidar_reactive.distancias(state.config["slam"])
    except Exception:
        return {}


def _pausar_autonomia():
    """PAUSA (no apaga) la autonomía: misión, exploración y patrulla siguen «activas» —la interfaz no pasa a manual— pero
    sueltan el mando; se cancelan la visión, la evasión, el paso robótico, la meta de Nav2 y los pulsos en curso."""
    pasos = [
        ("mision_plantas", lambda: mision_plantas is not None and mision_plantas.pausar()),
        ("exploracion", lambda: explorador is not None and explorador.pausar()),
        ("patrulla", lambda: patrol is not None and patrol.pausar()),
        ("vision_activa", lambda: vision_activa is not None and vision_activa.estado != "inactiva" and setattr(vision_activa, "pausa_externa", True)),
        ("evasion", _detener_evasion),
        ("paso_robotico", lambda: paso_robotico is not None and paso_robotico.detener()),
        ("nav2", ros_bridge.cancel_nav_goal),
        ("pulsos", lambda: conductor is not None and conductor.parar()),
        ("motores", lambda: actuator_proto is not None and actuator_proto.emergency_stop()),
    ]
    for nombre, fn in pasos:
        try:
            fn()
        except Exception as exc:
            print(f"[asistido] {nombre} falló al pausar: {type(exc).__name__}: {exc}", flush=True)


def _tomar_mando(origen: str) -> str | None:
    """El operador da una orden manual: si hay autonomía en marcha se PAUSA (queda registrado qué hacía y qué ordenaba) y el
    mando pasa a él un momento; vuelve sola (`_vigia_asistido`) o con el botón. Devuelve el modo interrumpido, o None."""
    if asistido.activa:
        return asistido.modo_previo                     # ya está en manos del operador
    modo = _modo_auto_activo()
    if modo is None:
        return None
    st = state.actuator_status or {}
    meta = (state.config.get("navigation") or {}).get("last_goal") if modo == "nav2" else None
    asistido.tomar(modo, (st.get("v_cmd") or 0.0, st.get("omega_cmd") or 0.0), meta)
    _pausar_autonomia()
    _schedule(state.broadcast({"type": "asistido", "data": asistido.estado()}))
    return modo


def _registrar_orden_manual(v: float, w: float, origen: str):
    if asistido.activa:
        asistido.muestra(v, w, current_pose(), _distancias_lidar(), origen)


async def asistido_estado_handler(request: web.Request):
    """GET /api/asistido — estado del mando, resumen de correcciones y ajustes sugeridos."""
    ev = asistido.leer()
    espera = _asistido_reanuda_s()
    reanuda_en = (max(0.0, round(espera - asistido.segundos_sin_orden(), 1)) if asistido.activa and espera > 0 else None)
    return web.json_response({**asistido.estado(), "autonomia_activa": _modo_auto_activo(),
                              "reanuda_s": espera, "reanuda_en_s": reanuda_en,
                              "resumen": asistido.resumen(ev), "sugerencias": asistido.sugerencias(state.config, ev)})


async def _reanudar_autonomia() -> tuple[bool, str, str | None]:
    """Devuelve el mando a la autonomía interrumpida (sin barrido inmediato y, en la misión, conservando las plantas)."""
    modo = asistido.modo_previo
    if not asistido.activa or modo is None:
        return False, "no hay ninguna autonomía interrumpida", None
    meta = asistido.meta_previa
    en_pausa = any(getattr(o, "pausado", False) for o in (mision_plantas, explorador, patrol) if o is not None)
    if _modo_auto_activo() is not None and not en_pausa:
        return False, "ya hay una autonomía en marcha", modo
    conductor.parar()
    ok, msg = False, "este modo no se puede reanudar solo"
    objetos = [o for o in (mision_plantas, explorador, patrol) if o is not None and getattr(o, "pausado", False)]
    if vision_activa is not None and getattr(vision_activa, "pausa_externa", False):
        vision_activa.pausa_externa = False                # la inspección sigue donde iba
        if modo == "vision_activa" and not objetos:
            ok, msg = True, "la visión activa continúa"
    if modo != "nav2" and objetos:
        for o in objetos:                                # en pausa: se CONTINÚA donde se quedó (plantas, ruta, contadores)
            o.continuar()
        ok, msg = True, "continúa donde se quedó"
    elif modo == "exploracion" and explorador is not None:
        explorador.escaneo_al_iniciar = False
        try:
            ok, msg = explorador.iniciar()
        finally:
            explorador.escaneo_al_iniciar = True
    elif modo == "patrulla" and patrol is not None:
        ok, msg = patrol.iniciar()
    elif modo == "mision" and mision_plantas is not None:
        ok, msg = mision_plantas.reanudar()
        if ok:
            mision_plantas.arrancar_tarea()
    elif modo == "nav2" and meta:
        ok = ros_bridge.send_nav_goal(float(meta["x"]), float(meta["y"]), float(meta.get("theta_deg", 0.0)))
        msg = "meta reenviada a Nav2" if ok else "Nav2 no respondió"
    if ok:
        asistido.soltar()
        state.mission_active = modo in ("exploracion", "mision", "patrulla")
    await state.broadcast({"type": "asistido", "data": asistido.estado()})
    return bool(ok), msg, modo


async def asistido_reanudar_handler(request: web.Request):
    """POST /api/asistido/reanudar — devuelve el mando a la autonomía que se interrumpió."""
    ok, msg, modo = await _reanudar_autonomia()
    return web.json_response({"ok": ok, "modo": modo, "msg": msg}, status=200 if ok else 409)


def _asistido_reanuda_s() -> float:
    try:
        return float((state.config.get("autonomia") or {}).get("asistido_reanuda_s", 2.5))
    except (TypeError, ValueError):
        return 2.5


async def _aprender_de_correcciones():
    """Las correcciones con los botones enseñan al robot: si se repiten, aplica solo el ajuste que lo hace MÁS cauto
    (parar antes, ir más despacio, mirar más a los lados). Los que lo harían menos cauto quedan como sugerencia manual."""
    if not (state.config.get("autonomia") or {}).get("asistido_aprende", True):
        return
    for sug in asistido.auto_aplicables(state.config):
        state.config = config_store.update_section(sug["seccion"], {sug["clave"]: sug["propuesto"]})
        asistido.marcar_aprendido(sug)
        print(f"[asistido] aprendido: {sug['seccion']}.{sug['clave']} {sug['actual']} -> {sug['propuesto']} ({sug['texto']})", flush=True)
        await state.broadcast({"type": "config_update", "data": state.config})
        await state.broadcast({"type": "toast", "data": {"kind": "info", "title": "Aprendí de tus correcciones",
                                                          "message": f"{sug['clave']}: {sug['actual']} → {sug['propuesto']}. {sug['texto']}"}})


async def _vigia_asistido():
    """Un toque de mando para corregir NO saca al robot del modo autónomo: pasados `autonomia.asistido_reanuda_s` segundos
    sin órdenes manuales (0 = nunca, hay que pulsar «Reanudar») la autonomía interrumpida vuelve sola."""
    while True:
        try:
            await asyncio.sleep(0.4)
            await _aprender_de_correcciones()
            espera = _asistido_reanuda_s()
            if asistido.activa and espera > 0 and asistido.segundos_sin_orden() >= espera and not conductor.activo:
                ok, msg, modo = await _reanudar_autonomia()
                if ok:
                    print(f"[asistido] reanudo «{modo}» tras {espera:g} s sin órdenes manuales", flush=True)
                    await state.broadcast({"type": "toast", "data": {"kind": "info", "title": "Autonomía reanudada",
                                                                      "message": f"«{modo}» sigue donde se quedó."}})
                elif modo is None or "no se puede reanudar" in msg:
                    asistido.soltar()               # nada que reanudar: se acaba la intervención en vez de reintentar siempre
                    await state.broadcast({"type": "asistido", "data": asistido.estado()})
        except asyncio.CancelledError:
            raise
        except Exception as exc:
            print(f"[asistido] vigía falló: {type(exc).__name__}: {exc}", flush=True)
            await asyncio.sleep(2.0)


async def asistido_soltar_handler(request: web.Request):
    """POST /api/asistido/soltar — se queda en manual: la autonomía interrumpida NO se reanuda."""
    hecho = []
    if asistido.activa:
        hecho = _parada_total("mando manual: se queda en manual", remote=False, emergencia=False, aviso=False)
    modo = asistido.soltar()
    await state.broadcast({"type": "asistido", "data": asistido.estado()})
    return web.json_response({"ok": True, "modo_descartado": modo, "detenido": hecho})


async def asistido_aplicar_handler(request: web.Request):
    """POST /api/asistido/aplicar {"id": ...} — aplica UNA sugerencia (nunca se aplican solas)."""
    body = await request.json()
    sug = {s["id"]: s for s in asistido.sugerencias(state.config)}.get(body.get("id"))
    if sug is None:
        return web.json_response({"error": "esa sugerencia ya no está vigente"}, status=404)
    data = config_store.update_section(sug["seccion"], {sug["clave"]: sug["propuesto"]})
    state.config = data
    await state.broadcast({"type": "config_update", "data": state.config})
    await state.broadcast({"type": "toast", "data": {
        "kind": "success", "title": "Ajuste aplicado",
        "message": f"{sug['seccion']}.{sug['clave']}: {sug['actual']} → {sug['propuesto']}"}})
    return web.json_response({"ok": True, "aplicado": sug})


async def emergencia_handler(request: web.Request):
    """POST /api/emergencia — parada total por HTTP (el WebSocket se cae al
    bloquear la pantalla del móvil; una petición HTTP llega o da error)."""
    try:
        tipo = (await request.json()).get("tipo")
    except Exception:
        tipo = None
    if tipo == "soltar":
        # 2026-10-22: el dashboard perdió el foco (otra pestaña, el video, una captura, pantalla bloqueada). Antes eso era PARADA DE
        # EMERGENCIA y apagaba el modo autónomo a cada rato. Ahora solo se suelta el manejo MANUAL; la autonomía sigue.
        if _autonomia_activa() or (vision_activa is not None and vision_activa.estado != "inactiva") \
                or (mision_plantas is not None and mision_plantas.estado in ("explorando", "inspeccionando")):
            return web.json_response({"ok": True, "detenido": [], "nota": "autonomía activa: sigue"})
        hecho = []
        for nombre, fn in (("pulsos", lambda: conductor is not None and conductor.parar()),
                           ("motores", lambda: actuator_proto is not None and actuator_proto.emergency_stop())):
            try:
                fn()
                hecho.append(nombre)
            except Exception as exc:
                print(f"[soltar] {nombre}: {exc}", flush=True)
        return web.json_response({"ok": True, "detenido": hecho})
    manejo = tipo == "manejo"
    hecho = _parada_total("manejo HTTP" if manejo else "dashboard HTTP", emergencia=not manejo)
    return web.json_response({"ok": True, "detenido": hecho})


def _pulso_robotico(accion: str, escala: float, maniobra: bool):
    """Un pulso para paso_robotico, con el acelerador de la config."""
    ctrl = state.config["control"]
    conductor.ordenar(accion, v_max=ctrl["max_v_mps"] * escala,
                      omega_max=ctrl["max_omega_rps"] * escala, maniobra=maniobra)


_plagasx_cls_modelo = None


def _plagasx_clasificador():
    global _plagasx_cls_modelo
    if _plagasx_cls_modelo is None:
        from ultralytics import YOLO
        _plagasx_cls_modelo = YOLO(str(Path(__file__).resolve().parent / "models" / "agrobot_plagasx_cls.pt"))
    return _plagasx_cls_modelo


def _gyro_dps():
    """Velocidad angular Z del IMU en °/s (+ izquierda, ya con sesgo y nivel corregidos) o None si el dato no es fresco."""
    env = state.env_telemetry or {}
    ra = env.get("_received_at")
    if ra is None or time.time() - ra > 0.5 or env.get("gyroZ") is None:
        return None
    return float(env["gyroZ"])


_mision_vision_override: dict = {}
mision_plantas = None


def _dist_caja_m(xyxy, ancho, alto):
    """Distancia (m) desde la cara delantera hasta la BASE de la caja, por la geometría de la cámara (suelo plano). None si la base
    queda por encima del horizonte. Sirve para macetas bajas que el LIDAR (a 37,5 cm) no ve."""
    try:
        x1, y1, x2, y2 = xyxy
        # Con zoom digital la imagen es el recorte CENTRAL ampliado z veces: se devuelve el píxel al cuadro sin zoom
        # (antes la distancia por cámara salía mal en cuanto se hacía zoom, y la visión activa ahora lo usa al acercarse).
        z = max(1.0, float(getattr(camera, "zoom", 1.0) or 1.0)) if camera is not None else 1.0
        xc = (x1 + x2) / 2.0
        yb = min(y2, alto - 1)
        xc = (xc - ancho / 2.0) / z + ancho / 2.0
        yb = (yb - alto / 2.0) / z + alto / 2.0
        u = xc * suelo_mod.ANCHO / float(ancho)
        v = yb * suelo_mod.ALTO / float(alto)
        x, y = suelo_libre.a_suelo(u, v, _geometria_camara())
        d = float(math.hypot(float(x), float(y))) - state.config["slam"]["robot_largo_cm"] / 200.0
        return round(d, 2) if math.isfinite(d) and d > 0 else None
    except Exception:
        return None


def _poner_led(on: bool):
    state.led_on = bool(on)
    if actuator_proto is not None:
        actuator_proto.send_actuator_update()
    _schedule(state.broadcast({"type": "actuator_setpoint", "data": {"servo_angle": state.servo_angle, "led": state.led_on}}))


def _grabar_video(on: bool):
    """Inicia/detiene la grabación (la misma del botón del dashboard) desde código síncrono."""
    global video_recording, _video_task, _video_file
    if on and not video_recording and camera is not None:
        _video_file = f"agrobot_planta_{time.strftime('%Y%m%d_%H%M%S')}.mp4"
        video_recording = True
        _video_task = asyncio.get_event_loop().create_task(_bucle_grabar_video(_video_file))
        print(f"[VIDEO] misión: grabando {_video_file}", flush=True)
    elif not on and video_recording:
        video_recording = False          # el bucle cierra el archivo solo


_servo_bajo = ServoBajo()
REPOSO_DEG_INTERIOR = _servo_bajo.reposo_deg
_zoom_auto = ZoomAuto()
_zoom_puesto_por_auto = False


async def _bucle_zoom_auto():
    """Zoom digital automático al acercarse a una planta (zoom_auto.py): sube hasta que la planta ocupa ~55 % de la imagen mientras la
    visión activa centra, se acerca, encuadra y analiza; vuelve a 1× al terminar. No toca el zoom si el operador tiene el mando o lo
    puso él (solo suelta el zoom que puso este lazo)."""
    global _zoom_puesto_por_auto
    while True:
        try:
            await asyncio.sleep(0.25)
            if camera is None or vision_activa is None:
                continue
            cfg = {**ZOOM_DEFECTOS, **(state.config.get("vision_activa") or {})}
            _zoom_auto.cfg = cfg
            estado = vision_activa.estado
            camera.guardar_nitidos = estado in ("analizando", "escaneando")
            if not cfg["zoom_auto"] or asistido.activa:
                continue
            if estado == "inactiva" and not _zoom_puesto_por_auto:
                continue
            f = camera.ultimo_frame()
            if f is None:
                continue
            h, w = f[0].shape[:2]
            with camera._lock:
                lista, ts = list(camera._cajas), camera._cajas_ts
            caja = None
            if ts is not None and time.time() - ts < 0.8:
                cand = [b for b in lista if float(b.get("confidence", 0)) >= 0.35
                        and any(k in str(b.get("class", "")).lower() for k in ("planta", "col", "maceta"))]
                if cand:
                    caja = max(cand, key=lambda b: (b["xyxy"][2] - b["xyxy"][0]) * (b["xyxy"][3] - b["xyxy"][1]))["xyxy"]
            nuevo = _zoom_auto.paso(estado, caja, w, h, float(camera.zoom), time.monotonic())
            if nuevo is None:
                if estado == "inactiva" and camera.zoom <= 1.02:
                    _zoom_puesto_por_auto = False
                continue
            camera.set_zoom(nuevo)
            _zoom_puesto_por_auto = nuevo > 1.02
            if hasattr(vision_activa, "_esperar"):
                vision_activa._esperar(0.7)                  # el zoom reabre/reencuadra: que no decida con cajas de antes
            await state.broadcast({"type": "zoom_auto", "data": {"zoom": nuevo, "estado": estado}})
        except asyncio.CancelledError:
            raise
        except Exception as exc:
            print(f"[zoom_auto] falló: {type(exc).__name__}: {exc}", flush=True)
            await asyncio.sleep(2.0)


async def _bucle_servo_macetas():
    """En autonomía, si una maceta está baja en la imagen (o cortada por el borde inferior) la cámara baja para no perderla antes
    de tocarla (servo_bajo.py). No actúa con el operador al mando, durante barridos de escaneo ni con la visión activa trabajando."""
    while True:
        try:
            await asyncio.sleep(0.5)
            if not state.config.get("autonomia", {}).get("servo_baja_macetas", True):
                continue
            if asistido.activa or camera is None or not _autonomia_activa():
                continue
            if vision_activa is not None and vision_activa.estado != "inactiva":
                continue
            if patrol is not None and getattr(patrol, "_escaneando", False):
                continue
            f = camera.ultimo_frame()
            if f is None:
                continue
            with camera._lock:
                lista, ts = list(camera._cajas), camera._cajas_ts
            if ts is None or time.time() - ts > 1.0:
                continue
            h = f[0].shape[0]
            cajas = [b["xyxy"] for b in lista if b.get("class") == "maceta" and float(b.get("confidence", 0)) >= 0.35]
            # Exterior (2026-10-28): con la cámara a 98° (15° bajo el horizonte) el suelo cercano ocupaba media imagen y no se veían ni las plantas ni el sendero
            # más allá de 1 m. En ese modo el reposo sube a `servo_exterior_deg` (~3° bajo el horizonte): se ve el camino libre y las plantas delante.
            _servo_bajo.reposo_deg = (float(state.config.get("autonomia", {}).get("servo_exterior_deg", 112))
                                      if conductor is not None and conductor.modo == "exterior" else REPOSO_DEG_INTERIOR)
            nuevo = _servo_bajo.paso(cajas, h, float(state.servo_angle), time.monotonic())
            if nuevo is not None:
                state.servo_angle = clamp_servo(float(nuevo))
                if actuator_proto is not None:
                    actuator_proto.send_actuator_update()
                await state.broadcast({"type": "actuator_setpoint",
                                       "data": {"servo_angle": state.servo_angle, "led": state.led_on}})
        except asyncio.CancelledError:
            raise
        except Exception as exc:
            print(f"[servo_bajo] falló: {type(exc).__name__}: {exc}", flush=True)
            await asyncio.sleep(2.0)


def _macetas_ahora():
    if camera is None:
        return []
    f = camera.ultimo_frame()
    if f is None:
        return []
    with camera._lock:
        lista, ts = list(camera._cajas), camera._cajas_ts
    if ts is None or time.time() - ts > 1.0:
        return []
    h, w = f[0].shape[:2]
    hf = vision_activa_mod.hfov_con_zoom(state.config["odometria_webcam"]["camara_hfov_deg"], getattr(camera, "zoom", 1.0))
    out = []
    for b in lista:
        if b.get("class") != "maceta":
            continue
        yaw, _ = vision_activa_mod.angulos_de_caja(b["xyxy"], w, h, hf, state.config.get("vision_activa", {}).get("camara_yaw_offset_deg", 0.0))
        out.append({"conf": float(b["confidence"]), "yaw_deg": yaw, "dist_m": _dist_caja_m(b["xyxy"], w, h)})
    return out


def _crear_mision_plantas():
    global mision_plantas
    import mision_plantas as mp

    async def guardar_mapa_mision(estado):
        """Al terminar la misión se guarda solo el mapa del SLAM con las plantas encontradas (para mostrarlo y recargarlo después).
        `estado` es una COPIA tomada al terminar: si el operador relanza la misión enseguida (28-oct, tres veces), mision_plantas.plantas ya está vacío cuando esto escribe."""
        nombre = time.strftime("mision_%Y%m%d_%H%M")
        try:
            info = await mapas.guardar(nombre, patrol.waypoints if patrol else [], True)
            (mapas.carpeta / nombre / "plantas.json").write_text(json.dumps(estado, indent=1, ensure_ascii=False))
            await state.broadcast({"type": "toast", "data": {"kind": "success", "title": "Mapa de la misión guardado",
                                                             "message": f"«{info['nombre']}» con {len(estado.get('plantas', []))} planta(s)."}})
        except Exception as exc:
            print(f"[mision_plantas] no se pudo guardar el mapa: {exc}", flush=True)

    def evento(e):
        print(f"[mision_plantas] {e}", flush=True)
        if e.get("tipo") == "mision_fin":
            _schedule(guardar_mapa_mision(json.loads(json.dumps(mision_plantas.estado_dict(), default=str))))
            if gestor_misiones is not None:
                gestor_misiones.al_fin_mision_plantas(e.get("motivo"))
        elif e.get("tipo") == "planta_inspeccionada" and gestor_misiones is not None:
            try:
                gestor_misiones.al_planta(mision_plantas.plantas[-1] if mision_plantas.plantas else e, getattr(vision_activa, "ultimo_resultado", None))
            except Exception as exc:
                print(f"[misiones] no se pudo registrar la planta: {exc}", flush=True)
        _schedule(state.broadcast({"type": "mision_plantas", "data": e}))
        titulos = {"planta_detectada": "Planta detectada", "planta_inspeccionada": "Planta escaneada", "mision_fin": "Misión terminada"}
        if e.get("tipo") in titulos:
            _schedule(state.broadcast({"type": "toast", "data": {"kind": "success", "title": titulos[e["tipo"]],
                                                                  "message": ", ".join(f"{k}: {v}" for k, v in e.items() if k != "tipo")}}))

    mision_plantas = mp.MisionPlantas(explorador=explorador, vision=vision_activa, get_macetas=_macetas_ahora,
                                      get_pose=_pose_robusta, led=_poner_led, grabar=_grabar_video,
                                      get_config=lambda: {**state.config.get("mision_plantas", {}), **_mision_plantas_extra}, on_event=evento)
    _crear_gestor_misiones()


_mision_plantas_extra: dict = {}
gestor_misiones = None
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
