DAvolmx/AGROBOT_V1/agrobot_system_2/jetson/backend/uart_link.py

"""
Enlace UART por cable entre la Jetson y el ESP32-C3 actuador.

Es el tercer transporte de esta pareja, y el ultimo. Los dos anteriores se
retiraron el 2026-09-04 y conviene saber por que para no reintroducirlos:

  - WiFi + UDP: el ESP32-C3 tiene UNA sola radio de 2.4 GHz. La asociacion
    al AP de la Jetson se caia sola y no se recuperaba.
  - BLE: quitar el WiFi le dejaba la radio entera, pero la placa dejo de
    anunciarse y el enlace nunca llego a establecerse.

Las dos placas van atornilladas al mismo robot, a veinte centimetros una de
otra. Un enlace por radio entre ellas nunca compro nada y aportaba todos los
modos de fallo. Un cable de tres hilos no se desasocia, no comparte antena y
no negocia nada.

CABLEADO
    Jetson pin 8  (TXD, /dev/ttyTHS1)  ->  C3 GPIO20 (RX)
    Jetson pin 10 (RXD, /dev/ttyTHS1)  <-  C3 GPIO21 (TX)
    Jetson pin 6  (GND)                 -  C3 GND

TRAMADO
Un UART entrega un chorro de bytes, no paquetes: no hay nada que diga donde
empieza una trama. De ahi el byte de inicio (para resincronizar) y el CRC-8
(para que un magic aparecido por casualidad dentro de los datos no se tome
por el principio de una trama). El bootloader del C3 escupe su mensaje de
arranque por estos mismos pines en cada reset, asi que basura en la linea no
es una hipotesis remota: es lo normal al encender.

Debe coincidir byte a byte con
firmware/esp32c3_actuator/esp32c3_actuator.ino.
"""

from __future__ import annotations

import asyncio
import struct
import time

import serial_asyncio

from protocol import SERVO_HOME_DEG, clamp_servo
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
