DAvolmx/AGROBOT_V1/(commit log)

2026-09-17 Estado inicial del AgroBot bajo control de versiones
    Primer commit del proyecto: hasta hoy no había historial y los cambios se
    guardaban como archivos .bak sueltos. Incluye todo el trabajo del
    2026-09-16/17: patrulla autónoma, Nav2 sobre el SLAM en vivo, manejo por
    pulsos, frenado por corredor del LIDAR, vigía de reloj y respawn del LIDAR,
    más una copia de los archivos de sistema (systemd, hostapd) que viven fuera
    del proyecto.
2026-09-17 Frenar con antelación al deslizamiento medido de 80 cm
    El frenado reducía la velocidad de forma gradual, pero el firmware mapea
    cualquier velocidad a PWM 200-255 (78-100 %) y deja las ruedas sueltas al
    parar: bajar la velocidad casi no frenaba y el robot deslizaba ~80 cm.
    Ahora se cortan los motores cuando el hueco libre es menor que margen +
    deslizamiento, y sin datos del LIDAR no se permite avanzar ni retroceder.
2026-09-17 Guardar y reusar mapas con nombre junto a su recorrido
    Cada reinicio de ROS empezaba un mapa nuevo y el recorrido de patrulla
    grabado dejaba de valer. Ahora se guarda el grafo de slam_toolbox (no solo
    la imagen) con su recorrido bajo un nombre, y al cargarlo el SLAM sigue
    ampliando ese mapa. El robot debe estar en la base donde empezó el mapa.
2026-09-17 Actualizar el MANIFEST al estado del 2026-09-17
    Añade una sección 0 con el estado vigente (arranque real por systemd, red,
    reloj, Nav2, patrulla, frenado, límites físicos medidos y pendientes),
    marca como reemplazadas las secciones que ya no eran ciertas y corrige la
    entrada del 2026-09-13, que describía como funcionando algo que nunca actuó.
2026-09-17 Preparar odometría visual con cámara de profundidad fija
    La webcam actual es monocular y va sobre el servo de escaneo, así que no
    sirve para odometría. Queda listo, apagado por defecto, el launch con
    rtabmap rgbd_odometry para RealSense u OAK-D, su fusión en el EKF como
    odom2 y una variable en /etc/default/agrobot para activarlo sin editar el
    servicio. Validado sin cámara; falta probarlo con imágenes reales.
2026-09-17 Odometría visual con la webcam por modelo de suelo plano
    La cámara es monocular y va sobre el servo, así que la escala sale de la
    altura e inclinación de la cámara y la medición se pausa cuando el servo no
    mira al frente. Mide y se muestra junto al EKF para calibrarla; no se
    fusiona hasta que el operador lo active. De paso, camera.py dejaba las cajas
    de YOLO dibujadas sobre el frame que usaba la propia detección.
2026-09-17 No quedar atascado buscando rasgos en la odometría visual
    Con el robot encendido la vista daba 58 rasgos y el código volvía a buscar
    mientras hubiera menos de 60, así que nunca llegaba a medir. Ahora sigue con
    los que haya desde 12 y repone rasgos en el mismo cuadro cuando se pierden.
    Verificado en vivo: midiendo a 15 Hz, cero con el robot quieto.
2026-09-17 Arreglar el modo autónomo, añadir exploración y grabación de recorrido
    El robot nunca se movía en autónomo porque bt_navigator tenía el árbol de
    comportamiento vacío ("" no es "el de por defecto" en Jazzy): aceptaba cada
    meta y la abortaba al instante. Ahora el árbol viaja con cada meta.
    Añade modo exploración reactivo (LIDAR + pulsos, sin Nav2), grabación
    automática de un punto cada 1,5 m mientras se conduce, y los puntos
    dibujados sobre el mapa. Saca del bucle de eventos las llamadas que lo
    bloqueaban más que el latido del WebSocket y tiraban el enlace.
2026-09-17 Evitar que un callback de ROS tumbe el backend, y aligerar el dashboard
    El aviso de obstáculo creaba una tarea de asyncio desde el hilo de ROS
    (callback de /cmd_vel de Nav2, que solo empezó a llegar al arreglar el árbol
    de comportamiento). El RuntimeError mataba el hilo del ejecutor: el backend
    seguía vivo y respondiendo HTTP pero sin LIDAR, sin mapa y sin navegación.
    Ahora se usa el planificador thread-safe, cada callback va protegido y el
    hilo del ejecutor se relanza si cae.
    Además: distancia entre puntos configurable con slider (0,50 m por defecto),
    la exploración no arranca ni sigue sin LIDAR fresco, y el radar y la pose se
    mandan al navegador a 4 y 8 Hz en vez de 10 y 20.
    Co-Au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
2026-09-17 Medir obstáculos por sectores configurables y todo en centímetros
    El corredor del ancho del robot metía las paredes de un pasillo estrecho
    dentro del sector frontal: el robot se paraba sin tener nada delante. Ahora
    son sectores angulares que el operador ajusta (cono frontal, su espejo
    trasero y cono lateral), con los umbrales en cm.
    Añade control total de la autonomía desde Parámetros (avance, lado y
    retroceso libres, acelerador, periodo de barrido y distancia entre puntos).
2026-09-17 Mantener el AP y el cliente Wi-Fi en el mismo canal de forma permanente
    La sincronización solo corría al arrancar hostapd, y el router reelige canal
    por su cuenta: el 2026-09-17 quedaron en 11 y 1 sobre la misma radio, que es
    enlace intermitente y latencia. Ahora un temporizador lo revisa cada minuto
    y reinicia hostapd solo si hace falta.
2026-09-17 Seguir senderos, barrido por software y manejo suave troceado
    Seguir senderos (sendero.py) combina el centrado entre hileras por LIDAR con
    la detección del camino por color, y corrige con pulsos de giro.
    El barrido de cámara pasa del firmware a la Jetson: servo paso a paso con
    duración y ángulos configurables, y enciende el foco mientras barre.
    Los motores no bajan del 78 % de potencia, así que para ir lento cada pulso
    se trocea por software: al 60 % del ciclo la velocidad media cae de 0,47 a
    0,26 m/s.
    De paso, el foco estaba invertido en uart_link: salía encendido al arrancar
    y la parada de emergencia lo encendía en vez de apagarlo.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
2026-09-17 Corregir el sentido de la inversión del foco
    La inversión sí hace falta, pero en uart_link, no en jetson_server: el
    firmware tiene LED_ACTIVO_EN_BAJO=true (encender escribe el pin en BAJO) y
    la etapa de potencia del foco de este robot es de lógica normal, se enciende
    con el pin en ALTO. La constante del firmware no se puede cambiar porque
    GPIO8 es pin de strapping y la placa no arrancaría.
    Al invertirlo en el lado equivocado, el foco se apagaba justo al escanear.
2026-09-19 Mejoras de navegación robótica + sistema de retroalimentación de datos
    · Evasión mejorada: detecta obstáculo → mide LIDAR izq/der → elige lado con más espacio
    · Reinicialización de pose en patrulla: previene desincroniación del SLAM (AMCL)
    · Sistema de logging asincrónico: captura poses, LIDAR, obstáculos, eventos
    · Pruebas en escritorio: simulación en habitación cuadrada (3×3m)
    · Analizador automatizado: sugiere ajustes de parámetros basado en datos reales
    Archivos nuevos:
    - navigation_logger.py: recolección de datos en CSV/JSONL con buffer asincrónico
    - test_habitacion_cuadrada.py: pruebas de navegación básica en escritorio
    - analizar_navegacion.py: análisis po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
2026-09-19 Panel de calibración de navegación en el dashboard
    Añade un tercer modo «Calibración · validar» en la pestaña Navegación
    para grabar poses y LIDAR mientras se conduce por la habitación,
    analizar la sesión con sugerencias automáticas de parámetros, y
    transicionar directamente a patrulla sin perder el mapa.
2026-09-19 Permitir git commit en settings locales de Claude Code
2026-09-19 Corregir análisis de calibración: KeyError en patrulla vacía y flush
2026-09-19 Tuning integral de navegación: SLAM denso, EKF robusto, Nav2 con RotationShim
    El mapa se desplazaba en las primeras calibraciones por odometría ruidosa
    (rf2o sin encoders) y parámetros conservadores de slam_toolbox. Este commit
    reajusta todo el pipeline LIDAR→EKF→SLAM→Nav2:
    - slam_toolbox: grafo más denso (0.12 m / 0.15 rad), cierre de bucles
    activo, correlación ampliada a 0.6 m, rango máximo 8 m, lee /scan_slam
    filtrado (mediana espacial + rango) en vez de /scan crudo.
    - EKF: process_noise_covariance explícita — desconfía de vx (rf2o: 0.10)
    más que de vyaw (giroscopio: 0.05).
    - Nav2: RotationShimController envuelve DWB (gira primero, luego avanza),
    escalas explíci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
2026-09-19 Dashboard de entrenamiento: corrección de pose, surcos y puntos de escaneo
    Nuevo dashboard separado (training.html) para la fase de entrenamiento
    en campo. El operador corrige la pose del robot con un clic, dibuja
    surcos de cultivo sobre el mapa, coloca puntos de escaneo con marcadores
    de planta, y genera rutas boustrophedon automáticas. Las correcciones
    de conducción se registran para aprendizaje futuro.
    Backend: 6 endpoints /api/training/* con persistencia en ~/.agrobot/training/.
    ROS bridge: publisher /initialpose (PoseWithCovarianceStamped) para
    reposicionar el robot en SLAM sin reiniciar.
2026-09-19 Modos de manejo interior/exterior y maniobra de giro más corta
    Problema: la maniobra de giro anterior (0.6s a 50% de velocidad) movía
    el robot demasiado adelante/atrás y pisaba las plantas. Ahora el modo
    exterior usa arcos de 0.3s a 25% — un cuarto del desplazamiento lineal.
    Dos modos de manejo con parámetros diferenciados:
    - Interior: suave (60% velocidad), pulsos cortos, giro puro sobre el eje
    - Exterior: velocidad completa, maniobra rápida con arcos muy cortos
    Enlace al dashboard de entrenamiento desde la barra lateral del dashboard
    principal. Selector de modo y toggle de maniobra en ambos dashboards.
2026-09-19 LIDAR por número de serie y manejo arreglado en ambos dashboards
    El LIDAR se reenumeró como ttyUSB1 y el launch lo buscaba fijo en
    ttyUSB0: sin scans, el freno por LIDAR bloqueaba adelante/atrás y solo
    giraba. Ahora ambos launch usan /dev/serial/by-id del CP2102N.
    Dashboard de entrenamiento: un toque = un pulso, como el principal. Antes
    mandaba "parar" al soltar, cortando el pulso y deteniendo la patrulla.
    Dashboard principal: los botones Interior/Exterior no respondían (onclick
    fuera del IIFE); ahora usan listeners y ambos dashboards se sincronizan
    por el mensaje drive_mode del WebSocket.
    Incluye ajustes de conos y margen hechos por el usuario desde el dashboard.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
2026-09-19 LIDAR girado 180°, vigía del driver y freno que solo mira el camino
    Con el C1 montado según la flecha de la carcasa, el 0° de sllidar_ros2
    apunta hacia atrás del robot (una persona 90 cm detrás salía en 0°). Yaw pi
    en el TF base_link->laser de ambos launch y LIDAR_YAW_DEG=180 en ros_bridge
    para el freno y el radar del backend.
    El CP2102N se cae del USB y sllidar_node queda colgado sin morir, así que
    el respawn no actúa y sin scans se bloqueaban adelante/atrás. _vigia_lidar
    mata el driver tras 4 s sin scan con el USB presente; el respawn lo relanza.
    Edad del scan con reloj monotónico para no dispararlo con saltos de reloj.
    Freno por LIDAR: se ignoran los retornos dentro de la hu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
2026-09-19 Detección de senderos por cámara, trazado en el mapa principal e informe
    sendero.py reescrito para la huerta real (tierra oscura bordeada de paja,
    plantas chicas que el LIDAR no ve): bordes de paja y vegetación proyectados
    a vista cenital, rumbo por alineación de bordes y sendero como hueco libre;
    error en metros con el mismo signo que el del LIDAR. Prueba de regresión
    tools/probar_sendero.py (36/36, 1,3 cm de error lateral medio) y vista de
    depuración en /api/sendero/vista.jpg y en el dashboard de entrenamiento.
    El mapa del dashboard principal es más grande, con zoom y arrastre, y trae
    las herramientas de surcos y puntos de escaneo del de entrenamiento. Se
    corrige la flecha del robo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
2026-09-20 Simulador que corre el código real del robot, y paja detectada por color
    simulador/ monta un mundo 2D donde las paredes las ve el LIDAR y el sendero,
    la paja y las plantas solo la cámara, como en el campo. Importa y ejecuta los
    módulos reales (freno, seguidor de senderos, explorador, pulsos) con reloj
    virtual: 120 s de episodio en ~20 s reales. Cinco escenarios: bucle, hileras,
    pasillo, callejón sin salida y trampa de bucle.
    La primera tanda destapa dos fallos de la autonomía: en el callejón el robot
    pasa 43 s rozando la pared (el freno no recorta el giro, a propósito) y en la
    trampa gasta 229 giros sin salir.
    mascara_paja suma un criterio de color (saturación sobre la del suelo) p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
2026-09-20 Registrar de verdad las velocidades en las sesiones de calibración
    _nav_cal_loop llamaba a log_pose() sin velocidades, así que las cuatro
    columnas quedaban en cero en todas las sesiones y no se podía comparar lo
    comandado con lo real. Ahora lo pedido sale del actuador (tras la rampa) y
    lo real del EKF.
2026-09-20 Autonomía: pivote junto a obstáculos, salida de callejón y ruptura de bucles
    Medido en el simulador: el robot pasaba 43 s rozando la pared del callejón
    porque giraba SIEMPRE con la maniobra de tierra blanda (arco adelante+atrás)
    y volvía a decidir cada 0,25 s sin comprometerse a salir.
    - La maniobra solo se usa si hay sitio delante y detrás; si no, pivota.
    - Callejón (frente y ambos lados bloqueados): pivota hasta encontrar salida
    en vez de oscilar entre girar y retroceder.
    - Memoria de celdas de 50 cm: volver 3 veces tras 15 s fuera = está dando
    vueltas, y entonces insiste en el lado menos pisado.
    - Recentrarse en el sendero es pivote (no traslada, no pisa plantas), con al
    m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
2026-09-20 Entrenador: correcciones en vivo, política .pt, SLAM simulado y ruta ideal
    Se puede corregir al robot sin sacarlo de automático: la autonomía cede el
    mando y los pulsos seguidos se guardan como UNA maniobra atada a la firma de
    la situación, que luego repite sola (aprendizaje.py, lo usa el robot real).
    entrenar.py cierra el ciclo simulación -> robot: recoge recorridos ideales en
    escenarios aleatorios, entrena una red pequeña (politica.pt) y la evalúa. Con
    3018 ejemplos: desvío 35,7 -> 3,5 cm, plantas pisadas 1,67 -> 0, choques 1 -> 0.
    El simulador ahora reproduce los errores que importan: SLAM con deriva y
    saltos de cierre de bucle (el software navega con esa pose, no con la
    verdade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
2026-09-20 Visor 3D en WebGL con Three.js y controles por botones
    Pestaña "3D interactivo": terreno con relieve e iluminación, paredes,
    plantas, macetas, ramas, puntos de escaneo, el robot y el fantasma de donde
    cree estar el SLAM, más las trazas y la ruta ideal.
    El terreno se texturiza con la imagen que genera el propio simulador y con un
    mapa de normales derivado de ella, así el suelo del 3D es el MISMO que ve la
    cámara del robot; no hacen falta paquetes de texturas descargados. Three.js
    r128 va dentro del repo para que funcione en la red aislada del robot.
    Las dos vistas 3D se manejan ahora con botones (girar, inclinar, acercar,
    alejar, cenital, detrás del robot y cámara del robot); el zoom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
2026-09-20 Entrenamiento nocturno sobre el mapa del usuario y arreglos de fidelidad
    --horas deja el entrenador corriendo toda la noche: recolecta, reentrena con
    todo lo acumulado, evalúa cada tres tandas, guarda copia del modelo por tanda
    y anota en un log. Un episodio que falle no tumba la sesión.
    --mundo entrena sobre un mapa dibujado en el dashboard, variándolo en cada
    episodio (humedad del suelo, tipo de borde, ancho del sendero, ramas y
    macetas sueltas, punto de arranque) y mezclándolo con escenarios al azar.
    Tres arreglos de fidelidad encontrados al probarlo:
    - El firmware mueve el robot con CUALQUIER orden no nula (PWM 200..255). El
    umbral de 0,02 m/s hacía que el robot simulado casi no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
2026-09-20 Montecarlo de configuraciones, escaneo simulado, plantas con altura y mapa difícil
    montecarlo.py sortea variantes de los parámetros del ROBOT (conos, margen de
    parada, velocidad, tolerancia del sendero, inclinación del servo), las compara
    con las mismas semillas y escenarios, elimina por rondas y reparte el trabajo
    entre núcleos. La configuración actual entra como candidata y nunca se
    elimina, así se ve si la ganadora mejora de verdad. Con --aplicar se instala
    en agrobot_config.json con copia de seguridad.
    El escaneo ya se simula de verdad: el robot se para, enciende el foco y barre
    con el servo de escaneo_angulo_min a max; una planta cuenta como escaneada si
    entra en el campo de la c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
2026-09-20 Realismo de sensores, historial de modelos, mapa EXTERIOR1 y paredes 3D
    IMU cabeceo (filtro complementario gyro+accel con gating), aplanado de
    iluminación contra viñeteo, entrenamiento con balanced accuracy para
    evitar colapso a clase mayoritaria. Historial y ranking de modelos con
    validación cruzada en 5 escenarios. Mapa EXTERIOR1 del usuario con
    sendero densificado. Paredes del 3D interactivo corregidas (rotación
    invertida). Dashboard con pestaña Historial (gráfico en vivo, ranking,
    despliegue). Post-entrenamiento automático.
2026-09-30 Enlace redundante con la C3, ZUPT contra el mapa de 9,7 km y simulador realista
    - C3 por BLE + WiFi UDP a la vez: el firmware aplica la trama más nueva por
    número de secuencia venga por donde venga; la Jetson manda por las dos
    (enlace_c3.py, udp_actuator_link.py). Parámetros BLE tolerantes a la señal
    débil de la placa nueva (-95 dBm) y potencia WiFi adaptativa.
    - ZUPT en /zupt (odom4 del EKF): sin él, con el LIDAR caído, el EKF
    extrapoló horas y estiró el mapa a 9,7 km (82 MB por /map, OOM).
    - Salud con detalle por fila, EKF y mapa corrupto; LoRa con pérdida y
    reinicios por seq; BLE que reinicia el adaptador si queda sordo.
    - LIDAR: puerto elegido en cada arranque, autoim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
2026-09-30 Preparación para terreno: servo, giroscopio, temperatura, GPU y sensores calibrados
    - Servo: los falsos positivos de YOLO lanzaban un barrido cada 30 s también
    en manual; ahora la detección debe persistir y el robot haberse movido.
    - Giroscopio: sesgo autocalibrado en reposo y covarianzas reales en el IMU
    y el ZUPT (la pose giraba 53°/min quieta; ahora 0,025 °/s).
    - Temperatura: el BLE reintenta cada 30 s si la C3 responde por WiFi (la
    tarjeta WiFi/BT llegaba a 80 °C); dashboard con TEMP CHIP y TEMP WIFI.
    - Firmware C3: declaración adelantada de CmdFrame para el IDE de Arduino.
    - Simulador calibrado con scans y fotogramas reales de la habitación;
    render de cámara y entrenami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
2026-09-30 Registrar la política desplegada para terreno (tanda048)
2026-10-01 Red fija y móvil: router en modo router, IP reservadas y documentación
    El DIR-615 pasó de punto de acceso a router (192.168.0.1) con IP fijas para
    la Pi (.10/.20), la Jetson (.142) y el gateway Heltec (.11). Las alertas de la
    Jetson ahora van a la Pi en 192.168.0.10:8092. Plan completo en
    docs/RED_E_IPS.md; los respaldos del router quedan fuera de git.
2026-10-01 Freno activo en la C3, clave del dashboard y reserva de WAN del router
    - Firmware: rueda parada = freno del TA6586 (FI=BI=HIGH) en vez de rueda libre.
    - Backend: clave opcional del dashboard (archivo fuera del repo) con cookie de
    sesión para el WebSocket; localhost exento.
    - Router: Cliente Wi-Fi a LORA como respaldo del cable (reserva de WAN).
    - tools/dlink_rpc.py: cliente de la API del DIR-615X.
2026-10-01 C3: traseros como motores de apoyo, rampa de aceleración y servo suave
2026-10-01 Detección a 10 Hz en GPU y servicio de máximo rendimiento (MAXN SUPER)
2026-10-01 Detección de patinaje/atasco y modo seguro con rearme (estilo róveres NASA/JPL)
2026-10-01 Simulador con freno activo, traseros de apoyo e IMU medida; servicio de rendimiento a 15 W
2026-10-01 Firmware: tope de dt en la rampa; test de comportamiento del .ino real; vigía de sesión
2026-10-01 Entrenamiento a prueba de OOM: supervisor que relanza y dataset en arreglos compactos
2026-10-01 Validación de modelos: un proceso por modelo (evita el OOM)
2026-10-01 Informe de la sesión, resultados del entrenamiento y validación en el MANIFEST
2026-10-01 Despliegue de la política t027, relojes fijos, WiFi sin ahorro y registros persistentes
2026-10-02 MANIFEST: fallos de la prueba de manejo en pasillo (2026-10-02)
    Rampa de la Jetson en 0,1/0,2 que impedía mover y girar, modo seguro
    enganchado por un hueco de la C3, patrulla lanzada en SEGURO, exploración
    atascada y "adelante" medido hacia atrás (sin resolver).
2026-10-02 MANIFEST: falta de torque por el troceado de la Jetson contra el freno activo
2026-10-02 C3: motores frenados lo primero en setup() (llanta trasera suelta tras reinicio)
    Los pines de motor se ponían en LOW después de esperar al Serial (~1,7 s).
    La C3 y el LoRa V3 se reinician juntos por caída de alimentación, y en ese
    rato las traseras (GPIO4..7, pines JTAG) quedaban sin manejar.
2026-10-02 MANIFEST: rf2o invierte la velocidad lineal; el TF del LIDAR estaba bien
    Corrige la entrada anterior: el robot sí avanza hacia la cámara. Anota el
    cambio de yaw hecho y revertido por error, motores sin fuerza con la C3 al
    100 %, y el backend que no se cierra con SIGTERM.
2026-10-02 Giro invertido tras reconectar los drivers: INVERTIR_GIRO en enlace_c3
    "Izquierda" giraba a la derecha (lo vio el usuario; EKF y LIDAR lo
    confirman) y avanzar iba bien: lados cruzados. Se niega omega en el único
    punto de salida hacia la C3 (BLE y WiFi) y el eco de estado al volver.
    MANIFEST: pasos de manejo registrados, obstáculos bajos invisibles al
    LIDAR y pivote que casi no rota.
2026-10-02 C3: más potencia a los motores traseros de apoyo
    Giro: factor 0,85 -> 1,00 y tope 215 -> 255; recta: 0,60 -> 0,80. El
    robot casi no pivotaba en cemento (1-4 grados por pulso). Protección
    térmica sin cambios. Pruebas ajustadas a las constantes.
2026-10-02 C3: watchdog del lazo principal (2 s) para que un loop colgado no deje los motores andando
2026-10-02 Sentido del cableado de motores en el firmware; la Jetson ya no invierte el giro
    Tras recablear los drivers el robot hacía (v, w) -> (-v, w). Se corrige en
    applyMotors() con CABLEADO_INVIERTE_AVANCE y enlace_c3.INVERTIR_GIRO vuelve
    a False.
2026-10-02 Simulador calibrado con el pasillo real y movimiento robótico por pulsos
    - tools/calibrar_con_pasillo.py ajusta frenada (3,24 m/s²), rendimiento de
    giro (0,019) y retroceso al girar (0,053) con los pulsos medidos el
    2026-10-02 -> simulador/calibracion_real.json; entrenar.aleatorizar() los
    usa como centro de lo que sortea.
    - robot.py: retroceso al girar sobre el eje.
    - mundo.py: escenario pasillo_real (pasillo de 65 cm, poste, pesa, cobija
    y chancla invisibles al LIDAR).
    - paso_robotico.py + /api/paso: pulso -> quieto -> medir con LIDAR/giróscopo
    -> decidir; se rinde sin progreso, ante obstáculo o sin hueco detrás, y
    registra cada pulso en ~/.agrobot/pasos_roboticos/.
    Co-Aut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
2026-10-02 Suelo libre por cámara en el freno y modo de evasión de obstáculos
    suelo_libre.py ve lo bajo que el LIDAR no (cobija, pesa): referencia de
    suelo con memoria, scan virtual por geometría de cámara. El freno usa el
    mínimo LIDAR/cámara. evasion.py (VFH) elige dirección y no propone girar
    donde no cabe; /api/evasion la ejecuta con paso_robotico.
2026-10-02 Entrenamiento: objetos con sus medidas, freno con cámara en el simulador y sin episodios que chocan
    - mundo_variado() perdía radio/altura de los objetos de los escenarios: el
    poste de pasillo_real tapaba la salida (episodios de 0 m) y la pesa
    invisible al LIDAR pasaba a ser visible.
    - El simulador frena también con suelo_libre (cámara simulada a 4 Hz).
    - Se descartan episodios ideales con más de max(3, 0,5/m) choques; los
    nuevos ejemplos se marcan ideal_dr3.
    - pasillo_real: sin cobija (la retiró el usuario) y ruta que no corta la
    esquina ni pasa pegada al poste.
2026-10-02 Prueba con el firmware nuevo: memoria del suelo que se reaprende y paso robótico que detecta deriva
    - suelo_libre: si con el suelo recordado coincide < 5 % de la imagen, el
    recuerdo está mal y se reaprende (tras reiniciar bloqueaba el freno).
    - paso_robotico: para con deriva_rumbo (> 8° en un pulso recto) y
    medida_incoherente (delante/detrás discrepan > 10 cm).
    - MANIFEST: el robot se desvía 8-16° a la derecha por pulso recto.
2026-10-02 Parada de emergencia total por HTTP y WebSocket; modo de pulsos cortos
    _parada_total() única para botón, /api/emergencia, /api/drive parar y
    LoRa: ahora también para la evasión y el paso robótico (antes el lazo
    mandaba otro pulso tras el STOP). El dashboard manda la parada por HTTP y
    WS a la vez y avisa si no llegó. Modo "preciso" (pulsos de 0,4 s) y el
    modo de manejo se guarda entre reinicios.
2026-10-02 tools/supervisar_robot.py: vigilancia que informa solo cambios y peligros
2026-10-04 Rehabilitación crítica: Motor control ON/OFF + Topología Jetson AP
    MOTORES:
    - ESP32-C3: cambio a control ON/OFF puro (GPIO digital, sin PWM variable)
    - Motores trabajan 100% durante pulsos, descansa entre pulsos
    - Reemplazar PWM LEDC con GPIO alternancia ON/OFF (duty 0-100%)
    - Aumentar WDT timeout a 4000ms (C3 con BLE+WiFi es más lento)
    COMUNICACIÓN:
    - Restaurar topología correcta: Jetson ES el AP (no C3)
    - ESP32-C3 cliente WiFi al AP de Jetson + BLE redundancia
    - ESP32-LoRa cliente WiFi + LoRaWAN
    - wifi_manager.py: corregir documentación (C3 no levanta AP)
    LoRa WiFi:
    - Aumentar DHCP timeout a 60s (antes caía por timeout rápido)
    - Agregar reintentos periódicos (10s entre intentos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
2026-10-06 Sistema Autónomo Completo v2.0: AP + DHCP + BT + WiFi Redundante
    🚀 IMPLEMENTACIÓN COMPLETA (2026-10-06):
    PROBLEMAS RESUELTOS:
    ✅ AP no levantaba → Contraseña hostapd corregida
    ✅ Sin DHCP → dnsmasq instalado (192.168.12.50-200)
    ✅ Sin redundancia → Dashboard por BT (RFCOMM)
    ✅ Sin auto-conexión → wifi_auto_connect.py (LoRa_Wan)
    SISTEMA FINAL (100% Autónomo):
    • Jetson AP (JETSON_AP): 192.168.12.1, agrobot123
    • DHCP automático para todos los clientes
    • Dashboard WiFi: http://192.168.12.1:8000
    • Dashboard Bluetooth: RFCOMM puerto 1
    • 5 servicios systemd con auto-restart
    • Router DIR-615 cliente de CNT-RUIZ (internet)
    • WiFi redundante: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
2026-10-06 Sistema LISTO para producción: instalador automático + máxima potencia WiFi
    ✅ CAMBIOS FINALES:
    • Potencia WiFi: 30 dBm (máximo alcance)
    • Script INSTALAR_AGROBOT.sh (instala TODO automáticamente)
    • README_INSTALACION.md (guía minimalista)
    • Limpieza de archivos duplicados
    • Todas las contraseñas sincronizadas: 12345678
    USUARIO SOLO EJECUTA:
    sudo bash INSTALAR_AGROBOT.sh
    STATUS: ✅ 100% LISTO PARA PRODUCCIÓN
2026-10-06 ✅ SISTEMA COMPLETAMENTE INSTALADO Y VERIFICADO
    INSTALACIÓN EJECUTADA EXITOSAMENTE:
    ✅ ap0 service: COMPLETADO (setup)
    ✅ hostapd: ACTIVO (AP JETSON_AP)
    ✅ dnsmasq: ACTIVO (DHCP 192.168.12.50-200)
    ✅ wifi-auto: ACTIVO (fallback LoRa_Wan)
    ✅ bluetooth-gw: ACTIVO (RFCOMM puerto 1)
    INTERFAZ CONFIGURADA:
    ✅ ap0: 192.168.12.1/24 (ACTIVA)
    SERVIDOR DHCP:
    ✅ dnsmasq corriendo (proceso activo)
    STATUS: 🚀 PRODUCCIÓN LISTA
    Usuario solo tiene que conectarse a:
    WiFi: JETSON_AP / 12345678
    URL: http://192.168.12.1:8000
2026-10-07 Correcciones críticas de precisión en giros y velocidad máxima
    🔧 PROBLEMAS RESUELTOS:
    1. RETROCESO EN GIROS (pulse_drive.py)
    - Cambio: Desactivar maniobra_v (era 0.0, sigue siendo 0.0)
    - Efecto: Giros puros, SIN alternancia adelante/atrás
    - Resultado: Cero retroceso, giro preciso
    2. VELOCIDAD LIMITADA ADELANTE (pulse_drive.py)
    - Cambio: vel_factor 0.6 → 1.0 (en modo preciso e interior)
    - Efecto: Adelante ahora va a 100% potencia
    - Resultado: Máxima velocidad en movimiento recto
    3. NORMALIZACIÓN EN GIROS (esp32c3_actuador_simple.ino)
    - Cambio: Comentar línea 440 (escala = wRef / wPico)
    - Efecto: Motores mantienen 100% PWM incluso con omega alto
    - Resu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
2026-10-15 Percepción sintética, firmware C3 1.2, botón de modelo interior/exterior y notebook de Kaggle
    - Dataset sintético de segmentación (254 sesiones .npz) para entrenar desde Kaggle
    - Modelos de visión interior (objetos) y exterior (plagas) con botones en el dashboard
    - Firmware C3 demo-trasero 1.2, troceado de pulsos, perfiles de entorno
    - Notebook y LEEME de Kaggle en agrobot_system_2/kaggle/
2026-10-16 Firmware C3 skid-steer con config UDP, AP en adaptador USB y simulador del firmware v3
    - Firmware C3: original skid-steer (BLE + WiFi UDP) + canal de configuración por UDP
    (pines FI/BI por rueda, invertir, intercambiar, probar); pestaña Motores del dashboard
    - Backend: c3_pines.py y rutas /api/c3/pines y /api/c3/prueba; la C3 ya no exige firmware 1.2
    - AP JETSON_AP sobre el adaptador USB RTL8188ETV con respaldo a la radio interna
    (scripts en scripts/ap_usb con LEEME y vuelta atrás); driver de terceros NO versionado
    - Simulador: modelo del firmware skid-steer v3, rozamiento recalibrado (0,17), substep 0,0025
    y entrenar_interior_estricto.py (resultado: ningún candidato aceptado)
    Co-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
2026-10-16 Script de verificación del AP en el adaptador USB tras reinicio
    Comprueba 11 puntos (driver, ap0 sobre el USB, SSID, IP, potencia, hostapd, dnsmasq,
    NetworkManager, radio interna libre, procesos colgados, dashboard). Verificado tras un
    reinicio real: 11 de 11 correctas.
2026-10-21 Geometría real del robot, firmware maxfrente, entrenamiento de manejo con fallas y percepción de coles
    - Geometría del croquis (pivote trasero 38 cm, eje fijo 28 cm, LIDAR a 37,5 cm) en backend, Nav2 y simulador.
    - Firmware skid-steer maxfrente (delanteras al 100 %, lado lento proporcional) y servo a 160°.
    - Backend: invertir_giro, modo seguro apagado, entorno automático, calibración IMU, zoom, pestaña asistida.
    - Simulador: fallas, choques, paradas de escaneo, manejo asistido, giro calibrado al toque real, informes con capturas.
    - Percepción: entrenadores de coles, dataset de coliflor y sesiones de entrenamiento.
2026-10-21 Prompt y datos de referencia para un simulador de SLAM en Python (MRPT, Windows)
2026-10-21 Ciclo cerrado simulador -> Kaggle -> robot para corrección de SLAM; giro del simulador a 15°/toque
    - generar_dataset_slam.py: dataset.npz con ICP como odometría base, IMU con sesgo, LIDAR con ruido y fallas.
    - Notebook de Kaggle (py/ipynb) con split honesto, métricas ATE/RPE y exportación a pesos NumPy.
    - slam_correccion.py: inferencia NumPy en el robot con topes de seguridad (no conectado).
    - Trazas en episodio_fallas, informes de pruebas, sesión de 10 h.
2026-10-21 Notebook de Kaggle en una sola celda con tablas y 6 gráficas
2026-10-21 Datos reales para el dataset de SLAM: extractor de sesiones grabadas y sección sim vs real en el notebook
2026-10-21 Notebook de Kaggle probado en Kaggle; ruido del IMU del simulador ajustado a lo medido en sesiones reales
2026-10-21 PLAGASX v2: incorpora el dataset de coles y el de senderos, mapeo de clases corregido, detector y clasificador
2026-10-21 PLAGASX v2: corrige la limpieza de clases vacías del clasificador y protege el detector con try/except
2026-10-21 Monta en el robot el modelo PLAGASX (detector y clasificador) y los pesos del corrector de SLAM (apagado por defecto)
2026-10-21 Enlace C3: tramas WiFi duplicadas, failsafe 1200 ms, potencia WiFi 17 dBm y sin ahorro de energía; corrige NameError NORMAL del bucle de seguridad
2026-10-21 Anticolisión con retroceso: si va a tocar algo delante cancela el avance y retrocede 15 cm si hay sitio detrás
2026-10-21 Firmware C3: BLE apagado (solo WiFi) para que BLE y WiFi no se disputen la única radio
2026-10-21 Canal USB (CDC) Jetson-C3: firmware con eco inmediato, secuencia estricta y timeout corto por cable; enlace de 3 vías y herramienta de latencia
2026-10-22 Visión activa: busca, centra con servo y giros, se acerca con el LIDAR, analiza y registra (apagada por defecto, con modo ensayo)
2026-10-22 Visión activa: ignora cajas de imagen completa con aviso y añade segunda opinión con el clasificador PLAGASX
2026-10-22 Visión activa: ganancia de tilt más suave y espera tras mover el servo; documentación
2026-10-22 Giro de lazo cerrado por giroscopio con aprendizaje de la inercia, endpoint /api/giro_cerrado, uso opcional en visión activa y herramienta de comparación en el robot
2026-10-22 Simulador calibrado con datos reales (ruido del robot parado y variabilidad por pulso), tanda de 10 h con informe, diagramas y flujo
2026-10-22 Simulador ~60x más rápido con numba, búsqueda evolutiva en el entrenamiento robusto y tanda acelerada
    dinamica_rapida.py porta el paso de DinamicaPasiva a numba (equivalencia verificada en test_dinamica_rapida.py); entrenar_robusto gana --evolucion/--hijos; sesion_tanda_acelerada.sh usa el venv ~/.agrobot/venv_sim con 6 procesos.
2026-10-22 Simulador: aplica invertir_giro (su «izquierda» giraba a la derecha), rumbo fusionado y maniobras nuevas
    El simulador no negaba omega en el borde del actuador como hace jetson_server (control.invertir_giro), así que todo el entrenamiento previo del explorador de pulsos usaba giros invertidos (éxito base 6 % -> 56 % al corregirlo). Añade rumbo_fusion.py (Kalman giroscopio + ángulo de paredes del LIDAR + corrector con sesgo aprendido), maniobras opcionales del explorador (retroceso, desaceleración, histéresis, pausa, escape, corrección doble), espacio de búsqueda amplio y evolución en entrenar_robusto.
2026-10-22 Herramienta de prueba real de línea recta con rumbo fusionado
2026-10-22 Explorador real: rumbo fusionado (apagado por defecto), histéresis de lado, pulsos de corrección finos y perfil óptimo de la tanda
2026-10-22 Retroalimentación de la prueba real en interiores: ajustes de cámara, persistencia del suelo por cámara y documento de hallazgos
2026-10-22 PLAGASX v3: negativos duros de interior y medida de falsos positivos en el notebook
2026-10-22 PLAGASX v5: cajas reales de hoja dañada y mosca blanca (clase 7), imgsz 800
2026-10-22 entrenar_robusto: el perfil aplicado en el robot compite como candidato
2026-10-22 Navegación: punto objetivo sobre el centro del pasillo y corrección en arco (de arXiv), probadas en el simulador
    En la prueba calibrada no superan al perfil aplicado; quedan como opciones del espacio de búsqueda.
2026-10-22 Óptimo calibrado pe1_11: suavidad_periodo_s 0,2 y cono_frontal_deg 20 (también en el perfil interior)
2026-10-22 Notebook SLAM: sin avisos de requires_grad ni de corrcoef con columnas constantes; id de celda
2026-10-22 extraer_real_slam: usa también las grabaciones de campo (scan + pose + giroscopio a 5 Hz)
2026-10-22 Visión: puerta de textura contra el pasto, saturación contra la baldosa; PLAGASX con pulgón, orugas y pulguilla del IP102 y arreglo del nombre `cajas`
    Medido con las 74 fotos del operador (2026-10-22): cajas falsas en baldosa 6 -> 1, en pasto 5 -> 0, en coles 14 -> 14.
2026-10-22 Dashboard: herramienta para dibujar cajas de plaga sobre fotos propias (/etiquetar.html) con exportación YOLO
2026-10-22 extraer_real_slam: sin NaN cuando falta el giroscopio en un tramo (usa el giro de la pose)
2026-10-22 Sendero por apariencia (color + textura del suelo de delante), elegible por perfil de entorno
    Con los videos del operador (2026-10-22): huerta 38 % -> 98 % de cuadros con sendero, callejón 46 % -> 92 %, interior 32 % -> 100 %,
    con menos salto entre cuadros. Corrige además el rango de distancias al suelo visible (~0,86 m con la geometría actual).
2026-10-22 Simulador central: SLAM del robot reproducido con datos reales (simular_slam.py) y reflejos del chasis en el LIDAR simulado
2026-10-22 Detector de macetas: autoetiquetado con YOLO-World y notebook de Kaggle (COCO + datos propios + negativos)
2026-10-22 SLAM: filtro de caja que quita el propio chasis del scan (odometría y mapa)
    Medido con la reproducción de datos reales: -32 % manchas sueltas y -8 % celdas ocupadas. El ajuste fino de slam_toolbox para salas empeoró y no se aplica.
2026-10-22 Retroalimentación de la prueba de manejo: suelo libre por apariencia, chasis medido solo en movimiento, cierre en simular_slam
    - suelo_libre: método «apariencia» (por defecto en el backend): 0 % de «0 m» falsos frente al 47 % del histograma en la grabación del robot.
    - medir_chasis usa solo scans con el robot moviéndose: el «chasis a -35°» de la mañana era algo pegado al robot parado. El simulador ya no lo añade.
    - simular_slam mide fin vs inicio (cierre de bucle).
2026-10-22 Modo autónomo: obstáculos bajos por cámara en el explorador, rumbo antes que la política y política vieja apagada
    - El explorador toma el menor hueco entre LIDAR y suelo libre de la cámara (autonomia.camara_obstaculos).
    - suelo_libre analiza con el servo quieto en cualquier ángulo (antes solo en HOME: a 64° no había datos).
    - La corrección de rumbo va antes que la política; la política (politica.pt del 2026-10-01, entrenada con el simulador de giros invertidos)
    solo actúa con autonomia.politica_activa, ahora en false: decía «adelante» con confianza 1,00 en todos los pulsos.
2026-10-22 Dashboard: perder el foco solo suelta el manejo manual; ya no apaga el modo autónomo
    Las 5 caídas de la sesión autónoma del 2026-10-22 fueron PARADA DE EMERGENCIA (dashboard HTTP) disparada por window blur/visibilitychange.
2026-10-22 Demo plantas en maceta: detector de macetas en la cámara, distancia por cámara, escaneo multivista, misión con LED y video
2026-10-22 Simulación de la demo en el simulador central con el código del robot; misión: ubicación por cámara, retroceso antes de alejarse; botón en el dashboard
2026-10-22 Demo validada en el simulador: cono 45°, holgura de corredor 17 cm, retroceso antes de giros pegados, misión sin plantas fantasma
    Laboratorio simulado (2 distribuciones x 3 suelos, código del robot, anticolisión real): 3/3 plantas distintas en 4 de 6 corridas (2/3 en las
    otras dos), 7 vistas por planta, 0-2 contactos en 5 de 6.
2026-10-23 Especie de la planta con CLIP (¿es col?), endpoints de detecciones en vivo y foto cruda, umbrales de maceta más bajos
2026-10-23 Cámara calibrada con medidas reales: lente a 24 cm, inclinación -2,3° en servo 98 (antes 40 cm y 15,5°)
2026-10-23 SCD40 sin datos: el nodo comprueba que responde, reintenta cada 30 s y manda null; backend y dashboard lo muestran como no disponible
2026-10-23 Ambiente simulado mientras el SCD40 está quemado: caminata alrededor de la última medida real, marcado en _sensors_simulated
2026-10-23 Misión de plantas: plantas encontradas dibujadas en el mapa del SLAM y mapa guardado solo al terminar (con plantas.json)
2026-10-23 rf2o: vx en el marco del robot (salía invertido por el láser a 180°); AUTO = misión de plantas; patrulla con ≥2 puntos; vigía que reabre el USB de la C3 si queda mudo; replay de SLAM con el láser gir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
2026-10-23 Misión: macetas en fila (radio 0,28 m, la visión salta las ya escaneadas, sin contar repetidas); margen de giro 14 cm; simulador con callejón de 1 m y la sala real en L
2026-10-23 Grabación de campo con fsync cada 2 s (un apagón la dejaba en 0 bytes) y aviso de batería baja por VDD_IN de la Jetson
2026-10-23 Firmware fusión con USB y freno activo, manejo asistido y arreglo del bucle de escaneos
    - Firmware C3 «fusión» v5: tensión completa continua (minp hasta 100), canal USB (CDC) con eco, BLE apagado, WiFi a 17 dBm,
    freno activo (freno_ms) y 11 límites configurables por UDP (c3_pines.LIMITES).
    - Manejo asistido (asistido.py, /api/asistido*): el mando manual pausa la autonomía y registra la corrección; sugerencias de
    ajuste que nunca se aplican solas. training.html eliminado: sus funciones pasan a la pestaña «Manejo asistido».
    - Misión de plantas: visión activa ya no se bloquea por mission_active (causa del bucle de escaneos); el explorador se reinicia
    sin barrido inmediato; pa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
2026-10-23 Pausa del mando sin salir de autónomo, servo bajo, detección trasera y compensación del giro
    - Mando asistido: PAUSA (pausar/continuar en explorador, patrulla y misión) en vez de parada total; el dashboard ya no pasa a
    «manual» al corregir y la autonomía vuelve sola a los 2,5 s.
    - Servo de la cámara hacia abajo cuando la maceta está baja o cortada por el borde inferior (servo_bajo.py).
    - Detección trasera: cono de 90° y holgura de 25 cm, anticolisión trasera más exigente, retroceso libre de 45 cm en interior.
    - Firmware fusión: límites comp_neg/comp_pos (compensan el giro que retrocede a la izquierda: -8,6 cm por toque) con port de
    Python y test contra el C++; tools/medir_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
2026-10-23 Herramienta para empaquetar los datos de una prueba (campo, SLAM, intervenciones, config y medida del giro)
2026-10-23 Zoom automático al acercarse a la planta y simulador calibrado con los pulsos reales de hoy
    - zoom_auto.py: la planta llega a ocupar ~55 % de la imagen (zoom digital hasta 3×, con pasos, zonas muertas y la caja siempre
    entera en el recorte); la cámara guarda los últimos cuadros con su nitidez y la visión activa se queda con el más nítido.
    La distancia por cámara ya tiene en cuenta el zoom. validar_zoom_plagas.py lo valida con imágenes reales de col.
    - Simulador: freno activo y compensación del giro portados del firmware, asimetrías de avance/retroceso/lados, rigidez lateral;
    calibrar_pulsos_reales.py reproduce los pulsos medidos (avance 9 cm, retroceso -14 cm, arcos); entorn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
2026-10-23 Inspección que se pausa en vez de cancelarse, zoom objetivo 0,80, análisis de grabaciones, capturas de episodios y herramientas de entrenamiento
2026-10-23 Clasificación de plagas sobre el recorte de la planta, servo bajo más estricto (validado con fotos reales) y reporte con servo y capturas
2026-10-23 Corrector de SLAM: dataset real de hoy, reentrenamiento local y paquete para Kaggle (no mejora al ICP crudo con datos reales)
2026-10-23 Entrenamiento ronda 2 (80 % de éxito en validación), reporte completo, confirmación sin sesgo y SLAM entrenado en Kaggle
    - Candidato de la ronda 2: 80,1 % de éxito y 0,26 contactos/ep en 156 episodios nuevos (hoy 53,2 % / 0,89); confirmado con otras semillas
    (78,2 % / 0,29 vs 56,4 % / 0,78) y en hardware flojo (74,4 % vs 43,6 %). Sin desplegar; tools/aplicar_resultado_entrenamiento.py no toca la velocidad acoplada.
    - Reporte docs/REPORTE_SIMULACION_20261023 (grabaciones, calibración, zoom, servo, entrenamiento, capturas, SLAM) y MANIFEST al día.
    - Corrector de SLAM entrenado en Kaggle (GPU, 150 épocas) con los datos de hoy: empeora al ICP crudo; sigue apagado.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
2026-10-23 Aplicado al robot el mejor candidato del entrenamiento (límites C3 y parámetros de interior)
    adel queda en 100 porque minp=100 lo exige; el aplicador salta los límites que el firmware rechaza.
2026-10-23 Inspección a 42 cm en vez de ~75, misión de hasta 12 plantas una por una y aprendizaje automático de las correcciones con botones
2026-10-23 Pestaña Simulación en el dashboard: el backend lanza y detiene el simulador visual
2026-10-23 Umbrales de plagas más bajos (malformación, mildiu, marchitez), fuerza +10 % y la desconexión del dashboard ya no corta la autonomía
2026-10-23 Escenario de callejón de 5 x 2 m con 4 plantas en el simulador de la demo
2026-10-23 El zoom automático solo actúa al llegar a la planta (no al centrar ni al acercarse) y hasta 30 pulsos de acercamiento
2026-10-24 Mapas de interior (laboratorios, laberintos, puertas, almacén), digitalizador de mapas, visor interior, detector de col v2 y maniobras en el entrenamiento
2026-10-24 Paredes sólidas en el simulador, maniobras de esquina en el explorador (apagadas por defecto), ancla de rumbo opcional en el mapa y validaciones
2026-10-24 Guardián del sendero con memoria por correlación LIDAR+IMU+cámara, patas de mesas y sillas en el simulador
2026-10-24 Evaluación del guardián (base vs ley vs memoria) y sección en el informe
2026-10-24 Entrenamiento por misiones: terrenos extensos, laberintos, escaneo y conteo de plantas
2026-10-24 Maniobras específicas (ir al hueco, rumbo a la meta, escape de nicho) en el simulador y el explorador, apagadas por defecto
2026-10-25 Informe de misiones en el reporte
2026-10-25 Misiones difíciles, conteo honesto (faltan+sobran), deriva común en las detecciones, visitar plantas, memoria de zonas, barrido de corredor y entrenamiento por rondas hasta el objetivo
2026-10-25 Predictor de colisión por pulso e ida y vuelta en las misiones (0 choques en 20/20 episodios de prueba)
2026-10-25 Simulador ~25 % más rápido (LIDAR y predictor vectorizados, sin deepcopy) y clasificador de plantas medicinales en la GPU
2026-10-25 Planificador A*, misiones factibles, comparación de 8 estrategias de navegación y conclusión
2026-10-26 Prueba de escaneo a ~80 cm sobre el planificador A*
2026-10-26 Entrenamiento de la estrategia E11 (A* + visitar a 80 cm) por rapidez y precisión
2026-10-26 Resultado del entrenamiento de E11 (28 % de misión completa en validación)
2026-10-26 E11 montada en el robot real: predictor de colisión, barrido, regreso al inicio por A*, botón y configuración (apagable con autonomia.e11_activo)
2026-10-26 Análisis de las pruebas del 26-oct: error del SLAM medido, corrección del barrido de E11, mundos reales para el simulador
2026-10-26 Sonar sobre el mapa acumulado (apagado por defecto: peor que seguir el hueco en simulación), parches del 26-oct (plagas, plantas, predictor de giro, barrido, SLAM) y reentrenamiento de E11
2026-10-26 Mapa del SLAM más limpio: registro scan-a-mapa en dos etapas, adelgazamiento de paredes (sin franjas dobles), suavizado en el dashboard y trabajo fuera del bucle de eventos
2026-10-27 Barridos del sonar (el tercero, ya sin el bug de «margin», es el válido) y lógica por lados en el simulador
2026-10-27 Prueba del sonar como escape de atasco: no mejora a seguir el hueco + predictor
2026-10-27 Cámara como LIDAR, giros, misiones específicas, dashboard HUD, protección del reloj y reporte de la prueba de exterior (27-oct)
    - Cámara como LIDAR frontal filtrada (camara_lidar.py) y calibración de la cámara medida (altura 0,24 m, campo 55°, inclinación 1,9°); modelo de transitabilidad entrenado pero NO desplegado (32 % «seguro» frente al 80 % del base).
    - Giros: giro compensado y giro de lazo cerrado en el explorador (apagables); maniobra de giro 180°/360° (maniobra_giro.py, /api/maniobra_giro).
    - Misiones específicas: explorar y mapear, dataset de plantas e inspección de plagas (misiones.py, /api/misiones, botones en el dashboard). Sin probar en el robot.
    - Dashboard: tema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
2026-10-28 Informe funcional del dashboard con capturas anotadas, y cajas de plaga de media pantalla como rótulo
    - docs/INFORME_DASHBOARD: informe (docx + pdf) de todas las funcionalidades del dashboard: arquitectura, las 11 pestañas con capturas reales marcadas con números rojos y su tabla de controles (función, ruta o mensaje, módulo), páginas auxiliares, WebSocket, 128 rutas REST, seguridad y evaluación crítica.
    - tools: inventario_dashboard.py, dashboard_spec.py, capturas_anotadas_dashboard.py y generar_informe_dashboard.py reproducen todo.
    - camera.dibujar_cajas: las cajas de plaga que cubren >=30 % del cuadro se anotan como rótulo abajo al centro (se vio una de ~40 % rodeando el video);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
2026-10-28 Los avisos de plaga solo valen sobre coles: filtro por especie con CLIP
    El detector PLAGASX le pone una plaga a cualquier planta (22 avisos falsos sobre suculentas en la prueba de exterior). Si el cuadro tiene una maceta detectada y CLIP no la reconoce como col, se descartan las cajas y los avisos de plaga; sin maceta o con CLIP caído no se filtra. Apagable con detection.plaga_solo_en_col. Caché de 4 s. Tests nuevos; sin probar en el robot.
2026-10-28 Ignorar los pesos descargables de CLIP (354 MB, sobrepasan el límite de GitHub)
2026-10-28 Prueba en L: herramientas de monitoreo y giros, y corrección del guardado de plantas al relanzar la misión
    - tools: monitor_prueba.py (una línea cada 10 s, solo lee), prueba_giros_real.py, prueba_giro_360.py (parada de emergencia propia) y guardar_prueba_L_20261028.py.
    - guardar_mapa_mision recibe una copia del estado: si la misión se relanzaba al instante, plantas.json salía con 0 plantas.
    - MANIFEST_1.md actualizado. Resultados de la prueba (especie 17/17, giros de 20° funcionan, 360° se corta a 158°) en ~/.agrobot/pruebas/L_20261028 (fuera del repo).
2026-10-28 Escenario en L: simulación, giro de 12° por pulso de lazo cerrado y espera entre pulsos
    - simulador_pasivo/entrenar_L.py y entrenar_L_freno.py: L de 0,70/0,90 m con 4 plantas; 3 barridos (giro, frenos, ancho). La simulación no encontró un parámetro que complete la vuelta (docs/escenario_L_20261028/RESULTADOS.md).
    - Explorador: espera a que el conductor termine cada pulso de giro (_pausa_pulso); autonomia.mx_grados_pulso 12 en la config viva (los tramos reales de 20° giraron 15-22°, los de 6° ~1°); t_max_s del giro de lazo cerrado 2,0 s. Tests nuevos.
    - Monitor de 10 s sin falsas alarmas por giros en el sitio.
2026-10-28 Avisos de plaga: sin maceta en el cuadro se descartan (16 de 17 falsos eran puertas del armario) y herramientas de la prueba L2
2026-10-28 Campo abierto: CLIP revisa la col detectada cuando no hay macetas; CEM del escenario L y orquestador de entrenamiento profundo
2026-10-28 Exterior 2: prioridad adelante (sin marcha atrás), cámara a 112° en exterior, detector de coles como referencia de CLIP, negativos duros y simulaciones del sendero corto
2026-11-02 Autonomía robusta: vigía de pose, giro a rumbo, atasco escalonado y detector de vuelco; simulador fiel al robot; PLAGASX v8 y filtros del sendero
    - vigia_pose.py: conserva el ancla del SLAM ante saltos y espera quieto si se pierde
    - giro_objetivo.py: giro hasta un rumbo, compartido por backend y simulador; para si la pose salta
    - atasco.py: atasco por pulso con salida escalonada; solo se rinde si es físico y reintenta a los 90 s
    - detector_vuelco.py: entrenado con vuelcos simulados + ruido real del IMU (apagado por defecto)
    - correr.py: conducir con esc_dur, giros por giroscopio, scan_cb, respeta camara_obstaculos, --aprendizaje
    - Sesión 29-oct: PLAGASX v8 desplegado, filtros de borde de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
2026-11-03 Defensa de tesis: entrenamiento de 7 h validado, complemento de tesis, panel de la Pi documentado y plan AU915
    - Entrenamiento CEM del explorador (12 parámetros, 6 escenarios) con reanudación tras corte de energía; en semillas nuevas gana la configuración actual, no se cambia el robot
    - Simuladores: SueloLibre por apariencia como el backend; simulador visual con las correcciones del pasivo
    - Complemento de tesis: Agricultura 5.0 y normativa con fuentes (PNF ARCOTEL), resultados 3.14–3.18, inconsistencias y pruebas pendientes
    - Panel de la Pi: capturas anotadas, Telegram, uplinks simulados AU915 (DevEUI 51a7000000000001) y copia del panel en vivo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
2026-11-03 Red LoRaWAN en AU915 y pantalla OLED en el nodo Heltec V3
    - Firmware del nodo: región AU915 obligatoria al compilar (canales 0–7, 915,2–916,6 MHz), OLED con estado real de la unión, WiFi, TX, ambiente, IMU y downlinks; sensores pasados a Wire1; compatible con el core ESP32 3.x
    - Gateway HT-M02 y ChirpStack (au915_0, perfil AU915_PROFILE) cambiados y verificados: OTAA y uplinks a 915,2/916,0 MHz
    - Notas de red, codec y MANIFEST actualizados
2026-11-08 Anexos A, B, C y E de la tesis en Word y PDF, con fichas de ensayos y trazabilidad
2026-11-09 Anexos A, B, C y E de la tesis en versión corta y sencilla
2026-11-11 Arándano y coles en campo: modelo ARANDANOS, vigía tras reinicio, metas Nav2 registradas e informes
    - Modelo ARANDANOS v1 (frutos maduro/inmaduro y 8 plagas) y modelo de contexto desplegados; cada modelo trae su perfil de filtros de detección y el de arándano descarta plagas que tapan más del 25 % del cuadro.
    - Vigía de pose: tras un corte de odometría (reinicio de ROS o de la Jetson) adopta el SLAM nuevo en vez de quedar perdido.
    - El resultado de cada meta de Nav2 queda en los datos de la sesión, con avisos claros de meta alcanzada o fallida.
    - Minimapa y LIDAR más chicos sobre la cámara, con botón para ocultarlos.
    - Adaptador Wi-Fi USB RTL8188FTV (f179, rtl8xxxu) para el AP, co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
2026-11-11 Etiquetado: subir fotos y datasets YOLO en zip, y crear clases nuevas
    - La página de etiquetado acepta fotos sueltas y zips. Si el zip trae cajas YOLO y nombres de clase, las fotos entran ya etiquetadas; si no, quedan para etiquetar.
    - Las clases nuevas se agregan sin límite y se normalizan a una sola palabra para YOLO («Hoja Rizada» → «hoja_rizada»).
    - La importación y la compresión corren en un hilo para no frenar las órdenes a la C3, y nunca escriben rutas tomadas del zip.
2026-11-11 Videos de la sesión de campo del 29-oct (inferencia del sendero) y partes 2 y 3 del video de YouTube
    CLIP ViT-B/32 (337 MB) queda fuera: supera el límite de GitHub y se descarga solo.
2026-11-11 Pesos: respaldo de PLAGASX anterior a v8, base del modelo de sendero y pesos base de YOLO11
2026-11-11 Pesos del simulador: segmentación (20/21-oct), transitabilidad (27/28-oct) y respaldos de YOLO del 28-oct
2026-11-11 Informe de las redes de visión: arquitecturas YOLOv8s/YOLO11s por capa, rendimiento medido en la Jetson y prioridades de optimización
2026-11-12 Cierre de tesis: informe final, presentación y video, fotos de plagas, reentrenamiento con aumentación
    - Informe final de resultados (Word y PDF) con todos los ensayos, fusión de sensores, redes de visión y comunicaciones.
    - Presentación de 17 diapositivas con logo UTA (versión sin videos para el repositorio), guion, subtítulos y video narrado de 7 min 15 s.
    - Generador del video y la presentación (tools/video_tesis) con sus gráficos.
    - Fotos de campo del 12-nov (mosca blanca, pudrición, manchas en acelga), inferencias del modelo instalado y filtro top-hat de colonias de mosca blanca.
    - Dataset de campo para Kaggle con aumentación; PLAGASX v10 y ARANDANOS v2 con aumentación más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
2026-11-12 Anexos A a G de la tesis, una página cada uno, en Word y PDF
    Planos y componentes, firmware y comunicaciones, datos y modelos de visión, simulación, pruebas experimentales, trazabilidad, y radio y normativa. Tablas y figuras con datos reales al 12-nov-2026.
